arbaleast/dayu-tt-all-in-one/source/B站【大鱼DIY】3D打印机Dayu TT V1.21全套资料/通用辅助功能配件_非必须/12_Klicky调平/Klicky装配图.jpg

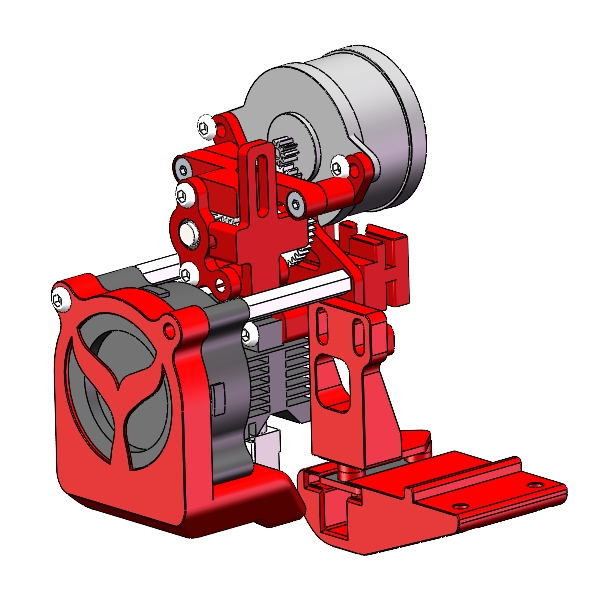
source/B站【大鱼DIY】3D打印机Dayu TT V1.21全套资料/通用辅助功能配件_非必须/12_Klicky调平/Klicky装配图.jpg
