arbaleast/dayu-tt-all-in-one/source/B站【大鱼DIY】3D打印机Dayu TT V1.21全套资料/TT310资料/TT310封箱资料/TT310封箱说明.jpg

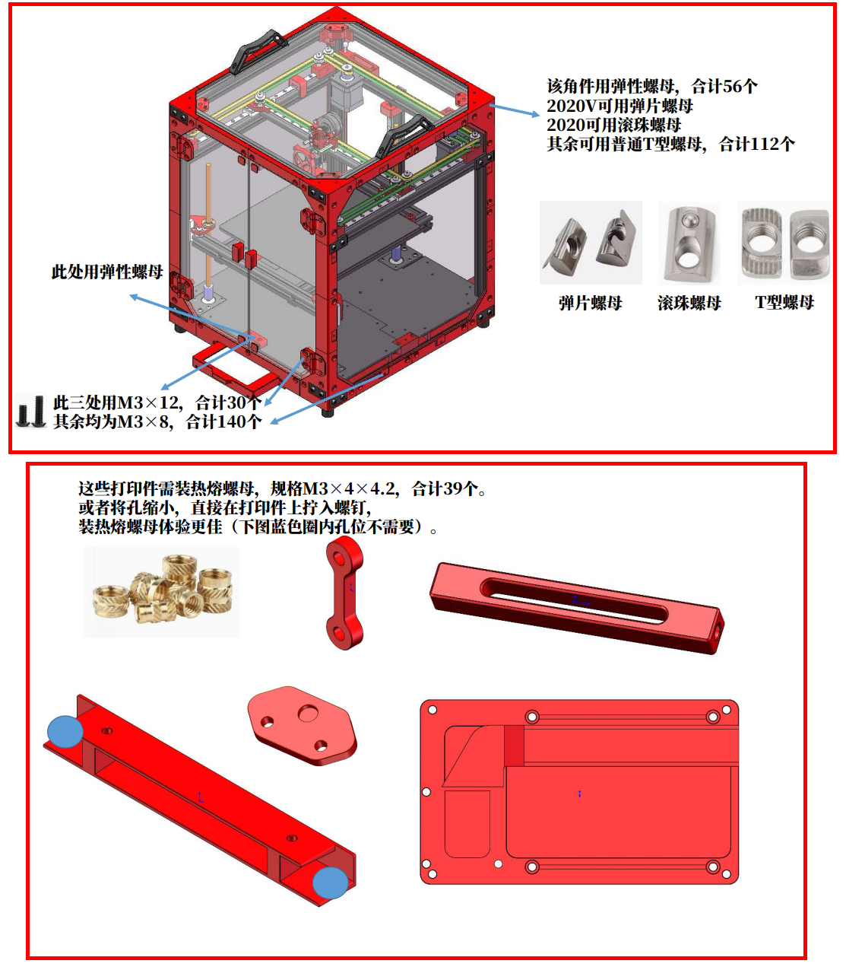
source/B站【大鱼DIY】3D打印机Dayu TT V1.21全套资料/TT310资料/TT310封箱资料/TT310封箱说明.jpg
