arbaleast/dayu-tt-all-in-one/SPEC.md

# 大鱼TT（dayu-TT）重构升级项目 — 项目总纲

> **文档版本**：v1.0
> **制定日期**：2026-04-03
> **项目路径**：/vol1/1000/projects/hardware/3d-printing/dayu-tt-all-in-one/
> **本文定位**：项目"宪法"，所有其他文档必须与本文对齐

---

## 目录结构

本项目采用知识领域分类结构：

```
docs/
├── MECHANICAL/      ← 机械工程（框架、CoreXY、封箱、硬件改进）
├── THERMAL/         ← 热管理系统（腔体温控、加热系统）
├── FIRMWARE/        ← 固件配置（Klipper、printer.cfg）
├── AI/              ← AI智能化（Input Shaper、ADXL345）
└── VALIDATION/       ← 测试验证（量化指标、验收标准）
```

### 协作文档

- [SUPERPOWERS.md](./SUPERPOWERS.md) — 项目宪章
- [AGENTS.md](./AGENTS.md) — Agent角色矩阵
- [CLAUDE.md](./CLAUDE.md) — AI协作协议

---

## 1. 项目愿景

> **一句话**：将大鱼TT打造成一台**对标 Voron 2.4 工业级标准**的大幅面ABS 3D打印机，具备高速打印能力、闭环热管理、智能故障检测的核心竞争力的个人制造设备。

---

## 2. 目标量化指标

### 2.1 量化指标总表（对标 Voron 2.4 r2）

| 指标维度 | 当前基线 | 目标值 | 验证方法 | 数据来源 |
|---|---|---|---|---|
| **打印成功率（ABS大幅面300mm+）** | <60%（估算） | >90% | 连续10次300mm ABS打印统计 | 审计报告§7.1；Voron spec§4.1 |
| **最高稳定速度（ABS）** | 约60-80mm/s（无Input Shaper） | >200mm/s | 验证件速度梯度测试（80→200mm/s） | Voron spec§4.2；审计报告§7.1 |
| **腔温稳定性** | ±10°C（被动保温） | **±3°C** | 30分钟温漂连续记录（Klipper温度曲线） | 审计报告§7.1（"腔温稳定性±10°C"）；Voron spec§3.1（Voron原生50-55°C） |
| **热床温控精度** | PID未校准 | ±1°C | Klipper PID调优后稳态波动 | Voron spec§1.4（Kp=58.437等参数） |
| **首层粘附** | 频繁翘角 | 零翘角 | 视觉检查+打印验证件 | Voron spec§3.2（PEI+ABS泥方案） |
| **层高一致性** | 未测量 | <0.05mm偏差 | 千分表测量10层样件 | Voron spec§3.3 |
| **X/Y定位精度** | 未校准 | <0.05mm | 打印精度验证件（20mm立方体）测量 | Voron spec§3.3 |
| **Z轴定位精度** | 无QGL | <0.02mm（重复性） | 千分表+重复Z轴回零测试 | Voron spec§2.2（QGL系统支撑） |
| **Input Shaper校准状态** | 未校准 | shaper_freq 30-50Hz | `calibrate_shaper.py`输出 | Voron spec§2.3；审计报告§2（ADXL345文档存在） |
| **皮带系统** | GT2 6mm（确认） | 升级9mm GT2 | 视觉确认+BOM记录 | 审计报告§6.4；Voron spec§1.2（Voron Trident标配9mm） |
| **热床功率** | 不足（推测） | 500-1000W AC+SSR | 升温曲线测试（室温→110°C<20min） | Voron spec§1.4；审计报告§5.1 |
| **加速度上限** | 未设置 | 3000mm/s²（X/Y） | Klipper `SET_KINEMATIC_ACCELERATION`验证 | Voron spec§2.1 |
| **Pressure Advance** | 未调校 | <1.0（典型0.05） | `TUNING_TOWER`测试件 | Voron spec§2.4 |
| **续驶保护** | 未配置 | idle_timeout=1800s | 模拟断料测试 | Voron spec§3.4 |

### 2.2 关键差距速记

- **🔴 热管理**：当前±10°C → 目标±3°C（差距最大）
- **🔴 固件配置**：缺少可直接使用的`printer.cfg`（审计报告§5.1 P0缺失）
- **🔴 STL文件**：各改装件STL无实际下载路径（审计报告§5.1 P0缺失）
- **🔴 接线图**：大鱼TT实际接线图/引脚定义缺失（审计报告§5.1 P0缺失）
- **🟡 皮带**：6mm → 9mm（升级路径明确）
- **🟡 框架**：铝型材规格待确认（审计报告§7.1）
- **🟡 Z轴**：无Quad Gantry Leveling系统

---

## 3. 当前主要矛盾（Top5，按优先级排序）

> 提取自：审计报告§8.2 + Voron spec§6（大鱼TT Top5关键项）

### 🔴 TOP 1：封闭腔体热管理系统缺失

**现状**：
- 仅有被动保温，腔温波动±10°C（审计报告§7.1）
- 热床功率不足（推测），升温慢、均温差
- 无主动腔温控制宏（`封闭腔体热管理规范化指南.md`为最新文档但未落地）

**影响**：
- ABS大幅面打印成功率<60%（估算）
- 层粘附不稳定，首层翘角频发

**解决路径**：P0阶段封闭方案落地 → 主动温控宏 → PID校准

---

### 🔴 TOP 2：固件基础设施缺失（P0级文档空白）

**现状**（审计报告§5.1）：
- ❌ 无可直接使用的`printer.cfg`完整配置
- ❌ 无大鱼TT实际接线图/引脚定义
- ❌ 引脚配置矛盾：`2-软件固件配置.md`（P2.2）vs `Klipper固件配置完全指南.md`（PF0）

**影响**：
- 新用户无法完成电气接线
- 固件配置无参照，Input Shaper无法启用

**解决路径**：P0阶段完成完整cfg + 接线图文档化

---

### 🔴 TOP 3：改装件STL文件无实际下载路径

**现状**（审计报告§5.1）：
- 皮带张紧器、打印头支架、Klicky探针等STL文件均为"待补充"
- 多个文档标注了STL存在但实际文件路径空白

**影响**：
- 改装无法落地
- 文档变为"空壳指导"

**解决路径**：P0阶段建立STL文件索引（自备或购买清单）

---

### 🟡 TOP 4：Input Shaper + ADXL345校准未完成

**现状**：
- `ADXL345-InputShaper实际校准执行指南.md` 文档存在但缺少树莓派接线图（3.3V警告不可见，硬件损坏风险）
- Input Shaper未运行，高速打印时共振无法抑制

**影响**：
- 加速度上限被迫降低至1000mm/s²以下
- 高速打印出现振铃（Ringing）和层移

**解决路径**：P0阶段完成ADXL345接线图 → P1阶段校准

---

### 🟡 TOP 5：CoreXY双电机同步 + 闭环改装未验证

**现状**：
- 大鱼TT使用开环步进电机（审计报告多处提及闭环改装方案）
- CoreXY架构理论上存在双电机同步问题（皮带伸长率差异）

**影响**：
- 高速打印时X/Y对角线跑偏
- 皮带6mm宽度低于Voron 2.4标准（9mm）

**解决路径**：P2阶段皮带升级9mm → 同步带张紧校准

---

## 4. 演进路线（5阶段）

### 📦 P0：稳定基线（0-2周）

> **目标**：让大鱼TT成为一台"能稳定跑ABS"的机器，消除致命障碍

**核心改进项**：

| 改什么 | 具体动作 | 参考文档 |
|---|---|---|
| **封闭腔体热管理** | 安装保温棉（10-20mm，松散填充）+ 边缘密封 + Klipper腔温宏 | `封闭腔体热管理规范化指南.md`（2026-04-03最新） |
| **热床功率升级** | 升级至500W+ AC热床+SSR控制（若当前不足） | `封箱散热BOSSAC热床改装指南.md`；Voron spec§1.4 |
| **ADXL345接线图** | 绘制树莓派SPI接线图（含3.3V警告），防止硬件损坏 | `ADXL345-InputShaper实际校准执行指南.md` |
| **STL文件清单** | 整理所有改装件STL实际获取路径（或标注购买渠道） | 审计报告§5.1 P0 |
| **完整Klipper cfg** | 以`Klipper固件配置完全指南.md`为准，建立可直接使用的printer.cfg | `Klipper固件配置完全指南.md`（审计报告标注以此为准） |
| **接线图文档化** | 绘制大鱼TT完整接线图（含引脚冲突说明） | 审计报告§5.1 P0 |

**成功标准（可量化）**：
- [ ] ABS 200mm×200mm打印连续3次零失败
- [ ] 腔温从室温升至50°C稳定后，30分钟内波动<±5°C（阶段目标）
- [ ] ADXL345接线图完成并验证（无硬件损坏）
- [ ] `printer.cfg`在Fluidd/Mainsail中加载无错误

**对应文档**：
- ✅ `docs/02-硬件改进/封闭腔体热管理规范化指南.md`（已有，需执行）
- ✅ `docs/03-AI与控制系统/ADXL345-InputShaper实际校准执行指南.md`（已有，需补充接线图）
- ✅ `docs/02-硬件改进/Klipper固件配置完全指南.md`（已有，需提取cfg）
- ❌ `docs/_NEW_接线图.md`（需新建）
- ❌ `docs/_NEW_完整printer.cfg示例.md`（需新建）
- ❌ `docs/_NEW_STL文件获取清单.md`（需新建）

---

### 📐 P1：精度提升（2-6周）

> **目标**：达到Voronn 2.4标准打印精度（<0.05mm偏差）

**核心改进项**：

| 改什么 | 具体动作 | 参考文档 |
|---|---|---|
| **Input Shaper校准** | ADXL345安装于工具头 → 运行`calibrate_shaper.py` → 得到shaper_freq_x/y | `ADXL345-InputShaper实际校准执行指南.md` |
| **Klicky探针调平** | 安装Klicky探针 → 配置探针偏移 → 运行QGL（或等效调平） | `docs/00-入门指南/4-安装指南索引.md` |
| **框架加固** | 检查铝型材角码连接 + 加装金属连接片（参考Voron方案） | `docs/plans/TT310机械薄弱点分析.md`（P0/P1 BOM） |
| **Z轴稳定性** | 若为Quad Z配置，验证皮带张紧度一致；配置QGL宏 | Voron spec§2.2 |
| **皮带张紧器** | 安装或升级皮带张紧器（GT2 6mm专用） | `docs/01-封箱方案/汪汪队射手方案.md` |

**成功标准（可量化）**：
- [ ] Input Shaper校准后，shaper_freq_x/y在30-50Hz区间
- [ ] 打印50mm立方体验证件，X/Y/Z三轴尺寸偏差<0.05mm
- [ ] 首层粘附测试10次，零翘角
- [ ] Klipper调平后Z高度重复性<0.02mm（千分表验证）

**对应文档**：
- ✅ `docs/03-AI与控制系统/ADXL345-InputShaper实际校准执行指南.md`
- ✅ `docs/00-入门指南/4-安装指南索引.md`
- ✅ `docs/plans/TT310机械薄弱点分析.md`
- ❌ `docs/_NEW_InputShaper校准执行报告.md`（校准后产出）

---

### ⚡ P2：速度突破（6-14周）

> **目标**：稳定200mm/s+ ABS打印，对标Voron 2.4高速标准

**核心改进项**：

| 改什么 | 具体动作 | 参考文档 |
|---|---|---|
| **皮带升级9mm** | GT2 6mm → 9mm（Voron Trident标配），降低皮带弹性 | 审计报告§6.4；Voron spec§1.2 |
| **CoreXY深化优化** | 验证CoreXY运动学配置；同步带张紧度匹配 | `docs/04-CoreXY深度改装/1.CoreXY运动学原理.md` |
| **加速度提升** | Input Shaper校准后，max_accel从1000→3000mm/s²（分阶段提升） | Voron spec§2.1 |
| **热端散热升级** | 4010风扇×2（热端+腔内循环），强化冷却 | `封闭腔体热管理规范化指南.md`（新增2×4010） |
| **闭环电机改装**（可选） | S42B闭环步进替换开环（X/Y双电机同步问题需验证） | `docs/01-封箱方案/42闭环电机/S42B-V2.0详细资料.md` |
| **CAN总线改装** | FLY SB2040 + CAN总线，减少USB延迟 | `docs/02-硬件改进/CAN总线改装指南.md` |

**成功标准（可量化）**：
- [ ] ABS打印速度提升至150mm/s无振铃
- [ ] 200mm/s验证件打印完成，尺寸偏差<0.1mm
- [ ] 皮带9mm安装确认，张紧度一致
- [ ] max_accel稳定在2000mm/s²（分阶段验证）

**对应文档**：
- ✅ `docs/04-CoreXY深度改装/1.CoreXY运动学原理.md`
- ✅ `docs/02-硬件改进/CoreXY改进大鱼TT实战指南.md`
- ✅ `docs/01-封箱方案/42闭环电机/S42B-V2.0详细资料.md`
- ✅ `docs/02-硬件改进/CAN总线改装指南.md`
- ❌ `docs/_NEW_速度验证报告.md`（测试后产出）

---

### 🧠 P3：智能化（14-26周）

> **目标**：AI故障检测 + 参数自优化，实现"无人值守"打印

**核心改进项**：

| 改什么 | 具体动作 | 参考文档 |
|---|---|---|
| **Obico远程监控** | 摄像头 + Obico接入 → 实时监控 + 故障推送 | `docs/02-硬件改进/AI校准进化实战指南.md`（Phase 0） |
| **AI缺陷检测** | Obico AI模式识别： spaghetti/粘附失败/堵嘴 | `docs/03-AI与控制系统/2-故障检测系统.md` |
| **参数自优化** | Phase 1-3自我进化：压力曲线自学习 | `docs/02-硬件改进/AI校准进化实战指南.md`（Phase 1-5） |
| **故障自恢复宏** | 编写Klipper宏：断料检测→暂停→通知→续打 | `docs/03-AI与控制系统/2-故障检测系统.md` |
| **Klippain一键校准** | 安装Klippain配置栈（可选） | `docs/05-固件与配置/Klippain配置栈实战.md` |

**成功标准（可量化）**：
- [ ] Obico远程监控延迟<5s（含手机推送）
- [ ] AI识别spaghetti准确率>80%（Obico统计）
- [ ] 连续72小时无人值守打印成功率>85%

**对应文档**：
- ✅ `docs/02-硬件改进/AI校准进化实战指南.md`
- ✅ `docs/03-AI与控制系统/2-故障检测系统.md`
- ✅ `docs/05-固件与配置/Klippain配置栈实战.md`
- ❌ `docs/_NEW_Obico配置步骤.md`（需新建）
- ❌ `docs/_NEW_72小时无人值守测试报告.md`（测试后产出）

---

### 🏆 P4：极致超越（26周+）

> **目标**：全面超越Voron 2.4 r2，在特定指标上领先

**核心改进项**：

| 改什么 | 具体动作 | 参考文档 |
|---|---|---|
| **高速稳定性** | 300mm/s ABS稳定打印（超越Voron 2.4典型速度） | Voron spec§4.2 |
| **腔温精准控制** | ±1°C精准腔温控制（主动加热+PID） | Voron spec§3.1 |
| **多色打印** | ERCF或AMS多色方案 | `docs/02-硬件改进/多色打印改装完全指南.md` |
| **Eddy探头** | 涡流非接触探针（精度更高，替代Klicky） | Voron spec§5.1 |
| **Trident改装** | 三电机Z轴（3点支撑，平整度更好） | `docs/02-硬件改进/三叉戟Trident改装指南.md` |
| **大幅面扩展** | 350mm+打印幅面验证 | 审计报告§7.2 |

**成功标准（可量化）**：
- [ ] 300mm/s ABS速度验证件完成
- [ ] 350mm ABS大幅面连续5次成功率>90%
- [ ] 腔温稳定性达到±1°C（超越目标±3°C）

---

## 5. 项目目录架构（重构后）

```
dayu-tt-all-in-one/
├── SPEC.md                              ← 本文档（项目宪法）
├── CHANGELOG.md                         ← 改进记录（按时间线）
├── BOM/
│   ├── 完整物料清单.csv                 ← 主采购清单（与SPEC对齐）
│   └── 采购优先级说明.md                 ← P0/P1/P2分级采购说明
├── docs/
│   ├── 00-工程基准/                     ← Voron规格/差距矩阵
│   │   ├── VORON_2.4_规格对照表.md      ← ✅ 已有（Voron spec§0）
│   │   └── 差距矩阵与量化指标.md        ← ✅ 已有（本文档§2摘要）
│   ├── 01-封箱改装/                     ← 封闭方案
│   │   ├── 装配指南.md                  ← ✅ 已有
│   │   ├── ABS打印指南.md               ← ✅ 已有
│   │   ├── 三大方案对比/                ← ✅ 官方/汪汪队/李炫键
│   │   └── 42闭环电机/                  ← ✅ S42B详细资料
│   ├── 02-框架与运动/                   ← 框架加固/CoreXY
│   │   ├── CoreXY运动学原理.md          ← ✅ 已有
│   │   ├── CoreXY改进实战指南.md        ← ✅ 已有
│   │   ├── 框架加固方案.md               ← ⬜ 需从薄弱点分析提取
│   │   └── 皮带升级指南（6mm→9mm）.md   ← ⬜ 需新建
│   ├── 03-固件配置/                     ← Klipper配置
│   │   ├── Klipper固件配置完全指南.md   ← ✅ 已有（权威参考）
│   │   ├── 完整printer.cfg示例.md        ← ⬜ P0需新建
│   │   ├── ADXL345接线图.md              ← ⬜ P0需新建（含3.3V警告）
│   │   └── 接线图完整版.md               ← ⬜ P0需新建
│   ├── 04-热管理系统/                    ← 封闭腔体+温控
│   │   ├── 封闭腔体热管理规范化指南.md   ← ✅ 2026-04-03最新
│   │   ├── 保温棉安装规范.md             ← ✅ 已有（热管理指南中）
│   │   └── 温控宏参考.md                 ← ✅ 已有（热管理指南中）
│   ├── 05-AI与智能化/                    ← Obico+自演化
│   │   ├── AI校准进化实战指南.md         ← ✅ 已有
│   │   ├── ADXL345校准完整流程.md        ← ✅ 已有（详细版）
│   │   ├── Obico配置步骤.md              ← ⬜ 需新建（P3）
│   │   └── 故障检测系统对比.md           ← ✅ 已有
│   ├── 06-测试验证/                      ← 验证件+数据记录
│   │   ├── 验证件STL清单.md               ← ⬜ 需新建
│   │   ├── 校准执行报告模板.md            ← ⬜ 需新建
│   │   └── 数据记录表/                    ← ⬜ 需新建（CSV格式）
│   └── plans/                            ← 规划/研究文档
│       ├── TT310机械薄弱点分析.md        ← ✅ 已有（工程价值高）
│       ├── 大鱼TT规格确认表.md            ← ✅ 已有
│       ├── 结构力学与热力学研究报告.md   ← ✅ 已有（学术参考）
│       ├── CoreXY深度研究报告.md          ← ✅ 已有
│       ├── 2026-03-29-ai-research-report.md ← ✅ 已有
│       └── _archive/                     ← ⚠️ 待清理（无实质内容文件删除）
├── firmware/
│   ├── printer.cfg示例/                 ← Klipper配置示例
│   │   └── full_config_printer.cfg      ← ⬜ P0需从配置指南提取
│   ├── Klippain/                        ← Klippain配置栈
│   └── 固件更新记录.md                   ← ⬜ 需新建
├── models/                              ← STL/3MF打印件
│   ├── 改装件STL清单.md                  ← ⬜ P0需新建（含获取路径）
│   └── _未验证/                          ← 适配性未验证的STL暂存
└── _archive/                            ← 已废弃/过时文档归档
    └── [旧版重复文档移至此]              ← 审计报告§3.4待清理文件
```

**图例**：
- ✅ = 已有且完整，可直接使用
- ⬜ = 项目需要但缺失，需新建
- ⚠️ = 已有但需清理或修缮

---

## 6. 当前P0紧急任务

> 基于Top5矛盾，以下3件为**立刻要做**的事（本周内）

---

### 🚨 P0-紧急任务 #1：封闭腔体热管理落地（最高优先级）

**来源**：Top1矛盾 + 审计报告§8.2 P0行动项

**执行步骤**：

1. **材料准备**：按`封闭腔体热管理规范化指南.md`采购保温棉（10-20mm）+ 密封条
2. **安装**：松散填充保温棉（不要压实），边缘加装密封条，重点密封四角
3. **风扇配置**：原有1个4010改热端散热 + **新增2×4010腔内循环风扇**（BOM标注🔴）
4. **Klipper宏**：烧入`HEATER_BED_GENERIC` + 腔温监控宏（指南中已有）
5. **PID校准**：运行`PID_CALIBRATE HEATER=heater_bed TARGET=110`
6. **验收**：腔温从室温升至50°C稳定后，30分钟记录温漂曲线，目标±5°C以内

**验证标准**：
- 热床温度110°C稳定时，腔温50°C±5°C（本周P0目标）
- 长期目标±3°C进入P1阶段验收

**参考文档**：
- `docs/02-硬件改进/封闭腔体热管理规范化指南.md`（2026-04-03，权威）
- `bom/完整物料清单.csv`（热管理新增项🔴优先级）

---

### 🚨 P0-紧急任务 #2：建立完整Klipper printer.cfg + 接线图文档

**来源**：Top2矛盾 + 审计报告§5.1（P0缺失）

**执行步骤**：

1. **统一引脚配置**：以`Klipper固件配置完全指南.md`（PF0/PF1等）为准，废弃`2-软件固件配置.md`中的P2.2引脚定义
2. **提取cfg**：从`Klipper固件配置完全指南.md`中提取完整参数段，生成`printer.cfg`示例文件
3. **统一rotation_distance**：统一使用`22.67895`（5位小数，审计报告§6.2已标注）
4. **绘制接线图**：包含以下关键内容：
   - 主控板（型号待确认）引脚定义
   - 树莓派GPIO → 主控板连接（包含ADXL345 SPI接线，3.3V警告标注）
   - 热床SSR接线
   - 热端/风扇定义
5. **文档化**：写入`docs/03-固件配置/接线图完整版.md` + `full_config_printer.cfg`

**验证标准**：
- `printer.cfg`在Fluidd中加载后无错误（`M502` + `SAVE_CONFIG`后验证）
- 所有引脚定义与实际硬件一一对应无冲突

**参考文档**：
- `docs/02-硬件改进/Klipper固件配置完全指南.md`（权威配置源）
- `docs/03-AI与控制系统/ADXL345-InputShaper实际校准执行指南.md`（ADXL345部分）

---

### 🚨 P0-紧急任务 #3：STL文件获取清单 + Klicky探针配置

**来源**：Top3 + Top4矛盾 + 审计报告§5.1

**执行步骤**：

1. **STL清单**：新建`models/改装件STL清单.md`，格式如下：

   ```markdown
   | 零件名称 | 用途 | 获取方式 | 链接/路径 | 适配型号 |
   |---------|------|---------|---------|---------|
   | Klicky探针支架 | 自动调平 | [链接] / 自行打印 | 待补充 | TT310 |
   | 皮带张紧器 | 皮带张紧 | [链接] / 汪汪队射手STL | 待补充 | 通用 |
   | 腔内循环风扇支架 | 热管理 | [链接] | 待补充 | TT310 |
   ```

2. **标注获取状态**：优先标注可通过**淘宝/AliExpress采购**的链接（已有BOM可参照）
3. **Klicky探针STL**：作为P0热管理的配套件，**立即获取**（影响调平系统落地）
4. **保存路径**：STL文件统一存入`models/`目录，文档内说明实际文件路径

**验证标准**：
- 清单中>80%的零件有明确获取路径（购买链接/打印文件路径）
- Klicky探针STL在P0阶段完成获取

**参考文档**：
- `bom/完整物料清单.csv`
- `docs/00-入门指南/4-安装指南索引.md`（Klicky安装步骤索引）

---

## 附录：审计报告关键矛盾速查

| 矛盾项 | 结论 | 执行动作 |
|---|---|---|
| 引脚配置（P2.2 vs PF0） | 以`Klipper固件配置完全指南.md`为准 | 废弃简化版中的P2.2 |
| rotation_distance（22.678 vs 22.67895） | 统一用22.67895 | cfg中统一 |
| BOM价格（官方方案¥1280 vs CSV实际） | 以CSV分项价格为准 | 更新官方方案成本估算 |
| 皮带规格（6mm确认/推测混乱） | TT235/TT310均确认6mm，改装时升级9mm | 统一标注确认信息 |
| 风扇数量（CSV vs 薄弱点分析 vs 热管理指南） | 以热管理规范化指南（2026-04-03）为准 | 更新其他文档引用 |

---

## 附录：审计报告§3待删除文件清单

> 清理完成后删除本节

| 文件 | 状态 |
|-----|---|
| `docs/02-硬件改进/切片机配置完全指南.md` | 与`05-固件与配置/切片机配置完全指南.md`重复 → **删除前者** |
| `docs/01-封箱方案/获取文件操作指南.md` | 空占位，无实质内容 → **删除** |
| `docs/02-硬件改进/摄像头加装指南.md` | 仅5行占位 → **删除** |
| `docs/02-硬件改进/罗技C270-大鱼TT摄像头完整配置.md` | 仅3行占位 → **删除** |
| `docs/02-硬件改进/皮带张紧器STL模型合集.md` | 仅2行占位 → **删除** |
| `docs/02-硬件改进/硬件改进资料汇总.md` | 仅2行占位 → **删除** |
| `docs/05-固件与配置/Klipper深度优化指南.md` | 仅3行占位 → **删除** |
| `docs/plans/_archive/`下4个文件 | 无实质内容 → **确认后删除** |

---

*本文档为大鱼TT项目总纲，如与子文档冲突，以本文档为准。*
*下次审查日期：P0阶段完成后（约2周后）*
