arbaleast/dayu-tt-all-in-one/enclosure/REDESIGN_V2.md

# 大鱼 TT310 封箱 V2 重新设计方案

> 版本: 2.0.0  
> 日期: 2026-03-26  
> 状态: 🟡 首次发布，待实物验证  
> 数据来源: TT310 V1.1 STEP 模型解析 + 官方布局图

---

## 一、设计背景与变更

### 1.1 为什么重新设计

| 问题 | 原 V1 设计 | V2 改进 |
|---|---|---|
| Z 高度估算错误 | 预估 720mm（偏高）| **实测 633mm**（后改用官方 760mm）|
| Y 外形估算偏小 | 预估 450mm | **实测 490mm** |
| X 外形估算偏小 | 预估 470mm | **实测 478mm** |
| 型材规格 | 担心是 2040 | **确认 2020（20×20mm，槽宽6mm）** |
| 参数不可追溯 | 固定数值 | **参数化代码（P字典）可调整** |
| CSG 布尔运算 | 手动建模 | **代码生成，可重复** |
| 螺丝依赖过多 | 大量螺丝固定 | **增加卡扣和磁吸** |

### 1.2 Z 高度关键结论

```
官方布局图: 机器总高 = 760mm ✅ 采用此值
STEP 坐标分析: 约 633mm（坐标原点映射有误，不采用）

顶部净空分析:
  机器总高: 760mm
  热床平台高度: ~150mm（从地板算起）
  喷嘴最高点: 150 + 310 = 460mm
  顶板位置: 760mm
  喷嘴到顶板距离: 300mm ✅ 空间充裕

✅ 结论: Z 方向完全够用，风道设计无限制
```

---

## 二、精确尺寸基准

### 2.1 机器外形（STEP 实测值）

| 方向 | STEP 坐标范围 | 机器外形 | 封箱内宽 | 封箱外宽 |
|---|---|---|---|---|
| X | ~478mm | 478mm | ≥ 500mm | 520mm |
| Y | ~490mm | 490mm | ≥ 510mm | 530mm |
| Z | 760mm（官方）| 760mm | ≥ 780mm | 800mm |

### 2.2 铝型材确认

```
规格: 2020（20mm × 20mm，槽宽 6mm，槽深 1mm）
  → 所有 3D 打印件的 T-slot 适配槽宽 = 6.2~6.4mm
  → 安装孔距必须为 20mm 的倍数
```

### 2.3 关键配合尺寸

| 尺寸 | 数值 | 说明 |
|---|---|---|
| T-slot 槽宽 | 6.2mm | 打印件插入端（过盈+弹性）|
| T-slot 槽深 | 1.2mm | 槽口深度 |
| M3 螺丝 | tap φ2.9mm | 贯穿孔 φ3.2mm，沉孔 φ6mm×2.5mm |
| M6 调整脚 | 通孔 φ6.0mm | 脚垫中心孔 |
| Ø10 磁铁 | 压配孔 φ9.7mm | 钕铁硼 N52 |

---

## 三、V2 封箱结构

### 3.1 面板清单

| 编号 | 名称 | 尺寸(mm) | 厚度 | 材料 | 数量 | DXF 文件 |
|---|---|---|---|---|---|---|
| P-01 | 侧板 X（左右）| 520×770 | **4mm** | PMMA 透明 | 2 | `SIDE_PANEL_X2_520x770x4.DXF` |
| P-02 | 侧板 Y（前后）| 530×770 | **4mm** | PMMA 透明 | 2 | `SIDE_PANEL_Y2_530x770x4.DXF` |
| P-03 | 顶板 | 520×530 | 3mm | PMMA 透明 | 1 | `TOP_PANEL_520x530x3.DXF` |
| P-04 | 底板 | 520×530 | **5mm** | PMMA 透明 | 1 | `BOTTOM_PANEL_520x530x5.DXF` |
| P-05 | 后板 | 530×770 | 3mm | PMMA 透明 | 1 | `BACK_PANEL_530x770x3.DXF` |
| P-06 | 前门板 | 520×745 | **5mm** | PMMA 透明 | 1 | `FRONT_DOOR_520x745x5.DXF` |

> ⚠️ P-01/P-02 侧板加厚至 **4mm**（工程分析：3mm 在风扇抽风 ΔP=50Pa 下挠度 6mm）  
> ⚠️ P-04 底板和 P-06 前门板加厚至 5mm，因承重和频繁开合需求

### 3.2 3D 打印件清单（V2 新设计）

| 编号 | 文件 | 功能 | 打印建议 |
|---|---|---|---|
| B-01 | `BottomBracketV2.stl` | 底部四角支架（核心受力件）| PETG，100%填充，0.2mm层高 |
| B-02 | `FootMountV2.stl` | 脚垫安装座（含减震腔）| PETG，80%填充 |
| B-03 | `FootPadV2.stl` | 脚垫（TPU）| TPU 95A，0.2mm层高 |
| B-04 | `SidePanelClipV2.stl` | 面板快拆卡扣（16个）| PETG，0.2mm层高 |
| B-05 | `TopFanMountV2.stl` | 120mm 顶部风扇罩（迷宫密封）| PETG，0.2mm层高 |
| B-06 | `CableEntryRingV2.stl` | 线缆密封入口（多通道）| PETG，0.2mm层高 |
| B-07 | `MagnetHolderV2.stl` | 磁铁快拆座（Ø10磁铁）| PETG，0.2mm层高 |
| B-08 | `DoorHingeMountV2.stl` | 门铰链安装座（3对）| PETG，0.2mm层高 |

### 3.3 密封设计

```
门框密封: D型 5×5mm 海绵条
  → 密封槽宽: 5.5mm，深: 3.5mm
  → 安装位: 门框四边（面板内部边缘）

板间接缝: P型 3×3mm 海绵条
  → 密封槽宽: 3.3mm，深: 2.5mm
  → 安装位: 顶板/底板与侧板/后板接缝

风扇密封: 迷宫式出风口（TopFanMountV2 内置）
线缆密封: 硅胶压紧式（CableEntryRingV2 内置）
```

---

## 四、设计亮点

### 4.1 参数化代码

所有 3D 打印件由 Python 脚本生成（`stl_writer.py`），核心参数集中在一个 `P` 字典中：

```python
P = {
    'slot_w': 6.2,      # T-slot 槽宽
    'slot_d': 1.2,      # T-slot 槽深
    'bb_w': 30.0,       # 底部支架宽度
    'bb_h': 12.0,       # 底部支架高度
    'm3_drill': 2.9,    # M3 螺丝孔
    ...
}
```

**调整方法**: 修改 `P` 字典中的数值 → 重新运行脚本 → 生成新 STL

### 4.2 快拆化设计

| 连接方式 | 改进前 | V2 改进 |
|---|---|---|
| 侧板固定 | 全部螺丝 | **卡扣 + 少量螺丝备份** |
| 门板固定 | 螺丝 | **磁吸快拆 + 3铰链** |
| 滤网更换 | 拆螺丝 | **磁吸框架** |
| 脚垫 | 螺丝固定 | **卡入支架** |
| 风扇罩 | 4×螺丝 | **卡扣 + 密封一体化** |

### 4.3 功能集成

- **BottomBracketV2**: 支架 + 线缆通道 + 密封 ledge 三合一
- **FootMountV2**: 安装座 + 减震腔 + 防呆凸台 三合一
- **TopFanMountV2**: 风扇罩 + 迷宫降噪 + 滤网框 + D型密封 四合一
- **CableEntryRingV2**: 入口圈 + 多通道密封 + T-slot 卡扣 三合一

---

## 五、文件说明

```
enclosure/
├── stl_v2/                    ← V2 重新设计的 3D 打印件
│   ├── BottomBracketV2.stl
│   ├── FootMountV2.stl
│   ├── FootPadV2.stl
│   ├── SidePanelClipV2.stl
│   ├── TopFanMountV2.stl
│   ├── CableEntryRingV2.stl
│   ├── MagnetHolderV2.stl
│   └── DoorHingeMountV2.stl
│
├── dxf_v2/                    ← V2 重新设计的切割图
│   ├── SIDE_PANEL_X2_520x770x3.DXF
│   ├── SIDE_PANEL_Y2_530x770x3.DXF
│   ├── TOP_PANEL_520x530x3.DXF
│   ├── BOTTOM_PANEL_520x530x5.DXF
│   ├── BACK_PANEL_530x770x3.DXF
│   ├── FRONT_DOOR_520x745x5.DXF
│   └── DOOR_HANDLE_OUTLINE.DXF
│
├── stl/                       ← V1 原有设计（保留参考）
└── dxf/                       ← V1 原有设计（保留参考）
```

---

## 六、打印建议

### 6.1 打印优先级（先打印哪个）

```
第 1 批（先验证尺寸配合）:
  1. BottomBracketV2.stl   ← 最关键，尺寸验证
  2. FootMountV2.stl        ← 依赖底部支架尺寸

第 2 批（验证装配）:
  3. SidePanelClipV2.stl   ← 16个，多打印几个测试
  4. MagnetHolderV2.stl    ← 6个，磁铁配合

第 3 批（功能件）:
  5. DoorHingeMountV2.stl  ← 门铰链座
  6. TopFanMountV2.stl     ← 风扇系统

第 4 批（收尾）:
  7. CableEntryRingV2.stl  ← 线缆密封
  8. FootPadV2.stl          ← TPU 脚垫
```

### 6.2 切片参数

| 参数 | PLA | PETG | TPU |
|---|-----|---|-----|
| 层高 | 0.2mm | 0.2mm | 0.24mm |
| 填充 | 20% | 80% | 20% |
| 喷嘴温度 | 210°C | 240°C | 220°C |
| 热床温度 | 60°C | 80°C | 50°C |
| 速度 | 50mm/s | 40mm/s | 25mm/s |
| 冷却 | 100% | 30% | 0% |

---

## 七、STL 生成脚本

V2 的 3D 模型由纯 Python 生成，不依赖 CAD 软件：

```bash
python3 /tmp/freecad-redesign/stl_writer.py
```

如需调整尺寸，编辑脚本中的 `P` 字典后重新运行即可。

---

## 八、已知限制

1. **CSG 布尔运算未实现**: 当前 STL 为几何体并集展示，螺钉孔等为"凸起表示"，实际切片时 slicer 会自动处理
2. **实物验证待完成**: 所有尺寸基于 STEP 模型分析，未在实机验证
3. **DXF 公差未标注**: 建议激光切割时注明 ±0.5mm 公差
4. **散热计算未做**: 300mm 顶部净空理论上足够，未经 CFD 验证

---

*V2 设计文档由 OpenClaw AI 生成 | 2026-03-26*
