arbaleast/dayu-tt-all-in-one/docs/MECHANICAL/05_参考资料.md

# 大鱼TT 参考资料

## GitHub 资源

### 官方/社区项目

| 项目名称 | 链接 | 说明 |
|---|---|---|
| bigfish-tt-extentions | https://github.com/rushairer/bigfish-tt-extentions | 大鱼TT扩展项目，含配置和宏 |
| Klicky Probe | https://github.com/jlas1/Klicky-Probe | Klicky探针官方仓库 |
| Klipper | https://github.com/Klipper3d/klipper | Klipper固件官方 |
| KIAUH | https://github.com/dw-0/kiauh | Klipper安装助手 |

### 前端界面

| 项目 | 链接 | 说明 |
|---|---|---|
| Fluidd | https://github.com/fluidd-core/fluidd | 轻量级Klipper界面 |
| Mainsail | https://github.com/mainsail-crew/mainsail | 功能丰富Klipper界面 |
| Moonraker | https://github.com/Arksine/moonraker | Klipper API服务 |

---

## 视频教程 (Bilibili)

| 标题 | UP主 | 链接 | 内容 |
|---|---|---|---|
| 大鱼TT改装系列 | 待补充 | - | 待补充 |
| Klipper安装教程 | 待补充 | - | 待补充 |
| Klicky探针制作 | 待补充 | - | 待补充 |

> 💡 **提示**: 在B站搜索 "大鱼TT" "Klipper" "Klicky" 可找到更多教程

---

## 在线文档

### Klipper 文档
- **官方文档**: https://www.klipper3d.org/
- **配置参考**: https://www.klipper3d.org/Config_Reference.html
- **命令参考**: https://www.klipper3d.org/G-Codes.html

### 社区文档
- **Klicky配置指南**: https://github.com/jlas1/Klicky-Probe/blob/main/Printers/Voron/v1.8v2.4/README.md
- **输入整形教程**: https://www.klipper3d.org/Resonance_Compensation.html

---

## 硬件购买链接

### 淘宝/天猫

| 配件类型 | 搜索关键词 | 参考店铺 |
|---|---|---|
| 主板 | BIGTREETECH Octopus | BTT官方店 |
| 挤出机 | Trianglelab 泰坦挤出机 | 三角实验室 |
| 热端 | E3D V6 喷头 | 三角实验室 |
| 风扇 | 黑爵散热风扇 | 3D打印配件店 |
| 电源 | 明纬 LRS-350-24 | 明纬官方店 |

### 1688 (批发)

| 配件 | 搜索关键词 |
|---|---|
| 步进电机 | 42步进电机 1.8度 |
| 同步带 | GT2同步带 6mm |
| 轴承 | 线性轴承 LM8UU |
| 螺丝 | 3D打印机螺丝套装 |

---

## 模型下载

### Thingiverse
- 搜索: "BigFish TT" "大鱼TT"
- 风道、支架、外壳等配件

### Printables
- https://www.printables.com/
- 搜索: "CoreXY" "Klicky" "Voron"

### 国内平台
- **嘉立创3D**: https://3d.jlcpcb.com/
- **米思米**: 工程零件

---

## 社区交流

### 论坛/群组

| 平台 | 名称 | 加入方式 |
|---|---|---|
| QQ群 | 大鱼TT交流群 | 待补充群号 |
| 微信群 | 3D打印交流群 | 待补充 |
| Discord | Klipper社区 | https://discord.gg/klipper |
| Reddit | r/klippers | https://reddit.com/r/klippers |

---

## 校准工具

### 在线工具

| 工具 | 网址 | 用途 |
|---|---|---|
| Pressure Advance | Klipper内置 | 压力提前校准 |
| Ellis' Tuning Guide | https://ellis3dp.com/ | 综合调优指南 |
| Retraction Tower | Thingiverse | 回抽距离测试 |

### 测试模型

| 模型 | 用途 | 下载 |
|---|---|---|
| XYZ校准立方体 | 尺寸精度 | Thingiverse |
| 温度塔 | 最佳打印温度 | Thingiverse |
| 回抽测试 | 回抽距离优化 | Thingiverse |
| 悬垂测试 | 冷却效果 | Thingiverse |
| 桥接测试 | 桥接能力 | Thingiverse |

---

## 常见问题 FAQ

### Q: 大鱼TT原厂固件是什么?
**A:** 原厂通常是Marlin固件，建议升级到Klipper获得更好性能。

### Q: Klipper必须要树莓派吗?
**A:** 不是，任何能运行Linux的设备都可以，包括旧笔记本、香橙派、甚至安卓手机。

### Q: Klicky探针比BL Touch好吗?
**A:** 各有优劣。Klicky成本低、可拆卸、精度高；BL Touch更方便、一体化。Klicky需要DIY，BL Touch即插即用。

### Q: 升级24V电源后12V风扇怎么办?
**A:** 可以: 1) 购买24V风扇替换；2) 使用降压模块将24V降到12V；3) 使用原12V电源单独给风扇供电。

### Q: 泰坦挤出机适合什么材料?
**A:** 泰坦适合PLA、PETG、ABS等常规材料。打印TPU等柔性材料时可能需要调整张力。

---

## 版本历史

| 日期 | 版本 | 更新内容 |
|---|---|---|
| 2026-03-21 | v1.0 | 初始版本，整理基础资料 |

---

## 贡献

欢迎补充更多资源！可以通过以下方式贡献:
1. 提供更多教程链接
2. 补充购买链接和价格
3. 分享改装经验
4. 修正错误信息

---

*最后更新: 2026-03-21*
