arbaleast/dayu-tt-all-in-one/docs/MECHANICAL/06_README.md

# 🐟 大鱼TT 3D打印机改进方案

本文件夹收集整理了大鱼TT 3D打印机的各种软硬件改进方案，帮助你提升打印机的性能和体验。

---

## 📁 文档结构

### 00-入门指南 / Getting Started
| 文件 | 内容 |
|---|---|
| **README.md** | 本文件，项目总览 |
| **大鱼TT从零DIY完全指南.md** | 完整装机教程 |
| **1-硬件升级方案.md** | 挤出机、调平系统、主板、热床、冷却、框架等 |
| **2-软件固件配置.md** | Klipper固件配置、Klicky探针、切片软件参数 |
| **3-配件清单与预算.md** | 配件列表、参考价格、采购渠道 |
| **4-安装指南索引.md** | 各改装项目的安装步骤和常见问题 |
| **5-参考资料.md** | GitHub链接、视频教程、社区资源 |

### 01-封箱方案 / Enclosure
| 文件 | 内容 |
|---|---|
| **官方方案.md** | 大鱼DIY官方封箱视频+资料 |
| **开源文件资源.md** | 社区开源封箱文件汇总 |
| **完整物料清单.csv** | BOM表格（可直接下载） |
| **方案对比可视化.md** | 各方案优缺点对比 |
| **皮带张紧器设计.md** | 皮带张紧STL模型 |
| **42闭环电机/** | 42闭环步进电机改装实战 |

### 02-硬件改进 / Hardware Upgrades
| 文件 | 内容 |
|---|---|
| **硬件改进资料汇总.md** | 所有改装方案索引 + 搜索来源 |
| **腔体温控与封箱散热指南.md** | 🆕 2026最新：封箱数据+温控+Nevermore |
| **OrcaSlicer高级功能指南.md** | 🆕 OrcaSlicer v2.3.1 AI检测+Obico |
| **Cartographer3D传感器改装指南.md** | 🆕 探针+隔振二合一 |
| **故障排查与维护手册.md** | 🆕 日常维护+常见问题+拖链痛点 |
| **CAN总线改装指南.md** | FLY SB2040 CAN总线改装 |
| **Klipper固件配置完全指南.md** | Klipper配置详解 |
| **封箱散热BOSSAC热床改装指南.md** | BOSSAC热床改装 |
| **多色打印改装完全指南.md** | AMS多色改装方案 |
| **罗技C270-大鱼TT摄像头完整配置.md** | 远程监控配置 |
| **摄像头加装指南.md** | 摄像头安装教程 |
| **42闭环电机改装实战采购指南.md** | 42闭环电机BOM |

### ⬆️ 封箱 FreeCAD 设计项目
> 位置：`enclosure/`（与 `docs/` 同级）
> ⚠️ 310mm 尺寸**未经官方验证**，先设计后验证
> 🔄 antfarm workflow 驱动中（底部支架 US-003 进行中）

| 文件 | 内容 |
|---|---|
| **enclosure/README.md** | 封箱设计项目总览 |
| **enclosure/plan.md** | 设计计划+尺寸规格 |
| **enclosure/dimensions.md** | 310mm 框架尺寸数据 |
| **enclosure/docs/bottom-bracket-design.md** | US-003 底部支架设计规格 |
| **enclosure/freecad/Assembly.FCStd** | FreeCAD 主装配 |

---

## 🚀 快速开始

### 🆕 正在开发：大鱼TT 310 封箱 FreeCAD 设计
> **位置**：[enclosure/README.md](../enclosure/README.md)（项目根目录）
> **状态**：⚠️ 310mm 尺寸**未经官方验证**，先设计后实物测试
> **进度**：antfarm workflow 驱动，底部支架设计（US-003）进行中
>
> 包含：510×490×760mm 外形设计、FreeCAD 参数化模型、激光切割图纸

---

### 推荐改装顺序

#### 第一阶段：低成本高收益 (预算 ¥300-500)
1. **[Klicky探针](./1-硬件升级方案.md#二自动调平系统)** - 自动调平，告别手动调床
2. **[Klipper固件](./2-软件固件配置.md)** - 输入整形、网床补偿，打印质量飞跃
3. **[PEI平台](./1-硬件升级方案.md#四热床改进)** - 附着力好，取模方便
4. **[风扇风道优化](./1-硬件升级方案.md#五冷却系统)** - 改善悬垂和桥接质量

#### 第二阶段：性能提升 (预算 ¥600-1000)
1. **[挤出机升级](./1-硬件升级方案.md#一挤出机升级)** - 泰坦/拓竹挤出机，减少滑丝
2. **[主板升级](./1-硬件升级方案.md#三主板升级方案)** - 八爪鱼/GEMINI，更多功能
3. **[电源升级](./1-硬件升级方案.md#八电源升级)** - 24V系统，大功率热床

#### 第三阶段：完善优化 (预算 ¥1000-2000)
1. **[全包外壳](./1-硬件升级方案.md#六框架与结构)** - 打印ABS/ASA必备
2. **[双Z轴改造](./1-硬件升级方案.md#六框架与结构)** - 减少层纹
3. **[更多细节优化](./1-硬件升级方案.md)**

---

## 💡 重要提示

### ⚠️ 安全注意事项
- 改装前务必断电
- 12V和24V设备不能混接
- 大功率加热设备注意散热
- 定期检查接线是否松动

### 📋 改装前准备
- [ ] 拍照记录原始接线
- [ ] 备份原厂固件（如有）
- [ ] 准备必要的工具（内六角、万用表等）
- [ ] 确保有充足的时间

---

## 📊 预算参考

| 升级阶段 | 预算范围 | 主要改进 |
|---|---|---|
| 基础升级 | ¥300-500 | Klicky、Klipper、PEI |
| 中级升级 | ¥600-1000 | 挤出机、主板、电源 |
| 高级升级 | ¥1200-2000 | 外壳、双Z轴、全套 |

详细的配件清单和价格请参考 [3-配件清单与预算.md](./3-配件清单与预算.md)

---

## 🔗 常用链接

- **GitHub 扩展项目**: https://github.com/rushairer/bigfish-tt-extentions
- **Klicky 探针**: https://github.com/jlas1/Klicky-Probe
- **Klipper 固件**: https://www.klipper3d.org/
- **KIAUH 安装助手**: https://github.com/dw-0/kiauh

更多资源请参考 [5-参考资料.md](./5-参考资料.md)

---

## 🤝 贡献

欢迎补充和修正：
- 添加更多改装方案
- 更新价格信息
- 补充教程链接
- 分享使用经验

---

## 📅 更新日志

| 日期 | 更新内容 |
|---|---|
| 2026-03-25 | 新增：腔体温控指南、OrcaSlicer v2.3.1 AI检测、Cartographer 3D传感器、故障排查手册、热端对比（Revo/Dragon HF/DiamondBack）、Z轴抗锯齿、Voron现代改装路线、B站改装参考视频表、X/Twitter 2026热点（Bambu P2S/H2S/DiamondBack、封箱成功率数据、拖链痛点、门把手温湿度计一体化）、LED灯带+Klipper LED Effects、Z轴光电限位改装、思兼Klipper教程链接、拓竹速度参数移植、AI 3D建模工具对比（Meshy 97%通过率、Hyper3D Rodin Gen-2 BANG分件、ZELIA 10张图缺陷检测） |
| 2026-03-21 | 初始版本，整理基础资料 |

---

祝你改装顺利，打印愉快！🎉
