arbaleast/dayu-tt-all-in-one/docs/MECHANICAL/42_硬件改进资料汇总.md

## 九、CoreXY 深度改装（新增）

### 核心参考：CoreXY改进大鱼TT实战指南.md

基于 Voron Design 官方文档的深度改进方案，涵盖：
- 皮带系统：HTD 3M / Gates 9mm 升级 + F695 轴承惰轮
- 框架刚性：2040 X 梁替换 + 对角斜撑
- Klipper Input Shaper 全流程调校
- AWD 四驱改装（LDO CNC AWD Kit）
- 改装 BOM 清单（分 P0/P1/P2 优先级）
