arbaleast/dayu-tt-all-in-one/docs/MECHANICAL/bottom-bracket-design.md

# 大鱼TT 310 底部支架设计规格 / Bottom Bracket Design Specifications

> 文档版本: 1.0.0
> 创建日期: 2026-03-25
> 状态: 设计规格 / DESIGN SPECIFICATION
> 故事ID: US-003-01

---

## 一、概述 / Overview

本文档详细定义了大鱼TT 310全封闭机箱底部支架系统的设计规格，包括底部支架、调整脚固定座和机箱脚垫的完整参数，用于指导FreeCAD模型的创建。

本设计位于机箱底部四角，用于支撑整个机箱重量并连接可调节脚。

---

## 二、底部支架 (Bottom Bracket)

### 2.1 功能描述

底部支架安装于2020框架底部四角，负责连接侧板、底板与框架，同时作为调整脚固定座的安装基座。

### 2.2 主体几何尺寸

| 参数 | 数值 | 单位 | 说明 |
|---|---|---|---|
| **宽度 (X)** | **40** | mm | 沿框架X方向 |
| **深度 (Y)** | **30** | mm | 沿框架Y方向 |
| **高度 (Z)** | **15** | mm | 沿框架Z方向 |
| **材料** | PETG | — | 耐温好、强度高 |
| **填充率** | 40% | — | 承重需求 |
| **层高** | 0.2 | mm | 标准打印层高 |

### 2.3 底板连接凹槽 (Recess Pocket)

| 参数 | 数值 | 单位 | 说明 |
|---|---|---|---|
| **凹槽深度** | **3** | mm | 容纳底板(5mm)边缘嵌入 |
| **凹槽宽度** | **6** | mm | 与D型密封条槽配合 |
| **凹槽位置** | 顶面内侧 | — | 底板嵌入配合 |

> 凹槽设计使底板与支架顶面平齐，防止底板偏移

### 2.4 角落圆角 (Corner Fillets)

| 参数 | 数值 | 单位 | 说明 |
|---|---|---|---|
| **外角圆角半径** | **R3** | mm | 所有外凸边缘 |
| **内角圆角半径** | **R2** | mm | 所有内凹角落 |

### 2.5 M3沉头螺丝孔 (Panel Attachment)

| 参数 | 数值 | 单位 | 说明 |
|---|---|---|---|
| **螺丝规格** | M3×10 | mm | 沉头螺丝 |
| **沉孔直径** | Ø6.5 | mm | M3沉头直径 |
| **沉孔深度** | 3 | mm | M3沉头高度 |
| **螺丝孔直径** | Ø3.2 | mm | M3螺纹底孔 |
| **沉头角度** | 90° | deg | 标准沉头角 |

**孔位分布 (四角落):**

```
  Y
  ↑ 4×M3沉头孔 (Ø6.5×90°)
  │
  │  ○──────────────────○  ← 角孔，距边5mm
  │
  │       [支架主体]
  │        40×30×15
  │
  │  ○──────────────────○  ← 角孔，距边5mm
  └────────────────────────→ X
    └─5─┘           └─5─┘
```

| 孔编号 | X位置 | Y位置 | 说明 |
|---|---|---|---|
| #1 | 5mm | 5mm | 左下角 |
| #2 | 35mm | 5mm | 右下角 |
| #3 | 5mm | 25mm | 左上角 |
| #4 | 35mm | 25mm | 右上角 |

> 孔位距边缘5mm，保证足够强度

### 2.6 侧板连接耳 (Side Panel Tabs)

| 参数 | 数值 | 单位 | 说明 |
|---|---|---|---|
| 连接耳宽度 | 8 | mm | X方向两侧 |
| 连接耳厚度 | 3 | mm | Y方向突出 |
| 连接耳高度 | 与支架同高 | mm | 15mm |

---

## 三、调整脚固定座 (Adjustable Foot Mount)

### 3.1 功能描述

调整脚固定座安装于底部支架下方中央，作为M6调整脚的连接基座，实现机箱高度微调。

### 3.2 主体几何尺寸

| 参数 | 数值 | 单位 | 说明 |
|---|---|---|---|
| **外径 (OD)** | **Ø20** | mm | 主体圆柱直径 |
| **高度** | **15** | mm | 沿Z方向 |
| **中心孔径** | **Ø12** | mm | M6 through-hole |
| **材料** | PETG | — | 与底部支架相同 |
| **填充率** | 40% | — | 承重需求 |

### 3.3 M6通孔 (M6 Through-Hole)

| 参数 | 数值 | 单位 | 说明 |
|---|---|---|---|
| **孔径** | **Ø12** | mm | M6螺栓通过 |
| **孔深** | **15** | mm | 全高度通孔 |
| **螺纹规格** | M6×12 | mm | 调整脚螺栓规格 |

> Ø12mm孔径配合M6螺栓，提供足够间隙

### 3.4 法兰接触环 (Flange Contact Ring)

| 参数 | 数值 | 单位 | 说明 |
|---|---|---|---|
| **法兰外径** | **Ø26** | mm | 与脚垫接触面 |
| **法兰厚度** | **2** | mm | 接触环高度 |
| **法兰宽度** | **3** | mm | 径向宽度 |
| **与支架配合间隙** | 0.2 | mm | 装配间隙 |

### 3.5 沉头固定螺丝孔 (Countersunk Screw Holes)

| 参数 | 数值 | 单位 | 说明 |
|---|---|---|---|
| **螺丝规格** | M3×8 | mm | 沉头螺丝 |
| **沉孔直径** | Ø6.5 | mm | M3沉头直径 |
| **沉孔深度** | 3 | mm | M3沉头高度 |
| **螺丝孔直径** | Ø3.2 | mm | M3螺纹底孔 |
| **沉头角度** | 90° | deg | 标准沉头角 |

**孔位分布 (3孔均布):**

```
        俯视图 (Foot Mount)

            ○  ← M3沉头孔#2 (顶部)
            │
    ○───────┼───────○  ← M3沉头孔#1/#3 (两侧)
    │       │       │
    │    [支架凹槽] │
    │       │       │
    └───────┼───────┘
            │
            ↓
        中心孔Ø12
        (M6通过孔)
```

| 孔编号 | 角度位置 | 距中心距离 |
|---|---|---|
| #1 | 180° (下方) | 10mm |
| #2 | 0° (上方) | 10mm |
| #3 | 90° (右侧) | 10mm |

---

## 四、机箱脚垫 (Foot Pad)

### 4.1 功能描述

机箱脚垫安装于调整脚固定座下方，直接接触地面，提供减震降噪功能。

### 4.2 主体几何尺寸

| 参数 | 数值 | 单位 | 说明 |
|---|---|---|---|
| **外径** | **Ø25** | mm | 底部接触面积 |
| **高度** | **5** | mm | 减震行程 |
| **中心孔径** | **Ø12** | mm | 配合调整脚螺栓 |
| **材料** | **TPU** | — | 柔软减震 |
| **填充率** | 20% | — | TPU标准填充 |

### 4.3 几何形状

| 参数 | 数值 | 说明 |
|---|---|---|
| **主体形状** | 简单圆盘 | 底部平面 |
| **顶面形状** | 平面 | 与法兰接触 |
| **底面形状** | 平面 | 接触地面 |
| **边缘处理** | 无倒角 | 标准打印 |

### 4.4 打印要求

| 参数 | 数值 | 说明 |
|---|---|---|
| **层高** | 0.24 | mm | TPU推荐层高 |
| **打印速度** | 25mm/s | mm/s | TPU低速打印 |
| **热床温度** | 50°C | °C | TPU标准 |
| **喷嘴温度** | 220°C | °C | TPU标准 |
| **材料** | TPU 95A | — | 肖氏硬度 |

---

## 五、底板孔位规格 (Bottom Panel Hole Positions)

### 5.1 底板概述

| 参数 | 数值 | 单位 | 说明 |
|---|---|---|---|
| **底板尺寸** | 510×490 | mm | X×Y方向 |
| **底板厚度** | 5 | mm | 亚克力板 |
| **底板材料** | 透明亚克力 | — | 承重设计 |

### 5.2 调整脚安装孔 (Ø10mm × 4)

| 参数 | 数值 | 单位 | 说明 |
|---|---|---|---|
| **孔径** | **Ø10** | mm | 配合M6调整脚 |
| **孔数量** | **4** | 个 | 四角位置 |
| **沉孔直径** | Ø16 | mm | 沉孔装饰 |
| **沉孔深度** | 2 | mm | 美观装饰 |

**孔位分布:**

```
         Y (490mm)
    0────────────────────────────→ X (510mm)
    │
    │  ○(调整脚孔1)              ○(调整脚孔2)
    │   @X=50, Y=50               @X=460, Y=50
    │       [底板 510×490mm]          │
    │                                  │
    │                                  │
    │  ○(调整脚孔3)              ○(调整脚孔4)
    │   @X=50, Y=440              @X=460, Y=440
    ▼
```

| 孔编号 | X坐标 | Y坐标 | 对应支架位置 |
|---|---|---|---|
| #1 | 50mm | 50mm | 左前角 |
| #2 | 460mm | 50mm | 右前角 |
| #3 | 50mm | 440mm | 左后角 |
| #4 | 460mm | 440mm | 右后角 |

> 孔位距边缘50mm，与2020框架立柱位置配合

### 5.3 线缆穿孔 (可选)

| 参数 | 数值 | 单位 | 说明 |
|---|---|---|---|
| **孔径** | Ø30–40 | mm | 电源线、数据线 |
| **位置** | 底板后部 | — | 靠近电源出口 |
| **数量** | 1–2 | 个 | 可选 |

---

## 六、装配关联网格 (Assembly Relationship)

### 6.1 组件装配顺序

```
框架立柱 (2020 profile)
    │
    ├── [底部支架 Bottom Bracket 40×30×15]
    │       ├── 侧板连接耳 → 侧板固定夹
    │       ├── 底板凹槽 → 底板边缘嵌入
    │       └── 4×M3沉头螺丝 → 侧板/底板
    │
    ├── [调整脚固定座 Foot Mount Ø20×15]
    │       ├── 中心Ø12孔 → M6调整脚螺栓
    │       ├── 法兰环 → 机箱脚垫接触
    │       └── 3×M3沉头螺丝 → 底部支架
    │
    └── [机箱脚垫 Foot Pad Ø25×5]
            └── 中心Ø12孔 → M6调整脚通过
```

### 6.2 配合间隙规格

| 配合对 | 间隙 | 说明 |
|---|---|---|
| 底板×支架凹槽 | 0.2mm | 装配间隙 |
| 调整脚×通孔 | 0.5mm | 螺栓间隙 |
| 脚垫×法兰 | 0.1mm | 接触面间隙 |
| M3螺丝×沉孔 | 0.1mm | 沉头间隙 |

---

## 七、FreeCAD建模指南 / FreeCAD Modeling Guide

### 7.1 底部支架建模步骤

1. 创建Sketch: 40×30mm矩形，R3圆角外轮廓
2. Pad: 15mm高度
3. 创建顶面凹槽Sketch: 减材Pad 3mm深
4. 创建M3沉头孔: 4个角落，Sketch驱动的Pocket
5. 创建侧板连接耳: Sketch驱动的Pad

### 7.2 调整脚固定座建模步骤

1. 创建Sketch: Ø20mm圆，中心Ø12mm圆（减材）
2. Pad: 15mm高度
3. 创建法兰Sketch: Ø26mm圆环
4. Pad法兰: 2mm高度
5. 创建M3沉头孔: 3孔均布，Sketch驱动的Pocket

### 7.3 脚垫建模步骤

1. 创建Sketch: Ø25mm圆，中心Ø12mm圆（减材）
2. Pad: 5mm高度

---

## 八、版本历史 / Changelog

| 版本 | 日期 | 修改内容 |
|---|---|---|
| 1.0.1 | 2026-03-25 | 更正：框架型材为2020非2040（影响孔位间距设计） |
| 1.0.0 | 2026-03-25 | 初始版本，定义底部支架系统完整参数 |

---

*文档创建: US-003-01 自动生成*
*最后更新: 2026-03-25*
