arbaleast/dayu-tt-all-in-one/docs/MECHANICAL/OrcaSlicer高级功能指南.md

# OrcaSlicer 高级功能指南

> 更新时间：2026-03-25
> 适用版本：OrcaSlicer v2.3.1 及以上
> 来源：orcaslicer.com + GitHub releases

---

## 一、最新功能概览（v2.3.1）

| 功能 | 类型 | 说明 |
|---|---|---|
| AI 故障检测 | 🆕 新增 | 实时监测打印异常并暂停 |
| Obico 远程控制 | 🆕 新增 | 手机远程监控 + 控制打印机 |
| 稀疏填充旋转 | 🆕 新增 | 模板化填充增强结构强度 |
| Fuzzy Skin (2种模式) | 🆕 新增 | 外观纹理后处理 |
| 抗锯齿 | 优化 | 减少振纹 |
| 色彩控制 | 优化 | 多色打印配置简化 |

---

## 二、AI 故障检测（重要！）

### 功能说明
OrcaSlicer 内置 AI 视觉检测，可实时识别：
- 打印件脱落/翘边
- 拉丝/漏料
- 喷嘴堵塞前兆
- 打印平台失去粘附

检测到异常时自动暂停打印并报警，防止浪费一整夜的长打印。

### 开启方法

1. **安装 AI 检测插件**（需要摄像头）
   ```
   设置 → 摄像机 → 添加摄像机
   选择：OrcaSlicer AI Detection / Moonraker
   ```

2. **配置检测灵敏度**
   ```
   设置 → 打印设置 → 高级 → AI Failure Detection
   - 检测灵敏度：中（默认）/ 高 / 低
   - 响应动作：暂停+报警 / 仅报警 / 关闭
   ```

3. **测试检测功能**
   ```
   打印设置 → 测试AI检测 → 模拟异常
   ```

### 摄像头推荐
- **罗技 C270**（大鱼TT改装首选，便宜够用）
- 分辨率：720p 足够，1080p 更佳
- 安装位置：正对打印平台，角度 45-60°

---

## 三、Obico 远程监控

### 功能说明
Obico（原 The Spaghetti Detective）是开源的远程监控平台，集成到 OrcaSlicer 中。

### 支持功能
- 🌐 远程查看打印进度（手机/电脑）
- 📱 推送打印异常通知
- 🔄 远程暂停/恢复/取消打印
- 📊 打印时间统计
- 🤖 AI 检测（可选，需订阅或自建服务器）

### 配置步骤

1. **注册 Obico 账号**（免费额度够用）
   - 官网：obico.io
   - 支持自建服务器（开源）

2. **在 OrcaSlicer 中配置**
   ```
   设置 → 摄像机 → 添加摄像机
   类型：Obico
   输入服务器地址和认证码
   ```

3. **使用 Twisted-Flake 插件**（替代 Moonraker）
   ```
   # Klipper 的 moonraker.conf 添加：
   [octoprint_compat]  # 或参考 Obico 官方配置
   ```

### 替代方案：OctoPrint + Telegram
不想用 Obico 的话，可以用传统方案：
- OctoPrint（树莓派运行）
- 配合 Telegram Bot 推送通知

---

## 四、稀疏填充旋转（Infill Rotation）

### 功能说明
v2.3.1 引入模板化稀疏填充旋转，每层按固定角度差旋转，提升层间结构均匀性，减少"棋盘格"弱点。

### 使用方法
```
打印设置 → 填充 → 填充图案
选择：Grid / Gyroid / Lightning（推荐Lightning）
填充旋转：✓ 启用
```

### 推荐配置
| 材料 | 填充率 | 旋转角度步进 | 说明 |
|---|---|---|---|
| PLA | 15-20% | 默认 | 够用 |
| PETG | 15-20% | 默认 | 减少收缩 |
| ABS | 20-30% | +15° 步进 | 强度更重要 |

---

## 五、Fuzzy Skin 新模式

v2.3.1 新增两种 Fuzzy Skin 模式，用于外观纹理：

### 模式对比
| 模式 | 说明 | 适用场景 |
|---|---|---|
| Fuzzy Skin (extrusion) | 沿轮廓线轻微抖动 | 表面去层纹 |
| Fuzzy Skin (perimeter) | 仅外壳模糊 | 隐藏接缝 |

### 设置方法
```
打印设置 → 高级 → Fuzzy Skin
- Fuzzy Skin Thickness：0.2-0.4mm（越大越模糊）
- Fuzzy Skin Point Distance：0.4-0.8mm
```

### 注意事项
- 打印时间增加 5-10%
- 不适合小尺寸精密件
- 建议先用 0.2mm 厚度测试

---

## 六、OrcaSlicer vs Bambu Studio 对比

| 特性 | OrcaSlicer | Bambu Studio |
|---|---|---|
| AI 检测 | ✅ 内置 | ✅ 内置 |
| 多色管理 | ✅ 优秀 | ✅ 优秀 |
| 自定义程度 | ✅ 高 | ❌ 低 |
| 生态系统 | 独立 | 绑定 Bambu 机器 |
| Klipper 兼容性 | ✅ 完美 | ⚠️ 需适配 |

> **推荐**：非 Bambu 机器（尤其是大鱼TT）用 OrcaSlicer，自定义空间大，Klipper 集成好。

---

## 七、Klipper + OrcaSlicer 最佳配置

### 切片机设置（OrcaSlicer）
```yaml
# 通用配置
层高：0.2mm（默认）/ 0.12mm（精细）
线宽：0.4mm（喷嘴直径）
填充：Lightning 15% + 旋转
外壳：4层 速度：60mm/s（外轮廓）

# Klipper 输入整形
[input_shaper]
# 建议用 OrcaSlicer 的测试功能自动校准
shaper_type: ei
shaper_freq_x: 40
shaper_freq_y: 40
```

### 推荐插件
- **Moonraker**（Klipper API）— OrcaSlicer 直接控制 Klipper
- **Crowsnest**（摄像头）— 简化摄像头配置
- **Obico**（可选）— AI 检测

---

## 八、更新日志

| 版本 | 日期 | 主要更新 |
|---|---|---|
| v2.3.1 | 2026-02 | 稀疏填充旋转、Fuzzy Skin 2种、AI检测强化 |
| v2.2.0 | 2025-10 | 抗锯齿优化、色彩管理改进 |
| v2.1.0 | 2025-06 | Lightning 填充、Gyroid 改进 |
| v2.0.0 | 2025-01 | 完全重构，多色管理重写 |

---

## 九、下载链接

- **官网**：https://www.orcaslicer.com/
- **GitHub Releases**：https://github.com/OrcaSlicer/OrcaSlicer/releases
- **Obico AI 检测**：https://www.obico.io/
- **中文社区**：B站搜索 OrcaSlicer 教程

---

## 十、OrcaSlicer AI vs Bambu Lab P2S AI（X/Twitter 2026讨论）

### ZELIA — 仅需10张图的AI缺陷检测训练
- **来源：** Zetamotion，2026年AI质检助手
- **核心优势**：只需10张缺陷图片，即可训练出可用的检测模型
- **原理**：生成合成缺陷数据集（含mask）→ 人工验证 → 训练
- **参考价值**：大鱼TT + OrcaSlicer 可借鉴此思路，用少量真实缺陷样本训练检测模型

> 来源：X/Twitter 社区，Bambu Lab P2S 发布讨论（2026年3月）

| 功能 | OrcaSlicer + Obico | Bambu Lab P2S（闭源） |
|---|---|---|
| AI 故障检测 | ✅（自建或Obico云） | ✅ 内置 |
| 远程查看 | ✅（Obico / OctoPrint） | ✅ 1080p 内置 |
| 多色管理 | ✅ 优秀 | ✅ AMS 多色 |
| 封闭系统 | ❌ 需第三方 | ✅ 一体化 |
| 自定义程度 | ✅ 高（开源） | ❌ 低 |
| 摄像头要求 | 罗技 C270（自备） | 内置 1080p |

### 关键结论

**Bambu Lab P2S AI 监控系统强在哪？**
- 1080p 内置摄像头，厂商调优，开箱即用
- 自适应气流配合 AI 检测，腔温/风速联动

**OrcaSlicer + 大鱼TT 的优势？**
- 完全开源，可深度定制
- Klipper 直接控制，无厂商绑定
- 罗技 C270 + Obico 方案成本低（~¥100）
- 长期可维护性更强

> **推荐路线**：大鱼TT 用 OrcaSlicer + 罗技 C270 + Obico，性价比和可玩性都更好。
