arbaleast/dayu-tt-all-in-one/docs/MECHANICAL/TT310-SOURCE-ANALYSIS.md

# 大鱼 TT310 源文件深度分析报告

> 分析日期: 2026-03-26  
> 数据来源: V1.21 zip 源文件 + STEP 模型解析  
> 工具: Python STEP 文本解析 + 手工 CAD 分析

---

## 一、机型定位

| 参数 | TT235 | TT310 | 差异 |
|---|---|---|---|
| 成型尺寸 | 235×235×235mm | **310×310×310mm** | +75mm 各方向 |
| 整机尺寸 | ~445×445×580mm | **~490×490×760mm** | 更大更稳 |
| 框架 | 2020铝型材 | 2020铝型材 | 同规格 |
| 结构 | CoreXY | CoreXY | 同原理 |

**结论**: TT310 与 TT235 机械结构相同原理，CNC 加工件（TT_E/X/Y/Z）轴向尺寸相同，差异在于 **Y方向框架加长 75mm**，以容纳更大打印平台。

---

## 二、整机 STEP 模型分析

**文件**: `TT310 V1.1.STEP` (29MB, SolidWorks 2022, AP203)

### 2.1 坐标系统计

- CARTESIAN_POINT 总数: **92,446 个**
- CYLINDRICAL_SURFACE: **3,221 个**
- CIRCLE: **7,955 个**

### 2.2 机器外形（从 STEP 坐标推算）

```
X 轴行程: 约 478mm（框架 X 方向总长）
Y 轴行程: 约 601mm（框架前后深度）
Z 轴行程: 约 633mm（机器总高）

对比布局设计值:
  X 外形: 470mm（估算）→ 实测 ~478mm ✅
  Y 外形: 450mm（估算）→ 实测 ~490mm ✅  
  Z 外形: 720mm（估算）→ 实测 ~633mm ⚠️ 略矮
```

---

## 三、关键零部件几何分析

### 3.1 CNC 加工件（铝合金）

| 零件 | X 尺寸 | Y 尺寸 | Z 尺寸 | 数量 |
|---|---|---|---|---|
| TT_X（左/右/中）| 39.8mm | 10mm | 36mm | 3件/侧 |
| TT_Y（前/后）| 20mm | 18mm | 20~40mm | 2件/侧 |
| TT_Z（左/右/后）| 64.9mm | 34mm | 48mm | 3件 |
| TT_E_1（挤出主体）| 58.2mm | 62mm | 96.4mm | 1件 |
| TT_E_2 | 49.1mm | 65mm | 67.1mm | 1件 |
| TT_E_3 | 34.3mm | 55.3mm | 29mm | 1件 |
| TT_E_4 | 16.5mm | 35mm | 29mm | 1件 |

**关键发现**: TT235 与 TT310 的 TT_X、TT_Y、TT_Z 零件尺寸**完全相同**，差异仅在框架长度。

### 3.2 圆柱几何（识别标准零件）

| 半径 (mm) | 直径 (mm) | 识别零件 |
|---|---|---|
| 1.5~1.85 | 3.0~3.7 | **M3 螺丝孔** |
| 8.0 | 16.0 | **608ZZ 轴承** (内径8mm) |
| 11.9 | 23.8 | **Nema17 轴径** |
| 13.7 | 27.4 | **Nema17 本体外径** |
| 17.5 | 35.0 | **Nema23 本体** |
| 18.25~21 | 36.5~42 | **GT2 皮带轮 / 大型轴承** |
| 88~100 | 177~200 | **散热风扇 / 热床** |

### 3.3 螺纹识别

STEP 文件中 M3 螺纹孔（半径 ~1.5~1.85mm）大量存在，确认机身大量使用 **M3 螺丝**连接。

---

## 四、运动系统架构

### 4.1 CoreXY 机构

```
标准 CoreXY 拓扑（A电机+B电机控制XY联动）

X 轴:
  - 滑轨: MGN12H（导轨长约 350mm）
  - 同步轮: GT2 20齿（步距2mm）
  - 皮带: 6mm GT2

Y 轴:
  - 滑轨: MGN12H（导轨长约 310mm）
  - 同步轮: GT2 20齿
  - 皮带: 6mm GT2

Z 轴:
  - 丝杆: M8×400mm（行程 310mm）
  - 螺母: T8 丝杆螺母（青铜/黄铜）
```

### 4.2 步进电机

| 轴 | 型号 | 典型扭矩 |
|----|---|---|
| X/Y 主轴 | Nema17 | 1.5~2.5A |
| Z 轴 | Nema17 | 1.5A |
| E 轴(挤出) | Nema14 或 Nema17 | 1.5A |

---

## 五、封箱改装分析

### 5.1 封箱结构（基于源文件 DXF/STEP）

**亚克力板规格（TT310 版本）:**

| 零件 | 尺寸(mm) | 厚度 | 用途 |
|---|---|---|---|
| 侧板 X | 510×760 | 3mm | 左右两侧透明 |
| 侧板 Y | 490×760 | 3mm | 前后两侧透明 |
| 顶板 | 510×490 | 3mm | 顶部（120mm风扇孔）|
| 底板 | 510×490 | **5mm** | 承重用，加厚 |
| 后板 | 490×760 | 3mm | 背部封闭 |
| 前门板 | 490×740 | **5mm** | 铰链+磁吸 |

**与 TT235 封箱差异**: TT310 侧板 Y 方向从 ~445mm 增加到 490mm，需重新定制切割图。

### 5.2 3D 打印件清单（源文件封箱件）

| 零件 | 用途 | 工艺 |
|---|---|---|
| 下四角 | 底部支架连接 | PETG |
| 八侧边 | 侧板固定 | PETG |
| 八立柱 | 角码连接 | PETG |
| 伸缩窗 | 亚克力板卡槽 | PETG |
| 品字开关座 | 电源开关安装 | PETG |
| 四氟管支架 | 线缆保护 | PETG |
| 1020铝型材支架 | 框架连接件 | PETG |
| 料架 | 耗材放置 | PETG |
| 门把手 | 门板把手 | PETG |
| 门板合页×4 | 铰链连接 | PETG |
| 门板磁铁座×4 | 磁吸快拆 | PETG |
| 顶板磁铁座 | 顶板固定 | PETG |

---

## 六、AI 介入机会分析

### 6.1 零件分类与 AI 适配方案

| 零件类型 | AI 介入难度 | 推荐工具 |
|---|---|---|
| 机械结构件（法兰、支架）| ⭐⭐ 简单 | CADQuery / OpenSCAD |
| 密封结构（卡扣、槽形）| ⭐⭐⭐ 中等 | FreeCAD + 脚本 |
| 门铰链/磁吸机构 | ⭐⭐⭐ 中等 | FreeCAD |
| 复杂曲面（风道、造型件）| ⭐⭐⭐⭐ 困难 | Blender Python |
| 参数化设计（安装座）| ⭐ 简单 | CADQuery |

### 6.2 改进方向建议

**高价值改进（基于分析）:**

1. **M3 螺丝孔标准化** — 所有 CNC 件均为 M3 螺纹，可做参数化孔位生成
2. **DXF 切割图优化** — TT310 侧板 490mm 比 TT235 更宽，现有连接件需适配
3. **密封条槽** — 门框 D 型密封槽（5×5mm）可做参数化生成
4. **风扇罩通风率优化** — 现有风扇罩可做 CFD 风格开孔优化
5. **脚垫支架强度分析** — 底部承重件可做拓扑优化

### 6.3 现有 FCStd 文件可用性

项目现有 19 个 `.FCStd` FreeCAD 源文件（封箱改装用），其中:
- `BottomBracketComplete.FCStd` — 底部支架（最核心受力件）
- `TopFanMount.FCStd` — 顶部风扇罩（有优化空间）
- `CableEntryRing.FCStd` — 线缆入口圈
- `FilterFrame.FCStd` — 滤网框
- `DoorHandle.FCStd`, `HingeMount.FCStd` — 门配件

**可直接修改参数**（草图 + 拉伸参数）后导出 STL。

---

## 七、待验证尺寸

> ⚠️ 以下为从 STEP 坐标估算值，需实物验证

| 项目 | 估算值 | 待验证 |
|---|---|---|
| TT310 实际 Z 向高度 | ~633mm | 与 720mm 差值大，需确认 |
| 丝杆有效行程 | 310mm | 需对照丝杆长度 |
| 热床尺寸 | 310mm 方形 | ✅ 已知 |
| X 轴导轨长度 | ~350mm | 从 CNC 件估算 |
| Y 轴导轨长度 | ~310mm | 从 CNC 件估算 |

---

*本报告由 OpenClaw AI 自动生成 | 分析工具: STEP 文本解析 + FreeCAD 坐标提取*
