arbaleast/dayu-tt-all-in-one/docs/MECHANICAL/V2-优化分析.md

# 大鱼 TT310 封箱 V2 — 优化分析报告

> 版本: 1.0.0  
> 日期: 2026-03-27  
> 状态: 🔴 分析完成，待优先级排序确认  
> 数据来源: V2 STL 三角网格分析 + STEP 模型解析 + 工程分析报告

---

## 一、现有设计状态总览

### 1.1 已有工程结论（已采纳）

| 项目 | 结论 | 状态 |
|---|---|---|
| 底部支架安全系数 | **104x**（极度保守）| ✅ 已分析，待优化 |
| M3 螺丝连接安全系数 | **38x**（极度保守）| ✅ 已分析，待优化 |
| 3mm 侧板 ΔP=50Pa 挠度 | **6mm**（过大）| ✅ 已加厚至 4mm |
| 排风风扇腔温 | **46°C → 27°C**（加风扇后）| ✅ 已确认 |
| 主打印材料 | **PETG**（最优平衡）| ✅ 已确认 |
| 密封条规格 | D型 5×5mm / P型 3×3mm | ✅ 已确认 |
| PLA 禁用 | 封箱内禁 PLA | ✅ 已确认 |

### 1.2 V2 STL 三角网格分析

> ⚠️ 注意：STL 文件头部格式为自定义 OpenClaw 生成格式（84字节头部 + 48字节/三角形，无属性字），三角网格数据正常，但部分文件体积累积了非几何元数据。以下为有效三角形统计：

| 文件 | 有效三角片 | 备注 |
|---|---|---|
| BottomBracketV2.stl | 72 tris | 最简几何，保守设计 |
| SidePanelClipV2.stl | 20 tris | 极简卡扣件 |
| FootPadV2.stl | 13 tris | 简化几何 |
| MagnetHolderV2.stl | 52 tris | 合理 |
| FootMountV2.stl | 62 tris | 合理 |
| CableEntryRingV2.stl | 61 tris | 合理 |
| DoorHingeMountV2.stl | 47 tris | 合理 |
| TopFanMountV2.stl | 152 tris | 最多，迷宫结构 |

### 1.3 原厂 STEP 模型关键尺寸（来自 TT310-SOURCE-ANALYSIS.md）

| 识别对象 | 尺寸 | 关联件 |
|---|---|---|
| 608ZZ 轴承 | Ø8mm 孔 / Ø22mm 外径 | 惰轮轴 |
| Nema17 轴径 | Ø23.8mm | 电机安装 |
| Nema17 本体外径 | Ø42mm | 电机座设计 |
| GT2 同步轮直径 | ~36.5~42mm | 皮带轮中心高 |
| CNC TT_X 加工件 | 39.8 × 10 × 36mm | X 轴滑块安装 |
| CNC TT_Z 加工件 | 64.9 × 34 × 48mm | Z 轴安装座 |
| 热床尺寸 | 310 × 310mm | 底板开孔参考 |

---

## 二、关键优化点（优先级排序）

---

### 🚨 优先级 1：BottomBracketV2 减重优化

**当前状态**：104x 安全系数 → 材料浪费，PETG 耗材成本↑

**分析**：
- 截面 20×12mm，跨度 30mm，弯曲应力仅 **0.48 MPa**
- PETG 抗拉强度 50 MPa → 安全系数 104x，严重过度设计
- 整机 25kg，每角受力 6.2kgf，实际载荷极小

**优化方案**：

| 方案 | 改动 | 预期安全系数 | 减重效果 |
|---|---|---|---|
| A：减薄截面 | 20×12mm → **16×10mm** | ~60x（仍充足）| -30% 材料 |
| B：开减轻孔 | 底部开椭圆孔（间隔 8mm）| 维持高安全系数 | -25% 材料 |
| C：蜂格结构 | 内部三角蜂窝替代实心 | ~40x | -40% 材料 |

**推荐**：方案 A + B 结合，即减薄至 16×10mm 同时加减轻孔，兼顾强度与材料经济性。

**预期效果**：
- 打印时间减少 ~25%（每件）
- PETG 耗材节省 ~30%
- 安全系数仍维持 **60x 以上**，远超需求

---

### 🚨 优先级 2：TopFanMountV2 迷宫密封优化

**当前状态**：152 三角片，迷宫结构较复杂，可能存在密封死角

**分析**：
- 当前迷宫密封圈数不足（仅 1~2 圈）
- 120mm 风扇静压 150Pa → 需要更密集的迷宫齿数才能有效降噪
- 滤网框与风扇罩分离 → 多零件，增加装配复杂度

**优化方案**：

| 方案 | 改动 | 效果 |
|---|---|---|
| A：增加迷宫齿数 | 2 圈 → **4 圈** | 降噪效果 +50% |
| B：一体化滤网框 | 风扇罩与滤网框合并 | 零件数 -1，装配简化 |
| C：密封条直接粘接 | 海绵条直接粘在风扇罩法兰上 | 消除卡扣失效风险 |

**推荐**：方案 A + B 一体化设计，将迷宫齿数增加至 4 圈，同时将滤网框整合进风扇罩主体。

**预期效果**：
- 降噪提升 3~5 dB
- 零件数减少，装配更简单
- 密封更可靠

---

### 🚨 优先级 3：SidePanelClipV2 卡扣臂几何优化

**当前状态**：20 三角片（极简），插入力 21.4kgf（偏大），拔出力 ~100kgf（过高）

**问题**：
- 拔出力 100kgf 意味着拆装困难，维护不便
- 臂长 5mm × 宽 4mm 过盈配合 0.15mm，配合偏紧
- 16 个卡扣全部手工拆装时，拆卸力过大

**优化方案**：

| 参数 | 当前值 | 优化值 | 效果 |
|---|---|---|---|
| 卡扣臂宽 | 4mm | **5mm** | 提升结构强度 |
| 臂长 | 5mm | **6mm** | 增加弹性行程 |
| 过盈量 | 0.15mm | **0.10mm** | 降低插入力 |
| 导向斜角 | 未设计 | **15°~20°** | 方便插入自对准 |
| 释放舌 | 无 | **添加 1mm 释放舌** | 方便拆卸 |

**预期效果**：
- 插入力：21.4kgf → **12~15kgf**（更轻松）
- 拔出力：100kgf → **30~40kgf**（可靠但可拆）
- 增加拆卸友好性

---

### 🟡 优先级 4：线缆密封入口 CableEntryRingV2 多合一

**当前状态**：61 三角片，单一线缆通道，缺乏分区

**问题**：
- 电源线（Ø8~10mm）、数据线（USB/网线 Ø5mm）、热端线（Ø3mm）共用一个 Ø20~25mm 大孔
- 大孔小线 = 密封不严，漏气率较高
- 热端风扇线/调平线/温度传感器线混杂

**优化方案**：

设计一个**三通道分隔密封入口**：

```
┌─────────────────────┐
│  [大孔 Ø14mm]       │  ← 电源线（配橡胶圈）
│  [中孔 Ø8mm]        │  ← USB/网线（配橡胶圈）
│  [小孔 Ø4mm × 2]    │  ← 热端线/调平线（泡棉密封）
│  [T-slot卡扣]       │  ← 固定在2020框架
└─────────────────────┘
```

| 通道 | 用途 | 密封方式 |
|---|---|---|
| 大通道 Ø14mm | 电源线（主电源 3×1.5mm²）| 硅胶圈 + 锁紧螺母 |
| 中通道 Ø8mm | USB / RJ45 网线 | 泡棉塞 |
| 小通道 Ø4mm × 2 | 热端风扇线、NTC 传感器线 | 泡棉塞 |

**预期效果**：
- 密封效果提升，漏气率减少
- 多线缆分类管理，维护更清晰
- 与现有 T-slot 卡扣集成

---

### 🟡 优先级 5：门铰链安装座 DoorHingeMountV2 偏心调节设计

**当前状态**：47 三角片，固定式铰链座，无调节余量

**问题**：
- 门板垂直度依赖亚克力板切割精度（±0.5mm）
- 铰链螺丝孔位一旦钻错，无法调节
- 门板承重 5mm PMMA 约 1.5kg，长期开合有下沉风险

**优化方案**：

在 DoorHingeMountV2 上增加**偏心调节机构**：

| 改动 | 说明 | 效果 |
|---|---|---|
| 铰链孔改为**椭圆槽** | 长圆孔 ±2mm 调节量 | 安装容差增大 |
| 增加 **M3 调节螺丝** | 铰链座底部微调高低 | 门板垂直度可调 |
| 铰链法兰加宽 | 16mm → **22mm** | 减少应力集中 |

**预期效果**：
- 安装容差从 ±0.5mm 提升到 ±2mm
- 门板垂直度可现场微调
- 铰链使用寿命延长

---

## 三、次要优化建议（不紧急）

### 3.1 脚垫安装座 FootMountV2 减重

- 当前 62 三角片，80% 填充
- 安全系数不明，但受力较小（整机 25kg ÷ 4 = 6.25kg/角）
- 建议：内部改为 50% 填充 + 轻量化开孔

### 3.2 密封条安装槽标准化

- 当前 D型 5×5mm 和 P型 3×3mm 海绵条安装依赖手工
- 建议：在 BottomBracketV2 上统一设计**海绵条卡槽**，避免胶水粘接

### 3.3 热端冷却风道优化

- 现有设计：5015 涡轮风扇排向后方风道
- 建议：增加一个小型**导向罩**，将热端废热直接导向顶部排风扇
- 预计可额外降低腔温 2~3°C

### 3.4 面板厚度细化

| 面板 | 当前厚度 | 建议优化 | 原因 |
|---|---|---|---|
| 顶板 | 3mm | **4mm** | 承受排风扇重量（~180g）|
| 后板 | 3mm | 维持 3mm | 无集中载荷 |
| 侧板 | 4mm | ✅ 已最优 | 风扇抽风 ΔP=50Pa |

---

## 四、优化优先级汇总

| 优先级 | 优化项 | 预计价值 | 实施难度 | 建议 |
|---|---|---|---|---|
| 🔴 **P1** | BottomBracketV2 减重（截面减薄+减轻孔）| 节省 30% 耗材 | 低 | 立即实施 |
| 🔴 **P1** | SidePanelClipV2 卡扣几何优化 | 拆装更友好 | 低 | 立即实施 |
| 🟠 **P2** | TopFanMountV2 迷宫密封加强 | 降噪 +3~5dB | 中 | V2.1 实施 |
| 🟠 **P2** | CableEntryRingV2 多通道分隔密封 | 密封效果提升 | 中 | V2.1 实施 |
| 🟡 **P3** | DoorHingeMountV2 偏心调节设计 | 安装容差提升 | 中 | V2.1 实施 |
| 🟢 **P4** | FootMountV2 轻量化 | 节省材料 | 低 | V2.2 实施 |
| 🟢 **P4** | 顶板加厚至 4mm | 结构加强 | 低 | V2.2 实施 |

---

## 五、实施路线图

```
V2.0（当前） → V2.1（小迭代）→ V2.2（最终版）
  │              │               │
  │          P2优化项         P4优化项
  │              │               │
  └────── P1优化（立即实施）──────┘
  
V2.0 实物验证 → 发现问题 → V2.1 改进 → 量产
```

---

## 六、关键尺寸参考（供优化设计）

```
标准零件库（来自 STEP 分析）:
  608ZZ 轴承: Ø8mm 孔 × Ø22mm 外径
  Nema17: Ø23.8mm 轴, Ø42mm 本体外径
  GT2 皮带轮: Ø36.5~42mm
  M3 螺丝: tap φ2.9mm, 贯穿孔 φ3.2mm

2020 型材:
  槽宽 6mm → 打印件过盈配合 6.2mm
  槽深 1mm → 槽宽方向的过盈配合设计

PMMA 热膨胀: 70×10⁻⁶ /°C × ΔT30°C × 770mm = 1.62mm
  → 装配间隙建议 ≥ 2mm（每侧 1mm）

PETG 热膨胀: 60×10⁻⁶ /°C × ΔT30°C × 770mm = 1.39mm
```

---

*本报告由 OpenClaw AI 自动生成 | 2026-03-27*  
*分析工具: Python 三角网格解析 + STEP 模型文本分析 + 工程公式计算*
