arbaleast/dayu-tt-all-in-one/docs/MECHANICAL/V2-结构热力分析报告.md

# 大鱼TT 310 封箱 V2 — 结构与热力工程分析报告

> 版本: 1.0.0  
> 日期: 2026-03-26  
> 状态: ✅ 分析完成  
> 分析工具: Python 工程计算（脚本：`scripts/redesign_v2/analysis_v2.py`）

---

## 一、结构力学分析

### 1.1 底部支架（BottomBracketV2）

| 参数 | 数值 | 备注 |
|---|---|---|
| 整机质量 | 25 kg | 估算值 |
| 总重量 | 245.2 N | |
| 每支架受力 | 61.3 N (6.2 kg) | |
| 受力模型 | 均布载荷简支梁，跨度 30mm | |
| 截面尺寸 | 20×12 mm | |
| 弯曲应力 | **0.48 MPa** | |
| PETG 抗拉强度 | 50 MPa | |
| **安全系数** | **104x** | ✅ 远超需求 |

**结论：底部支架强度极高，104倍安全系数，可进一步减重优化。**

---

### 1.2 亚克力面板变形

| 工况 | 3mm 侧板 | 5mm 门板 |
|---|---|---|
| 仅自重挠度 | 0.004 mm ✅ | 0.002 mm ✅ |
| 风扇抽风 ΔP=50Pa | **5.96 mm ⚠️** | 1.29 mm ✅ |
| 10kg手指按压（集中）| 1169 mm → 弹性恢复 | — |

**关键结论：**
- 封闭腔内压力均匀分布，**自重挠度可忽略**
- 风扇抽风造成 50Pa 压差时，3mm 侧板会产生 ~6mm 凹陷
- **建议：侧板加厚至 4mm**，或增加内部角码支撑数量
- 门板 5mm 足够 ✅

---

### 1.3 M3 螺丝连接

| 参数 | 数值 |
|---|---|
| M3 SS304 极限拉力 | 2352 N ≈ 240 kgf |
| 4颗螺丝总拉力 | 9410 N ≈ 960 kgf |
| 整机重量 | 245 N ≈ 25 kg |
| **安全系数** | **38x** ✅ |

---

### 1.4 面板卡扣插入力

| 参数 | 数值 |
|---|---|
| 卡扣臂 | PETG，宽 4mm × 臂长 5mm |
| 过盈配合 | 0.1 mm |
| 插入力 | **21.4 kgf** |
| 拔出力 | ~100 kgf |
| **结论** | ✅ 手工可拆装，卡扣可靠 |

---

### 1.5 材料力学对比与推荐

| 材料 | E (MPa) | σt (MPa) | 最高温度 | 推荐场景 |
|---|---|---|---|---|
| **PETG** | 2100 | 50 | 70°C | ✅ **首选**，强度+韧性+耐温平衡 |
| ASA | 2100 | 45 | 85°C | 户外/UV/热稳定需求 |
| ABS | 1900 | 35 | 95°C | 需 acetone 抛光处理 |
| **PLA** | 3500 | 50 | 55°C | ⚠️ **封箱内禁用**，超过软化点 |
| TPU95A | 20 | 30 | 80°C | ✅ 脚垫/密封圈首选 |

**综合推荐：**
- 主打印件：**PETG**（耐温 70°C，综合最优）
- 脚垫 + 密封圈：**TPU95A**
- 户外/长期暴晒：**ASA**

---

## 二、热力学与热管理分析

### 2.1 发热源清单

| 热源 | 总功率 (W) | 进入腔体 (W) | 备注 |
|---|---|---|---|
| 热床 (310×310mm) | 300 | 270 | 主要热源 |
| 热端 (Hotend) | 60 | 50 | 200-260°C 喷嘴 |
| X/Y 步进电机 ×2 | 10 | 8 | Nema17 |
| Z 步进电机 | 8 | 6 | 移动时消耗 |
| 主板 + 驱动 (Klipper) | 15 | 12 | KL768 + TMC2209 |
| 开关电源损耗 | 10 | 5 | 约 5-10% |
| **合计** | **403 W** | **~351 W** | |

**机箱参数：**
- 内尺寸：500 × 510 × 780 mm
- 容积：**198.9 L**
- 总换热面积：**2.086 m²**

---

### 2.2 散热方案对比

| 散热方式 | 腔温 | 结论 |
|---|---|---|
| 自然对流（无风扇）| **~46°C** | ⚠️ PLA 软化风险，PETG 可用 |
| 强制风冷（120mm 排风扇）| **~27°C** | ✅ 所有材料均适合！ |

> 🔥 **强制风冷是必须的！** 无风扇腔温接近 PLA 软化点，加风扇后降至 27°C。

---

### 2.3 120mm 排风扇参数

| 参数 | 数值 | 备注 |
|---|---|---|
| 典型风量 | **288 m³/h** ≈ 24 次/分钟换气 | Noctua NF-A12x25 级 |
| 静压 | 150 Pa | 足以克服风道阻力 |
| 腔温降幅 | ~19°C（46°C → 27°C）| |
| 排风理论温升 | 3.7°C | |

---

### 2.4 热端（喷头）散热

| 参数 | 数值 |
|---|---|
| 热端散热需求 | ~50 W |
| 喷嘴温度 | 220°C |
| 腔温（有风扇）| ~27°C |
| 热阻预算 | R_th < 4°C/W |
| **推荐配置** | **5015 涡轮风扇**，排向后方风道 |
| Klipper 控制策略 | 打印时全速，待机时 50% 转速 |

---

### 2.5 热床升温时间

| 目标温度 | 热床功率 | 预计时间 |
|---|---|---|
| → 60°C (ABS 打印) | 300 W | **约 30~50 分钟** |

> 注：实际时间取决于机器框架热容和密封状态

---

### 2.6 热膨胀预算（ΔT = 30°C 时）

| 材料 | 770mm 板热膨胀量 |
|---|---|
| PMMA（亚克力）| **1.62 mm** |
| PETG（3D 打印）| **1.39 mm** |
| Al6063（铝合金框架）| **0.53 mm** |
| 设计公差 | ±0.5 mm ✅ |

> ⚠️ PMMA 和 PETG 膨胀量接近铝合金框架的 2-3 倍
> 装配时需保留足够间隙，避免热胀时压迫变形

---

## 三、设计决策汇总

### 3.1 采纳的设计决策

| 决策项 | 原方案 | V2 结论 | 采纳 |
|---|---|---|---|
| 侧板厚度 | 3mm | ⚠️ 建议 4mm 或加支撑 | 🟡 待确认 |
| 门板厚度 | 3mm | ✅ 5mm 够用 | ✅ |
| 排风扇 | 120mm | ✅ 120mm 单风扇足够 | ✅ |
| 主打印材料 | 未定 | **PETG** | ✅ |
| PLA 使用 | — | ⚠️ **封箱内禁用** | ✅ |
| 自然对流 | — | ⚠️ **不足以散热** | ✅ 强制风冷 |

### 3.2 待确认事项

| 项目 | 优先级 | 备注 |
|---|---|---|
| 侧板厚度是否加到 4mm | 高 | 影响 DXF 切割图 |
| 具体风扇型号 | 中 | Noctua NF-A12x25 或等效 |
| Klipper 风扇控制脚本 | 中 | 参考 `klipper-fan-config.md` |

---

## 四、分析脚本

```bash
# 重新运行分析
python3 /vol1/1000/projects/3d-printing/dayu-tt-all-in-one/scripts/redesign_v2/analysis_v2.py
```

---

*由 OpenClaw AI 生成 | 2026-03-26*
