arbaleast/dayu-tt-all-in-one/docs/MECHANICAL/腔体温控与封箱散热指南.md

# 腔体温控与封箱散热指南

> 更新时间：2026-03-25（X补充）
> 适用：大鱼TT全封闭机箱打印ABS/ASA
> 来源：Voron Community Best Practices + X/Twitter 2026最新讨论

---

## 一、为什么腔室温控很重要？

ABS/ASA 等材料需要高温腔室（50-60°C）才能：
- 减少翘曲和开裂
- 提高层间粘合强度
- 保证尺寸精度

腔室温度过高（>60°C）会软化打印机上的 3D 打印件（用于固定支架、线缆夹等），造成结构失效。

---

## 二、腔室理想温度区间

| 用途 | 推荐温度 | 说明 |
|---|---|---|
| ABS 打印 | 50-60°C | 最佳区间 |
| ASA 打印 | 55-65°C | 略高但别超65°C |
| PLA | 常温即可 | 无需封闭 |
| 安全上限 | **60°C** | 超过会软化打印件 |

---

## 三、排气扇自动控制（推荐）

### 原理
腔温超过 35°C 时自动开启排气扇，低于阈值时降低转速，保持热平衡。

### Klipper 配置示例

```ini
# 腔室温度传感器（建议安装在热端上方10cm处）
[thermistor]
name: chamber_temp
temperature1: B3950
pin: PG5  # 根据实际接线调整

[sensor_reader chamber]
sensor: thermistor chamber_temp
min_temp: 0
max_temp: 120

# 排气扇控制
[fan]
name: exhaust_fan
pin: PA2  # 根据实际接线调整
kick_start_time: 0.5
off_below: 0.10

# 腔温联动
[delayed_gcode chamber_exhaust]
initial_duration: 0
gcode:
  {% if printer.sensor_reader.chamber.temperature > 35 %}
    SET_FAN_SPEED FAN=exhaust_fan SPEED=1.0
  {% else %}
    SET_FAN_SPEED FAN=exhaust_fan SPEED=0.3
  {% endif %}
```

### 阈值参考
- **35°C 以下**：低速运转（10-30%），保持空气流通
- **35°C 以上**：全速排气
- **50°C 以上**：报警提示（可设置）

---

## 四、Nevermore 活性炭滤芯系统

Nevermore 是 Voron 社区开源的腔室空气过滤方案，适合封闭打印ABS时去除 VOC。

### 优点
- 无耗材（活性炭可重复使用）
- 过滤效率高
- 与腔温控制兼容

### 组件清单
| 组件 | 数量 | 备注 |
|---|---|---|
| 4010 风扇 | 2-4个 | 强力吹风 |
| 活性炭 | 100-200g | 散装即可 |
| 3D打印框架 | 1套 | Voron开源文件 |

### Klipper 控制
```ini
# Nevermore 风扇
[fan]
name: nevermore_fan
pin: PA3
kick_start_time: 0.5

# 与主排气扇联动或独立控制
```

---

## 五、大鱼TT封箱散热改装要点

### 热床热量利用
封箱后，热床（通常200W）工作时会将腔室加热到 40-50°C，在多数地区无需额外加热。寒冷环境（室温<15°C）可能需要：
- 增加保温层（PEI板贴在箱壁上）
- 外置加热器（如陶瓷加热灯）

### 散热通道设计
- **顶部排气孔**：建议开 2-4 个 50mm 直径孔
- **前进后出**：形成空气对流
- **可调节开度**：用 3D 打印盖板控制通风量

### 滤芯位置建议
- 置于箱体后部角落
- 避免正对热端，影响热端散热
- 进风口朝下，出风口朝上（热气上升）

---

## 六、实测数据参考

> 来源：Voron 2.4 社区报告（与大鱼TT结构类似）

| 环境温度 | 热床温度 | 腔室温度（封闭） | 备注 |
|---|---|---|---|
| 20°C | 100°C | 45-50°C | 正常 |
| 15°C | 100°C | 38-42°C | 需保温 |
| 25°C | 110°C | 55-60°C | 略高，注意排气 |
| 10°C | 110°C | 35-40°C | 需辅助加热 |

---

## 七、排气扇选型建议

| 型号 | 规格 | 适合场景 |
|---|---|---|
| Noctua NF-A4x20 | 5V 40x40x20mm | 低噪音备用 |
| 5015 鼓风机 | 24V 50x50x15mm | 平衡风量/噪音 |
| 4020 暴力扇 | 24V 40x40x20mm | 高风量快速散热 |

> 推荐：5015 鼓风机，配合 35°C 阈值控制，噪音和效果平衡最好。

---

## 八、故障排查

| 症状 | 可能原因 | 解决方法 |
|---|---|---|
| 腔温超过60°C | 排气不足/环境太热 | 增加排气孔，开盖降温 |
| 打印件底部翘曲 | 腔温太低/气流不稳定 | 提高热床温度，检查密封 |
| 有异味残留 | 通风不良/活性炭饱和 | 检查Nevermore，暴晒复用 |
| 层间粘合差 | 腔温波动大 | 减少开门次数，稳定控温 |

---

## 九、X/Twitter 2026 最新经验（🆕）

**来源：** X/Twitter 3D打印社区讨论（2026年3月）

### Bambu Lab P2S 的启示
Bambu Lab P2S（2026年发布）主打功能与封箱设计高度相关：
- **关舱打印不怕热积压**：封闭环境反而是优势，腔温稳定
- **Adaptive Airflow**：任意耗材自动匹配腔温，风扇转速动态调节
- **AI Monitoring**：实时检测打印异常，防止整夜报废
- 对大鱼TT的参考：**封箱不是缺点，封闭+智能散热才是优势**

### Voron 社区封箱经验
- **热床功率利用**：200W 热床封闭后可持续维持腔温 45-55°C（室温 20°C）
- **密封优先于排气**：先确保四面密封，再设计排气；密封不好排气只是白加热
- **开门打印 vs 关门打印**：ABS/ASA 必须关门打印，PLA 可以开门

### CNC Kitchen（Stefan）的忠告
> "封箱打印时，第一层打印完成后立即关门，中途不要开门，否则温差骤变会导致翘边。"

### 封箱散热黄金原则
1. **先密封后排气** — 密封做不好，排气全浪费
2. **热空气必须能出去** — 35°C 自动触发排气扇全速
3. **冷空气必须能进来** — 底部留进风口，形成对流
4. **Nevermore 过滤VOC** — ABS 打印必备，保护健康

---

## 十、封箱成功率数据（2026实测）

**来源：** Dreaming3D 2026年封箱完整指南

| 条件 | 成功率 | 说明 |
|---|---|---|
| 开舱打印（无封箱） | **<5%** | 热应力导致严重翘边/分层 |
| 有封箱（自然散热） | **60-70%** | 腔温 35-45°C |
| 有封箱 + 主动温控 | **90-95%** | 腔温 50-60°C |
| 有封箱 + 智能排气 | **95%+** | 温度稳定，开门后快速恢复 |

> 大鱼TT封箱目标：**95%+**，通过热床加热 + 35°C 排气阈值 + 密封条实现。

### 噪音控制参考

| 改装方案 | 降噪效果 |
|---|---|
| 无封箱 | 基准 ~50dB |
| 亚克力封箱（3mm） | -5~10dB |
| 加声学棉（25mm） | **-10~30dB** |
| 专业隔音封箱 | -25~35dB |

---

## 十一、门把手+温湿度计一体化（🆕）

**来源：** Printables [Enclosure Soft Close Magnetic Door Handle with Mijia Thermometer](https://www.printables.com/model/220449)

### 设计亮点
- 铰链+磁吸把手一体化，嵌入温湿度计
- 开关仓门时自动显示腔温
- 可自定义显示打印机名称
- 磁吸强度适中，开门手感好

### 大鱼TT封箱参考

| 设计要素 | 建议 |
|---|---|
| 磁铁规格 | Ø10×3mm N52 × 4-6个 |
| 磁铁间距 | 100-150mm 均匀分布 |
| 嵌入深度 | 1-2mm（3D打印件预留槽） |
| 温湿度计 | 米家温湿度计（价格低，数据准） |

---

## 十二、2026年热端新技术参考

**来源：** X/Twitter Bambu Lab 2026年发布

### Bambu Lab H2S（重大发布）
- **体积**：X1C 的 **220%**（超大幅面）
- **速度**：比 X1C 快 **30%**

### Bambu DiamondBack Hotend（Bambu × E3D 合作）
- **耐磨**：可打印金属耗材（不锈钢、铜等）
- **耐陶瓷填充**：硬度更高，寿命更长

### 大鱼TT热端改装建议
| 改装方案 | 适合人群 | 成本 |
|---|---|---|
| Revo（免工具换喷嘴） | 追求便利 | 中 |
| Dragon HF（高流量） | 高速打印党 | 中 |
| DiamondBack（耐磨） | 想打金属/陶瓷填充 | 高 |
