arbaleast/dayu-tt-all-in-one/docs/MECHANICAL/12_官方封箱方案.md

# 大鱼TT 官方封箱方案

## 方案概述

设计者：大鱼DIY（官方）  
视频发布时间：2024-01-19  
播放量：7.3万+  
成本：约¥1600+

## 方案特点

- **官方开源** - 设计文件完整公开
- **性能稳定** - 经过充分测试
- **社区支持** - 有大量用户案例
- **高速打印** - 优化了高速打印性能

## 视频教程

| 视频标题 | 发布时间 | 播放量 | 主要内容 |
|---|---|---|---|
| 【开源】1600+做一台带封箱的高速3D打印机之大鱼TT封箱了！ | 2024-01-19 | 7.3万 | 核心教程 |
| 【开源】2025年，大鱼TT还值得一玩吗？ | 2024-12-13 | 47.2万 | 综合评测 |
| 搭载Klipper固件的高速3D打印机DIY之大鱼TT | 2023-09-06 | 16.2万 | 基础装机 |

## 官方资源

### B站主页
- 大鱼DIY官方账号
- 视频评论区通常有文件链接

### 开源平台
- GitHub: 搜索 "Dayu TT" 或 "大鱼TT"
- MakerWorld: 搜索 "Dayu TT"
- Printables: 搜索 "Dayu TT Enclosure"

## 材料清单

### 基础框架

| 材料 | 规格 | 数量 | 参考价格 |
|-----|---|---|---|
| 2040铝型材 | 按尺寸 | 若干 | ¥150-200 |
| 2020铝型材 | 按尺寸 | 若干 | ¥50-80 |
| 角码 | 标准件 | 20-30个 | ¥20-30 |
| T型螺母+螺丝 | M5 | 100套 | ¥20-30 |

### 封箱板材

| 材料 | 规格 | 数量 | 参考价格 |
|-----|---|---|---|
| 亚克力板 | 5mm透明 | 4-5张 | ¥150-200 |
| 亚克力板 | 3mm黑色 | 2-3张 | ¥80-100 |
| 保温棉 | 10mm | 适量 | ¥30-50 |

### 电气系统

| 材料 | 规格 | 数量 | 参考价格 |
|-----|---|---|---|
| LED灯条 | 12V/24V | 1-2条 | ¥20-40 |
| 风扇 | 4010/4020 | 2-3个 | ¥30-60 |
| 温控器 | 数显 | 1个 | ¥40-60 |
| 加热器 | PTC 100W | 1个 | ¥60-100 |
| 开关电源 | 12V 5A | 1个 | ¥40-60 |

### 门和密封

| 材料 | 规格 | 数量 | 参考价格 |
|-----|---|---|---|
| 磁吸条 | 10×3mm | 3米 | ¥15-25 |
| 合页 | 小型 | 2-4个 | ¥10-20 |
| 密封条 | 海绵 | 3米 | ¥10-15 |
| 门把手 | 小型 | 1-2个 | ¥10-15 |

## 总成本估算

| 项目 | 价格范围 |
|-----|---|
| 铝型材框架 | ¥250-350 |
| 板材 | ¥250-350 |
| 电气系统 | ¥200-350 |
| 门和密封 | ¥50-80 |
| 其他配件 | ¥100-150 |
| **总计** | **¥850-1280** |

*注：以上为封箱部分成本，不含打印机本体*

## 尺寸规格

### 235版本
- 外尺寸：约 450×450×500mm
- 内尺寸：约 400×400×450mm
- 打印空间：235×235×250mm

### 310版本
- 外尺寸：约 550×550×600mm
- 内尺寸：约 500×500×550mm
- 打印空间：310×310×310mm

## 装配要点

### 框架搭建
1. 先组装底部方形框架
2. 安装4根立柱
3. 安装顶部框架
4. 用角尺检查垂直度
5. 紧固所有螺丝

### 板材安装
1. 先安装背板和侧板
2. 安装顶板（可做成可开启）
3. 安装门板（带磁吸）
4. 内侧贴保温棉

### 电气安装
1. LED灯条安装在顶部
2. 风扇安装在背板或侧板
3. 温控器固定在方便操作的位置
4. 加热器安装在底部（不直接接触打印机）

## 温控设置

### ABS打印推荐参数
- 仓温：45-50°C
- 喷头：240-250°C
- 热床：100-110°C

### 温控器设置
- 目标温度：45°C
- 回差：2-3°C
- 报警温度：60°C

## 开源文件清单

```
dayu-tt-all-in-one/
├── stl/
│   ├── 框架连接件/
│   ├── 风扇罩/
│   ├── 线槽/
│   ├── 灯条支架/
│   └── 门配件/
├── dxf/
│   ├── 亚克力切割图/
│   └── 保温棉切割图/
├── bom/
│   └── 物料清单.xlsx
└── doc/
    └── 装配说明.pdf
```

## 获取方式

1. **B站视频评论区** - 置顶评论通常有网盘链接
2. **GitHub** - 搜索 "dayu-tt" 或 "大鱼TT"
3. **QQ群** - 视频简介或评论区有群号
4. **MakerWorld** - 官方可能上传了模型

## 社区资源

### 推荐UP主
- 大鱼DIY（官方）
- 汪汪队射手（魔改版）
- 李炫键（降噪版）
- 小宇的魔术师（310版本）

### 常见问题

**Q: 235和310版本怎么选？**
A: 空间允许建议310，打印空间更大；空间有限选235。

**Q: 封箱后温度控制不好？**
A: 检查保温棉是否完整，风扇是否常开，温控器参数设置。

**Q: 打印ABS还是翘边？**
A: 提高仓温到50°C，检查热床温度，使用 brim。

---
*官方方案持续更新中，请关注大鱼DIY最新视频*
