arbaleast/dayu-tt-all-in-one/docs/MECHANICAL/13_开源文件资源.md

# 开源文件资源汇总

## 如何获取开源文件

### 方法一：B站视频评论区

#### 汪汪队射手
1. 打开B站视频《大鱼TT魔改+封箱》
2. 查看置顶评论
3. 通常包含：
   - 百度网盘链接
   - 阿里云盘链接
   - GitHub仓库链接
   - QQ群号

#### 大鱼DIY官方
1. 官方视频评论区
2. 大鱼DIY主页简介
3. 官方QQ群/微信群

### 方法二：直接联系UP主

#### B站私信
- 汪汪队射手
- 大鱼DIY
- 李炫键

#### 常见回复时间
- 工作日：1-3天
- 周末：可能更快

### 方法三：社区资源

#### QQ群
搜索关键词：
- 大鱼TT
- Dayu TT
- 3D打印封箱

#### 微信群
- 通常通过QQ群过渡
- 或B站视频简介

#### Discord/Telegram
- 国际社区可能有相关频道

### 方法四：开源平台搜索

#### GitHub
搜索关键词：
```
dayu tt enclosure
dayu-tt-all-in-one
大鱼TT 封箱
big fish tt
```

#### MakerWorld
- https://makerworld.com
- 搜索 "Dayu TT" 或 "大鱼TT"

#### Printables
- https://printables.com
- 搜索 "Dayu TT Enclosure"

#### Thingiverse
- https://thingiverse.com
- 搜索 "Dayu TT"

## 预期文件清单

### 汪汪队射手方案

```
stls/汪汪队射手/
├── 皮带张紧器/
│   ├── 固定座_X轴.stl
│   ├── 固定座_Y轴.stl
│   ├── 活动块.stl
│   ├── 张紧轮.stl
│   └── 轴销.stl
├── 风扇罩/
│   ├── 进风风扇罩.stl
│   └── 排风风扇罩.stl
├── 线槽/
│   ├── 线槽主体.stl
│   └── 线槽盖.stl
└── 其他配件/
    ├── 灯条支架.stl
    ├── 门把手.stl
    └── 温控器支架.stl
```

### 官方方案

```
stls/官方/
├── 框架连接件/
│   ├── 角码加强件.stl
│   └── 型材端盖.stl
├── 风扇罩/
│   ├── 风扇罩_4010.stl
│   └── 风扇罩_4020.stl
├── 过滤系统/
│   ├── 过滤盒主体.stl
│   ├── 过滤盒盖.stl
│   └── 活性炭支架.stl
└── 门配件/
    ├── 磁吸支架.stl
    ├── 合页.stl
    └── 门把手.stl
```

## 文件格式说明

### STL文件
- 3D打印标准格式
- 可直接导入切片软件
- 需要支撑的文件会注明

### 3MF文件
- 较新的3D打印格式
- 包含更多打印参数
- PrusaSlicer原生支持

### STEP/IGES文件
- CAD源文件格式
- 可编辑修改
- 适合自定义设计

### DXF文件
- 2D切割图
- 用于亚克力/板材切割
- 可导入激光切割机

## 推荐软件

### 查看STL
- **Windows**: 3D Builder, Fusion 360
- **Mac**: Preview, Fusion 360
- **Linux**: MeshLab, FreeCAD
- **在线**: https://www.viewstl.com

### 编辑修改
- **Fusion 360** (免费个人版)
- **FreeCAD** (开源免费)
- **Blender** (开源免费)
- **Tinkercad** (在线免费)

### 切片打印
- **PrusaSlicer** (推荐)
- **Cura**
- **Bambu Studio**
- **OrcaSlicer**

## 打印建议

### 材料选择
| 零件类型 | 推荐材料 | 原因 |
|---|---|---|
| 结构件 | PETG | 强度高，耐温好 |
| 外观件 | PLA | 易打印，表面光滑 |
| 高温件 | ABS/ASA | 耐温高 |
| 功能件 | PETG/ABS | 综合性能好 |

### 打印参数
- 填充：30-50%
- 壁厚：3-4层
- 顶层/底层：4-5层
- 支撑：根据需要

## 获取记录

| 日期 | 来源 | 文件 | 备注 |
|-----|---|---|---|
| 待补充 | | | |

## 待获取清单

- [ ] 汪汪队射手皮带张紧器STL
- [ ] 官方封箱框架连接件
- [ ] 风扇罩模型
- [ ] 线槽模型
- [ ] 门配件模型
- [ ] 亚克力切割DXF
- [ ] 装配说明书PDF

---
*请自行联系UP主获取开源文件，本清单仅供参考*
