arbaleast/dayu-tt-all-in-one/docs/MECHANICAL/07_大鱼TT从零DIY完全指南.md

# 大鱼TT 从零 DIY 完全指南

> 更新时间：2026-03-24
> 适合：动手能力强的爱好者 / 想深度了解 3D 打印机结构的人
> DIY 预算：¥1700-2500（根据配置）
> DIY 耗时：2-3 周（业余时间）

---

## 一、大鱼TT 是什么？

**大鱼 TT** 是 B站 UP主 **大鱼DIY**（3546563115626409）在 2023 年开源的 CoreXY 结构 3D 打印机方案。

**核心特点：**
| 特点 | 参数 |
|---|---|
| 结构 | CoreXY（高速结构）|
| 打印尺寸 | 235×235mm 或 310×310mm |
| 层高 | 0.05-0.3mm |
| 打印速度 | 最高 150mm/s（Klipper 加持）|
| 固件 | Klipper |
| 开源许可 | 禁止商用 |

**开源地址：**
- MakerWorld：大鱼DIY 全套打印件
- GitHub：DayuDIY/Xuanwu（玄武 — 大鱼最新设计）
- B站：大鱼DIY（3546563115626409）

---

## 二、尺寸选择

| 版本 | 打印面积 | 热床 | 适合人群 |
|---|---|---|---|
| **235mm** | 235×235×250mm | M6 螺丝孔 | 入门 / 小型作品 |
| **310mm** | 310×310×310mm | M8 螺丝孔 | 追求大尺寸 |

> 建议：**新手从 235mm 开始**，配件更便宜、调试更简单。

---

## 三、开源项目版本

| 项目 | 设计者 | 特点 | 下载 |
|---|---|---|---|
| **大鱼 TT** | 大鱼DIY | 经典版本，资料最多 | MakerWorld |
| **大鱼 玄武（Xuanwu）** | 大鱼DIY | 最新设计，结构优化 | GitHub |
| **大鱼 朱雀** | 大鱼DIY | 新版 3D 打印件 | MakerWorld |
| **大鱼 云雀** | 大鱼DIY | 另一变种 | MakerWorld |
| **重制版 XY 结构件** | 社区 | 双边固定+F695轴承 | MakerWorld |

---

## 四、DIY 采购清单（BOM）

### 4.1 标准版采购清单（235mm）

> 参考价格，实际以购买时为准。总预算约 ¥1700-2000

#### 框架与结构件

| 配件 | 规格 | 数量 | 参考价 | 备注 |
|---|---|---|---|---|
| 2020 铝型材 | 400mm 长 | 4根 | ¥30 | X轴两根 |
| 2020 铝型材 | 500mm 长 | 4根 | ¥40 | Y轴两根 |
| 2020 铝型材 | 650mm 长 | 2根 | ¥30 | Z轴两根 |
| 2020 角码 | 内角 | 12个 | ¥10 | 框架连接 |
| M5 螺丝套装 | T 螺母 + 螺丝 | 1套 | ¥15 | |
| GT2 同步带 | 6mm 宽 | 2m | ¥10 | XY轴传动 |
| GT2 同步轮 | 20齿 内径5mm | 4个 | ¥15 | |
| M8 丝杆 | 400mm 长 | 1根 | ¥20 | Z轴 |
| M8 铜螺母 | | 1个 | ¥5 | Z轴 |

#### 运动系统

| 配件 | 规格 | 数量 | 参考价 | 备注 |
|---|---|---|---|---|
| 42 步进电机 | NEMA17 | 5个 | ¥75 | X/Y/Z + 挤出机 |
| 电机座 | 铝合金 | 4个 | ¥20 | |
| 直线导轨 | MGN12H 400mm | 2根 | ¥40 | Y轴 |
| 直线导轨 | MGN12H 350mm | 2根 | ¥35 | X轴 |
| MGN12 滑块 | | 4个 | ¥10 | |

#### 挤出系统

| 配件 | 规格 | 数量 | 参考价 | 备注 |
|---|---|---|---|---|
| 泰坦挤出机套装 | 3:1 减速 | 1套 | ¥70 | 或自选 |
| E3D V6 喷头 | 1.75mm/0.4mm | 1个 | ¥50 | |
| PTFE 管 | 4×2mm | 0.5m | ¥5 | |
| 气动接头 | PC4-M6 | 2个 | ¥5 | |

#### 热床系统

| 配件 | 规格 | 数量 | 参考价 | 备注 |
|---|---|---|---|---|
| 热床 | 235×235mm 24V | 1个 | ¥60 | 220W |
| PEI 弹簧钢板 | 235×235mm | 1个 | ¥50 | 打印面 |
| 热床调平弹簧 | 8×20mm | 4个 | ¥5 | |
| 热电偶 | 100K 3950 | 1个 | ¥5 | |

#### 散热系统

| 配件 | 规格 | 数量 | 参考价 | 备注 |
|---|---|---|---|---|
| 散热风扇 | 4010 24V | 2个 | ¥20 | 热端散热 |
| 涡轮风扇 | 5015 24V | 1个 | ¥18 | 部件冷却 |
| 铜质散热片 | E3D 规格 | 1个 | ¥12 | |

#### 电子系统

| 配件 | 规格 | 数量 | 参考价 | 备注 |
|---|---|---|---|---|
| **主板** | 小乖K6 / 八爪鱼 | 1块 | ¥180 | 含TMC2209 |
| 24V 电源 | 350W | 1个 | ¥100 | |
| 树莓派 4B | 2GB | 1个 | ¥250 | Klipper 上位机 |
| USB 线 | A to Micro | 1根 | ¥10 | |
| 限位开关 | 3线 光耦 | 3个 | ¥12 | X/Y/Z 归零 |

#### 线材与配件

| 配件 | 规格 | 数量 | 参考价 | 备注 |
|---|---|---|---|---|
| 电源线 | 2×1.5mm² | 2m | ¥10 | |
| 扎带 | 3×100mm | 1包 | ¥5 | |
| 3M 胶带 | | 1卷 | ¥5 | |
| 热缩管 | 套装 | 1套 | ¥10 | |

#### 3D 打印件（自行打印）

| 打印件 | 材料 | 说明 |
|---|---|---|
| 框架连接件 | ABS 或 PETG | MakerWorld 下载 |
| X/Y 轴滑块 | ABS 或 PETG | MakerWorld 下载 |
| 挤出机支架 | ABS 或 PETG | MakerWorld 下载 |
| 热床支架 | ABS 或 PETG | MakerWorld 下载 |
| 风扇罩 | ABS 或 PETG | MakerWorld 下载 |

---

### 4.2 预算汇总

| 配置 | 总价 | 说明 |
|---|---|---|
| **基础版** | ¥1700 | 标准配件，无改装 |
| **进阶版** | ¥2200 | + 闭环电机 + 好风扇 |
| **满配版** | ¥3000+ | + 封箱 + CAN 总线 |

---

## 五、DIY 步骤总览

```
阶段一：准备（1-3天）
├── 下载所有 STL 文件
├── 采购零件
└── 打印框架连接件

阶段二：组装框架（3-5天）
├── X 轴组件
├── Y 轴组件
├── Z 轴组件
└── 框架搭建

阶段三：安装运动系统（2-3天）
├── 安装导轨
├── 安装电机
├── 安装同步带
└── 张紧调节

阶段四：安装挤出系统（1-2天）
├── 安装热端
├── 安装挤出机
├── 安装热床
└── 安装散热风扇

阶段五：接线（1-2天）
├── 主板接线
├── 限位开关接线
├── 热床接线
└── 风扇接线

阶段六：Klipper 固件（1-2天）
├── 安装树莓派系统
├── 配置 Klipper
├── 调试参数
└── 首次打印测试
```

---

## 六、核心视频教程

| 标题 | BV号 | 内容 |
|---|---|---|
| **搭载Klipper固件的高速3D打印机DIY之大鱼TT** | BV1ak4y1A78e | **完整装机视频（P1-P4）** |
| 大鱼TT装机经验分享 | - | 走线教程（P3）|
| 大鱼TT调试说明及首层测试 | - | 调试教程（P4）|
| Klipper固件配置教程 | - | 固件视频 |
| 【开源】1600+大鱼TT封箱 | BV1pe41117h2 | 封箱方案 |
| 大鱼TT结构件升级改造 | BV1Lz421C7Q4 | 改装升级 |

---

## 七、3D 打印件获取

### 7.1 MakerWorld 下载

| 模型 | 链接 | 版本 |
|---|---|---|
| 大鱼 TT 全套打印件 | MakerWorld | V1.x |
| 大鱼 TT 重制版 XY 结构件 | MakerWorld | 双边固定版 |
| 大鱼 朱雀全套打印件 | MakerWorld | V1.04 |
| 大鱼 云雀 V1.06 | MakerWorld | 最新版 |

### 7.2 GitHub 资源

- **Xuanwu（玄武）** GitHub：https://github.com/DayuDIY/Xuanwu
  - 包含采购清单 Excel（`*采购清单*.xlsx`）
  - 3D 模型文件（STEP 格式）

### 7.3 打印参数建议

```
材料: ABS（推荐）或 PETG
层高: 0.2mm
填充: 40-60%
壁厚: 3-4 层
打印速度: 50mm/s
热床温度: 100°C（ABS）
热端温度: 230°C（ABS）
```

> ⚠️ 打印件是整个 DIY 的第一步，必须先打印完成才能继续组装！

---

## 八、工具准备

| 工具 | 用途 | 必要程度 |
|---|---|---|
| 内六角扳手套装 | 螺丝拆卸 | ⭐⭐⭐⭐⭐ 必备 |
| 十字螺丝刀 | 接线端子 | ⭐⭐⭐⭐⭐ 必备 |
| 尖嘴钳 | 拉 T 螺母 | ⭐⭐⭐⭐ 必备 |
| 万用表 | 电路检测 | ⭐⭐⭐⭐ 推荐 |
| 热熔枪 | 整理线材 | ⭐⭐⭐ 可选 |
| 电烙铁 | 接线焊接 | ⭐⭐⭐ 推荐 |
| 锉刀 | 打磨打印件毛刺 | ⭐⭐⭐ 推荐 |
| M5 螺丝刀 | 型材紧固 | ⭐⭐⭐⭐ 必备 |
| 水平仪 | 调平框架 | ⭐⭐⭐⭐ 推荐 |

---

## 九、Klipper 安装指南

### 9.1 推荐系统

| 系统 | 说明 | 推荐度 |
|---|---|---|
| **Mainsail OS** | 最好用的 Klipper 镜像 | ⭐⭐⭐⭐⭐ |
| **FluiddPi** | 另一个优秀镜像 | ⭐⭐⭐⭐ |
| **树莓派原版 + KIAUH** | 手动安装 | ⭐⭐⭐⭐ |

### 9.2 KIAUH 安装

```bash
# SSH 到树莓派后执行
git clone https://github.com/dw-0/kiauh.git
./kiauh/kiauh.sh
```

按提示安装 Klipper + Moonraker + Fluidd。

### 9.3 配置文件

参考项目内文档：`docs/02-硬件改进/Klipper固件配置完全指南.md`

---

## 十、常见问题

### Q1: 打印件怎么打印？
**答：** 用现有打印机打印，或者找淘宝/闲鱼代打，或者购买套件时让商家帮你打印。

### Q2: 买零件要多少钱？
**答：** 基础版约 ¥1700，不含打印件。如果连打印机都没有，需要先借/租/买一台打印完零件后再组装。

### Q3: 需要多久完成？
**答：** 业余时间 2-3 周，每天 2-3 小时。

### Q4: 不会编程能 DIY 吗？
**答：** 能！Klipper 配置有固定模板，按照视频教程一步步来即可。

### Q5: 235mm 还是 310mm？
**答：** 建议 235mm，配件更便宜、空间要求更小、调试更简单。

---

## 十一、升级路线图

```
入门（¥1700）
  ↓
加 Klicky 探针（¥50）
  ↓
加 PEI 平台（¥50）
  ↓
装 Klipper + 摄像头（¥200）
  ↓
加闭环电机（¥200）
  ↓
加封箱散热（¥360）
  ↓
改 CAN 总线（¥150）
  ↓
多色打印（¥500+）
```

---

## 十二、资源链接

| 类型 | 链接 |
|---|---|
| 大鱼DIY B站主页 | https://space.bilibili.com/3546563115626409 |
| 大鱼 TT 全套打印件 | MakerWorld（搜索"大鱼DIY"）|
| Xuanwu GitHub（含 BOM）| https://github.com/DayuDIY/Xuanwu |
| Klipper 官方文档 | https://www.klipper3d.com/ |
| KIAUH 安装助手 | https://github.com/dw-0/kiauh |
| 大鱼 TT 重制版 XY 结构 | MakerWorld |

---

## 十三、项目内相关文档

| 文档 | 内容 |
|---|---|
| `docs/00-入门指南/` | 新手指南、配件预算 |
| `docs/01-封箱方案/` | 封箱、42闭环改装 |
| `docs/02-硬件改进/` | CAN总线、摄像头、Klipper配置、多色打印 |
