arbaleast/dayu-tt-all-in-one/docs/MECHANICAL/38_多色打印改装完全指南.md

# 大鱼TT 多色打印完全指南

> 更新时间：2026-03-24
> 适用：大鱼TT / 大鱼CC / Voron CoreXY 结构
> 改装难度：⭐⭐⭐⭐（较复杂）

---

## 一、多色打印实现方式

| 方案 | 原理 | 色数 | 浪费 | 复杂度 | 推荐度 |
|---|---|---|---|---|---|
| **手动换料** | 打印暂停，手动换料 | 无限 | 多 | ⭐ 简单 | ⭐⭐⭐ |
| **单喷嘴换料器（ERCF）** | 耗材切换器，多色走同一喷嘴 | 2-16色 | 少 | ⭐⭐⭐⭐ | ⭐⭐⭐⭐ |
| **多喷嘴切换（ToolChanger）** | 每个颜色独立喷嘴 | 4-8色 | 无 | ⭐⭐⭐⭐⭐ | ⭐⭐⭐⭐⭐ |
| **AMS/外挂料盘** | Bambu式自动供料 | 2-16色 | 中 | ⭐⭐⭐ | ⭐⭐⭐⭐ |

---

## 二、方案对比详解

### 2.1 手动换料（最简单）

**原理：** 打印到某一层时暂停，手动把耗材换成新颜色，继续打印。

**优点：** 无硬件改装，零成本
**缺点：** 需要人在场，换料时容易堵头，效果一般

**操作步骤：**
1. OrcaSlicer/PrusaSlicer 切片时设置换色层
2. 打印到该层时自动暂停
3. 手动拉出旧料，换上新料
4. 挤出少许新料，确认颜色正确
5. 点击继续打印

---

### 2.2 ERCF 单喷嘴换料器（推荐 ⭐⭐⭐⭐）

**ERCF** = Enraged Rabbit Carrot Feeder

**原理：** 多个料盘安装在主动力齿轮上，打印中切换不同颜色耗材，全部共用一个热端。

**开源项目：**
- GitHub: https://github.com/EtteGit/EnragedRabbitProject
- B站视频：搜 "ERCF 多色打印"

**特点：**
- 支持 2-16 色
- 耗材浪费少（约 30-50cm/次换色）
- 可适配 Voron / 大鱼 TT 框架

**ERCF for 大鱼TT：**
- 可安装在 Voron Trident 或三叉戟改装的大鱼 TT 上
- 需要 3D 打印支架

---

### 2.3 ToolChanger 多喷嘴切换（最完美 ⭐⭐⭐⭐⭐）

**原理：** 每个颜色有独立的热端和挤出机，打印头可自动切换不同工具头。

**代表项目：**
- **Voron ToolChanger** — Voron 官方多色方案
- **Prusa XL Multi Material** — 商业方案代表

**优点：**
- 换色无耗材浪费
- 速度快（不用拉料换色）
- 可同时装载 4-8 个颜色

**缺点：**
- 结构复杂，改装成本高（¥2000+）
- 调试周期长

---

### 2.4 AMS 风格外挂料盘（DIY 低成本）

**代表项目：**
- **MOZHU-AMS**（翔林魔主）- Gitee 开源
  - https://gitee.com/XLmozhu/mozhu-ams
  - 适配拓竹 P1 系列，X1 系列也可用
- **50元 DIY AMS** — B站 ¥50 手工打造

**DIY AMS 参考：**
- B站搜 "50块钱手搓拓竹 AMS"
- 使用舵机 + 耗材支架制作

---

## 三、大鱼TT 多色打印改装方案

### 方案一：三叉戟 + ERCF（推荐）

**来源：** B站 `大鱼TT 三叉戟` 改装案例

**改装清单：**
| 配件 | 数量 | 说明 |
|---|---|---|
| 三叉戟 Z 轴套件 | 1 | 3 根丝杆 + 3 电机 |
| SB 挤出头 | 1 | 近程挤出 |
| ERCF 换料器 | 1 | 2-4 色 |
| CAN 总线 SB2040 | 1 | 工具板 |
| 耗材支架 | 4 | 4 色料盘 |

**改装后效果：** 最多支持 4 色自动换料

---

### 方案二：Voron Afterburner + MMU（通用）

**适用：** 已改装 Voron 风格工具头的大鱼 TT

| 配件 | 说明 |
|---|---|
| Afterburner 工具头 | 单喷嘴多色工具头 |
| MMU 2S | Prusa 多材料单元 |
| 改法：安装 Afterburner + MMU 适配器 |

---

### 方案三：大鱼 CC 多色案例参考

**来源：** B站 `大鱼CC 四叉戟`（BV1x44y1T7Bq）

大鱼 CC 改装三叉戟后，可扩展多色：

```
改装配置：
- 小政K6 主板
- FLY MiniPad 上位机
- FLY SB2040 CAN板
- SB 头近程挤出
- CAN 总线布线
- 后续加多色切换器
```

---

## 四、Klipper 多色配置

### 4.1 ERCF 配置示例

```ini
[extruder]
step_pin: SB2040:EXT_STEP
dir_pin: !SB2040:EXT_DIR
rotation_distance: 22.67895
gear_ratio: 50:10
microsteps: 16

[filament_switch_sensor color_1]
filament_switch_pin: ^PG6
pause_on_runout: True
runout_gcode: M600

[respond]
```

### 4.2 多色切片设置（OrcaSlicer）

1. 导入多色模型
2. 在切片软件中**分配颜色**（不同部分→不同颜色）
3. 设置**换色时清洗**距离（通常 20-30mm）
4. 切片后生成多色 Gcode

---

## 五、多色打印耗材浪费优化

### 5.1 换色废料来源

每次换色时，需要把旧颜色从喉管中挤出，产生"清洗块"（Wipe Tower / Purge Block）。

**Bambu 的"清除粪便"：**
> 每次颜色交换都会产生一小块塑料，这就是 Bambu AMS 著名的"清洗块"问题。

### 5.2 减少废料的技巧

1. **使用小清洗块** — OrcaSlicer 支持"自适应清洗块"
2. **调整清洗距离** — 清洗距离越短，废料越少
3. **选择相近颜色连续打印** — 减少颜料混合
4. **Wipe into Model** — 清洗料挤到模型内部（高级功能）

---

## 六、多色打印注意事项

### ⚠️ 耗材管理

| 问题 | 解决方案 |
|---|---|
| 耗材吸湿 | 用真空密封袋 + 干燥剂 |
| 颜色不够用 | 多买同色备用 |
| TPU 多色 | TPU 不建议多色（换色难）|

### ⚠️ 打印时间

- 多色打印时间增加约 10-30%（换色+清洗）
- 长时间打印建议开启**耗材烘干**（防潮）

---

## 七、DIY AMS 低成本方案

> 来源：B站 "50块钱手搓拓竹 AMS"

**材料清单（约 ¥50）：**
| 材料 | 价格 |
|---|---|
| MG90s 舵机 × 2 | ¥20 |
| 3D 打印支架 | 自打印 |
| 杜邦线 | ¥5 |
| 螺丝/螺母 | ¥5 |
| 12V 电源（或用主板供电）| 已有机型 |
| **合计** | **约 ¥30-50** |

**原理：**
- 舵机驱动推料机构
- Klipper 宏控制换料时序
- 和 ERCF 原理类似，但更简单

---

## 八、多色打印 BOM 预算

| 方案 | 预算 | 色数 | 备注 |
|---|---|---|---|
| 手动换料 | ¥0 | 无限 | 人在场 |
| DIY AMS（舵机版）| ¥50 | 2-4色 | 低成本 |
| ERCF | ¥300-500 | 2-8色 | 需3D打印 |
| ToolChanger | ¥2000+ | 4-8色 | 最完美 |

---

## 九、相关视频教程

| 标题 | 平台 | 内容 |
|---|---|---|
| 【教程】如何打造一台多色3D打印机 | B站 | 多色方案全讲解 |
| Voron2.4 从零开始组装还可多色打印 | B站 | 改装实录 |
| ERCF 多色打印 | B站 | ERCF 改装 |
| 50块钱手搓拓竹 AMS | B站 | DIY AMS |
| 多色打印对比 X1 vs XL | B站 | AMS vs Toolchanger |
| 大鱼TT 三叉戟改装 | B站 | 三叉戟+多色 |

---

## 十、推荐路线图

**入门（¥0）：**
手动换料 → 先体验多色效果

**进阶（¥50-500）：**
DIY AMS 或 ERCF → 自动换料，支持 2-8 色

**终极（¥2000+）：**
ToolChanger → 全自动多喷嘴，无废料

---

## 十一、相关资源链接

| 资源 | 链接 |
|---|---|
| ERCF 开源项目 | https://github.com/EtteGit/EnragedRabbitProject |
| MOZHU-AMS | https://gitee.com/XLmozhu/mozhu-ams |
| Voron ToolChanger | Voron 官方 GitHub |
| OrcaSlicer 多色教程 | B站/抖音 OrcaSlicer 专区 |
| Bambu Lab Wiki 多色 | wiki.bambulab.com |
