arbaleast/dayu-tt-all-in-one/docs/MECHANICAL/31_42闭环电机改装实战采购指南.md

# 大鱼TT 42闭环电机改装 — 实战采购与安装指南

> 更新时间：2026-03-24
> 配套文档：`docs/01-封箱方案/42闭环电机/`（详细原理与配置）
> 来源：大鱼TT改装实战 + 项目内已有资料

---

## 一、采购清单

### 1.1 电机选型对比

| 型号 | 相数 | 步距角 | 扭矩 | 电流 | 价格 | 推荐度 |
|---|---|---|---|---|---|---|
| **S42B V2.0** | 2 | 1.8° | ≥0.45N·m | 1.2A | ¥80-120 | ⭐⭐⭐⭐⭐ |
| **SERVO42C** | 2 | 1.8° | ≥0.45N·m | 1.8A | ¥70-100 | ⭐⭐⭐⭐ |

> 建议购买渠道：淘宝认证店 / 闲鱼（有实测反馈）

### 1.2 完整采购清单（XY 轴改装）

| 配件 | 数量 | 参考价 | 说明 |
|---|---|---|---|
| 42闭环电机（S42B V2.0） | 2 | ¥160-240 | X/Y 轴各一 |
| 电机座 | 2 | ¥20-30 | 铝合金或 3D 打印 |
| 联轴器（5mm×8mm）| 2 | ¥10 | 连接电机轴和皮带轮 |
| GT2 同步轮（16-20齿）| 2 | ¥15 | 6mm 宽度 |
| GT2 皮带 | 1 | ¥10 | 根据框架尺寸裁剪 |
| 螺丝套装（M3/M4）| 1 | ¥15 | 包含螺丝+螺母+垫片 |

### 1.3 改装 BOM 总计

```
闭环改装（XY轴）预算：¥215-315

配件：
- 42闭环电机 × 2 ............. ¥160-240
- 电机座 × 2 ................ ¥20-30
- 联轴器 × 2 ................. ¥10
- GT2 同步轮 × 2 .............. ¥15
- GT2 皮带 × 1 ................ ¥10
- 螺丝套装 × 1 ............... ¥15
─────────────────────────────
合计：¥210-315
```

---

## 二、安装步骤

### 2.1 准备工具

| 工具 | 用途 |
|---|---|
| 内六角扳手套装 | 螺丝拆卸 |
| 尖嘴钳 | 拉扣螺母 |
| 螺丝刀 | 接线端子 |
| 万用表 | 检测电机接线 |
| 焊接工具（可选）| 接线 |

### 2.2 拆卸原步进电机

1. **断电** — 关闭打印机电源
2. **记录接线** — 拍照记录原电机线序（A+/A-/B+/B-）
3. **拆卸固定螺丝** — 通常 4 颗 M3 螺丝
4. **移除电机** — 小心皮带不要崩飞

### 2.3 安装闭环电机

**步骤：**
1. 安装电机座到原位置
2. 固定闭环电机（注意方向，轴朝向皮带轮）
3. 安装同步轮到电机轴（使用联轴器过渡）
4. 挂上 GT2 皮带，调整张紧
5. 接线（参照原线序）

### 2.4 接线方式

**两相四线电机接线：**
```
电机线圈 A 相：红线 + 白线
电机线圈 B 相：绿线 + 黑线

接驱动板：
  A+ → 红线
  A- → 白线
  B+ → 绿线
  B- → 黑线
```

> ⚠️ 如果方向相反，交换 A+ 和 A-（或 B+ 和 B-）

---

## 三、Klipper 配置

> 详细配置参考：`docs/01-封箱方案/42闭环电机/42闭环步进电机改装指南.md`

### 3.1 基本配置

```ini
[stepper_x]
step_pin: PF0
dir_pin: PF1
enable_pin: !PD0
microsteps: 16
rotation_distance: 40
full_steps_per_rotation: 200
# 42闭环无需改变 full_steps_per_rotation
```

### 3.2 驱动电流调整

闭环电机电流通常 1.2A，修改 `printer.cfg`：

```ini
[stepper_x]
driver_TMC2209: ...
run_current: 1.0  # 根据电机规格调整，S42B V2.0 建议 1.0A
hold_current: 0.5
```

---

## 四、改装效果对比

| 项目 | 原步进电机 | 42闭环电机 |
|---|---|---|
| 噪音 | 明显 | 明显降低（静音）|
| 精度 | 一般 | 高（闭环控制，不丢步）|
| 发热 | 中等 | 略高（但可接受）|
| 成本 | 低 | +¥200 |

> 来源：实际用户反馈，大鱼 TT 更换雷赛闭环后，声音明显减小（视频为原声）

---

## 五、改装注意事项

### ⚠️ 重点提醒

1. **先测试再安装** — 单独测试电机转一圈，确认方向和电流
2. **注意轴径匹配** — 电机轴 5mm，同步轮内径要匹配 5mm
3. **皮带张紧适度** — 太紧增加电机负担，太松会跳齿
4. **散热注意** — 闭环电机发热略大，确保通风
5. **Z 轴一般不需要改** — Z 轴负载小，原步进够用

### ❌ 常见错误

- 接线顺序错误导致电机抖动 → 交换 A/B 相
- 皮带张紧不够 → 打印出现缺线
- 电流设置过大 → 电机发热严重

---

## 六、改装案例参考

| 案例 | 来源 | 内容 |
|---|---|---|
| 大鱼TT改装实战 | 项目内 docs | 详细改装步骤 |
| 雷赛闭环替换 | B站视频 | 更换后对比（视频原声）|
| S42B V2.0 详细资料 | 项目内 docs | 产品规格书 |

---

## 七、相关视频

| 标题 | BV号 | 内容 |
|---|---|---|
| 大鱼TT改装实战 | 项目已有 | 详细改装步骤 |
| 大鱼TT更换雷赛电机 | - | 静音效果对比 |
| 42闭环改装指南 | - | 接线与配置 |
