arbaleast/dayu-tt-all-in-one/docs/MECHANICAL/37_切片机配置完全指南.md

# 大鱼TT 切片机配置完全指南（PrusaSlicer / OrcaSlicer）

> 更新时间：2026-03-24
> 适用：大鱼TT / CoreXY 结构打印机
> 推荐切片软件：OrcaSlicer（免费、功能强）或 PrusaSlicer

---

## 一、切片软件选型

| 软件 | 费用 | 特点 | 推荐度 |
|---|---|---|---|
| **OrcaSlicer** | 免费开源 | 社区活跃，功能全面，支持 Bambu 格式 | ⭐⭐⭐⭐⭐ |
| **PrusaSlicer** | 免费开源 | 经典稳定，算法成熟 | ⭐⭐⭐⭐ |
| **SuperSlicer** | 免费开源 | PrusaSlicer 分支，参数更细 | ⭐⭐⭐⭐ |
| **Bambu Studio** | 免费 | 界面好，但对非 Bambu 机器优化一般 | ⭐⭐⭐ |

> 💡 **推荐 OrcaSlicer**，社区针对大鱼TT 有专门的配置帖子

---

## 二、大鱼TT 基础打印机参数

### 2.1 机器参数

| 参数 | 值 |
|---|-----|
| 结构 | CoreXY |
| 打印尺寸 | 235×235mm / 310×310mm |
| 热床尺寸 | 235×235mm（M6螺丝）/ 310×310mm（M8螺丝）|
| Z 轴 | 单轴 或 三轴（改装后）|
| 喷嘴直径 | 0.4mm（默认）|
| 最大加热温度 | 热端 300°C / 热床 120°C |

### 2.2 关键切片设置

```
打印机 → 机器设置：
- 床尺寸 X: 235 / Y: 235
- 打印高度: 250 / 310
- 起点 X: 0 / Y: 0
- 起点 Z: 0
- 喷嘴直径: 0.4
- 挤出头数: 1（单头）/ 2-4（多色改装后）
```

---

## 三、OrcaSlicer 打印机配置步骤

### 3.1 新建打印机

1. 打开 OrcaSlicer → 打印机 → 添加打印机
2. 选择 **Custom printer**（自定义打印机）
3. 命名：`大鱼TT-235` 或 `大鱼TT-310`

### 3.2 机器设置参数

**运动设置：**
```ini
- 旅行速度: 150 mm/s
- 打印速度参考值: 60 mm/s
```

**归位顺序：**
```ini
- X/Y归位: 左后角（min_x, min_y）
- Z归位: 顶部（max_z）
```

**搭梯：**
```ini
- 启用: 是
- 宽度: 3 mm
- 高度: 1 mm
```

---

## 四、耗材切片参数

### 4.1 PLA

| 设置 | 推荐值 |
|---|---|
| 喷嘴温度 | 200-215°C |
| 热床温度 | 50-60°C |
| 打印速度 | 50-80 mm/s |
| 冷却风扇 | 100%（第二层起）|
| 收缩补偿 | ~0.4%（XY）/ ~0.2%（Z）|
| 回抽 | 0.8-1.2mm（Bowden）/ 0.4-0.8mm（近程）|

### 4.2 PETG

| 设置 | 推荐值 |
|---|---|
| 喷嘴温度 | 240-260°C |
| 热床温度 | 70-80°C |
| 打印速度 | 40-60 mm/s |
| 冷却风扇 | 30-50%（多层后逐步增加）|
| 回抽 | 3-5mm（Bowden）|
| 收缩补偿 | ~0.3%（XY）/ ~0.1%（Z）|

### 4.3 ABS

| 设置 | 推荐值 |
|---|---|
| 喷嘴温度 | 250-270°C |
| 热床温度 | 100-110°C |
| 打印速度 | 50-80 mm/s |
| 腔体温度 | 45-60°C（封箱后）|
| 冷却风扇 | 0%（前几层）→ 20%（后期）|
| 回抽 | 2-4mm |
| 收缩补偿 | ~0.5%（XY）/ ~0.4%（Z）|

### 4.4 TPU（柔性耗材）

| 设置 | 推荐值 |
|---|---|
| 喷嘴温度 | 220-250°C |
| 热床温度 | 50-60°C |
| 打印速度 | 15-30 mm/s（慢速）|
| 冷却风扇 | 50-100% |
| 回抽 | 0.2-0.5mm（关闭回抽更好）|
| 层高 | 0.16-0.24mm |

---

## 五、速度与加速度参数（Klipper 优化）

### 5.1 OrcaSlicer 内核速度设置

```ini
[速度]
默认打印速度: 60 mm/s
默认移动速度: 150 mm/s
默认归位速度: 20 mm/s
Z抬升速度: 12 mm/s

[加速度]
默认打印加速度: 1500 mm/s²
默认旅行加速度: 3000 mm/s²
默认归位加速度: 1000 mm/s²

# 大鱼TT 建议加速度（带 Klipper）：
- 打印: 1500-2500 mm/s²
- 空程: 3000-4000 mm/s²
- 归位: 1000 mm/s²
```

### 5.2 针对高速打印的 OrcaSlicer 技巧

> 来源：B站 `OrcaSlicer 十大问题 偏好设置`

1. **"按层高度重新分段"** 不要随意勾选，会影响打印质量
2. **间隙填充** 启用，减少缩水痕
3. **压力平滑** 启用，Klipper 机器推荐

---

## 六、支撑与悬空结构

### 6.1 支撑设置

```ini
支撑类型:
- 自动: Tree（树形支撑），对复杂模型更好
- 手动: 画笔工具精确定位

支撑密度: 10-15%
支撑界面密度: 20-30%
支撑与模型间距: 0.2mm
```

### 6.2 悬空角度

```ini
- 悬空角度阈值: 50-55°（大于此角度自动加支撑）
- 顶层悬空: 使用更多底部层
```

---

## 七、网床补偿与首层

### 7.1 首层设置

```ini
首层:
- 打印速度: 50% 正常速度
- 首层高度: 0.2mm（或者层高的 200%）
- 首层收缩补偿: 是

热床粘附:
- 类型:  Brim（边缘）
- Brim 宽度: 5-8mm（ABS建议8mm）
- Raft: 仅大面积/ABS/ASA 使用
```

### 7.2 Klipper 网床补偿集成

在 OrcaSlicer 中：
- 切片时选择 **"使用网床补偿"**
- OrcaSlicer 会读取 `printer.cfg` 中的 `[bed_mesh]` 配置
- 确保 Klipper 已运行 `BED_MESH_CALIBRATE`

---

## 八、常用宏命令（Klipper 配合）

```ini
# OrcaSlicer / PrusaSlicer 切片时可选的 Klipper 宏：

[respond]
```

在 OrcaSlicer 的 **输出选项** 中可添加：

```gcode
# 打印开始
M104 S{first_layer_temperature[0]}
M140 S{first_layer_bed_temperature[0]}
M109 S{first_layer_temperature[0]}
M190 S{first_layer_bed_temperature[0]}
G28 ; 归位
```

---

## 九、OrcaSlicer 十大技巧

> 来源：B站 `3D打印从菜鸟到专家 OrcaSlicer十大问题`

1. **"按层高度重新分段"** 不要勾选，会影响精度
2. **"间隙填充"** 建议开启，减少缩水痕
3. **压力平滑** 对 Klipper 机器很有用
4. **多色打印** OrcaSlicer 支持 Bambu AMS 格式
5. **有机支撑** 树形支撑比柱形更好用
6. **减少过挤** PLA 建议 -1% to -2%
7. **回抽优化** 近程挤出建议关闭或极小值
8. **封口层** 底部封口层数影响底板强度
9. **网床导入** OrcaSlicer 支持 Klipper 网床数据
10. **自定义 Gcode** 善用切片后处理脚本

---

## 十、大鱼DIY 官方 OrcaSlicer 配置

GitHub: https://github.com/DayuDIY/Xuanwu

大鱼DIY 官方维护的 Xuanwu（大鱼）项目包含 OrcaSlicer 配置：

- 官方推荐的打印机参数
- 针对不同耗材的预设
- 大鱼 TT 打印校准文件

---

## 十一、相关视频教程

| 标题 | 平台 | 内容 |
|---|---|---|
| 大鱼TT OrcaSlicer 多色设置 | B站/抖音 | 多色打印配置 |
| OrcaSlicer 速度优化 | 抖音 | 速度与加速度设置 |
| 3D打印从菜鸟到专家 OrcaSlicer十大问题 | 抖音 | 常见问题与技巧 |
| OrcaSlicer 配置教程 | B站 | 大鱼TT适用配置 |
