arbaleast/dayu-tt-all-in-one/docs/MECHANICAL/41_皮带张紧器STL模型合集.md

# 大鱼TT 皮带张紧器 & 实用 STL 模型合集

> 更新时间：2026-03-24
> 适用：大鱼TT / CoreXY 结构 3D 打印机

---

## 一、皮带张紧器的重要性

皮带张紧不够会导致：
- **跳齿**：打印出现缺线、层纹
- **丢步**：打印尺寸偏小
- **噪音**：皮带抖动产生异响

皮带张紧合适的标准：
> "皮带只需要在打印的时候不发生跳动即为合格"

---

## 二、皮带张紧器方案

### 方案一：大鱼TT CNC 张紧器（推荐）

**来源：** B站 `大鱼TT张紧器CNC 开源`（文章）

**下载地址：** https://www.123pan.com/s/aXdcVv-Uhy9A.html

**特点：**
- CNC 加工，精度高
- 铝合金材质，耐用
- 适配大鱼 TT 原版框架

### 方案二：Voron 风格皮带张紧器（通用）

大鱼 TT 可以直接用 Voron 0 / Trident 的张紧器设计。

**STL 下载：**
| 来源 | 链接 |
|---|---|
| MakerWorld | 搜索 "Voron belt tensioner" |
| Printables | https://www.printables.com/model/ |
| Thingiverse | https://www.thingiverse.com/（搜索 Voron belt tensioner）|

**设计参考：** Voron 官方 GitHub
- https://github.com/VoronDesign/Voron-0
- https://github.com/VoronDesign/Voron-Trident

### 方案三：3D 打印版张紧器

适合不想 CNC 加工的玩家，直接打印安装。

**打印参数：**
```ini
材料: PETG 或 ABS（推荐 ABS，更耐磨）
填充: 50-80%
层高: 0.2mm
壁厚: 3-4层
```

---

## 三、皮带张紧调节技巧

### 3.1 判断张紧程度

**方法一：** 用手指按压皮带中间
- 正常：下沉 1-2mm
- 太松：下沉 > 3mm，容易跳齿
- 太紧：几乎不下沉，加速轴承磨损

**方法二：** 听声音
- 张紧合适：打印时机箱安静
- 太松：打印时有"嗒嗒"声
- 太紧：有机率崩齿

### 3.2 调节步骤

1. 先松开张紧轮固定螺丝
2. 调整张紧螺丝（或弹簧）
3. 边调边按压测试，找到最佳点
4. 锁紧固定螺丝
5. 打印测试件验证

---

## 四、大鱼TT 相关 STL 模型资源

### 4.1 MakerWorld 大鱼TT 专区

| 模型 | 链接 | 说明 |
|---|---|---|
| 大鱼TT 重制版XY结构件 | makerworld.com.cn/zh/models/1586964 | 双边固定+F695轴承 |
| 大鱼TT 双传感器切刀 | makerworld.com.cn/zh/models/712626 | 双切刀方案 |
| 大鱼TT Klicky CNC 支架 | makerworld（搜索） | Klicky 探针支架 |

### 4.2 打印派

| 模型 | 链接 |
|---|---|
| 皮带张紧器 | dayinpai.com（搜索"大鱼TT 张紧器"）|

### 4.3 大鱼TT 改装参考

**来源：** B站 `大鱼TT结构件升级改造`（BV1Lz421C7Q4）
> 升级改造文件下载: https://pan.baidu.com/s/1XFtLjszJ_UFtajT_S0P6eA 提取码: d3ej

---

## 五、其他实用 STL 模型推荐

### 5.1 Klicky 相关

| 模型 | 来源 | 说明 |
|---|---|---|
| Klicky 探针 + 停靠坞 | GitHub tanaes/whopping_Voron_mods | PCB Klicky 方案 |
| Klicky CNC 支架 | MakerWorld | 大鱼TT 专用 |

### 5.2 工具类

| 模型 | 用途 |
|---|---|
| Filament 切刀 | 线材裁剪 |
| 线材支架 | 放线轴 |
| 工具盒 | 放小零件 |
| 手机/平板支架 | 监控打印机 |

### 5.3 线盘悬挂支架

> 来源：B站 大鱼TT 装机分享

---

## 六、皮带选购指南

| 参数 | 大鱼TT 规格 |
|---|---|
| 型号 | 2GT（2mm 齿距）|
| 宽度 | 6mm（XY 轴）|
| 长度 | 根据框架尺寸计算 |

**计算公式：**
```
皮带长度 ≈ 2 × (框架宽度 + 框架高度) + 10mm（余量）
```

**购买建议：**
- 选 **进口品牌**（ Gates 、Megadyne ）更耐用
- 国产性价比高（ process 、 CHC ）

---

## 七、大鱼TT 张紧器改装案例

### 7.1 Voron 皮带张紧器移植

来源：B站 `大鱼TT 改装` 系列

**步骤：**
1. 打印 Voron 0 张紧器支架
2. 购买 GT2 6mm 皮带轮（16-20齿）
3. 替换原版惰轮
4. 调节张紧螺丝

### 7.2 CNC 铝合金张紧器

**优点：**
- 更精确的张紧调节
- 免工具调节设计
- 颜值更高

**获取方式：**
- 购买淘宝 CNC 加工
- 群友共享加工件

---

## 八、相关视频教程

| 标题 | BV号 | 内容 |
|---|---|---|
| 大鱼TT张紧器CNC开源 | - | CNC加工版张紧器 |
| 大鱼TT结构件升级改造 | BV1Lz421C7Q4 | 结构件升级+张紧 |
| 大鱼TT装机经验及皮带张紧器设计分享 | - | 实战经验 |
