arbaleast/dayu-tt-all-in-one/docs/MECHANICAL/36_三叉戟Trident改装指南.md

# 大鱼TT → Voron Trident 改装指南

> 更新时间：2026-03-24
> 改装难度：⭐⭐⭐⭐（较复杂）
> 改装收益：支持多色打印、结构更稳固

---

## 一、什么是三叉戟（Trident）？

**Voron Trident** 是 Voron 0 的放大版，特点：
- **3Z 轴**（三根丝杆同步），打印更稳定
- 比 Voron 2.4 更容易组装
- 稳定性好、可靠性高
- 支持多色打印（升级到 4 色）

> 大鱼 TT 改装三叉戟 = 把原本的单 Z 轴改成三 Z 轴 + 换工具头

---

## 二、改三叉戟的好处

| 优点 | 说明 |
|---|---|
| 🔧 更稳定 | 三根丝杆同步，Z 轴抖动更小 |
| 🎨 多色打印 | 升级到 2-4 色 AMS/eratank 方案 |
| ⚡ 更快 | 三轴同步升降，减少等待时间 |
| 🔇 更静音 | 丝杆润滑后比原版更顺滑 |

---

## 三、改装方案对比

### 3.1 方案一：完整三叉戟套件

直接买 Voron Trident 套件移植到大鱼 TT 框架上。

| 配件 | 说明 |
|---|---|
| Trident Z 轴套件 | 3 根丝杆 + 3 个电机 + 连接件 |
| Voron 工具头 | 三叉戟专用工具头 |
| 同步带轮 | 3GT 规格 |

### 3.2 方案二：SB 头 + 三轴连接（推荐）

在原有大鱼 TT 基础上，改装关键部分：

| 配件 | 说明 |
|---|---|
| SB 挤出头 | 近程挤出，减少堵料 |
| 三轴连接件 | 3D 打印或 CNC 加工 |
| 皮带张紧器 | 参考 Voron 设计 |

> 来源：B站 `大鱼tt？三叉戟？算了，终于动起来了`（BV1tt421G7Fy）
> 案例：310mm 行程，打印高度 260mm，打印面积反而更大

---

## 四、大鱼CC 改装参考

**来源：** B站 `大鱼CC 四叉戟`（BV1x44y1T7Bq）

大鱼 CC 是大鱼 TT 的改装版本，核心改动：

```
改装清单：
- 310mm 行程（加大）
- 小政K6 主板
- FLY MiniPad 上位机
- FLY SB2040 CAN 板
- 雷赛电机（静音）
- 三叉戟布局（三轴连接 + SB 头）
- 碳纤维 X 轴
```

**改装费用参考：** ¥1700 左右，耗时 2-3 周

---

## 五、大鱼TT 改装步骤（简化版）

### 第一步：改 X 轴

1. 换碳纤维 X 轴（更轻、更稳）
2. 安装 SB 挤出头
3. 布线走 CAN 总线

### 第二步：改 Z 轴

1. 安装三轴连接件（原 TT 框架需扩孔）
2. 安装 3 根 8mm 丝杆
3. 同步带轮连接

### 第三步：固件配置

更新 printer.cfg：

```ini
# 三 Z 轴配置
[stepper_z]
step_pin: PC6
dir_pin: PA14
enable_pin: !PA15
rotation_distance: 8

[stepper_z1]
step_pin: ...  # 第二Z轴
...

[stepper_z2]
step_pin: ...  # 第三Z轴
...
```

### 第四步：Klipper 调平

```bash
# 三轴独立调平
Z_ENDSTOP_CALIBRATE

# 网床校准
BED_MESH_CALIBRATE

# 共振测试
RESONANCES AXIS=Y
```

---

## 六、多色打印方案

### 6.1 EruaTanK / AMIS 方案

适合 Voron Trident，可装 2-4 色耗材。

| 方案 | 色数 | 复杂度 |
|---|---|---|
| EruaTanK | 2 色 | ⭐⭐ |
| AMIS | 4 色 | ⭐⭐⭐ |
| Voron Afterburner + MMU | 5 色 | ⭐⭐⭐⭐ |

### 6.2 大鱼TT 三叉戟 多色案例

**BV1tt421G7Fy 案例：**
- 三叉戟布局
- SB 头近程挤出
- CAN 总线 SB2040
- 可加装多色切换器

---

## 七、改装 BOM 参考

| 配件 | 数量 | 单价 | 说明 |
|---|---|---|---|
| 8mm 丝杆 | 3 | ¥15-25 | T8 丝杆 |
| 8mm 铜螺母 | 3 | ¥5-8 | T8 铜螺母 |
| 同步带轮 3GT | 3 | ¥20-30 | 16齿或20齿 |
| 3GT 同步带 | 1 | ¥30-50 | 长度根据框架 |
| 雷赛闭环电机 | 3 | ¥80-120 | 可选闭环 |
| SB 挤出头 | 1 | ¥60-100 | 近程挤出 |
| 三轴连接件 | 3D打印 | - | 参考 MakerWorld |
| CAN 总线 SB2040 | 1 | ¥100-150 | 工具板 |

---

## 八、关键视频教程

| 标题 | BV号 |
|---|---|
| 大鱼tt？三叉戟？终于动起来了 | BV1tt421G7Fy |
| 大鱼TT改voron三叉戟 | BV18B421r7f3 |
| 大鱼CC四叉戟调试完毕 | BV1x44y1T7Bq |
| 大鱼CC 3D打印机改装CAN板碳纤维X轴 | - |

---

## 九、注意事项

⚠️ **框架尺寸改动注意**
- 改了铝型材尺寸会影响打印面积和高度
- 案例：310行程方案打印高度只剩260mm
- 建议先不改框架，只改 Z 轴传动

⚠️ **CAN 总线优先**
- 改装后设备多，CAN 总线能大幅简化接线
- 强烈建议同时升级 SB2040 CAN 板

⚠️ **固件调试复杂**
- 三轴同步需要单独调参
- 建议有 Klipper 经验后再尝试
