arbaleast/dayu-tt-all-in-one/docs/MECHANICAL/01_硬件升级方案.md

# 大鱼TT 硬件升级方案

## 一、挤出机升级

### 1.1 泰坦挤出机 (Titan Extruder)
- **减速比**: 3:1
- **优点**: 提升送料精度，减少滑丝
- **适用**: 远程送料系统
- **价格参考**: ¥50-100

### 1.2 拓竹挤出机 2.0
- **特点**: 高性能，支持高速打印
- **兼容性**: 需要配合特定热端使用
- **价格参考**: ¥80-120

### 1.3 近程改远程方案
- **配置**: 配合 E3D V6 远程喷头
- **优势**: 减少喷头重量，提升打印速度
- **注意**: 需要重新校准回抽参数

---

## 二、Voron 打印头改装方案

Voron 社区有很多优秀的打印头设计，可以大幅改善大鱼TT的散热性能、外观和功能性。

### 2.1 Stealthburner 隐形推进器

**简介**: Voron 2.4 的默认打印头，集成度高，外观科技感强。

**主要特点**:
- **挤出机**: 内置 Clockwork 2 (CW2) 或 LGX Lite 挤出机
- **热端支持**: E3D V6、Dragon、Rapido、Revo 等多种热端
- **冷却**: 双 4010 风扇 (热端散热 + 模型冷却)
- **LED 集成**: 支持 Neopixel RGB LED
- **Klicky/TAP 兼容**: 内置探针安装位

**适配要点**:
- 需要重新设计或寻找适配大鱼 TT X 轴滑车的安装支架
- 注意总重量增加可能影响加速度设置
- 建议配合 24V 系统使用

**配件清单**:
| 配件 | 规格 | 参考价格 |
|---|---|---|
| Stealthburner 主体 | 3D 打印件 | - |
| Clockwork 2 套件 | 齿轮+轴承+轴 | ¥30-50 |
| 4010 风扇 x2 | 24V | ¥20-40 |
| 热端 | E3D V6/Dragon | ¥50-150 |
| Neopixel LED (可选) | 5V WS2812B | ¥10-20 |

**推荐程度**: ⭐⭐⭐⭐⭐ (性能与颜值兼顾)

### 2.2 Mini Afterburner 迷你后燃器

**简介**: Voron Trident 和 0.2 使用的轻量化打印头，结构紧凑。

**主要特点**:
- **体积小巧**: 比 Stealthburner 更轻
- **挤出机**: LGX Lite 或 齿轮挤出机
- **适合**: 对重量敏感的高速打印
- **维护方便**: 模块化设计

**适配要点**:
- 需要确认 X 轴滑车安装孔位
- 可能需要调整 Y 轴限位位置
- 更适合近程挤出系统

**配件清单**:
| 配件 | 规格 | 参考价格 |
|---|---|---|
| Mini AB 主体 | 3D 打印件 | - |
| LGX Lite 挤出机 | 轻量版 | ¥80-150 |
| 3010 风扇 | 24V | ¥15-25 |
| 热端 | V6/Dragon | ¥50-150 |

**推荐程度**: ⭐⭐⭐⭐ (轻量化首选)

### 2.3 打印头适配注意事项

**结构适配**:
- **X 轴滑车**: 需要打印或购买 Voron 打印头适配支架
- **皮带固定**: 可能需要调整同步带走向
- **线材管理**: 建议使用拖链或线材固定器

**电气适配**:
- **风扇电压**: Voron 通常使用 24V，确保主板支持或添加降压模块
- **LED 灯带**: 如需 RGB 灯效，需要主板支持 5V 输出
- **热端**: 确认加热棒电压 (24V 更常见)

**固件配置**:
```ini
# Klipper 挤出机配置示例
[extruder]
step_pin: P2.3
dir_pin: P2.0
enable_pin: !P0.21
microsteps: 16
rotation_distance: 22.678  # CW2 需调整为约 47.7
gear_ratio: 50:10           # CW2 齿轮比 5:1
nozzle_diameter: 0.400
filament_diameter: 1.750
heater_pin: P2.7
sensor_type: Generic 3950
sensor_pin: P0.24
control: pid
pid_Kp: 22.2
pid_Ki: 1.08
pid_Kd: 114
min_temp: 0
max_temp: 300
max_extrude_only_distance: 100.0
max_extrude_cross_section: 5
pressure_advance: 0.04
pressure_advance_smooth_time: 0.040
```

**下载资源**:
- Stealthburner GitHub: https://github.com/VoronDesign/Voron-Stealthburner
- Voron 官方: https://vorondesign.com/
- 打印文件: Thingiverse/Printables 搜索 "Stealthburner"

---

## 三、自动调平系统

### 2.1 Klicky Probe 磁性探针
**硬件组成：**
- 微动开关 (欧姆龙或国产替代品)
- 钕铁硼磁铁 (6x3mm)
- 3D打印探针座
- 杜邦线材

**安装要点：**
- 探针需要可拆卸设计
- 磁铁极性要统一
- 开关触发高度需精确校准

**价格参考**: ¥15-30

### 2.2 TAP 喷嘴探针
- **原理**: 使用喷嘴本身作为探针
- **优势**: 无探针偏移，永远精确
- **要求**: 需要特定主板支持

### 2.3 接近开关
- **规格**: 24V NPN 常闭型
- **感应距离**: 4-8mm
- **注意**: 确保主板支持24V输入或使用电平转换

---

## 三、主板升级方案

### 3.1 GEMINI / JOKER 主板
- **说明**: 大鱼官方主板，原名GEMINI后改名为JOKER
- **特点**: 专为CoreXY优化
- **驱动**: 支持TMC2209等静音驱动

### 3.2 BIGTREETECH Octopus 八爪鱼
- **驱动口**: 8路步进电机驱动
- **优势**: 
  - 支持多Z轴调平
  - 支持多挤出机
  - 丰富的扩展接口
- **价格**: ¥200-300

### 3.3 MKS 系列主板
- **选择**: Robin Nano、Monster8等
- **优势**: 性价比高，社区支持好

---

## 四、热床改进

### 4.1 PEI 平台升级
- **类型**: 弹簧钢板 + PEI涂层
- **优势**: 
  - 附着力好
  - 冷却后模型自动脱落
  - 耐磨损
- **价格**: ¥50-100

### 4.2 热床加固
- **偏心螺母升级**: 换成铜质或不锈钢偏心螺母
- **优势**: 减少热床晃动，提升首层质量

### 4.3 大功率热床 (24V)
- **注意**: 原装电源可能无法支持
- **建议**: 如需升级热床，先升级电源至24V

---

## 五、冷却系统

### 5.1 风扇升级
- **品牌推荐**: 黑爵 (Black Jack)、台达
- **规格**: 4010/4020 12V/24V
- **注意**: 注意电压匹配主板

### 5.2 风道优化
- **下载**: 可在Thingiverse或Printables搜索 "BigFish TT"
- **材料**: 建议使用PETG或ABS打印
- **类型**: 
  - 环形风道 (360°冷却)
  - 单向风道 (针对特定模型)

### 5.3 喷头散热
- **加热棒**: 40W/24V
- **散热片**: 铜质散热片优于铝质
- **导热硅脂**: 定期更换

---

## 六、框架与结构改进

### 6.1 全包亚克力外壳
- **功能**: 
  - 保温 (打印ABS/ASA必需)
  - 防尘
  - 降噪
- **材料**: 3-5mm亚克力板
- **价格**: ¥100-200

### 6.2 Z轴加固
- **方案**: 加装Z轴支撑杆或改成双Z
- **效果**: 减少层纹，提升Z轴精度

### 6.3 限位开关升级
- **推荐**: 金属弹跳开关替换塑料开关
- **优势**: 寿命更长，触发更稳定

---

## 七、舵机应用

### 7.1 Klicky探针用舵机
- **推荐型号**: MG90s、SG90
- **电压**: 5V (注意主板5V输出能力)
- **扭矩**: 1.5-2.5kg/cm 足够

### 7.2 注意事项
- ❌ **避免使用 MG996**: 电流过大，可能导致主板重启
- ✅ **检查主板5V输出**: 确保能支持舵机工作电流

---

## 八、电源升级

### 8.1 24V电源升级
- **适用场景**: 
  - 更换大功率热床
  - 升级大功率挤出机
- **推荐功率**: 350W-500W
- **品牌**: 明纬、黑金刚

### 8.2 电源接线
- **注意**: 12V和24V设备不能混接
- **建议**: 升级电源时同步升级加热棒、风扇等12V设备

---

*最后更新: 2026-03-21*
