arbaleast/dayu-tt-all-in-one/docs/MECHANICAL/02_软件固件配置.md

# 大鱼TT 软件与固件配置

## 一、固件选择

### 1.1 Klipper (强烈推荐)

**为什么选择Klipper：**
- 输入整形 (Input Shaping) - 消除共振，提升速度
- 网床补偿 (Bed Mesh) - 完美首层
- 压力提前 (Pressure Advance) - 消除边角 blob
- 远程控制 - 通过网页界面操作
- 配置简单 - 修改配置只需重启，无需重新刷固件

**硬件要求：**
- 上位机: 树莓派/香橙派/旧笔记本等
- 下位机: 原装主板即可

### 1.2 Marlin
- 原厂固件，稳定
- 无需上位机
- 配置修改需要重新编译刷写

---

## 二、Klipper 配置要点

### 2.1 基础配置 (printer.cfg)

```ini
[mcu]
serial: /dev/serial/by-id/usb-Klipper_lpc1768_...  # 根据实际修改

[printer]
kinematics: corexy
max_velocity: 300
max_accel: 3000
max_z_velocity: 25
max_z_accel: 100

[stepper_x]
step_pin: P2.2
dir_pin: P2.6
enable_pin: !P2.1
microsteps: 16
rotation_distance: 40
endstop_pin: ^P1.29
position_endstop: 0
position_max: 250
homing_speed: 50

[stepper_y]
... # 类似X轴配置

[stepper_z]
... # Z轴配置

[extruder]
step_pin: P2.3
dir_pin: P2.0
enable_pin: !P0.21
microsteps: 16
rotation_distance: 22.678  # 根据挤出机齿轮比调整
nozzle_diameter: 0.400
filament_diameter: 1.750
heater_pin: P2.7
sensor_type: EPCOS 100K B57560G104F
sensor_pin: P0.24
control: pid
pid_Kp: 22.2
pid_Ki: 1.08
pid_Kd: 114
min_temp: 0
max_temp: 250

[heater_bed]
heater_pin: P2.5
sensor_type: ATC Semitec 104GT-2
sensor_pin: P0.23
control: watermark
min_temp: 0
max_temp: 110
```

### 2.2 Klicky 探针配置

```ini
# Klicky Probe 配置示例
[probe]
pin: ^P1.27  # 根据实际接线修改
x_offset: 0
y_offset: 25.0
z_offset: 6.5  # 需校准
speed: 5.0
samples: 2
sample_retract_dist: 2.0
```

### 2.3 网床补偿配置

```ini
[bed_mesh]
speed: 120
horizontal_move_z: 5
mesh_min: 10,10
mesh_max: 240,240
probe_count: 5,5
algorithm: bicubic
fade_start: 1
fade_end: 10
fade_target: 0
```

### 2.4 输入整形 (Input Shaper)

```ini
[input_shaper]
shaper_freq_x: 60.4  # 需通过测试确定
shaper_freq_y: 45.2
shaper_type: ei
```

**测试命令：**
```
SHAPER_CALIBRATE
```

### 2.5 压力提前 (Pressure Advance)

```ini
[extruder]
# ... 其他配置 ...
pressure_advance: 0.04  # 需校准
pressure_advance_smooth_time: 0.040
```

**校准方法：**
1. 打印压力提前测试模型
2. 观察转角，找到最佳值
3. 或使用命令: `TUNING_TOWER COMMAND=SET_PRESSURE_ADVANCE PARAMETER=ADVANCE START=0 FACTOR=.005`

---

## 三、高级功能配置

### 3.1 自适应网床 (Adaptive Bed Mesh)

```ini
[bed_mesh]
# ... 基础配置 ...
mesh_pps: 2,2
```

### 3.2 智能热床温度

```ini
[heater_bed]
# ... 基础配置 ...
check_gain_time: 120
```

### 3.3 断料检测

```ini
[filament_switch_sensor 断料检测]
pause_on_runout: True
switch_pin: P1.26  # 根据实际接线修改
runout_gcode:
    PAUSE
    M104 S0
    M140 S0
```

---

## 四、Moonraker 配置 (Klipper API)

```ini
[server]
host: 0.0.0.0
port: 7125
enable_debug_logging: False
config_path: ~/printer_data/config
database_path: ~/printer_data/database

[file_manager]
enable_object_processing: True

[machine]
sudo_password: your_password  # 如需关机功能

[authorization]
trusted_clients:
    192.168.1.0/24
cors_domains:
    http://app.fluidd.xyz
    http://my.mainsail.xyz
```

---

## 五、前端界面选择

### 5.1 Fluidd
- 轻量级，响应快
- 界面简洁
- 安装:
```bash
cd ~/printer_data/config
wget -q -O moonraker.conf https://raw.githubusercontent.com/fluidd-core/fluidd/master/moonraker.conf
cd ..
git clone https://github.com/fluidd-core/fluidd.git
```

### 5.2 Mainsail
- 功能丰富
- 主题支持
- 安装:
```bash
cd ~/printer_data/config
wget -q -O moonraker.conf https://raw.githubusercontent.com/mainsail-crew/mainsail/master/moonraker.conf
cd ..
git clone https://github.com/mainsail-crew/mainsail.git
```

---

## 六、切片软件配置

### 6.1 PrusaSlicer / SuperSlicer 推荐设置

**打印机设置:**
- 床尺寸: 250x250x250 (根据实际)
- G-code 风格: Klipper
- 回抽长度: 2-3mm (近程) / 4-6mm (远程)
- 回抽速度: 30-40mm/s

**速度设置:**
- 外围: 60-80mm/s
- 填充: 100-150mm/s
- 空驶: 150-200mm/s

**Klipper 特定起始G-code:**
```gcode
START_PRINT EXTRUDER_TEMP=[first_layer_temperature] BED_TEMP=[first_layer_bed_temperature]
```

**结束G-code:**
```gcode
END_PRINT
```

### 6.2 Cura 配置
- 机器类型: 自定义 FFF
- G-code 风格: Marlin (Cura不原生支持Klipper)
- 在G-code中添加Klipper特定命令

---

## 七、常用Klipper命令

```bash
# 重启Klipper
RESTART

# 固件重启
FIRMWARE_RESTART

# 归位
G28

# 网床补偿
BED_MESH_CALIBRATE
BED_MESH_PROFILE SAVE=default

# 输入整形测试
SHAPER_CALIBRATE

# PID自整定
PID_CALIBRATE HEATER=extruder TARGET=200
PID_CALIBRATE HEATER=heater_bed TARGET=60

# 保存配置
SAVE_CONFIG
```

---

## 八、故障排除

### 8.1 常见问题

| 问题 | 可能原因 | 解决方案 |
|---|---|---|
| 启动报错 "mcu" | 串口配置错误 | 检查 `ls /dev/serial/by-id/` |
| 打印共振 | 输入整形未启用 | 启用并校准 input_shaper |
| 首层不粘 | 网床未校准 | 运行 BED_MESH_CALIBRATE |
| 边角 blob | 压力提前未设置 | 校准 pressure_advance |
| 挤出不足 | 温度过低或回抽过长 | 检查温度和回抽设置 |

---

*最后更新: 2026-03-21*
