arbaleast/dayu-tt-all-in-one/docs/MECHANICAL/16_汪汪队射手方案.md

# 汪汪队射手 - 大鱼TT魔改封箱方案

## 方案概述

UP主：汪汪队射手  
视频发布时间：2023-09-14  
播放量：1.6万+

## 方案特点

### 核心改进

1. **皮带张紧系统** ⭐
   - 外置张紧器设计
   - 无需拆机即可调节
   - 保持皮带张力稳定
   - 提升打印精度

2. **封箱结构优化**
   - 改进的框架设计
   - 更好的保温性能
   - 方便维护的开合结构

3. **ABS打印优化**
   - 封箱后仓温可达40-50°C
   - 有效解决ABS翘边
   - 适合打印工程材料

## 视频教程

| 视频标题 | 发布时间 | 主要内容 |
|---|---|---|
| 大鱼TT魔改+封箱 | 2023-09-14 | 核心教程，整体方案 |
| 大鱼TT皮带张紧器使用教程 | 2025-09-07 | 张紧器详细说明 |
| 大鱼TT日常打印abs视频 | 2025-10-07 | ABS打印效果展示 |

## 材料清单

### 铝型材框架

| 型号 | 规格 | 数量 | 用途 | 参考价格 |
|-----|---|---|---|---|
| 2020铝型材 | 按尺寸切割 | 若干 | 框架主体 | ¥80-120 |
| 2020角码 | 标准件 | 16-20个 | 连接固定 | ¥15-25 |
| M5 T型螺母 | 标准件 | 50-80个 | 配件固定 | ¥10-15 |
| M5×8螺丝 | 标准件 | 50-80个 | 紧固 | ¥5-10 |

### 皮带张紧器零件 ⭐

| 零件 | 规格 | 数量 | 说明 |
|-----|---|---|---|
| 张紧器主体 | 3D打印件 | 2个 | X/Y轴各1 |
| 轴承 | 625ZZ | 4个 | 张紧轮 |
| M3螺丝 | 多种长度 | 若干 | 固定 |
| 弹簧 | 小型 | 2个 | 自动张紧 |
| 调节螺丝 | M3或M4 | 2个 | 手动调节 |

### 板材材料

| 材料 | 规格 | 数量 | 用途 | 参考价格 |
|-----|---|---|---|---|
| 亚克力板透明 | 3-5mm厚 | 3-4张 | 观察窗、门 | ¥80-150 |
| 亚克力板黑色 | 3-5mm厚 | 2-3张 | 侧板、顶板 | ¥60-100 |
| 保温棉 | 10-20mm厚 | 适量 | 保温层 | ¥20-40 |

### 门和开合结构

| 零件 | 规格 | 数量 | 参考价格 |
|-----|---|---|---|
| 磁吸条 | 10×3mm | 2米 | 门密封 |
| 合页/铰链 | 小型 | 2-4个 | 门连接 |
| 门把手 | 小型 | 1-2个 | ¥5-10 |
| 密封条 | 海绵或橡胶 | 2-3米 | 密封保温 |

### 通风过滤系统（可选）

| 零件 | 规格 | 数量 | 参考价格 |
|-----|---|---|---|
| 4010/4020风扇 | 12V/24V | 1-2个 | ¥15-30 |
| 活性炭过滤棉 | 专用 | 适量 | ¥20-30 |
| 风扇罩 | 3D打印 | 1-2个 | - |
| 风道管 | 50-60mm | 1-2米 | ¥10-20 |

### 其他配件

| 零件 | 用途 | 参考价格 |
|-----|---|---|
| LED灯条 | 照明 | ¥15-30 |
| 线槽/理线器 | 走线整理 | ¥10-20 |
| 脚垫/减震垫 | 减震降噪 | ¥10-15 |

## 成本估算

| 配置等级 | 成本范围 | 包含内容 |
|---|---|---|
| 基础版 | ¥800-1200 | 框架+板材+基础封箱 |
| 标准版 | ¥1200-1600 | +皮带张紧器+通风 |
| 完整版 | ¥1600-2000 | +温控+LED+完整过滤 |

## 皮带张紧器设计详解

### 问题背景

大鱼TT原机皮带张紧调节困难，需要拆机才能调节，且难以保持最佳张力。

### 解决方案

```
外置张紧器设计：
┌─────────────────┐
│   铝型材框架     │
│  ┌───────────┐  │
│  │  固定座    │  │ ← 安装在型材上
│  │   ┌───┐   │  │
│  │   │轴承│   │  │ ← 张紧轮
│  │   └───┘   │  │
│  │    弹簧    │  │ ← 自动补偿
│  │  调节螺丝   │  │ ← 手动微调
│  └───────────┘  │
└─────────────────┘
```

### 调节方式

- **粗调**：松开固定螺丝，移动张紧器位置
- **细调**：旋转调节螺丝，弹簧自动补偿张力变化

## 装配步骤

### 第一步：框架搭建
1. 切割铝型材到指定长度
2. 用角码组装底部框架
3. 安装立柱和顶部框架
4. 检查对角线，确保方正

### 第二步：安装皮带张紧器
1. 打印张紧器零件（2套，X/Y各1）
2. 安装轴承到张紧轮
3. 将张紧器固定在铝型材上
4. 安装皮带并调整张力

### 第三步：板材安装
1. 切割亚克力板到尺寸
2. 安装侧板、背板、顶板
3. 安装门板（带磁吸/合页）
4. 内侧贴保温棉

### 第四步：电气安装（可选）
1. 安装LED灯条
2. 安装通风风扇
3. 整理走线

### 第五步：调试测试
1. 检查所有螺丝紧固
2. 测试皮带张力
3. 测试ABS打印效果
4. 调整仓温到40-50°C

## 开源文件获取

### B站获取
- 视频：《大鱼TT魔改+封箱》评论区
- UP主主页：汪汪队射手

### 可能包含的文件
```
stls/
├── 皮带张紧器/
│   ├── 固定座.stl
│   ├── 活动块.stl
│   └── 张紧轮.stl
├── 风扇罩/
│   └── 风扇罩.stl
└── 配件/
    ├── 线槽.stl
    └── 其他.stl
```

## ABS打印参数建议

| 参数 | 推荐值 |
|-----|---|
| 喷头温度 | 240-260°C |
| 热床温度 | 100-110°C |
| 仓温 | 40-50°C |
| 风扇速度 | 0-30% |
| 打印速度 | 30-50mm/s |

## 注意事项

1. **皮带张紧器**是此方案的核心，建议优先打印安装
2. **铝型材切割**要精确，误差控制在1mm以内
3. **亚克力板**建议本地购买，快递易损坏
4. **ABS打印**时仓温控制在40-50°C，过高会损坏打印机部件
5. **通风系统**建议安装，减少打印异味

## 参考链接

- [B站视频-大鱼TT魔改+封箱](https://www.bilibili.com)
- [B站视频-皮带张紧器使用教程](https://www.bilibili.com)
- [汪汪队射手主页](https://space.bilibili.com)

---
*资料整理中，具体STL文件请从UP主处获取*
