arbaleast/dayu-tt-all-in-one/docs/MECHANICAL/20_42闭环步进电机改装指南.md

# 42闭环步进电机改装指南

## 什么是闭环步进电机？

### 开环 vs 闭环

| 特性 | 开环步进电机 | 闭环步进电机 |
|-----|---|---|
| **反馈** | 无位置反馈 | 有编码器反馈 |
| **丢步** | 可能丢步 | 不会丢步，自动补偿 |
| **噪音** | 较大 | 较小 |
| **发热** | 较高 | 较低 |
| **价格** | 便宜 | 较贵 |
| **精度** | 一般 | 更高 |

### 工作原理

```
开环: 控制器 → 驱动器 → 电机 → ? (不知道实际位置)
闭环: 控制器 → 驱动器 → 电机 → 编码器 → 反馈 → 控制器 (知道实际位置)
```

## 为什么大鱼TT需要闭环电机？

### 大鱼TT原机问题
1. **CoreXY结构** - 需要精确同步两个电机
2. **高速打印** - 高速时容易丢步
3. **大质量打印头** - 惯性大，加减速时易失步
4. **长距离传动** - 皮带长，弹性变形影响精度

### 闭环电机优势
- ✅ **永不丢步** - 自动检测并补偿
- ✅ **更高速度** - 可以安全地提高打印速度
- ✅ **更低噪音** - 运行更安静
- ✅ **更低发热** - 电流自动调节
- ✅ **更高精度** - 定位更准确

## 42闭环步进电机选型

### 主流品牌

#### 1. **BIGTREETECH S42B V2.0** ⭐ 推荐
- **价格**: ¥80-120/个
- **特点**:
  - 集成驱动器和编码器
  - 即插即用
  - 支持Klipper/Marlin
  - OLED显示屏
  - 无需更换电机，只需更换驱动板
- **适用**: 改装现有42电机
- **购买**: 淘宝/官方店

#### 2. **Makerbase MKS SERVO42C**
- **价格**: ¥70-100/个
- **特点**:
  - 国产方案
  - 性价比高
  - 支持UART配置
- **适用**: 预算有限的用户

#### 3. ** integrated闭环电机** (一体式)
- **价格**: ¥150-250/个
- **特点**:
  - 电机+编码器+驱动一体
  - 安装简单
  - 性能稳定
- **品牌**: 雷赛、研控、信浓
- **适用**: 追求稳定性的用户

### 技术参数对比

| 参数 | S42B V2.0 | SERVO42C | 一体式 |
|-----|---|---|---|
| 编码器分辨率 | 1000PPR | 1000PPR | 1000-4000PPR |
| 最大电流 | 1.5A | 1.5A | 2A |
| 细分 | 1-256 | 1-256 | 1-256 |
| 通讯接口 | UART/脉冲 | UART/脉冲 | 脉冲 |
| 配置方式 | OLED/串口 | 串口 | 拨码开关 |
| 安装难度 | 简单 | 简单 | 中等 |

## 大鱼TT改装方案

### 方案A: S42B V2.0 改装 (推荐)

#### 所需材料
| 物品 | 数量 | 价格 | 备注 |
|-----|---|---|---|
| S42B V2.0 闭环驱动板 | 4个 | ¥320-480 | X/Y/Z/E轴 |
| 42步进电机 (原机保留) | 4个 | - | 或更换更高扭矩电机 |
| 散热片 (可选) | 4个 | ¥20-40 | 高负载时推荐 |
| 连接线 | 若干 | ¥10-20 | 根据布线需求 |

**总成本**: ¥350-540

#### 安装步骤

1. **拆卸原驱动板**
   ```
   1. 断电
   2. 拆下原A4988/TMC2209驱动板
   3. 记录原电机线序
   ```

2. **安装S42B驱动板**
   ```
   1. 将S42B插入电机驱动插槽
   2. 连接电机线 (注意线序)
   3. 连接编码器线
   4. 固定散热片 (可选)
   ```

3. **编码器安装**
   ```
   1. 将磁环安装在电机轴上
   2. 确保磁环与编码器间隙1-3mm
   3. 固定编码器板
   ```

4. **配置固件**
   ```
   Klipper配置:
   [stepper_x]
   step_pin: X_STEP
   dir_pin: X_DIR
   enable_pin: !X_ENABLE
   rotation_distance: 40
   microsteps: 16
   full_steps_per_rotation: 200
   
   # S42B不需要特殊配置，当作普通驱动使用
   ```

5. **校准电机**
   ```
   1. 进入S42B菜单 (长按按钮)
   2. 选择 "Cal" (校准)
   3. 电机将自动正反转一圈
   4. 确认无抖动、无异响
   ```

### 方案B: 一体式闭环电机更换

#### 所需材料
| 物品 | 数量 | 价格 | 备注 |
|-----|---|---|---|
| 42闭环步进电机 | 4个 | ¥600-1000 | 高扭矩版本 |
| 电机支架 (可能需要) | 4个 | ¥40-80 | 检查安装孔位 |
| 延长线 | 若干 | ¥20-30 | 编码器线 |

**总成本**: ¥660-1110

#### 安装步骤

1. **拆除原电机**
   - 记录原电机安装尺寸
   - 拆除电机支架

2. **安装新电机**
   - 检查轴径和长度
   - 安装电机支架
   - 固定电机

3. **接线**
   - 连接驱动信号线
   - 连接编码器线
   - 注意线序和屏蔽

4. **配置驱动器**
   - 设置电流 (通常1.2-1.5A)
   - 设置细分 (建议16或32)
   - 设置闭环参数

## 固件配置

### Klipper配置

```ini
# 普通配置，S42B兼容标准步进驱动
[stepper_x]
step_pin: PB13
dir_pin: PB12
enable_pin: !PB14
rotation_distance: 40
microsteps: 16
full_steps_per_rotation: 200
endstop_pin: ^PC0
position_endstop: 0
position_max: 235
homing_speed: 50

[stepper_y]
step_pin: PB10
dir_pin: PB2
enable_pin: !PB11
rotation_distance: 40
microsteps: 16
full_steps_per_rotation: 200
endstop_pin: ^PC1
position_endstop: 0
position_max: 235
homing_speed: 50

[tmc2209 stepper_x]  # 如果S42B支持UART模式
uart_pin: PC10
run_current: 1.0
stealthchop_threshold: 999999
```

### Marlin配置

```cpp
// Configuration.h
#define X_DRIVER_TYPE  TMC2209  // 或 A4988，取决于S42B模式
#define Y_DRIVER_TYPE  TMC2209
#define Z_DRIVER_TYPE  TMC2209
#define E0_DRIVER_TYPE TMC2209

// 电流设置
#define X_CURRENT       1000  // mA
#define Y_CURRENT       1000
#define Z_CURRENT       1000
#define E0_CURRENT      1000

// 细分设置
#define MICROSTEP_MODES {16, 16, 16, 16, 16, 16}
```

## 调试与优化

### 常见问题

#### 1. 电机抖动
**原因**:
- 编码器磁环安装不正
- 磁环与编码器间隙不合适
- 电机线序错误

**解决**:
```
1. 重新安装磁环，确保同心
2. 调整间隙至1-3mm
3. 检查并更正线序
4. 重新校准
```

#### 2. 校准失败
**原因**:
- 磁环松动
- 编码器损坏
- 电机阻力过大

**解决**:
```
1. 紧固磁环
2. 检查编码器连接线
3. 确保电机空载
4. 更换编码器
```

#### 3. 噪音仍然大
**原因**:
- 电流设置过高
- 细分设置不合适
- 机械共振

**解决**:
```
1. 降低电流至合适值
2. 尝试32细分或64细分
3. 检查皮带张力
4. 添加减震垫
```

### 性能优化

#### 提高打印速度
```
原速度: 60mm/s
改装后: 100-150mm/s (建议逐步测试)

优化步骤:
1. 逐步提高速度
2. 观察打印质量
3. 调整加速度
4. 找到最佳平衡点
```

#### 降低噪音
```
1. 使用32细分或更高
2. 优化电流设置
3. 添加电机减震垫
4. 检查机械部件
```

## 成本效益分析

### 改装成本
- **S42B方案**: ¥350-540 (4轴)
- **一体式方案**: ¥660-1110 (4轴)

### 收益
- ✅ 打印速度提升 50-100%
- ✅ 打印质量提升 (减少层纹、错层)
- ✅ 减少打印失败率
- ✅ 延长电机寿命
- ✅ 降低维护成本

### 投资回报
- 对于经常打印的用户：3-6个月回本
- 对于商业用户：立即提升产能

## 购买建议

### 新手推荐
- **S42B V2.0** x 2 (仅X/Y轴)
- 成本: ¥160-240
- 先改装XY轴，体验效果

### 进阶推荐
- **S42B V2.0** x 4 (全部轴)
- 成本: ¥320-480
- 全面提升性能

### 发烧友推荐
- **一体式闭环电机** x 4
- 成本: ¥660-1110
- 最佳性能和稳定性

## 参考资料

### 官方文档
- [BIGTREETECH S42B Wiki](https://bigtreetech.github.io/docs/)
- [Makerbase SERVO42C文档](https://github.com/makerbase-mks)

### 视频教程
- B站搜索: "S42B闭环电机安装"
- B站搜索: "3D打印机闭环电机改装"

### 社区讨论
- 知乎: 闭环步进电机话题
- V2EX: 3D打印板块
- 5iMX: 3D打印论坛

---

*改装有风险，操作需谨慎。建议先备份原配置，逐步改装测试。*
