arbaleast/dayu-tt-all-in-one/docs/MECHANICAL/22_42闭环电机产品对比.md

# 42闭环步进电机产品对比

## 主流产品对比表

| 产品 | 品牌 | 价格 | 编码器 | 最大电流 | 特点 | 推荐指数 |
|-----|---|---|---|---|---|---|
| **S42B V2.0** | BIGTREETECH | ¥80-120 | 1000PPR | 1.5A | 即插即用，OLED屏 | ⭐⭐⭐⭐⭐ |
| **SERVO42C** | Makerbase | ¥70-100 | 1000PPR | 1.5A | 性价比高，UART配置 | ⭐⭐⭐⭐ |
| **ODrive** | ODrive Robotics | $100-150 | 2400PPR | 5A | 高性能，FOC控制 | ⭐⭐⭐⭐ |
| **iSV2-T42** | 雷赛 | ¥200-300 | 4000PPR | 2A | 工业级，高精度 | ⭐⭐⭐⭐ |
| **CL42T** | 研控 | ¥180-250 | 4000PPR | 2A | 稳定可靠 | ⭐⭐⭐⭐ |
| **一体式闭环电机** | 信浓 | ¥150-250 | 1000PPR | 1.5A | 集成度高 | ⭐⭐⭐ |

## 详细对比

### 1. BIGTREETECH S42B V2.0 ⭐ 推荐

**优点:**
- ✅ 安装最简单，即插即用
- ✅ 有OLED显示屏，直观操作
- ✅ 支持原有42电机，成本低
- ✅ 社区支持好，文档丰富
- ✅ 价格适中

**缺点:**
- ❌ 电流较小 (1.5A)
- ❌ 不适合超大扭矩需求

**适用场景:**
- 3D打印机改装
- 小型CNC
- 激光雕刻机
- 写字机

**购买建议:**
- 新手首选
- 性价比最优
- 改装首选

---

### 2. Makerbase SERVO42C

**优点:**
- ✅ 价格便宜
- ✅ 国产方案，售后方便
- ✅ 支持UART配置
- ✅ 体积小巧

**缺点:**
- ❌ 无显示屏
- ❌ 社区相对较小

**适用场景:**
- 预算有限
- 批量改装
- 嵌入式应用

**购买建议:**
- 预算紧张选这个
- 需要UART功能选这个

---

### 3. ODrive

**优点:**
- ✅ 性能最强
- ✅ FOC矢量控制
- ✅ 支持大电流 (5A)
- ✅ 开源固件
- ✅ 支持多种编码器

**缺点:**
- ❌ 价格贵
- ❌ 配置复杂
- ❌ 体积大

**适用场景:**
- 高性能机器人
- 机械臂
- AGV小车
- 专业设备

**购买建议:**
- 追求极致性能
- 有开发能力
- 预算充足

---

### 4. 雷赛 iSV2-T42

**优点:**
- ✅ 工业级品质
- ✅ 高精度 (4000PPR)
- ✅ 稳定性好
- ✅ 品牌可靠

**缺点:**
- ❌ 价格较高
- ❌ 配置相对复杂

**适用场景:**
- 工业设备
- 高精度应用
- 长期稳定运行

**购买建议:**
- 工业应用首选
- 追求稳定性

---

### 5. 研控 CL42T

**优点:**
- ✅ 国产工业品牌
- ✅ 性能稳定
- ✅ 技术支持好

**缺点:**
- ❌ 价格较高
- ❌ 主要面向工业

**适用场景:**
- 工业自动化
- 专业设备

---

### 6. 一体式闭环电机

**品牌**: 信浓、东方、雷赛等

**优点:**
- ✅ 集成度最高
- ✅ 安装简单
- ✅ 性能稳定

**缺点:**
- ❌ 需要更换整个电机
- ❌ 成本高
- ❌ 灵活性差

**适用场景:**
- 新设备设计
- 追求简洁
- 不想折腾

---

## 选购指南

### 按预算选择

#### 预算 < ¥300 (2轴)
- **推荐**: SERVO42C
- **配置**: 2个SERVO42C
- **适用**: X/Y轴改装

#### 预算 ¥300-500 (4轴)
- **推荐**: S42B V2.0
- **配置**: 4个S42B
- **适用**: 全轴改装

#### 预算 ¥500-1000
- **推荐**: S42B V2.0 + 散热升级
- **或**: 雷赛iSV2-T42 (2轴)
- **适用**: 高性能需求

#### 预算 > ¥1000
- **推荐**: ODrive 或 雷赛全套
- **适用**: 专业应用

### 按应用选择

#### 3D打印机 (大鱼TT)
- **首选**: S42B V2.0
- **原因**: 安装简单，社区支持好
- **配置**: 4个，X/Y/Z/E轴

#### CNC雕刻机
- **首选**: S42B V2.0 或 雷赛iSV2
- **原因**: 需要较大扭矩
- **配置**: 根据轴数

#### 激光雕刻机
- **首选**: SERVO42C 或 S42B
- **原因**: 精度要求高，速度要求低
- **配置**: 2-3个

#### 机械臂/机器人
- **首选**: ODrive
- **原因**: 高性能，FOC控制
- **配置**: 根据自由度

### 按经验选择

#### 新手
- **推荐**: S42B V2.0
- **原因**: 有显示屏，操作直观，文档丰富

#### 进阶用户
- **推荐**: SERVO42C 或 S42B + UART
- **原因**: 可以深度配置

#### 专业用户
- **推荐**: ODrive 或 雷赛
- **原因**: 性能强，可定制

## 配件推荐

### 必须配件
| 配件 | 价格 | 说明 |
|-----|---|---|
| 散热片 | ¥5-10/个 | 高负载必备 |
| 减震垫 | ¥2-5/个 | 降低噪音 |
| 延长线 | ¥10-20 | 方便布线 |

### 推荐配件
| 配件 | 价格 | 说明 |
|-----|---|---|
| 4010风扇 | ¥5-10/个 | 主动散热 |
| 电机支架 | ¥10-20/个 | 安装更方便 |
| 线槽 | ¥10-20 | 整理线缆 |

## 购买渠道

### 国内购买
- **淘宝**: 价格透明，选择多
- **京东**: 物流快，正品保障
- **立创商城**: 工程师首选
- **阿里1688**: 批量采购

### 海外购买
- **AliExpress**: 速卖通，全球配送
- **Amazon**: 亚马逊，物流快
- **官方直销**: ODrive等

### 二手市场
- **闲鱼**: 可能有低价
- **电子市场**: 深圳华强北等

## 价格参考 (2026年)

| 产品 | 零售价 | 批发价(10+) | 历史低价 |
|-----|---|---|---|
| S42B V2.0 | ¥80-120 | ¥70-90 | ¥65 |
| SERVO42C | ¥70-100 | ¥60-80 | ¥55 |
| ODrive | $100-150 | $90-130 | $80 |
| 雷赛iSV2 | ¥200-300 | ¥180-250 | ¥160 |

---

*价格仅供参考，实际价格以购买时为准*
