arbaleast/dayu-tt-all-in-one/enclosure/dimensions.md

# 大鱼TT 310 尺寸数据 / TT310 Dimensions

> 文档版本: 1.0.0  
> 创建日期: 2026-03-24  
> 数据来源: 社区资料 + 任务估算 + 参考开源项目  
> ⚠️ 注: 310mm版本封箱为首次设计验证，部分尺寸基于235版本等比例推算

---

## 一、打印机本体关键尺寸 / Machine Critical Dimensions

### 1.1 打印规格 / Print Specifications

| 参数 | 数值 | 说明 |
|---|---|---|
| 成型尺寸 (X×Y×Z) | **310×310×310mm** | 厂家标称最大打印体积 |
| 层高范围 | 0.05–0.30mm | 推荐0.12–0.20mm |
| 喷嘴直径 | 0.4mm (标准) | 可选0.2/0.6/0.8mm |
| 耗材直径 | 1.75mm | PLA/ABS/PETG/ASA等 |
| 最大打印速度 | ~150mm/s | Klipper输入整形加持 |

### 1.2 机体外形尺寸 / Machine Outer Dimensions

> ⚠️ 以下为估算值，基于235版本等比例推算 + 2040型材框架结构  
> 实测数据待后续更新

| 尺寸方向 | 估算值 | 说明 |
|---|---|---|
| **X方向 (左右/幅宽)** | ~470mm | 沿型材框架横向，235版本~450mm |
| **Y方向 (前后/进深)** | ~450mm | 沿型材框架纵向，235版本~445mm |
| **Z方向 (高度)** | ~720mm | 底座~150mm + 打印区~310mm + 顶框架~260mm |

**X方向推算逻辑:**
- 235版本X方向型材长度 ≈ 390mm → 外形~450mm
- 打印幅面从235增至310，增加75mm
- X方向型材长度 = 390 + 75 = 465mm → 外形~470mm

**Y方向推算逻辑:**
- 235版本Y方向型材长度 ≈ 390mm → 外形~445mm  
- Y方向承载打印平台，型材略短
- Y方向型材长度 ≈ 380mm → 外形~450mm

**Z方向推算逻辑 (分三层):**

| Z轴层级 | 高度 | 说明 |
|---|---|---|
| 底部框架 + 电子件 + 热床 | ~150mm | 包含脚垫、主板区域 |
| 打印有效区域 | 310mm | Z轴丝杆行程 |
| 顶部框架 + 龙门架 + 电机 + 同步轮 | ~260mm | CoreXY顶部结构 |
| **合计** | **~720mm** | 完整机身高度 |

### 1.3 铝型材框架 / Aluminum Profile Frame

> ⚠️ **重要纠正**: 大鱼TT使用的是 **2020 型材 (20mm×20mm)**，不是 2040！

| 参数 | 数值 |
|---|---|
| 型材规格 | **2020 (20mm×20mm, 槽宽6mm)** |
| X轴型材数量 | 2根 (前后框架横梁) |
| Y轴型材数量 | 2根 (左右框架横梁) |
| Z轴立柱数量 | 4根 (四角立柱) |
| 角码连接件 | 12–16个 (框架节点) |

> 注: 2020 型材截面是 20mm×20mm，框架安装孔间距以 20mm 为模数。  
> ⚠️ 这影响了侧板固定夹和密封条槽的设计——安装孔距必须是 20mm 的倍数。

### 1.4 热床与平台 / Heat Bed & Platform

| 参数 | 数值 |
|---|---|
| 热床尺寸 | 310×310mm (M8螺丝孔版本) |
| 玻璃/PEI板尺寸 | 310×310mm |
| 热床固定孔距 | M8螺纹孔 |
| 调平弹簧高度 | 8×20mm (标准) |

### 1.5 核心运动结构 / Core Motion Structure

| 组件 | 位置 | 尺寸相关 |
|---|---|---|
| X轴滑块 | 喷头安装在X轴导轨上 | MGN12H, 约350mm长 |
| Y轴滑块 | 热床平台底部 | MGN12H, 约310mm长 |
| X轴同步轮/电机 | 框架左侧 | GT2 20齿 |
| Y轴同步轮/电机 | 框架后侧 | GT2 20齿 |
| Z轴丝杆 | 机器后部中央 | M8×400mm |

---

## 二、封箱设计尺寸 / Enclosure Design Dimensions

> 以"包住整机+10mm余量"为原则

### 2.1 内部有效空间要求 / Internal Clearance Requirements

| 方向 | 最小内部空间 | 说明 |
|---|---|---|
| X (宽) | ≥ 490mm | 机身470mm + 左右各≥10mm |
| Y (深) | ≥ 470mm | 机身450mm + 前后各≥10mm |
| Z (高) | ≥ 740mm | 机身720mm + 上下各≥10mm |

### 2.2 封箱外形尺寸 / Enclosure Outer Dimensions

| 尺寸 | 数值 | 说明 |
|---|---|---|
| 外宽 (X) | **510mm** | 侧板宽: 510mm |
| 外深 (Y) | **490mm** | 前后板深: 490mm |
| 外高 (Z) | **760mm** | 顶板高: 760mm |
| 内宽 | 506mm | 板厚20mm时 |
| 内深 | 486mm | 板厚20mm时 |
| 内高 | 756mm | 板厚20mm时 |

### 2.3 门洞尺寸 / Door Opening Dimensions

| 参数 | 数值 | 说明 |
|---|---|
| 门洞宽度 | 490mm | 正面全宽开门 |
| 门洞高度 | 740mm | 从底部到顶部 |
| 门板厚度 | 3–5mm | 亚克力板 |
| 铰链规格 | 30–40mm 小型铰链 | 2–3个/门 |
| 磁吸距离 | 3–5mm | 钕铁硼磁铁 |

---

## 三、散热与通风 / Cooling & Ventilation

### 3.1 散热需求分析 / Thermal Requirements

> 封箱后仓温可达40–50°C，适合ABS/ASA打印

| 发热源 | 功率 | 散热方式 |
|---|---|---|
| 热床 (Heat Bed) | 220–400W | 自然散热 + 底部通风 |
| 加热棒 (Hotend) | 40–60W | 涡轮风扇5015排出 |
| 主板 (Board) | 5–15W | 被动散热 + 风扇 |
| 步进电机 (Steppers) | 10–20W | 被动散热 |

### 3.2 风扇安装位 / Fan Mount Positions

| 位置 | 规格 | 数量 | 用途 |
|---|---|---|---|
| 顶部 | 120×120×25mm (12V/24V) | 1–2个 | 热空气排出 |
| 侧板 (左/右) | 80×80×25mm | 0–2个 | 辅助散热进风 |
| 背部 | 80×80×25mm | 0–1个 | 辅助排风 |
| 主板区域 | 40×40×10mm | 1个 | 主板散热 |

### 3.3 风道设计 / Airflow Design

```
        ┌─────────────────────────┐
        │  [顶部风扇×1-2 排出热风] │  ← Z=760mm
        │                         │
  ┌─────┤                         ├─────┐
  │ 侧板│    [打印机主体 X×Y×Z]   │侧板 │
  │     │     310×310×310mm       │     │  ← Y=490mm (前后)
  └─────┤                         ├─────┘
        │  [热床 310×310mm]       │
        │  [底部进风 通风孔]       │  ← Z=0mm
        └─────────────────────────┘
```

---

## 四、线缆与接口 / Cables & Interfaces

### 4.1 进出线开孔 / Cable Routing Holes

| 位置 | 数量 | 直径 | 用途 |
|---|---|---|---|
| 底板 | 1–2个 | Ø30–40mm | 电源线、USB、网线 |
| 侧板 | 1–2个 | Ø20–30mm | 热端风扇线、传感器线 |
| 顶板 | 0–1个 | Ø20–30mm | 摄像头线、LED灯线 |

### 4.2 门板走线 / Door Cable Routing

| 走线位置 | 说明 |
|---|---|
| 铰链侧 (左侧) | 使用线缆拖链/波纹管 |
| 线缆活动长度 | ≥ 300mm (保证开门角度≥90°) |

---

## 五、密封设计 / Sealing Design

### 5.1 密封条安装槽 / Sealant Groove

| 位置 | 槽宽 | 槽深 | 密封条规格 |
|---|---|---|---|
| 门框四边 | 5mm | 3mm | 5×5mm D型海绵密封条 |
| 板间接缝 | 3mm | 2mm | 3×3mm P型海绵密封条 |
| 风机周边 | 3mm | 2mm | 3×3mm 海绵密封条 |

### 5.2 门板磁吸 / Door Magnetic Latch

| 参数 | 规格 |
|---|---|
| 磁铁规格 | Ø10×3mm 钕铁硼 N52 × 4–6个 |
| 磁铁间距 | 100–150mm 均匀分布 |
| 磁铁嵌入深度 | 1–2mm (3D打印件预留槽) |
| 铁板规格 | 50×10×1mm × 4–6个 (粘贴式) |

---

## 六、参考数据来源 / References

| 来源 | 说明 | 验证状态 |
|---|---|---|
| 大鱼DIY B站视频 | 235版本封箱参考 | ✅ 已验证 |
| Gitee TT310zenggaofengxiang | 310增高封箱参考，增高90mm | ⚠️ 未实测 |
| MakerWorld 大鱼TT打印件 | 官方3D模型 | 待对照 |
| GitHub Xuanwu BOM | 采购清单Excel | 待下载 |
| 本项目 docs/ | 历史文档资料 | 参考 |

---

## 七、待确认尺寸 / Pending Measurements

| 序号 | 待确认项目 | 优先级 | 备注 |
|---|---|---|---|
| 1 | TT310 实际X方向外形 | 高 | 235版本450mm，310版本待实测 |
| 2 | TT310 实际Y方向外形 | 高 | 235版本445mm，310版本待实测 |
| 3 | TT310 实际Z方向高度 | 高 | 235版本~580mm，310版本待实测 |
| 4 | 2040 vs 2020 型材确认 | 中 | 影响密封条槽位设计 |
| 5 | 热床功率确认 | 中 | 影响散热设计 |
| 6 | 主板型号与散热需求 | 低 | 升级时参考 |
| 7 | **确认2020型材实际尺寸** | 高 | 影响固定夹孔距设计（必须是20mm倍数） |

---

*文档更新: 2026-03-25（更正型材规格：2020非2040）*  
*负责人: US-001 自动生成*
