arbaleast/dayu-tt-all-in-one/enclosure/plan.md

# 大鱼TT 310 全封闭机箱 - 设计与生产计划
# TT310 Full Enclosure - Design & Production Plan

> 文档版本: 1.1.0  
> 创建日期: 2026-03-24  
> 更新日期: 2026-03-25  
> 状态: 规划阶段 / PLANNING

---

## ⚠️ 310mm 尺寸验证状态

> **已知问题：大鱼TT 310mm 尺寸封箱未经过官方实机验证**
>
> - **官方验证**：仅 235mm 尺寸封箱有实物（UP主大鱼DIY，BV1pe41117h2）
> - **310mm**：官方明确说明"并没有实机验证过，如有问题反馈给我"
> - **本项目目标**：310mm 尺寸设计 → **属于先行开发，待实物验证**
> - **风险**：310 机型框架尺寸可能与 235 有差异，实际装配可能需要调整
> - **建议**：235 用户可参考官方封箱视频；310 用户需关注本项目的实测反馈

### 235 vs 310 关键差异

| 参数 | 235尺寸 | 310尺寸 | 差异影响 |
|---|---|---|---|
| 框架宽度 | ~395mm | ~470mm | 机箱 X 方向 +75mm |
| 框架深度 | ~400mm | ~450mm | 机箱 Y 方向 +50mm |
| 框架高度 | ~680mm | ~720mm | 机箱 Z 方向 +40mm |
| 热床尺寸 | 235×235mm | 310×310mm | 热量输出更大 |
| Z轴行程 | 235mm | 310mm | 顶部空间更紧张 |

> **结论**：235 的封箱设计**不能直接套用**到 310，需重新核算各向尺寸。

---

## 一、项目概述 / Project Overview

**目标:** 为大鱼TT 310 (打印尺寸310×310×310mm) 设计并制作全封闭机箱

**设计原则:**
1. 尺寸兼容: 无需修改机身结构，直接包裹整机
2. 散热合理: 风道设计满足发热元件散热需求
3. 密封良好: 门板磁吸+密封条，确保保温效果
4. 维护便捷: 前门快拆设计，方便日常操作
5. 成本可控: 优先使用易获取材料

**设计软件:** FreeCAD (优先) 或 Onshape

---

## 二、整体尺寸汇总 / Overall Dimensions Summary

### 2.1 机箱外型尺寸 / Enclosure Outer Dimensions

| 参数 | 数值 | 单位 | 说明 |
|---|---|---|---|
| 宽度 (X) | **510** | mm | 整机宽470mm + 左右各20mm余量 |
| 深度 (Y) | **490** | mm | 整机深450mm + 前后各20mm余量 |
| 高度 (Z) | **760** | mm | 整机高720mm + 上下各20mm余量 |
| 内部有效空间 | 506×486×756 | mm | 板厚2mm时的内部尺寸 |

### 2.2 门洞尺寸 / Door Opening

| 参数 | 数值 | 单位 |
|---|---|---|
| 门洞宽度 | 490 | mm |
| 门洞高度 | 740 | mm |
| 门板厚度 | 3–5 | mm (亚克力) |

---

## 三、面板尺寸明细 / Panel Dimensions Detail

### 3.1 侧板 (Side Panels) — 共2块

| 参数 | 左侧板 | 右侧板 | 说明 |
|---|---|---|---|
| **宽度** | 510mm | 510mm | X方向 |
| **高度** | 760mm | 760mm | Z方向 |
| **厚度** | 3mm | 3mm | 亚克力板 |
| **材料** | 透明亚克力 | 透明亚克力 | 可选黑色亚克力 |
| **特殊加工** | 铰链安装孔×3 | 可选风扇孔×1 (Ø80mm) | 右侧风扇位 |
| **密封槽** | D型密封条槽 | D型密封条槽 | 门框三边 |

> 侧板设计为独立板，不与框架整合，便于亚克力采购

### 3.2 后背板 (Rear Panel) — 共1块

| 参数 | 数值 | 说明 |
|---|---|---|
| **宽度** | 490mm | Y方向 |
| **高度** | 760mm | Z方向 |
| **厚度** | 3mm | 亚克力板 |
| **材料** | 黑色亚克力 或 PETG板 | 遮光/保温 |
| **特殊加工** | 底部线缆孔 Ø30–40mm ×2 | 电源/数据线 |
| **特殊加工** | 中部辅助孔 Ø20–30mm ×2 | 备用/传感器线 |
| **密封槽** | D型密封条槽 | 门框三边 |

### 3.3 顶板 (Top Panel) — 共1块

| 参数 | 数值 | 说明 |
|---|---|---|
| **宽度** | 510mm | X方向 |
| **深度** | 490mm | Y方向 |
| **厚度** | 3mm | 亚克力板 |
| **材料** | 透明亚克力 | 便于观察内部 |
| **特殊加工** | 风扇安装孔 120×120mm ×1–2 | 散热排风 |
| **特殊加工** | 风扇穿线孔 Ø10mm ×1 | 风扇电源线 |
| **密封槽** | P型密封条槽 | 与侧板/后板接缝 |

> 风扇建议安装: Noctua NF-A12×1 或 类似120mm风扇 ×2

### 3.4 前门板 (Front Door Panel) — 共1块

| 参数 | 数值 | 说明 |
|---|---|---|
| **宽度** | 490mm | Y方向(门洞宽) |
| **高度** | 740mm | Z方向(门洞高) |
| **厚度** | 5mm | 透明亚克力(加厚) |
| **材料** | 透明亚克力5mm | 方便观察打印过程 |
| **铰链安装** | 30–40mm小型铰链 ×3 | 左侧固定 |
| **磁吸安装** | Ø10×3mm磁铁孔 ×4–6 | 右侧快拆 |
| **把手** | 内嵌把手或外粘把手 | 方便开合 |
| **可选加工** | 透明观察窗 | 不影响整体观察 |

### 3.5 底板 (Bottom Panel) — 共1块

| 参数 | 数值 | 说明 |
|---|---|---|
| **宽度** | 510mm | X方向 |
| **深度** | 490mm | Y方向 |
| **厚度** | 5mm | 亚克力板(承重) |
| **材料** | 透明亚克力 或 黑色亚克力 | 承重设计 |
| **特殊加工** | 调整脚安装孔 Ø10mm ×4 | M6调整脚 |
| **特殊加工** | 主板区域通风孔 | 可选 |
| **密封槽** | P型密封条槽 | 与四周边框接缝 |

### 3.6 密封条 (Sealant Strips)

| 参数 | 规格 | 数量/长度 | 安装位置 |
|---|---|---|---|
| D型密封条 | 5×5mm | 约2500mm | 门框四周(侧板/后板门洞边) |
| P型密封条 | 3×3mm | 约3000mm | 顶板/底板与侧板/后板接缝 |

---

## 四、3D打印件清单 / 3D Printed Parts

### 4.1 框架连接件 (Frame Connectors)

| 零件名称 | 数量 | 材料 | 尺寸 (W×H×D) | 说明 |
|---|---|---|---|---|
| 角码连接器 | 12个 | PETG | 20×20×10mm | 2020框架节点 |
| 侧板固定夹 | 16个 | PETG | 30×15×10mm | 侧板与框架固定 |
| 顶板固定件 | 8个 | PETG | 25×20×8mm | 顶板边缘固定 |
| 底板支架 | 4个 | PETG | 40×30×15mm | 底板四角承重 |
| 门框加强条 | 4个 | PETG | 490/760×15×5mm | 门框边缘加强 |

### 4.2 门板配件 (Door Hardware)

| 零件名称 | 数量 | 材料 | 尺寸 (W×H×D) | 说明 |
|---|---|---|---|---|
| 铰链安装座 | 3对 | PETG | 30×20×8mm | 门板与侧板连接 |
| 磁铁固定座 | 6个 | PETG | Ø12×3mm圆形槽 | Ø10×3mm磁铁嵌入 |
| 铁片粘接座 | 6个 | PETG | 50×10×2mm | 磁铁对面铁片安装 |
| 门把手 | 1个 | PETG | 60×20×15mm | 内嵌式把手 |
| 门挡块 | 2个 | PETG | 15×10×5mm | 限制门开角度数 |

### 4.3 散热通风件 (Cooling & Ventilation)

| 零件名称 | 数量 | 材料 | 尺寸 (W×H×D) | 说明 |
|---|---|---|---|---|
| 顶部风扇罩 | 1–2个 | PETG | 125×125×20mm | 120mm风扇装饰罩 |
| 风扇滤网框 | 1–2个 | PETG | 120×120×5mm | 风扇过滤棉安装 |
| 侧板通风盖 | 1个 | PETG | 85×85×3mm | 可开合通风盖 |
| 风道导向片 | 2–4个 | PETG | 50×30×2mm | 优化风道 |

### 4.4 线缆管理件 (Cable Management)

| 零件名称 | 数量 | 材料 | 尺寸 (W×H×D) | 说明 |
|---|---|---|---|---|
| 线缆入口圈 | 2个 | PETG | Ø35×10mm | 线缆孔密封圈 |
| 线缆出口圈 | 2个 | PETG | Ø25×10mm | 辅助线缆出口 |
| 线缆固定夹 | 4个 | PETG | 20×10×8mm | 内部走线固定 |
| 铰链线缆保护 | 2个 | TPU | 100×15×3mm | 门板线缆保护 |

### 4.5 底部支架件 (Bottom Frame Brackets)

| 零件名称 | 数量 | 材料 | 尺寸 (W×H×D) | 说明 |
|---|---|---|---|---|
| 调整脚固定座 | 4个 | PETG | Ø20×15mm | M6调整脚连接 |
| 机箱脚垫 | 4个 | TPU | Ø25×5mm | 减震降噪 |

---

## 五、生产工艺要求 / Manufacturing Requirements

### 5.1 亚克力板切割

| 面板 | 外形尺寸 | 切割公差 | 备注 |
|---|---|---|---|
| 左侧板 | 510×760mm | ±0.5mm | 激光切割 |
| 右侧板 | 510×760mm | ±0.5mm | 激光切割，含Ø80孔 |
| 后背板 | 490×760mm | ±0.5mm | 激光切割，含Ø30/Ø20孔 |
| 顶板 | 510×490mm | ±0.5mm | 激光切割，含120×120孔 |
| 前门板 | 490×740mm | ±0.5mm | 激光切割 |
| 底板 | 510×490mm | ±0.5mm | 激光切割，含Ø10×4孔 |

### 5.2 3D打印参数

| 材料 | 层高 | 填充 | 壁厚 | 打印速度 | 热床温度 | 喷嘴温度 |
|---|---|---|---|---|---|---|
| **PETG** | 0.2mm | 40% | 3层 | 50mm/s | 80°C | 240°C |
| **PLA** | 0.2mm | 30% | 3层 | 60mm/s | 60°C | 210°C |
| **TPU** | 0.24mm | 20% | 3层 | 25mm/s | 50°C | 220°C |
| **ABS** | 0.2mm | 40% | 3层 | 50mm/s | 100°C | 250°C |

> 推荐: PETG (耐温好、强度高、易打印)，密封条用TPU

---

## 六、装配顺序 / Assembly Sequence

### 第一阶段: 框架准备
1. 切割/购买2020型材 (如需额外框架)
2. 打印框架连接件 (角码连接器)
3. 组装底部框架支撑

### 第二阶段: 3D打印件
4. 打印所有PETG零件 (批量打印)
5. 打印TPU零件 (脚垫、线缆保护)
6. 后处理: 去毛刺、打磨

### 第三阶段: 亚克力板准备
7. 激光切割所有亚克力板
8. 开孔、倒角
9. 贴密封条 (P型密封条)

### 第四阶段: 固定框架安装
10. 安装侧板固定夹 (16个) 到框架
11. 安装门框加强条
12. 安装底部支架件

### 第五阶段: 板安装
13. 安装后背板 (螺丝固定到侧板固定夹)
14. 安装底板 (螺丝固定)
15. 安装左右侧板 (螺丝固定)
16. 安装顶板 (螺丝固定，可拆卸)

### 第六阶段: 门板安装
17. 安装铰链到左侧板
18. 安装磁铁座到门板 (6个)
19. 安装铁片座到门框对应位置 (6个)
20. 安装门把手
21. 合上门板，调整铰链

### 第七阶段: 散热系统
22. 安装顶部排风风扇 (1–2个)
23. 安装风扇滤网
24. 可选: 安装侧板通风系统

### 第八阶段: 线缆与电气
25. 安装线缆入口/出口密封圈
26. 整理内部线缆
27. 连接风扇电源到Klipper控制板

### 第九阶段: 调试
28. 测试门板开合是否顺畅
29. 测试磁吸闭合是否牢固
30. 测试密封效果 (可用烟雾测试)
31. 温控调试 (参考Klipper配置)

---

## 七、关键设计决策 / Key Design Decisions

| 决策项 | 选项A | 选项B | 推荐 | 理由 |
|---|---|---|---|---|
| 面板材料 | 亚克力 | PETG板 | 亚克力 | 透明度好、成本低 |
| 3D打印材料 | PETG | ABS | PETG | 易打印、环保 |
| 门板固定 | 磁吸+铰链 | 纯磁吸 | 铰链+磁吸 | 更稳固安全 |
| 散热方式 | 顶部排风 | 侧板排风 | 顶部排风 | 热空气上浮原理 |
| 密封条材质 | 海绵 | 硅胶 | 海绵 | 成本低、效果好 |
| 底板承重 | 亚克力5mm | 铝板3mm | 亚克力5mm | 成本低、够用 |

---

## 八、预计成本 / Estimated Cost

### 材料成本

| 类别 | 项目 | 单价 | 数量 | 小计 |
|---|---|---|---|---|
| 亚克力板 | 侧板 510×760×3mm | ¥30 | 2 | ¥60 |
| 亚克力板 | 顶板 510×490×3mm | ¥20 | 1 | ¥20 |
| 亚克力板 | 底板 510×490×5mm | ¥25 | 1 | ¥25 |
| 亚克力板 | 后背板 490×760×3mm | ¥25 | 1 | ¥25 |
| 亚克力板 | 前门板 490×740×5mm | ¥30 | 1 | ¥30 |
| 密封条 | D型 5×5mm (2.5m) | ¥5 | 1 | ¥5 |
| 密封条 | P型 3×3mm (3m) | ¥3 | 1 | ¥3 |
| 风扇 | 120×120×25mm 24V | ¥20 | 1–2 | ¥20–40 |
| 铰链 | 30mm小型 ×3 | ¥3 | 1套 | ¥3 |
| 磁铁 | Ø10×3mm N52 | ¥2 | 6 | ¥12 |
| 铁片 | 50×10×1mm | ¥1 | 6 | ¥6 |
| 调整脚 | M6×20mm | ¥2 | 4 | ¥8 |
| 螺丝 | M3×10 + M4×10 | ¥5 | 1套 | ¥5 |
| **合计** | | | | **¥222–242** |

### 3D打印材料

| 材料 | 用量估算 | 成本 |
|---|---|---|
| PETG 1.75mm | 200–300g | ¥10–15 |
| TPU 1.75mm | 30–50g | ¥5–8 |
| **合计** | | **¥15–23** |

### 总成本估算

| 项目 | 金额 |
|---|---|
| 材料成本 | ¥222–242 |
| 3D打印材料 | ¥15–23 |
| 加工费 (激光切割) | ¥50–100 (可选) |
| **总计** | **¥237–365** |

---

## 九、交付物清单 / Deliverables

| 序号 | 文件名称 | 格式 | 说明 |
|---|---|---|---|
| 1 | dimensions.md | Markdown | TT310尺寸数据文档 |
| 2 | layout.txt | Text/Markdown | ASCII布局图 |
| 3 | plan.md | Markdown | 本文件，设计与生产计划 |
| 4 | enclosure-FRONTDOOR.step | STEP | 前门板3D模型 |
| 5 | enclosure-LEFT-PANEL.step | STEP | 左侧板3D模型 |
| 6 | enclosure-RIGHT-PANEL.step | STEP | 右侧板3D模型 |
| 7 | enclosure-BACK-PANEL.step | STEP | 后背板3D模型 |
| 8 | enclosure-TOP-PANEL.step | STEP | 顶板3D模型 |
| 9 | enclosure-BOTTOM-PANEL.step | STEP | 底板3D模型 |
| 10 | bracket-hinge-x3.step | STEP | 铰链安装座 |
| 11 | bracket-magnet-x6.step | STEP | 磁铁固定座 |
| 12 | bracket-bottom-x4.step | STEP | 底部支架 |
| 13 | fan-mount-120.step | STEP | 顶部风扇罩 |
| 14 | assembly-guide.md | Markdown | 装配说明书 |
| 15 | bom.md | Markdown | 完整物料清单 (BOM) |
| 16 | klicky-fan-control.cfg | Klipper | 温控风扇配置片段 |
| 17 | *.stl | STL | 所有3D打印件 |

---

## 十、后续故事计划 / Future Stories

| 故事ID | 标题 | 优先级 |
|---|---|---|
| US-002 | 设计前门板3D模型 (铰链+磁吸+把手) | 高 |
| US-003 | 设计侧板固定夹和角码连接件 | 高 |
| US-004 | 设计顶部风扇安装罩 | 中 |
| US-005 | 设计密封条安装槽与门框加强件 | 中 |
| US-006 | 输出所有面板DXF切割图 | 中 |
| US-007 | 创建完整BOM物料清单 | 高 |
| US-008 | 编写装配说明书 | 高 |
| US-009 | 编写Klipper温控风扇配置 | 中 |
| US-010 | 切片验证所有STL可打印性 | 高 |

---

*文档更新: 2026-03-25（更正型材：2020非2040）*  
*负责人: Antfarm Workflow Agent (US-001)*
