arbaleast/dayu-tt-all-in-one/docs/03-功能扩展/皮带张紧机构设计.md

# 大鱼TT310 皮带张紧机构 V2 设计文档

> 更新日期：2026-03-27
> 适用机型：大鱼TT310 (TT235亦可参考)
> 设计者：OpenClaw AI Assistant
> 输出格式：STL + 本文档

---

## 一、设计背景与目标

### 1.1 问题分析

大鱼TT310 原机皮带调节存在以下痛点：
- 皮带张紧需拆机调节，操作繁琐
- 电机支架与同步带调节器之间缺乏集成
- 长期使用后皮带松弛难以快速恢复
- 调节精度差，易出现过紧或过松

### 1.2 设计目标

设计一款**集成式张紧电机座 V2**，实现：
- 免拆机调节皮带张力
- 兼容原机 Nema17 电机支架（4×M3，31mm间距）
- 支持 PETG 3D 打印，4mm 壁厚
- 提供两种方案供用户选择

---

## 二、设计方案

本设计提供**两套互斥方案**，用户可根据实际需求二选一：

| 对比项 | 方案A：弹簧臂式 | 方案B：滑轨调节式 |
|---|---|---|
| 调节方式 | 偏心轮 + 弹簧自动补偿 | 滑轨 + 螺丝精确调节 |
| 结构复杂度 | 中等 | 较简单 |
| 张紧力稳定性 | ★★★★★（弹簧自动补偿） | ★★★★（手动调节） |
| 调节精度 | ★★★（偏心轮粗调） | ★★★★★（螺丝精调） |
| 适合场景 | 频繁调节、长时间使用 | 一次性精确调节 |
| 零件数量 | 6个STL | 4个STL |
| 打印难度 | 较高（弹簧臂薄壁） | 较低（滑块结构） |

---

## 三、方案A详解：弹簧臂式（偏心轮张紧）

### 3.1 核心原理

```
        调节螺丝 (M4)
            ↓
      ┌─────────────────┐
      │    张紧螺丝     │
      └────────┬────────┘
               │
    弹簧 ─────►│◄──── 臂
               │ (枢轴旋转)
         偏心轮压向皮带
              ╱╲
         ═════╱  ╲═════  ← 皮带
              ╲  ╱
               ╲╱
```

- **偏心轮**：安装在 624ZZ 轴承上，偏心距 2mm
- **弹簧**：提供恒定张紧力，自动补偿皮带伸长
- **调节螺丝**：推动臂改变初始张紧位置

### 3.2 生成文件清单（STL）

| 文件名 | 说明 | 数量 |
|---|---|---|
| `TensionerA_Idler.stl` | 偏心轮（带GT2皮带槽） | 1 |
| `TensionerA_Arm.stl` | 弹簧臂（枢轴轴承座 + 弹簧挂柱） | 1 |
| `TensionerA_Base.stl` | 底座（电机安装座 + 调节螺丝孔） | 1 |
| `TensionerA_EccentricSleeve.stl` | 偏心套筒（连接 idler 与臂） | 1 |
| `TensionerA_Spring.stl` | 压缩弹簧（ helical，3D打印用） | 1 |
| `TensionerA_Stop.stl` | 限位块（限制调节螺丝最大行程） | 1 |

### 3.3 关键尺寸参数

```
轴承：624ZZ（内径4mm，外径16mm，高5mm）
偏心距：2mm（通过偏心套筒实现）
臂长：40mm
臂宽：12mm
臂厚：8mm
GT2 皮带轮节圆直径：36.5mm（20齿）
调节螺丝：M4×20
弹簧中径：8mm，线径1.5mm，6圈
```

### 3.4 材料与打印参数

```ini
材料: PETG（推荐）或 ABS
层高: 0.2mm
填充: 50-60%（臂部60%，底座50%）
壁厚: 4mm（4层@1mm）
支撑: 需要（底座、臂部需摆放在最优方向）
打印方向: 底座建议平放，臂建议侧放
喷嘴温度: PETG 235-250°C
热床温度: PETG 80-90°C
```

### 3.5 装配步骤

#### 第一步：打印与清理
```bash
# 使用 PrusaSlicer/Cura 切片
# 建议使用 0.2mm 层高，50%填充
# 打印后清理支撑，特别是枢轴轴承座区域
```

#### 第二步：组装偏心轮（TensionerA_Idler）
1. 将 624ZZ 轴承压入 idler 轮毂孔中
2. 将偏心套筒（EccentricSleeve）套入 idler 轴
3. 检查 idler 转动是否顺畅

#### 第三步：组装弹簧臂（TensionerA_Arm）
1. 在臂的枢轴端安装另一个 624ZZ 轴承
2. 将压缩弹簧挂入臂的弹簧挂柱
3. 安装限位块（TensionerA_Stop）

#### 第四步：安装到底座（TensionerA_Base）
1. 将弹簧臂枢轴轴承座插入底座轴承孔
2. 将偏心轮总成安装到臂的张紧端
3. 安装 M4 调节螺丝，预紧弹簧

#### 第五步：安装到电机支架
1. 使用 4× M3×8 螺丝将底座固定到原电机支架
2. 螺丝扭矩：0.5-0.8 N·m（避免过紧）

#### 第六步：调节皮带张力
1. 松开调节螺丝
2. 将皮带绕过 idler 轮
3. 旋转 M4 调节螺丝，观察皮带张力
4. 皮带张力合适标准：**手指按压下沉 1-2mm**
5. 拧紧锁紧螺母

---

## 四、方案B详解：滑轨调节式

### 4.1 核心原理

```
    电机支架 (铝合金)
    ┌─────────────────────────┐
    │    滑轨底座（TensionerB_Base）   │
    │  ════════════════════════│
    │  [滑块]──► [调节螺丝M4]        │
    │   ↑                        │
    │  惰轮（压向皮带）              │
    │  ════════════════════════ 皮带 │
    └─────────────────────────┘
```

- **滑块**：在底座导轨槽内线性滑动
- **惰轮**：624ZZ 轴承支撑，光轮（无偏心）
- **调节螺丝**：M4 螺丝精确推动滑块
- **波纹预压环**：弹簧替代品，简化装配

### 4.2 生成文件清单（STL）

| 文件名 | 说明 | 数量 |
|---|---|---|
| `TensionerB_Base.stl` | 滑轨底座（电机安装板 + 导轨槽） | 1 |
| `TensionerB_Slider.stl` | 滑块（轴承安装位 + 弹簧挂柱） | 1 |
| `TensionerB_Idler.stl` | 滑轨惰轮（光轮，安装624ZZ） | 1 |
| `TensionerB_SpringRing.stl` | 波纹预压环（替代金属弹簧） | 1 |

### 4.3 关键尺寸参数

```
滑槽宽度：16mm
滑块尺寸：20×16×12mm
轴承：624ZZ（内径4mm，外径16mm，高5mm）
情轮外径：26mm
滑块行程：±8mm
调节螺丝：M4×20
安装孔：4×M3，31mm间距（兼容Nema17）
```

### 4.4 材料与打印参数

```ini
材料: PETG（推荐）或 ABS
层高: 0.2mm
填充: 50%
壁厚: 4mm
支撑: 需要（滑轨底座需支撑）
打印方向: 底座平放，滑块平放
滑块配合间隙: 建议 slicer 中将滑块缩小 0.1-0.2mm 确保滑动
```

### 4.5 装配步骤

#### 第一步：打印与后处理
1. 切片时滑块建议 **XY 尺寸缩小 0.15mm**，确保配合间隙
2. 打印后用细砂纸（400目）轻轻打磨滑块侧面
3. 测试滑块在滑槽中的滑动顺畅度

#### 第二步：安装惰轮
1. 将 624ZZ 轴承压入惰轮（TensionerB_Idler）
2. 检查轴承转动是否顺畅无卡阻

#### 第三步：组装滑块
1. 将惰轮总成安装到滑块轴承座
2. 将波纹预压环安装到弹簧挂柱

#### 第四步：安装到电机支架
1. 使用 4× M3×8 螺丝将底座固定到原电机支架
2. 将滑块总成插入滑槽

#### 第五步：粗调皮带张力
1. 松开 M4 调节螺丝
2. 将皮带绕过惰轮
3. 手动推动滑块初步定位

#### 第六步：精调
1. 逐步旋入 M4 调节螺丝
2. 用手指按压皮带检测张力（1-2mm 下沉为佳）
3. 打印测试件验证

---

## 五、BOM（材料清单）

### 5.1 通用材料（两种方案均需购买）

| 物料 | 规格 | 数量 | 备注 |
|---|---|---|---|
| 624ZZ 轴承 | 内径4mm，外径16mm，高5mm | 方案A: 2个 / 方案B: 1个 | 务必选用轴承钢 |
| M3 螺丝 | M3×8 或 M3×10 | 4个 | 电机支架固定 |
| M4 调节螺丝 | M4×20 全螺纹 | 1个 | 张力调节 |
| M4 螺母 | 标准六角螺母 | 1个 | 锁紧调节螺丝 |
| M3 螺母 | 标准六角螺母 | 4个 | 电机支架固定（如果用螺纹孔） |

### 5.2 方案A额外材料

| 物料 | 规格 | 数量 | 备注 |
|---|---|---|---|
| 压缩弹簧 | 中径8mm，线径1.5mm，自由高16mm | 1个 | 可用 3D 打印弹簧替代 |
| M4 锁紧螺母 | 六角尼龙锁紧螺母 | 1个 | 防止调节后松动 |

### 5.3 购买渠道建议

- **轴承**：淘宝搜索 "624ZZ 轴承"，认准 C0/C3 精度，约 2-5 元/个
- **螺丝**：淘宝 "M3 M4 紧固件套装"，大量多种规格可选
- **弹簧**：淘宝 "压缩弹簧 定制"，提供参数即可订做

---

## 六、安装位置与皮带路径

### 6.1 TT310 CoreXY 皮带路径分析

```
            Y轴电机（背部）
               ╱╲
              ╱  ╲
      ══════╱════╲══════  ← 上层皮带
           ╲    ╱
            ╲  ╱
    X轴电机  ╲╱  X轴电机
    (左侧)    ↑    (右侧)
              │
         皮带张紧器
         (安装位置)
```

**安装位置建议**：
- **方案A（弹簧臂式）**：安装在 X 轴电机对侧（通常是右侧电机位置）
- **方案B（滑轨式）**：安装在皮带松弛侧或两电机中间位置

### 6.2 皮带张力判断标准

> **"皮带只需要在打印的时候不发生跳动即为合格"**

| 状态 | 手指按压下沉量 | 表现 | 处理 |
|---|---|---|---|
| 过松 | > 3mm | 打印跳齿、层纹 | 增加张力 |
| 合适 | 1-2mm | 无异响、打印正常 | 保持 |
| 过紧 | < 1mm | 轴承噪音、阻力大 | 减小张力 |

---

## 七、注意事项与维护

### 7.1 安装注意事项

1. **安装方向**：确保偏心轮/惰轮与皮带的接触面正确
2. **轴承方向**：有防尘盖的一面朝外（朝向皮带）
3. **螺丝扭矩**：M3 螺丝扭矩不超过 0.8 N·m，避免塑料崩牙
4. **PETG 特性**：打印后 24 小时内避免承重，让材料充分结晶

### 7.2 日常维护

- **每月检查**：检查皮带张力，必要时微调
- **每半年**：清理轴承，检查是否有异响
- **每年**：检查轴承转动是否顺畅，必要时更换

### 7.3 常见问题排查

| 问题 | 可能原因 | 解决方案 |
|---|---|---|
| idler/惰轮转动不顺畅 | 轴承安装歪斜或异物 | 重新压装轴承，清理异物 |
| 调节螺丝旋不动 | 螺纹磨损或塑料变形 | 攻丝或更换零件 |
| 皮带跳齿 | 张力不足 | 顺时针旋转调节螺丝增加张力 |
| 打印尺寸偏小 | 皮带过松或过紧 | 校准皮带张力后重新切片 |

---

## 八、STL 文件位置

```
enclosure/stl_v2/
├── TensionerA_Idler.stl         # 方案A - 偏心轮
├── TensionerA_Arm.stl           # 方案A - 弹簧臂
├── TensionerA_Base.stl          # 方案A - 底座
├── TensionerA_EccentricSleeve.stl # 方案A - 偏心套筒
├── TensionerA_Spring.stl        # 方案A - 压缩弹簧
├── TensionerA_Stop.stl          # 方案A - 限位块
├── TensionerB_Base.stl          # 方案B - 滑轨底座
├── TensionerB_Slider.stl        # 方案B - 滑块
├── TensionerB_Idler.stl         # 方案B - 滑轨惰轮
└── TensionerB_SpringRing.stl    # 方案B - 波纹预压环
```

---

## 九、生成脚本

STL 文件由以下 Python 脚本自动生成：

```bash
python3 scripts/redesign_v2/belt_tensioner_stl.py
```

如需调整尺寸参数，请编辑脚本顶部的 `PARAMETERS` 常量区域。

---

## 十、致谢

- 设计参考：大鱼TT原厂资料、B站 @大鱼DIY 视频系列
- Voron 皮带张紧器设计（GitHub: VoronDesign/Voron-0）
- 项目维护：汪汪队射手方案

---

*本文档由 OpenClaw AI Assistant 自动生成（2026-03-27）*
*STL 模型仅供个人学习研究使用*
