arbaleast/dayu-tt-all-in-one/docs/99-项目维护/GITHUB_COMPLETE.md

# GitHub 配置完成总结

## ✅ 已完成配置

### 1. 仓库基本信息
- **仓库地址**: https://github.com/arbaleast/dayu-tt-enclosure
- **仓库类型**: Public
- **主要分支**: master
- **提交次数**: 10+

### 2. 项目文档 (13个)
- ✅ README.md - 项目主文档
- ✅ CHANGELOG.md - 更新记录
- ✅ GITHUB_SYNC.md - GitHub同步说明
- ✅ SSH_SETUP.md - SSH配置详细指南
- ✅ SSH_QUICK_START.md - SSH快速入门
- ✅ 官方方案.md
- ✅ 汪汪队射手方案.md
- ✅ 李炫键降噪方案.md
- ✅ 皮带张紧器设计.md
- ✅ 装配指南.md
- ✅ ABS打印指南.md
- ✅ 开源文件资源.md
- ✅ 方案对比可视化.md

### 3. GitHub功能

#### Issue模板 (4个)
- 🐛 Bug 报告
- ✨ 功能建议
- 🖼️ 分享你的作品
- 📦 资源分享

#### 自动化
- 🏷️ 自动标签（配置完成，需手动启用）
- 🔄 自动同步（配置完成，需手动启用）

### 4. 工具脚本
- ✅ `sync.sh` - 自动同步脚本
- ✅ `setup-ssh.sh` - SSH配置脚本

### 5. 项目结构
```
dayu-tt-enclosure/
├── README.md
├── CHANGELOG.md
├── GITHUB_SYNC.md
├── SSH_SETUP.md
├── SSH_QUICK_START.md
├── sync.sh
├── setup-ssh.sh
├── bom/
│   └── 完整物料清单.csv
├── docs/ (11个文档)
├── images/ (5个子目录)
├── stls/ (空，待补充)
├── models/ (空，待补充)
└── .github/
    ├── GITHUB_ACTIONS.md
    ├── WORKFLOWS_SETUP.md
    └── ISSUE_TEMPLATE/ (4个模板)
```

## 📋 待完成事项

### 高优先级
- [ ] 添加SSH公钥到GitHub
  - 访问: https://github.com/settings/keys
  - 或运行: `./setup-ssh.sh`

- [ ] 获取开源文件
  - 联系汪汪队射手
  - 下载STL文件
  - 放入 `stls/` 目录

### 中优先级
- [ ] 收集参考图片
  - B站视频截图
  - 放入 `images/` 目录

- [ ] 启用GitHub Actions工作流
  - 手动创建 `.github/workflows/auto-sync.yml`
  - 参考 `.github/WORKFLOWS_SETUP.md`

### 低优先级
- [ ] 完善文档
  - 添加更多UP主方案
  - 补充打印参数

- [ ] 社区建设
  - 邀请其他人贡献
  - 收集用户反馈

## 🚀 快速开始

### 1. 配置SSH访问（推荐）
```bash
./setup-ssh.sh
```

### 2. 同步到GitHub
```bash
./sync.sh "更新说明"
```

### 3. 获取STL文件后
```bash
# 放入 stls/ 目录
./sync.sh "添加汪汪队射手STL文件"
```

## 📊 项目统计

| 类别 | 数量 |
|-----|---|
| Markdown文档 | 13个 |
| Issue模板 | 4个 |
| 脚本文件 | 2个 |
| 目录 | 7个 |
| Git提交 | 10+次 |

## 🔗 重要链接

- **GitHub仓库**: https://github.com/arbaleast/dayu-tt-enclosure
- **SSH设置**: https://github.com/settings/keys
- **Actions页面**: https://github.com/arbaleast/dayu-tt-enclosure/actions
- **Issues页面**: https://github.com/arbaleast/dayu-tt-enclosure/issues

## 💡 使用建议

1. **定期同步** - 每次修改后运行 `./sync.sh`
2. **获取文件** - 优先联系UP主获取STL
3. **分享成果** - 完成后在Issues分享作品
4. **持续改进** - 根据使用经验更新文档

## 📞 获取帮助

- 查看文档: `docs/` 目录
- SSH配置: `SSH_QUICK_START.md`
- GitHub功能: `.github/GITHUB_ACTIONS.md`
- 同步问题: `GITHUB_SYNC.md`

---

**配置完成时间**: 2026-03-22 14:45  
**GitHub仓库**: https://github.com/arbaleast/dayu-tt-enclosure  
**状态**: ✅ 基础配置完成，待补充资源
