arbaleast/dayu-tt-all-in-one/docs/99-项目维护/GITHUB_SYNC.md

# GitHub 同步完成！

## ✅ 已完成操作

### 1. 创建GitHub仓库
- **仓库地址**: https://github.com/arbaleast/dayu-tt-enclosure
- **仓库类型**: Public（公开）
- **描述**: 大鱼TT 3D打印机封箱方案收集整理

### 2. 推送项目文件
已推送的文件：
- ✅ README.md（含GitHub徽章和链接）
- ✅ 所有文档（11个Markdown文件）
- ✅ 物料清单（CSV文件）
- ✅ 目录结构（stls/, models/, images/）
- ✅ 同步脚本（sync.sh）
- ✅ Git配置（.gitignore）

### 3. 创建自动同步脚本
- **文件**: `sync.sh`
- **用法**: `./sync.sh "提交信息"`
- **功能**: 自动添加、提交、推送

## 📊 仓库状态

```
提交历史:
b8e3fd4 Update README with GitHub info
├── df2dc28 Add sync script
├── 7feee6e Add GitHub Actions workflow
└── 721b918 Initial commit

文件统计:
- Markdown文档: 11个
- CSV文件: 1个
- 脚本: 1个
- 目录: 7个
```

## 🚀 如何使用

### 快速同步（推荐）
```bash
cd /home/arbaleast/.openclaw/workspace/projects/dayu-tt-enclosure
./sync.sh "你的更新说明"
```

### 手动同步
```bash
git add -A
git commit -m "更新说明"
git push origin master
```

## 📝 后续操作

### 获取STL文件后
1. 将文件放入 `stls/汪汪队射手/`
2. 运行 `./sync.sh "添加汪汪队射手STL文件"`
3. 文件自动同步到GitHub

### 添加图片后
1. 将图片放入 `images/对应目录/`
2. 运行 `./sync.sh "添加参考图片"`
3. 图片自动同步到GitHub

### 更新文档
1. 编辑对应的 `.md` 文件
2. 运行 `./sync.sh "更新文档内容"`
3. 变更自动同步到GitHub

## 🔗 相关链接

- **GitHub仓库**: https://github.com/arbaleast/dayu-tt-enclosure
- **项目文档**: 见仓库README.md
- **同步脚本**: `./sync.sh`

## 💡 提示

- 每次修改后运行 `./sync.sh` 即可自动同步
- 提交信息要清晰，方便追溯历史
- 大文件（STL）建议使用Git LFS（可选）

---
*同步完成时间: 2026-03-22 14:33*
