arbaleast/dayu-tt-all-in-one/docs/FIRMWARE/FIRMWARE.md

# FIRMWARE — 固件配置

## 索引

| 序号 | 文档 | 说明 |
|---|---|---|
| 01 | Klipper固件配置完全指南 | 完整配置参考 |
| 02 | printer.cfg模板 | 实际配置模板 |

## 领域负责人
固件专家
