arbaleast/dayu-tt-all-in-one/source/B站【大鱼DIY】3D打印机Dayu TT V1.21全套资料/顶部增高架/顶部增高架.md

# 顶部增高架.jpg 图像描述

**原始文件:** /vol1/1000/projects/3d-printing/dayu-tt-all-in-one/source/B站【大鱼DIY】3D打印机Dayu TT V1.21全套资料/TT235资料/TT235封箱资料/顶部增高架/顶部增高架.jpg

## 内容说明

TT235/TT310 顶部 Z 轴增高架设计图。

主要内容：
- 增高架 3D 模型渲染图
- 铝型材连接方式
- 打印件安装位置
- 适用机型：TT235、TT310

相关文档：docs/01-封箱方案/TT310封箱资料/
