arbaleast/dayu-tt-all-in-one/source/B站【大鱼DIY】3D打印机Dayu TT V1.21全套资料/TT235资料/TT235封箱资料/TT235封箱说明.md

# TT235封箱说明.jpg 图像描述

**原始文件:** /vol1/1000/projects/3d-printing/dayu-tt-all-in-one/source/B站【大鱼DIY】3D打印机Dayu TT V1.21全套资料/TT235资料/TT235封箱资料/TT235封箱说明.jpg

## 内容说明

TT235 机型封箱方案说明图。

主要内容：
- TT235 封箱结构展示
- 铝型材框架尺寸标注
- 板材切割尺寸示意图
- 散热风扇安装位置
- 门板铰链安装位置
- 封箱完成效果图

适用机型：TT235（235×235×235mm）

相关文档：docs/01-封箱方案/汪汪队射手方案.md
