arbaleast/dayu-tt-all-in-one/source/B站【大鱼DIY】3D打印机Dayu TT V1.21全套资料/TT310资料/TT310封箱资料/TT310封箱说明.md

# TT310封箱说明.jpg 图像描述

**原始文件:** /vol1/1000/projects/3d-printing/dayu-tt-all-in-one/source/B站【大鱼DIY】3D打印机Dayu TT V1.21全套资料/TT310资料/TT310封箱资料/TT310封箱说明.jpg

## 内容说明

TT310 机型封箱方案说明图。

主要内容：
- TT310 封箱结构展示（310×310×310mm）
- 2020/2040 铝型材框架
- 板材切割尺寸标注
- BOSSAC 热床安装位置
- 散热系统布局
- 风道设计
- 顶部增高架方案
- 门板密封方案

适用机型：TT310

相关文档：docs/01-封箱方案/官方方案.md、docs/02-硬件改进/封箱散热BOSSAC热床改装指南.md
