arbaleast/dayu-tt-all-in-one/source/B站【大鱼DIY】3D打印机Dayu TT V1.21全套资料/通用辅助功能配件_非必须/01_PEI板定位块/PEI板定位块配件及安装说明.md

# PEI板定位块配件及安装说明.jpg 图像描述

**原始文件:** /vol1/1000/projects/3d-printing/dayu-tt-all-in-one/source/B站【大鱼DIY】3D打印机Dayu TT V1.21全套资料/通用辅助功能配件_非必须/01_PEI板定位块/PEI板定位块配件及安装说明.jpg

## 内容说明

PEI 板定位块配件安装说明图。

主要内容：
- PEI 板定位块 3D 打印件展示
- 安装位置示意图
- 热床定位效果
- 配件清单（数量、规格）
- 安装工具需求
- 适用场景：提升首层附着力和热床找平精度

相关文档：docs/02-硬件改进/硬件改进资料汇总.md
