arbaleast/dayu-tt-all-in-one/source/B站【大鱼DIY】3D打印机Dayu TT V1.21全套资料/通用辅助功能配件_非必须/03_同步带辅助调节器/同步带辅助调节器配件及安装说明.md

# 同步带辅助调节器配件及安装说明.jpg 图像描述

**原始文件:** /vol1/1000/projects/3d-printing/dayu-tt-all-in-one/source/B站【大鱼DIY】3D打印机Dayu TT V1.21全套资料/通用辅助功能配件_非必须/03_同步带辅助调节器/同步带辅助调节器配件及安装说明.jpg

## 内容说明

同步带张力调节辅助工具安装说明。

主要内容：
- 辅助调节器 3D 打印件展示
- 安装位置（在惰轮或电机处）
- GT2 同步带穿入方式
- 张力调节效果
- 适用场景：CoreXY 结构皮带的张紧调节

相关文档：docs/01-封箱方案/皮带张紧器设计.md
