arbaleast/dayu-tt-all-in-one/source/B站【大鱼DIY】3D打印机Dayu TT V1.21全套资料/通用辅助功能配件_非必须/07_品字开关安装座/品字开关安装说明.md

# 品字开关安装说明.png 图像描述

**原始文件:** /vol1/1000/projects/3d-printing/dayu-tt-all-in-one/source/B站【大鱼DIY】3D打印机Dayu TT V1.21全套资料/通用辅助功能配件_非必须/07_品字开关安装座/品字开关安装说明.png

## 内容说明

品字开关安装座 3D 打印件说明图。

主要内容：
- 品字开关（电源输入插座）安装座设计
- 打印件外观展示
- 安装位置示意
- 适配 86 型底盒
- 适用场景：封箱后的电源开关布置
