arbaleast/dayu-tt-all-in-one/source/B站【大鱼DIY】3D打印机Dayu TT V1.21全套资料/通用辅助功能配件_非必须/08_过线套/过线套.md

# 过线套.png 图像描述

**原始文件:** /vol1/1000/projects/3d-printing/dayu-tt-all-in-one/source/B站【大鱼DIY】3D打印机Dayu TT V1.21全套资料/通用辅助功能配件_非必须/08_过线套/过线套.png

## 内容说明

过线套 3D 打印件说明图。

主要内容：
- 过线套外观展示
- 尺寸规格
- 适用场景：打印线缆穿过封箱板材时的保护和密封
