arbaleast/dayu-tt-all-in-one/source/B站【大鱼DIY】3D打印机Dayu TT V1.21全套资料/通用辅助功能配件_非必须/09_护线套/护线套.md

# 护线套.png 图像描述

**原始文件:** /vol1/1000/projects/3d-printing/dayu-tt-all-in-one/source/B站【大鱼DIY】3D打印机Dayu TT V1.21全套资料/通用辅助功能配件_非必须/09_护线套/护线套.png

## 内容说明

护线套 3D 打印件说明图。

主要内容：
- 护线套外观展示
- 尺寸规格
- 适用场景：线缆进出口保护，防止线缆被板材边缘割伤
