arbaleast/dayu-tt-all-in-one/source/B站【大鱼DIY】3D打印机Dayu TT V1.21全套资料/通用辅助功能配件_非必须/10_气动接头安装扣/气动接头安装扣.md

# 气动接头安装扣.png 图像描述

**原始文件:** /vol1/1000/projects/3d-printing/dayu-tt-all-in-one/source/B站【大鱼DIY】3D打印机Dayu TT V1.21全套资料/通用辅助功能配件_非必须/10_气动接头安装扣/气动接头安装扣.png

## 内容说明

气动接头安装扣 3D 打印件说明图。

主要内容：
- 安装扣外观展示
- 适用气动接头规格
- 安装位置示意
- 适用场景：气动接头（如气阀、气弹簧）的固定
