arbaleast/dayu-tt-all-in-one/source/B站【大鱼DIY】3D打印机Dayu TT V1.21全套资料/通用辅助功能配件_非必须/11_5015风道_带支架/5015风道.md

# 5015风道.png 图像描述

**原始文件:** /vol1/1000/projects/3d-printing/dayu-tt-all-in-one/source/B站【大鱼DIY】3D打印机Dayu TT V1.21全套资料/通用辅助功能配件_非必须/11_5015风道_带支架/5015风道.png

## 内容说明

5015 风扇风道 3D 打印件说明图。

主要内容：
- 5015 风扇风道外壳设计展示
- 配套支架设计
- 安装位置示意
- 适用场景：热端散热或模型冷却风道设计

相关文档：docs/02-硬件改进/封箱散热BOSSAC热床改装指南.md
