arbaleast/dayu-tt-all-in-one/source/B站【大鱼DIY】3D打印机Dayu TT V1.21全套资料/通用辅助功能配件_非必须/13_辅助散热风扇/辅助散热风扇.md

# 辅助散热风扇.jpg 图像描述

**原始文件:** /vol1/1000/projects/3d-printing/dayu-tt-all-in-one/source/B站【大鱼DIY】3D打印机Dayu TT V1.21全套资料/通用辅助功能配件_非必须/13_辅助散热风扇/辅助散热风扇.jpg

## 内容说明

辅助散热风扇 3D 打印安装支架说明图。

主要内容：
- 5015/4010 等规格风扇安装支架设计
- 安装位置示意
- 风道连接方式
- 适用场景：提升热端散热效果，特别是高速打印 PETG/ABS 时

相关文档：docs/02-硬件改进/封箱散热BOSSAC热床改装指南.md
