arbaleast/dayu-tt-all-in-one/source/B站【大鱼DIY】3D打印机Dayu TT V1.21全套资料/通用辅助功能配件_非必须/02_上位机_红米2A安装盒/抽屉版/红米2A安装说明.md

# 红米2A安装说明.png 图像描述

**原始文件:** /vol1/1000/projects/3d-printing/dayu-tt-all-in-one/source/B站【大鱼DIY】3D打印机Dayu TT V1.21全套资料/通用辅助功能配件_非必须/02_上位机_红米2A安装盒/抽屉版/红米2A安装说明.png

## 内容说明

红米 2A 手机作为 Klipper 上位机的安装说明图。

主要内容：
- 红米 2A 手机外观
- 抽屉版安装盒设计
- 内部固定结构
- 散热考虑
- USB 连接方式
- 屏幕朝向（通常斜放便于监控）

适用场景：将废旧手机改为打印机监控上位机，节省树莓派成本
