arbaleast/dayu-tt-all-in-one/images/README.md

# 图片资源

本目录用于存放项目中引用的图片资源。

> ⚠️ 当前为空，图片需从 B站视频/MakerWorld 补充。
