arbaleast/dayu-tt-all-in-one/source/TT150/README.md

# 待补充
B站视频资料待从 B站/MakerWorld 补充 STEP/SolidWorks 文件
