arbaleast/dayu-tt-all-in-one/docs/MECHANICAL/MECHANICAL.md

# MECHANICAL — 机械工程

## 索引

| 序号 | 文档 | 说明 |
|---|---|---|
| 01 | 大鱼TT规格确认表 | 工程基准数据 |
| 02 | Voron 2.4 规格对照表 | 对标规格 |
| 03 | TT310 薄弱点分析 | 机械弱点识别 |
| 04 | CoreXY 深度研究报告 | 改装方案 |
| 05 | 封箱方案对比 | 封闭方案选型 |
| 06 | 大鱼TT从零DIY完全指南 | 入门教程 |

## 领域负责人
机械专家
