arbaleast/dayu-tt-all-in-one/docs/MECHANICAL/14_方案对比可视化.md

# 方案对比可视化

## 方案总览

```
┌─────────────────────────────────────────────────────────────┐
│                    大鱼TT 封箱方案对比                        │
├──────────────┬──────────────┬──────────────┬──────────────┤
│   官方方案    │ 汪汪队射手   │  李炫键      │   简装版     │
│   ¥1600+     │   ¥1200+    │   ¥1500+    │   ¥1000+    │
├──────────────┼──────────────┼──────────────┼──────────────┤
│ ⭐⭐⭐⭐⭐    │ ⭐⭐⭐⭐⭐    │ ⭐⭐⭐⭐      │ ⭐⭐⭐        │
│  性能稳定     │  维护性好    │  降噪优秀    │  成本低      │
├──────────────┼──────────────┼──────────────┼──────────────┤
│              │              │              │              │
│  [图片占位]   │  [图片占位]   │  [图片占位]   │  [图片占位]   │
│  官方渲染图   │  魔改实物图   │  降噪版外观   │  简装示意图   │
│              │              │              │              │
└──────────────┴──────────────┴──────────────┴──────────────┘
```

## 详细对比

### 成本构成

```
成本对比（元）
│
│ 官方方案    ████████████████████████████████████████ 1600
│ 汪汪队射手  ████████████████████████████████████     1400
│ 李炫键      ██████████████████████████████████████   1500
│ 简装版      ████████████████████████████             1000
│
└────────────────────────────────────────────────────────────
              0    500   1000   1500   2000
```

### 功能对比

| 功能 | 官方方案 | 汪汪队射手 | 李炫键 | 简装版 |
|-----|---|---|---|---|
| 基础封箱 | ✅ | ✅ | ✅ | ✅ |
| 皮带张紧优化 | ❌ | ✅ | ❌ | ❌ |
| 降噪设计 | ⚠️ | ⚠️ | ✅ | ❌ |
| 温控系统 | ✅ | ✅ | ✅ | ⚠️ |
| 通风过滤 | ✅ | ✅ | ✅ | ❌ |
| LED照明 | ✅ | ✅ | ✅ | ❌ |
| 维护便利性 | ⚠️ | ✅ | ⚠️ | ⚠️ |

图例：
- ✅ 完整支持
- ⚠️ 基础支持
- ❌ 不支持

### 难度对比

```
装配难度
│
│ 简装版      ██░░░░░░░░ 简单
│ 官方方案    ██████░░░░ 中等
│ 汪汪队射手  ███████░░░ 中等偏难
│ 李炫键      ████████░░ 较难
│
└────────────────────────────
```

## 推荐选择

### 按需求推荐

#### 🏆 综合最佳：汪汪队射手方案
- 适合：有一定动手能力，追求维护便利性
- 亮点：皮带张紧器设计
- 成本：¥1200-1600

#### 🔇 静音优先：李炫键方案
- 适合：对噪音敏感，打印机在卧室/书房
- 亮点：专业降噪设计
- 成本：¥1500+

#### ⚡ 性能优先：官方方案
- 适合：追求稳定性能，不想折腾
- 亮点：官方支持，社区资源多
- 成本：¥1600+

#### 💰 预算优先：简装版
- 适合：预算有限，基础需求
- 亮点：成本低，易上手
- 成本：¥1000+

### 按场景推荐

| 使用场景 | 推荐方案 | 原因 |
|---|---|---|
| 卧室/书房 | 李炫键 | 降噪最重要 |
| 客厅 | 汪汪队射手 | 维护方便 |
| 工作室 | 官方方案 | 性能稳定 |
| 学生/预算有限 | 简装版 | 成本控制 |
| 频繁维护 | 汪汪队射手 | 张紧器设计 |
| 打印ABS为主 | 任意+温控 | 保温是关键 |

## 决策流程图

```
开始
 │
 ├─ 预算 < ¥1000? ──→ 简装版
 │
 ├─ 对噪音敏感? ────→ 李炫键方案
 │
 ├─ 追求维护便利? ──→ 汪汪队射手
 │
 └─ 追求稳定性能? ──→ 官方方案
```

## 图片引用示例

在文档中引用图片：

```markdown
### 汪汪队射手皮带张紧器
![皮带张紧器](../images/汪汪队射手方案/皮带张紧器特写_01.jpg)
*皮带张紧器安装位置*

### 官方封箱效果图
![官方方案](../images/官方方案/整体效果图_01.jpg)
*官方封箱渲染图*

### 装配过程
![框架组装](../images/装配过程/框架组装_01.jpg)
*第一步：组装铝型材框架*
```

## 待补充图片清单

### 高优先级
- [ ] 各方案整体效果图
- [ ] 皮带张紧器细节图
- [ ] 装配关键步骤图
- [ ] 成品展示图

### 中优先级
- [ ] 材料实物图
- [ ] 工具展示图
- [ ] 对比测试图

### 低优先级
- [ ] 维护过程图
- [ ] 故障示例图
- [ ] 改进方案图

---
*图片收集后，更新此文档添加实际图片引用*
