arbaleast/dayu-tt-all-in-one/docs/MECHANICAL/15_李炫键降噪方案.md

# 李炫键 - 大鱼TT封箱降噪方案

## 方案概述

UP主：李炫键  
核心特点：**专注降噪优化**

## 视频教程

| 视频标题 | 发布时间 | 播放量 | 主要内容 |
|---|---|---|---|
| 大鱼TT封箱2.0（降噪版） | 2023-12-20 | 2.7万 | 降噪优化方案 |
| 大鱼TT封箱分享及维护 | 2023-12-08 | 2万+ | 使用维护经验 |
| 大鱼TT使用分享 | 2023-11-24 | 2.5万 | 综合使用体验 |
| 大鱼TT组装分享 | 2023-11-27 | 1.2万 | 组装过程 |

## 方案特点

### 降噪设计

1. **隔音材料**
   - 使用吸音棉
   - 双层板材设计
   - 密封条优化

2. **减震设计**
   - 减震脚垫
   - 框架减震连接
   - 风扇减震安装

3. **风扇降噪**
   - 低噪音风扇选型
   - 风扇转速控制
   - 风道优化

## 降噪效果

根据视频反馈，封箱后噪音降低约 **10-15dB**

| 状态 | 噪音水平 | 主观感受 |
|-----|---|---|
| 未封箱 | 55-60dB | 明显噪音，影响交谈 |
| 封箱后 | 40-45dB | 轻微噪音，可接受 |

## 材料清单（降噪专用）

### 隔音材料

| 材料 | 规格 | 数量 | 参考价格 |
|-----|---|---|---|
| 吸音棉 | 20-30mm | 适量 | ¥50-80 |
| 隔音毡 | 2-3mm | 适量 | ¥40-60 |
| 密封条 | 高密度 | 5米 | ¥20-30 |

### 减震材料

| 材料 | 规格 | 数量 | 参考价格 |
|-----|---|---|---|
| 减震脚垫 | 橡胶 | 4-8个 | ¥20-40 |
| 减震垫片 | 硅胶 | 若干 | ¥10-20 |

### 低噪音风扇

| 型号 | 规格 | 数量 | 参考价格 |
|-----|---|---|---|
| 静音风扇 | 4010/4020 | 2-3个 | ¥40-80 |
| 风扇减震垫 | 配套 | 若干 | ¥10-15 |

## 降噪技巧

### 1. 框架减震
- 铝型材连接处加减震垫片
- 底部安装橡胶减震脚垫
- 避免金属直接接触

### 2. 板材隔音
- 双层板材设计（外层亚克力+内层吸音棉）
- 板材边缘密封处理
- 减少共振空腔

### 3. 风扇降噪
- 选择低转速、大风量风扇
- 风扇安装加减震垫
- 优化风道，减少湍流

### 4. 门密封
- 使用高密度磁吸条
- 门缝贴密封条
- 减少缝隙漏音

## 装配建议

### 步骤1：框架减震
1. 底部安装橡胶减震脚垫
2. 型材连接处加硅胶垫片
3. 检查所有连接点

### 步骤2：隔音层安装
1. 内侧贴吸音棉
2. 关键位置加隔音毡
3. 注意留出散热空间

### 步骤3：风扇安装
1. 选择静音风扇
2. 安装减震垫
3. 测试风扇噪音

### 步骤4：门密封
1. 安装磁吸条
2. 门缝贴密封条
3. 检查密封效果

## 维护建议

1. **定期检查** - 检查密封条是否老化
2. **清洁保养** - 定期清洁吸音棉表面灰尘
3. **风扇维护** - 定期清理风扇灰尘，保持低噪音

## 适用人群

✅ **推荐**：
- 对噪音敏感的用户
- 打印机放在卧室/书房
- 需要长时间打印

❌ **不推荐**：
- 预算非常有限（降噪材料增加成本）
- 打印空间极度紧张（隔音层占用空间）

## 参考链接

- [B站主页-李炫键](https://space.bilibili.com)
- [视频-大鱼TT封箱2.0降噪版](https://www.bilibili.com)

---
*降噪方案需要权衡成本和效果，建议根据实际需求选择*
