arbaleast/dayu-tt-all-in-one/docs/AI/AI.md

# AI — AI 智能化

## 索引

| 序号 | 文档 | 说明 |
|---|---|---|
| 01 | ADXL345-InputShaper实际校准执行指南 | 校准指南 |
| 02 | 大鱼TT当前调平方案与API | 调平调研 |

## 领域负责人
AI专家
