arbaleast/dayu-tt-all-in-one/docs/THERMAL/THERMAL.md

# THERMAL — 热管理系统

## 索引

| 序号 | 文档 | 说明 |
|---|---|---|
| 01 | 封闭腔体热管理规范化指南 | 温控规范 |
| 02 | 加热系统选型报告 | 加热功率计算 |

## 领域负责人
热管理专家
