arbaleast/dayu-tt-all-in-one/source/B站【大鱼DIY】3D打印机Dayu TT V1.21全套资料/TT235资料/TT235封箱资料/顶部增高架/顶部增高架.jpg

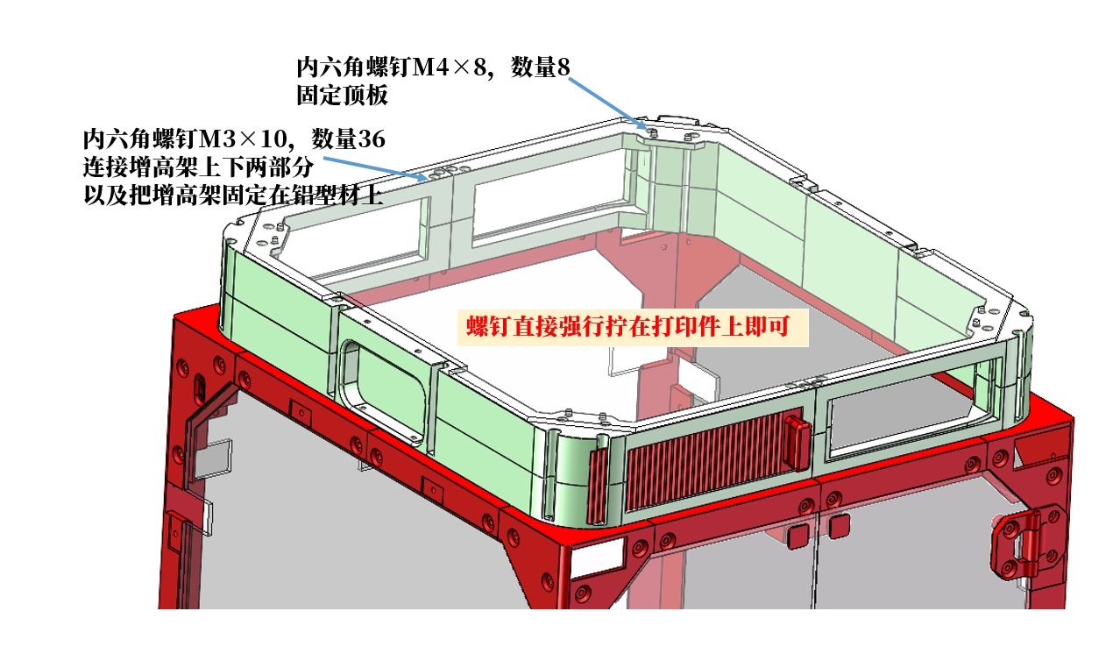
source/B站【大鱼DIY】3D打印机Dayu TT V1.21全套资料/TT235资料/TT235封箱资料/顶部增高架/顶部增高架.jpg
