arbaleast/dayu-tt-all-in-one/source/B站【大鱼DIY】3D打印机Dayu TT V1.21全套资料/通用辅助功能配件_非必须/01_PEI板定位块/PEI板定位块配件及安装说明.jpg

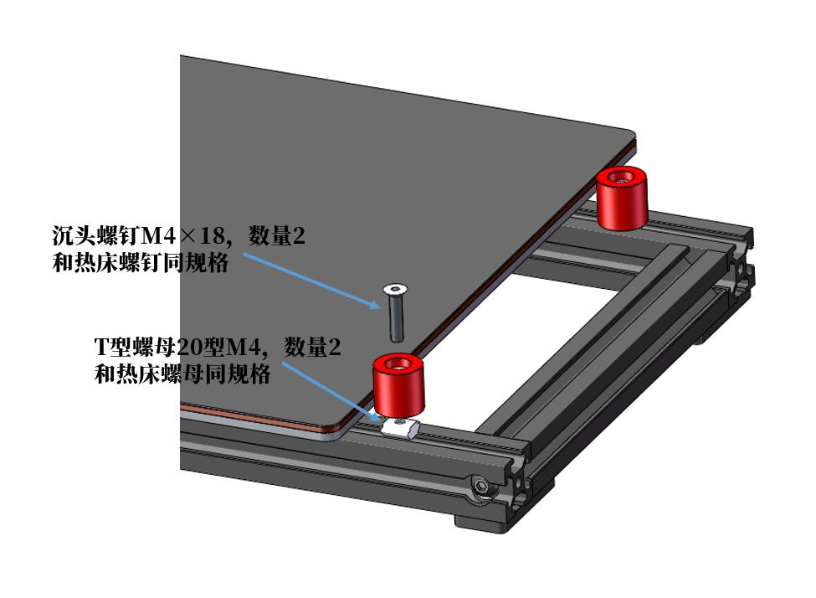
source/B站【大鱼DIY】3D打印机Dayu TT V1.21全套资料/通用辅助功能配件_非必须/01_PEI板定位块/PEI板定位块配件及安装说明.jpg
