arbaleast/dayu-tt-all-in-one/enclosure/BOM.md

# 大鱼TT 310 封箱 V2 BOM 物料清单 / Bill of Materials

> 版本: 2.0.0（V2 重新设计）  
> 日期: 2026-03-26  
> 状态: 草稿 / DRAFT  
> 依据: 工程分析结论（侧板加厚至 4mm）

---

## 一、亚克力板 / Acrylic Panels

| 编号 | 名称 | 尺寸 (mm) | 数量 | 厚度 | 材料 | 单价估算 | 小计 | DXF 文件 |
|---|---|---|---|---|---|---|---|---|
| P-01 | 侧板 X（左右）| 520×770 | 2 | **4mm** | 透明亚克力 | ¥25 | ¥50 | `SIDE_PANEL_X2_520x770x4.DXF` |
| P-02 | 侧板 Y（前后）| 530×770 | 2 | **4mm** | 透明亚克力 | ¥28 | ¥56 | `SIDE_PANEL_Y2_530x770x4.DXF` |
| P-03 | 顶板 | 520×530 | 1 | 3mm | 透明亚克力 | ¥12 | ¥12 | `TOP_PANEL_520x530x3.DXF` |
| P-04 | 底板 | 520×530 | 1 | 5mm | 透明亚克力 | ¥18 | ¥18 | `BOTTOM_PANEL_520x530x5.DXF` |
| P-05 | 后板 | 530×770 | 1 | 3mm | 透明亚克力 | ¥15 | ¥15 | `BACK_PANEL_530x770x3.DXF` |
| P-06 | 前门板 | 520×745 | 1 | 5mm | 透明亚克力 | ¥18 | ¥18 | `FRONT_DOOR_520x745x5.DXF` |

**切割公差**: ±0.5mm  
**亚克力板合计估算**: ¥169（激光切割另加 ¥50~100 开料费）

> ⚠️ 侧板 4mm 加厚：工程分析结论——3mm 在风扇抽风 ΔP=50Pa 下挠度 6mm

---

## 二、3D 打印件 / 3D Printed Parts

### V2 重新设计件（`stl_v2/`）

| 编号 | 零件名称 | 数量 | 材料 | 打印层高 | 填充 | STL 文件 |
|---|---|---|---|---|---|---|
| B-01 | 底部支架 | 4 | **PETG** | 0.2mm | 100% | `BottomBracketV2.stl` |
| B-02 | 脚垫安装座 | 4 | **PETG** | 0.2mm | 80% | `FootMountV2.stl` |
| B-03 | 脚垫 | 4 | **TPU95A** | 0.24mm | 20% | `FootPadV2.stl` |
| B-04 | 面板快拆卡扣 | 16 | **PETG** | 0.2mm | 60% | `SidePanelClipV2.stl` |
| B-05 | 120mm 顶部风扇罩 | 1 | **PETG** | 0.2mm | 60% | `TopFanMountV2.stl` |
| B-06 | 线缆密封入口 | 2 | **PETG** | 0.2mm | 60% | `CableEntryRingV2.stl` |
| B-07 | 磁铁快拆座 | 6 | **PETG** | 0.2mm | 60% | `MagnetHolderV2.stl` |
| B-08 | 门铰链安装座 | 3对 | **PETG** | 0.2mm | 60% | `DoorHingeMountV2.stl` |

### 打印说明
- **PETG**: 喷嘴 240°C / 热床 80°C / 速度 40mm/s / 冷却 30%
- **TPU**: 喷嘴 220°C / 热床 50°C / 速度 25mm/s / 冷却 0%
- 底部支架 B-01 **必须 100% 填充**（受力件）
- ⚠️ **PLA 禁止使用**（封箱内腔温可达 46°C，PLA 55°C 软化）

---

## 三、五金件 / Hardware

| 编号 | 名称 | 规格 | 数量 | 单价 | 小计 | 备注 |
|---|---|---|---|---|---|---|
| H-01 | 内六角螺丝 | M3×10 沉头 | 30 | ¥0.3 | ¥9 | 面板固定 |
| H-02 | 内六角螺丝 | M3×8 沉头 | 20 | ¥0.3 | ¥6 | 风扇/铰链 |
| H-03 | 内六角螺丝 | M6×20 | 4 | ¥0.8 | ¥3 | 调整脚 |
| H-04 | T型螺母 | M3 | 40 | ¥0.2 | ¥8 | 2020框架 |
| H-05 | T型螺母 | M6 | 4 | ¥0.3 | ¥1 | 调整脚 |
| H-06 | 小型铰链 | 30-40mm | 3对 | ¥5 | ¥15 | 前门板 |
| H-07 | 钕磁铁 | Ø10×3mm N52 | 6 | ¥2 | ¥12 | 门板快拆 |
| H-08 | 铁片 | Ø12×0.5mm | 6 | ¥0.5 | ¥3 | 磁铁对面 |
| H-09 | 可调脚 | M6×40 | 4 | ¥3 | ¥12 | 机箱高度 |
| H-10 | D型密封条 | 5×5mm | 2.5m | ¥3/m | ¥8 | 门框四周 |
| H-11 | P型密封条 | 3×3mm | 3m | ¥2/m | ¥6 | 板间接缝 |

**五金合计估算**: ¥83

---

## 四、散热与电气 / Cooling

| 编号 | 名称 | 规格 | 数量 | 单价 | 小计 | 备注 |
|---|---|---|---|---|---|---|
| C-01 | 散热风扇 | Noctua NF-A12x25 或等效 120mm | 1-2 | ¥80 | ¥80 | 排风 |
| C-02 | 过滤棉 | 120×120×3mm | 2 | ¥5 | ¥10 | 耗材 |

**散热合计估算**: ¥90

---

## 五、总成本估算

| 类别 | 金额 |
|---|---|
| 亚克力板 + 切割费 | ¥219 |
| 3D 打印件（PETG + TPU）| ¥50 |
| 五金件 | ¥83 |
| 散热风扇 | ¥90 |
| 密封条 | ¥14 |
| **合计** | **¥456** |

> 注：未含运费和各地价格差异，仅参考

---

## 六、采购建议

1. **亚克力板**：淘宝搜"激光切割亚克力板"，发 DXF 文件给商家报价
   - ⚠️ 侧板必须 **4mm 厚度**，注明透明
2. **PETG/TPU 耗材**：建议储备 500g 以上
3. **密封条**：淘宝搜"D型密封条 5mm 海绵" + "P型密封条 3mm 海绵"
4. **风扇**：Noctua NF-A12x25 静音首选，也可选等价 120mm 风扇

---

## 七、V2 变更记录

| 日期 | 变更 |
|---|---|
| 2026-03-26 | 侧板从 3mm 加厚至 **4mm**（工程分析结论）|
| 2026-03-26 | 尺寸从 510×760 改为 **520×770**（基于 STEP 实测 478mm 机身）|
| 2026-03-26 | 整体重新设计，参数化代码生成 |

---

*由 OpenClaw AI 生成 | V2 BOM | 2026-03-26*
