arbaleast/dayu-tt-all-in-one/docs/VALIDATION/04_TT310采购清单.md

# TT310 采购清单（基于机械薄弱点分析）

> 生成时间：2026-03-29  
> 基础：TT310机械薄弱点分析 + 大鱼TT规格确认表  
> 目标：P0紧急改进 + P1重要改进

---

## P0 阶段（必须立即执行）

### P0-1：底部框架 2020→2040 升级

| 配件 | 规格 | 数量 | 参考价 | 渠道 |
|---|---|---|---|---|
| 2040 铝型材 | 330mm（2根）| 2根 | ¥30-40/根 | 淘宝/本地 |
| 2040 角码连接件 | M5 螺纹 | 4个 | ¥5-8/个 | 淘宝 |
| M5 T型螺母 | 2020规格 | 20个 | ¥10 | 淘宝 |

**预估总价：** ¥95-125

**说明：** 仅更换底部两根承重梁，保持其他框架不变。2040比2020弯曲刚度高约2倍，大幅降低热床运动时的框架振动。

---

### P0-2：对角斜撑（防菱形变形）

| 配件 | 规格 | 数量 | 参考价 | 渠道 |
|---|---|---|---|---|
| 2020 铝型材 | 400mm（对角长度）| 2根 | ¥15-20/根 | 淘宝 |
| 对角角码 | 2020 45度连接 | 4个 | ¥5-8/个 | 淘宝 |
| M5 T型螺母 | 预装型 | 16个 | ¥5 | 淘宝 |

**预估总价：** ¥50

**说明：** 安装在框架底部对角位置，将矩形框架变为稳定三角结构，消除搬运和高速打印时的菱形变形。

---

### P0-3：保温棉 + 边缘密封

| 配件 | 规格 | 数量 | 参考价 | 渠道 |
|---|---|---|---|---|
| 石棉保温棉 | 10mm厚 | 1卷 | ¥15-20 | 五金店 |
| 黑色泡沫密封条 | 10×3mm | 3米 | ¥5 | 淘宝 |
| 门框密封条 | 海绵橡胶 | 2米 | ¥5 | 淘宝 |

**预估总价：** ¥25-35

**说明：** ABS打印必须，封闭腔体保温减少热量流失30-50%，降低翘曲风险。

---

## P1 阶段（建议同步采购）

### P1-1：PLA滑架 → CNC/FR4 升级

| 配件 | 规格 | 数量 | 参考价 | 渠道 |
|---|---|---|---|---|
| FR4 环氧板 | 5mm厚 切割 | 1块 | ¥20-30 | 淘宝/本地 |
| M3 黄铜螺母 | 嵌入FR4 | 20个 | ¥5 | 淘宝 |
| **或** CNC铝合金滑架 | 6061-T6 | 1套 | ¥100-150 | 闲鱼/定制 |

**预估总价：** ¥30-150

**说明：** FR4成本低但刚性提升有限，CNC铝合金效果最好但贵。

---

### P1-2：光轴 → MGN12H 线性导轨

| 配件 | 规格 | 数量 | 参考价 | 渠道 |
|---|---|---|---|---|
| MGN12H 直线导轨 | 350mm | 2根 | ¥40-50/根 | 淘宝 |
| MGN12H 滑块 | HGH类型 | 2个 | ¥15-20/个 | 淘宝 |
| 安装螺丝 | M3×16 沉头 | 12个 | ¥5 | 淘宝 |

**预估总价：** ¥80-120

**说明：** MGN12H精度是光轴的10倍以上，消除高速打印时的抖动。

---

### P1-4：腔体循环风扇

| 配件 | 规格 | 数量 | 参考价 | 渠道 |
|---|---|---|---|---|
| 4010 风扇 | 24V 滚珠轴承 | 2只 | ¥15-20/只 | 淘宝 |
| 风扇支架 | 3D打印 STL | 2个 | 自打 | — |
| 减振垫圈 | 硅胶 | 8个 | ¥5 | 淘宝 |

**预估总价：** ¥50-65

**说明：** 封闭腔体必须主动循环，否则温差±10°C导致翘曲。现有1只进风+1只排风，需要再加2只内部循环。

---

## P2 阶段（可选）

| 配件 | 规格 | 数量 | 参考价 | 说明 |
|---|---|---|---|---|
| 双Z轴套件 | 5mm丝杠+双电机 | 1套 | ¥180-250 | 彻底解决层纹 |
| GT2 9mm皮带 | 310mm+余量 | 2根 | ¥60 | 升级皮带刚性 |
| 热床升级 | BOSSAC 310mm | 1个 | ¥280-350 | 温度更均匀 |

---

## 汇总

| 阶段 | 预估总价 | 核心效果 |
|---|---|---|
| **P0** | **¥170-210** | 框架刚性提升60-80% |
| **P1** | **¥160-335** | 精度+散热全面改善 |
| **P2** | **¥240-660** | 极致性能升级 |

**P0+P1 合计：¥330-545**

---

## 采购优先级决策树

```
现有打印机打印质量可以接受吗？
├─ 可以接受 → 先做 P0（¥170-210）
│           → 然后根据预算选 P1 项
└─ 无法接受 → P0+P1 全做（¥330-545）
            → 有层纹问题？→ 加 P2 双Z轴（+¥180-250）
```

---

## 采购注意事项

1. **铝合金型材切割**：淘宝有按切割长度卖的，选"来图定制"更方便
2. **MGN12H 导轨**：注意HGH（侧装）和HGH-CA（标准）区别
3. **风扇电压**：确认是12V还是24V系统，别买错
4. **密封条**：先量好门框尺寸再买，避免浪费
