arbaleast/dayu-tt-all-in-one/docs/MECHANICAL/03_配件清单与预算.md

# 大鱼TT 配件清单与预算参考

## 说明
- 价格为参考价，实际价格可能因渠道和时间波动
- 建议优先选择淘宝/京东，售后有保障
- 1688适合批量采购，但需起批量

---

## 一、挤出机升级

| 配件名称 | 规格 | 参考价格 | 推荐店铺/品牌 |
|---|---|---|---|
| 泰坦挤出机套装 | 3:1减速 | ¥60-90 | Trianglelab、BIGTREETECH |
| 拓竹挤出机 2.0 | 含齿轮 | ¥80-120 | 拓竹官方/代理商 |
| E3D V6 喷头 | 1.75mm/0.4mm | ¥50-100 | Trianglelab、官方 |
| 远程送料管 | PTFE 4x2mm | ¥5-10/米 | 泛用 |
| 气动接头 | PC4-M6/PC4-M10 | ¥1-2/个 | 泛用 |

**小计**: ¥100-250

---

## 二、自动调平系统

### 2.1 Klicky Probe 套装

| 配件 | 数量 | 单价 | 小计 |
|---|---|---|---|
| 欧姆龙微动开关 D2FC-F-7N | 2 | ¥3 | ¥6 |
| 钕铁硼磁铁 6x3mm | 4 | ¥0.5 | ¥2 |
| 杜邦线 20cm | 1包 | ¥3 | ¥3 |
| 3D打印件 (自行打印) | - | - | - |

**小计**: ¥10-15

### 2.2 接近开关方案

| 配件 | 规格 | 价格 |
|---|---|---|
| LJ12A3-4-Z/BX | NPN常开 | ¥8-12 |
| LJ12A3-4-Z/BY | PNP常开 | ¥8-12 |
| 安装支架 | 3D打印 | - |

**小计**: ¥10-15

---

## 三、主板升级

| 主板型号 | 驱动 | 参考价格 | 备注 |
|---|---|---|---|
| GEMINI/JOKER | TMC2209 | ¥150-200 | 大鱼官方 |
| BTT Octopus v1.1 | 无驱动 | ¥180-250 | 8轴扩展 |
| BTT SKR 2 | 无驱动 | ¥120-180 | 性价比高 |
| MKS Monster8 | 无驱动 | ¥150-200 | 大流量设计 |
| TMC2209 驱动 | x4 | ¥15-20/个 | 静音驱动 |
| TMC5160 驱动 | x4 | ¥30-40/个 | 高性能 |

**小计**: ¥150-400 (取决于主板和驱动选择)

---

## 四、热床相关

| 配件 | 规格 | 参考价格 |
|---|---|---|
| PEI弹簧钢板 | 250x250mm | ¥50-80 |
| 热床加热板 | 24V 220W | ¥40-60 |
| 热床调平弹簧 | 8x20mm x4 | ¥5-10 |
| 不锈钢偏心螺母 | M3 x4 | ¥2-3 |
| 热电偶 | 100K 3950 | ¥3-5 |

**小计**: ¥100-160

---

## 五、冷却系统

| 配件 | 规格 | 参考价格 |
|---|---|---|
| 散热风扇 4010 | 12V/24V | ¥8-15 |
| 散热风扇 4020 | 12V/24V | ¥12-20 |
| 涡轮风扇 5015 | 12V/24V | ¥15-25 |
| 黑爵风扇套装 | 4010x2+5015 | ¥40-60 |
| 铜质散热片 | E3D规格 | ¥10-15 |
| 导热硅脂 | 1g | ¥5-10 |

**小计**: ¥50-120

---

## 六、框架与结构

| 配件 | 规格 | 参考价格 |
|---|---|---|
| 亚克力板套装 | 3mm 全包 | ¥80-150 |
| Z轴支撑杆 | T8丝杆配套 | ¥20-40 |
| 金属限位开关 | 3线 | ¥3-5/个 |
| 减震脚垫 | 橡胶 4个 | ¥10-15 |
| 同步带 | GT2 6mm 2m | ¥5-10 |
| 同步轮 | 20齿 内孔5mm | ¥3-5/个 |

**小计**: ¥120-220

---

## 七、舵机

| 型号 | 扭矩 | 电压 | 价格 |
|---|---|---|---|
| SG90 | 1.5kg/cm | 4.8-6V | ¥8-12 |
| MG90s | 2.5kg/cm | 4.8-6V | ¥12-18 |
| ❌ MG996R | 10kg/cm | 4.8-7.2V | ¥15-25 |

> ⚠️ **注意**: MG996 电流需求大，可能导致主板重启，不推荐

**小计**: ¥10-20

---

## 八、电源

| 规格 | 功率 | 参考价格 |
|---|---|---|
| 明纬 LRS-350-24 | 350W 24V | ¥80-120 |
| 黑金刚 S-400-24 | 400W 24V | ¥60-100 |
| 明纬 LRS-450-24 | 450W 24V | ¥100-150 |

**小计**: ¥60-150

---

## 九、上位机 (Klipper)

| 设备 | 配置 | 参考价格 |
|---|---|---|
| 树莓派 Zero 2 W | 512MB | ¥150-200 |
| 树莓派 4B 2G | 2GB RAM | ¥250-300 |
| 香橙派 Zero 3 | 1-4GB | ¥80-150 |
| 旧安卓手机 | 需刷Linux | ¥0-100 |
| SD卡 32GB | Class 10 | ¥20-30 |
| USB-A转MicroUSB线 | 供电+数据 | ¥5-10 |

**小计**: ¥100-350

---

## 十、工具与耗材

| 工具 | 用途 | 价格 |
|---|---|---|
| 扭矩螺丝刀 | 精确拧紧 | ¥30-50 |
| 2.5mm内六角扳手 | 框架调节 | ¥5-10 |
| 热缩管套装 | 接线绝缘 | ¥10-15 |
| 万用表 | 电路检测 | ¥20-50 |
| 水平仪 | 调平辅助 | ¥10-20 |

**小计**: ¥75-145

---

## 预算汇总

### 基础升级 (约 ¥300-500)
- Klicky探针
- PEI平台
- 风扇升级
- Klipper上位机

### 中级升级 (约 ¥600-1000)
- 基础升级全部
- 挤出机升级
- 主板升级 (GEMINI/JOKER)
- 电源升级 (如需24V)

### 高级升级 (约 ¥1200-2000)
- 中级升级全部
- 八爪鱼主板
- 全包外壳
- 双Z轴改造

---

## 建议采购顺序

1. **第一阶段** (低成本高收益)
   - Klicky探针 + Klipper
   - PEI平台
   - 风扇风道

2. **第二阶段** (性能提升)
   - 挤出机升级
   - 主板升级

3. **第三阶段** (完善)
   - 外壳
   - 双Z轴
   - 其他细节优化

---

*最后更新: 2026-03-21*
*价格仅供参考，请以实际购买为准*
