arbaleast/dayu-tt-all-in-one/source/B站【大鱼DIY】3D打印机Dayu TT V1.21全套资料/TT310资料/B站【大鱼DIY】3D打印机 Dayu TT310 V1.21清单.xlsx

Sheet: 配件清单
【B站UP主：大鱼DIY】3D打印机Dayu TT310 V1.21采购清单 以下所有链接本人未获取任何好处，若商家修改链接内容本人不承担任何后果，所有东西均可在淘宝找同规格产品，自己选择。
郑重声明 |  |  | 个别奸商篡改清单内容发到其他渠道，高价出售零部件的行为当真缺德，一经发现必定曝光！
视频教程 |  |  | https://www.bilibili.com/video/BV1ak4y1A78e/
行程范围：310mm×310mm×300mm
序号 |  | 名称 | 规格 | 数量 | 单价 | 运费 | 总价 | 链接 | 备注
 | Klipper 系统一 | 上位机 | 红米1+8 | 1 | 89 | 8 | 97 | https://item.taobao.com/item.htm?id=735557611708&ns=1&abbucket=0 (https://item.taobao.com/item.htm?spm=a21n57.1.0.0.ee03523cyqONRE&id=735557611708&ns=1&abbucket=0)
 |  | 下位机 找卖家要配置文件 | K6主板 自带静音驱动 | 1 | 138 |  | 138
 |  | 热端转接板 非必要，方便接线 | K6专用集线板+配线 | 1 | 12 |  | 12
 |  |  |  |  |  | 小计 | 247
1 | 铝型材 | 欧标1020黑色 铝型材 总共1根 | 参照图纸加工 图纸发送给卖家即可 | 1 | 189 | 10 | 199 | https://item.taobao.com/item.htm?spm=a1z09.2.0.0.249c2e8d3msCGJ&id=557404697381&_u=j208d75pet4363
2 |  | 欧标2020黑色 铝型材 总共20根 |  | 1 | 0 | 0 | 0
3 |  | 1720角码 | 卖家赠送 | 4 | 0 | 0 | 0
4 |  | 橡胶脚垫 M6螺丝固定，高度20mm左右 |  | 4 | 0 | 0
5 |  | 欧标1020黑色 铝型材430mm长 总共2根，无需加工 | 用于安装电源 可不要 封箱需要一根 | 2 | 5 | 0 | 10
 |  |  |  |  |  | 小计 | 209
6 | 线轨 | 线轨 报我名字打9折 | 355mm长轨道+ MGN9H滑块 | 6 | 40 | 0 | 240 | https://item.taobao.com/item.htm?id=538777574566&spm=2015.23436601.0.0&qq-pf-to=pcqq.c2c
 |  |  |  |  |  | 小计 | 240
7 | 【同拓展志】打印机配件包 |  | 详见第二页 | 1 | 498 | 0 | 498 | https://item.taobao.com/item.htm?spm=a213gs.success.0.0.58694831lI6E8I&id=730617286439
 |  |  |  |  |  | 小计 | 498
8 | 螺钉 螺母 | 单头铜柱 | M3×30+6 | 2 | 0.6 | 0 | 1.2 | https://detail.tmall.com/item.htm?id=541776094503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
9 |  | 沉头螺钉 | M3×6 | 2 | 0.1 | 0 | 0.2 | https://detail.tmall.com/item.htm?id=636530462013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
10 |  |  | M3×10 | 10 | 0.1 | 0 | 1
11 |  |  | M4×18（热床用） | 4 | 0.13 | 0 | 0.52
12 |  |  | M5×12 | 2 | 0.2 | 0 | 0.4 |  | X轴固定1020铝型材
13 |  | 台阶螺钉 | 直径5×M4×10 | 4 | 1.4 | 0 | 5.6 | https://detail.tmall.com/item.htm?_u=j208d75pet5344&id=651089596067&spm=a1z09.2.0.0.132f2e8dCkhzWo
14 |  |  | 直径5×M4×20 | 6 | 1.5 | 0 | 9
15 |  | 十字螺钉（限位开关用） | M2×10 | 4 | 0.15 | 0 | 0.6 | https://detail.tmall.com/item.htm?id=637524754721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
16 |  | 内六角平圆头螺钉 | M3×6 | 32 | 0.04 | 0 | 1.28 | https://detail.tmall.com/item.htm?id=637014599330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
17 |  |  | M3×8 如需封箱再加150个 | 60 | 0.05 | 0 | 3
18 |  |  | M3×12 如需封箱再加30个 | 2 | 0.06 | 0 | 0.12
 |  |  | M3×16 仅安装接近开关用 | 2 | 0.06 | 0 | 0.12
19 |  |  | M3×25 | 2 | 0.06 | 0 | 0.12
 |  |  | M4×8（电源用） | 4 | 0.07 | 0 | 0.28
20 |  |  | M5×8 | 76 | 0.07 | 0 | 5.32
21 |  |  | M5×10 | 4 | 0.07 | 0 | 0.28
22 |  |  | M5×16 | 8 | 0.08 | 0 | 0.64 |  | 脚垫用
23 |  | 内六角螺钉 | M6×20 | 24 | 0.09 | 0 | 2.16 | https://detail.tmall.com/item.htm?id=534600992151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
24 |  | 垫片 | M5×15×1 | 7 | 0.12 | 0 | 0.84 | https://detail.tmall.com/item.htm?_u=j208d75pet22fc&id=615573502372&spm=a1z09.2.0.0.132f2e8dCkhzWo
25 |  |  | M5×8×0.5 | 33 | 0.05 | 0 | 1.65 | https://detail.tmall.com/item.htm?id=553763737097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
26 |  | 方形螺母（固定鱼眼轴承） | M3 | 6 | 0.1 | 0 | 0.6 | https://detail.tmall.com/item.htm?id=542282923317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
27 |  | T型螺母 1套100个，需要60个 如需封箱共需172个 | 20型材M3 固定线轨 | 60 | 0.14 | 2 | 10.4 | https://item.taobao.com/item.htm?spm=a1z09.2.0.0.5d5a2e8d3HUceQ&id=15146235453&_u=c208d75pet9bd3
28 |  | T型螺母 | 20型材M4 固定热床 | 4 | 0.14 | 0 | 0.56
29 |  | T型螺母 1套100个，需要85个 | 20型材M5 固定电机和一字板 | 85 | 0.14 | 0 | 11.9
 | 封箱所需配件 不封箱不需要 | 热熔螺母 封箱需要39个，不封箱不需要 | M3×4×4.2（50个） | 1 | 5.4 |  |  | https://detail.tmall.com/item.htm?id=673367228604&spm=a1z09.2.0.0.514d2e8dazWyN1&_u=j208d75pet1bbc
 |  | 磁铁 封箱需要16个，不封箱不需要 | 直径6mm厚度3mm | 16 | 0.35 |  |  | https://detail.tmall.com/item.htm?id=619016855032&spm=a1z09.2.0.0.514d2e8dazWyN1&_u=j208d75pet1f02
 |  | 滚珠螺母 封箱才需要，不封箱不需要 2020V铝型材请选弹片螺母 | 欧标弹性螺母20型M3 | 56 | 0.17 |  |  | https://item.taobao.com/item.htm?_u=j208d75petb76d&id=616044834645&skuId=5186585065633
 |  |  |  |  |  | 小计 | 57.79
30 | 供电系统 | 开关电源 | 24V20A | 1 | 58 | 0 | 58 | https://item.taobao.com/item.htm?spm=a1z09.2.0.0.6ffa2e8dR5PuxG&id=595783963500&_u=s208d75pet6ef6
31 |  | 电源插座 | 带线，自己会做也可以不要线 | 1 | 6 | 0 | 6 | https://item.taobao.com/item.htm?spm=a21dvs.23580594.0.0.1d293d0dlsDx6G&ft=t&id=552747462884
32 |  | 电源线 |  | 1 | 4.5 | 0 | 4.5 | https://item.taobao.com/item.htm?spm=a1z10.5-c-s.w4002-22254585059.16.16b33708kxrQvS&id=546606733627
 |  |  |  |  |  | 小计 | 68.5
33 | 其他配件 | TT的XYZ非标CNC结构件 不含挤出机 送限位支架、线轨辅助安装工具 |  | 1 | 159 | 10 | 169 | https://item.taobao.com/item.htm?spm=a21dvs.23580594.0.0.3c3a3d0d1rMpXG&ft=t&id=730358534951
34 |  | TT挤出机CNC零件 送配套螺丝及4020风道 |  | 1 | 79 | 0 | 79
 |  | TT挤出机齿轮包 无需磨轴 用于替换配件包内的齿轮 | 2根3mm的轴是多余的 | 1 | 19 | 5 | 24 | https://item.taobao.com/item.htm?id=953848794195
35 |  | 向心轴承 内径5mm，外径14mm 外圈高度4mm，内圈高6mm | GE5C 嘉立创的，靠谱一点 可到淘宝找同规格 | 3 | 4.5 | 5.65 | 19.15 | https://www.jlcfa.com/brand/C/C16/GE5C
 |  | 4020鼓风风扇 给模型散热用 同拓展志包里的给主板散热用 | 滚珠轴承24V 10000转 标配XH2.54插头 | 1 | 11 | 0 | 11 | https://item.taobao.com/item.htm?_u=j208d75pet81e4&id=642668676933&spm=a1z09.2.0.0.514d2e8dazWyN1
36 |  | 一字连接板 | 2020型2孔 | 24 | 1.3 | 8 | 39.2 | https://item.taobao.com/item.htm?id=533716881777&ns=1&abbucket=7 (https://item.taobao.com/item.htm?spm=a230r.1.14.27.38df2fabuv1uuH&id=533716881777&ns=1&abbucket=7)
 |  |  |  |  |  | 小计 | 341.35
 |  | 其他材料 | ①从电源到主板需要一根红黑的多股软线，建议买2平方以上的，楼下五金店买就行； ②加热棒、热敏电阻、风扇、挤出机的步进电机的线一般会不够长，需要自己加长； ③热床到主板需要一根红黑的多股软线，建议买1.5平方以上的，最好直接买带线的热床。
 |  |  |  |  |  | 合计: | 1661.64 | 如有遗漏或错误，麻烦您联系我更正，谢谢（不提供技术支持）！ QQ：88910246

Sheet: 【同拓展志】打印机配件包
9 | 打印机配件 过些天同拓展志会出零件包，价格也会稍微优惠 | 加长步进电机 XY轴用 | 48高，XH2.54配线 | 2 | 23.5 | 0 | 47 | https://item.taobao.com/item.htm?spm=a21dvs.23580594.0.0.1d293d0dSrcL9j&ft=t&id=649664531631 | B02255
 |  | 42步进电机 Z轴用 | 34高，XH2.54配线 | 3 | 19 | 0 | 57 |  | B0878
10 |  | 36圆饼步进电机 挤出机用 | XH2.54配线 | 1 | 42 | 0 | 42 | https://item.taobao.com/item.htm?spm=a21dvs.23580594.0.0.1d293d0dSrcL9j&ft=t&id=679739168466 | B01936
11 |  | 同步轮 | 20齿内孔5带宽6 | 2 | 1.11 | 0 | 2.22 | https://item.taobao.com/item.htm?spm=a21dvs.23580594.0.0.1d293d0dSrcL9j&ft=t&id=559194333476 | B0683
 |  | 惰轮 | 20齿内孔5 带宽6带齿 | 2 | 1.78 | 0 | 3.56 | https://item.taobao.com/item.htm?spm=a21dvs.23580594.0.0.1d293d0dSrcL9j&ft=t&id=559682437946 | B0405
12 |  |  | 20齿内孔5 带宽6不带齿 | 10 | 2.32 | 0 | 23.2 |  | B0403
13 |  | 同步带 剪成2条 | GT2-6mm 5米/条 | 1 | 4.12 | 0 | 4.12 | https://item.taobao.com/item.htm?spm=a21dvs.23580594.0.0.1d293d0dSrcL9j&ft=t&id=558903222636 | B0746
14 |  | PEI平台 | 310*310双面喷涂款 | 1 | 90 | 0 | 90 | https://item.taobao.com/item.htm?spm=a21dvs.23580594.0.0.1d293d0dSrcL9j&ft=t&id=623211529831 | B01718
15 |  | 热床 | 24V310*310带线 孔距240，M4沉孔 建议加一个MOS模块 | 1 | 58 | 0 | 58 | https://item.taobao.com/item.htm?spm=a213gs.success.0.0.58694831lI6E8I&id=730617286439
17 |  | 热敏电阻 | 带XH2.54 24号线 1M | 1 | 1.55 | 0 | 1.55 | https://item.taobao.com/item.htm?spm=a21dvs.23580594.0.0.1d293d0dPgRrtF&ft=t&id=559717769495 | B0853
18 |  | 拓竹热端套件 包含热敏、加热片、固定夹、硅胶套 |  | 1 | 77 | 0 | 77 | https://item.taobao.com/item.htm?spm=a21dvs.23580594.0.0.1d293d0dSrcL9j&ft=t&id=714344983371 | B02304
23 |  | 限位开关 只接两根线 |  | 2 | 0.24 | 0 | 0.48 | https://item.taobao.com/item.htm?spm=a21dvs.23580594.0.0.1d293d0dPgRrtF&ft=t&id=560056223373 | B0470
 |  | 接近开关 | M8*50 | 1 | 18 | 0 | 18 | https://item.taobao.com/item.htm?spm=a21dvs.23580594.0.0.1d293d0doZMbnz&ft=t&id=560790107467 | KP3SPROV2-DZ01-0053
 |  | 气动接头 挤出机用 | PC4_M6直通式 | 2 | 1.2 | 0 | 2.4 | https://item.taobao.com/item.htm?spm=a21dvs.23580594.0.0.1d293d0dPgRrtF&ft=t&id=560029711616 | B0419
 |  | 铁氟龙管 引导耗材用，非必要 | 乳白色2*4，1.75耗材 | 1 | 1.71 | 0 | 1.71 | https://item.taobao.com/item.htm?spm=a21dvs.23580594.0.0.1d293d0dPgRrtF&ft=t&id=659862681620 | B0030
24 |  | 2510风扇 | 24V | 1 | 3 | 0 | 3 | https://item.taobao.com/item.htm?spm=a21dvs.23580594.0.0.1d293d0doZMbnz&ft=t&id=560285123186 | 暂定
26 |  | 4020鼓风风扇 也可用5015 | 24V两线 XH2.54 | 1 | 4.1 | 0 | 4.1 | https://item.taobao.com/item.htm?spm=a21dvs.23580594.0.0.1d293d0dPgRrtF&ft=t&id=560037644826 | B1045
 |  | 隔离柱 | 5*8*9 内5外8高9 | 8 | 0.2 | 0 | 1.6 | https://item.taobao.com/item.htm?spm=a21dvs.23580594.0.0.1d293d0dPgRrtF&ft=t&id=620496119636 | B01340
 |  |  | 5*9*5 内5外9高5 | 3 | 0.28 | 0 | 0.84 |  | CJ019
28 |  | T8丝杆 | 330mm长 导程8 | 3 | 7.5 | 0 | 22.5 | https://item.taobao.com/item.htm?spm=a1z10.3-c-s.w4002-17331600343.16.48b83e69PyVts7&id=559693268692
30 |  | 电机安装支架 | 黑色 | 5 | 3.47 | 0 | 17.35 | https://item.taobao.com/item.htm?spm=a21dvs.23580594.0.0.1d293d0dPgRrtF&ft=t&id=595525201976 | B1169
31 |  | 联轴器 | 5*8 | 3 | 1.9 | 0 | 5.7 | https://item.taobao.com/item.htm?spm=a1z10.5-c-s.w4002-22254585059.11.e3515da5zLeSmw&id=527784148916 | A0017

Sheet: CNC零件清单
\
