arbaleast/dayu-tt-all-in-one/enclosure/freecad/BottomBracketAssembly.FCStd

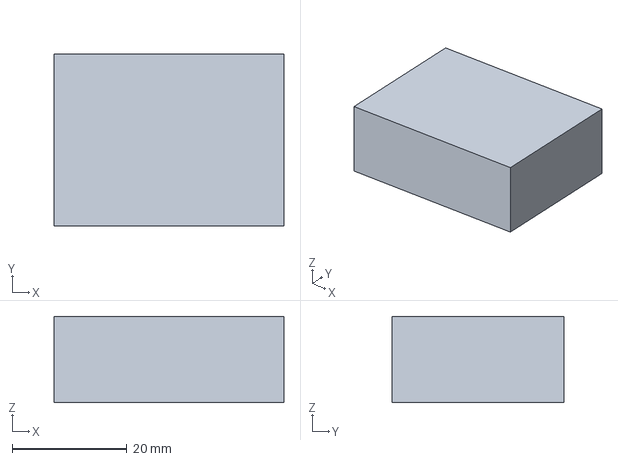
[picture p13: CAD file, 2026-04-05]
enclosure/freecad/BottomBracketAssembly.FCStd
40.0 x 30.0 x 15.0 mm
