arbaleast/dayu-tt-all-in-one/enclosure/freecad/BottomBracketComplete.FCStd

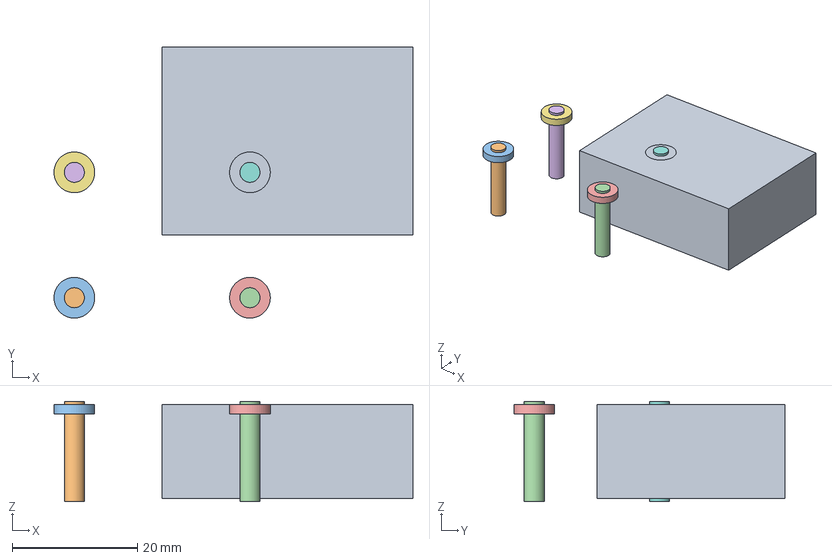
[picture p14: CAD file, 2026-04-05]
enclosure/freecad/BottomBracketComplete.FCStd
57.2 x 43.2 x 16.0 mm
Shaft_0
Head_0
Shaft_1
Head_1
Shaft_2
Head_2
Shaft_3
Head_3
