arbaleast/dayu-tt-all-in-one/enclosure/freecad/FootMountComplete.FCStd

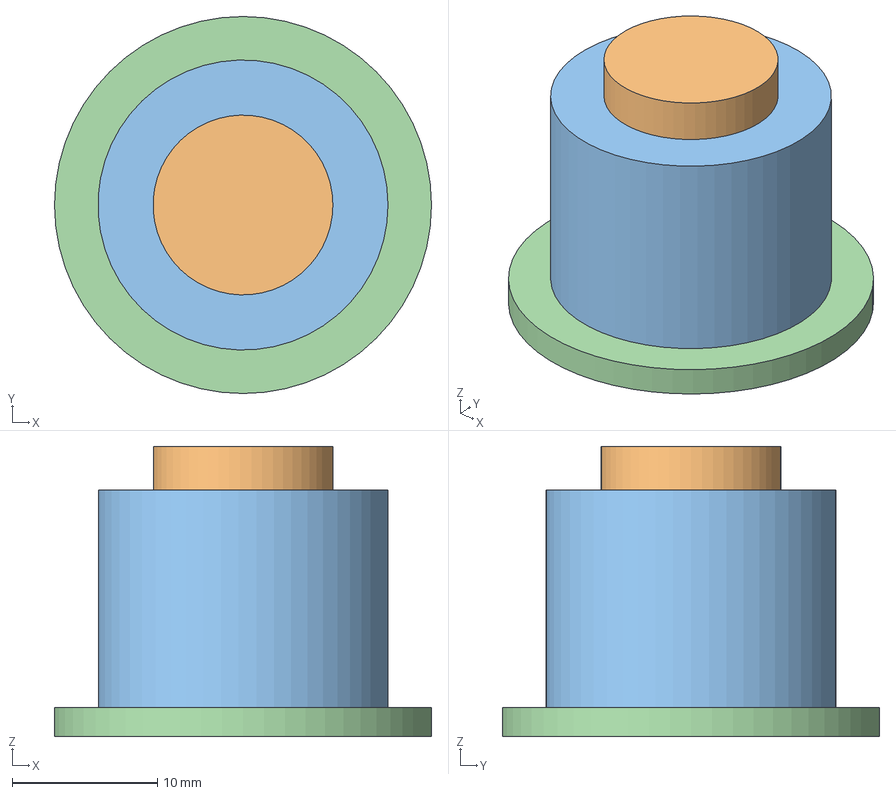
[picture p15: CAD file, 2026-04-05]
enclosure/freecad/FootMountComplete.FCStd
26.0 x 26.0 x 20.0 mm
M6Hole
FootMountWithHole
Flange
