arbaleast/dayu-tt-all-in-one/docs/03-功能扩展/ThermalControllerMountV1.stl

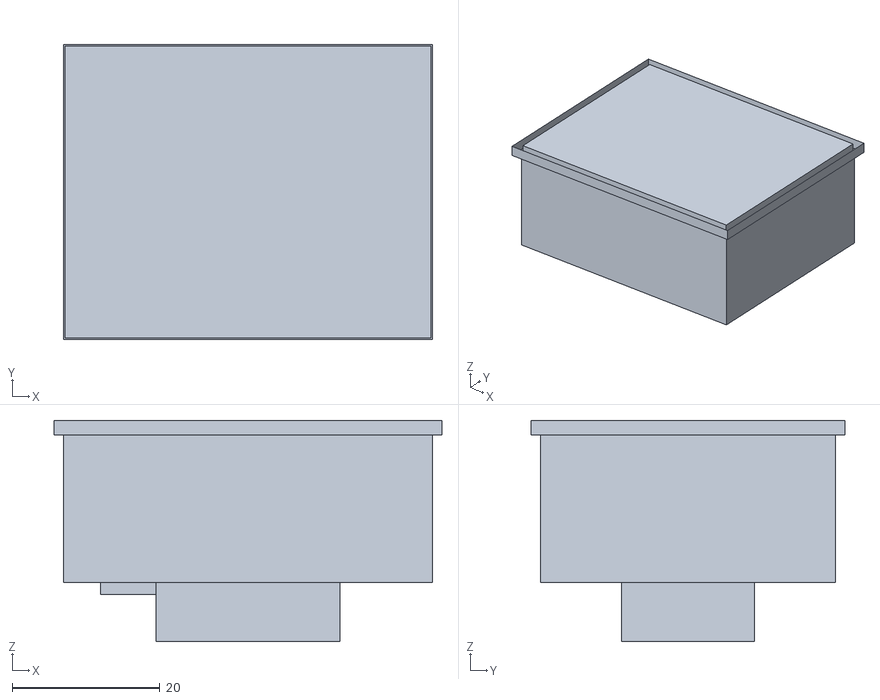
[picture p16: CAD file, 2026-04-05]
docs/03-功能扩展/ThermalControllerMountV1.stl
52.6 x 42.6 x 30.0
