arbaleast/dayu-tt-all-in-one/enclosure/dxf_v2/FRONT_DOOR_520x745x5.DXF

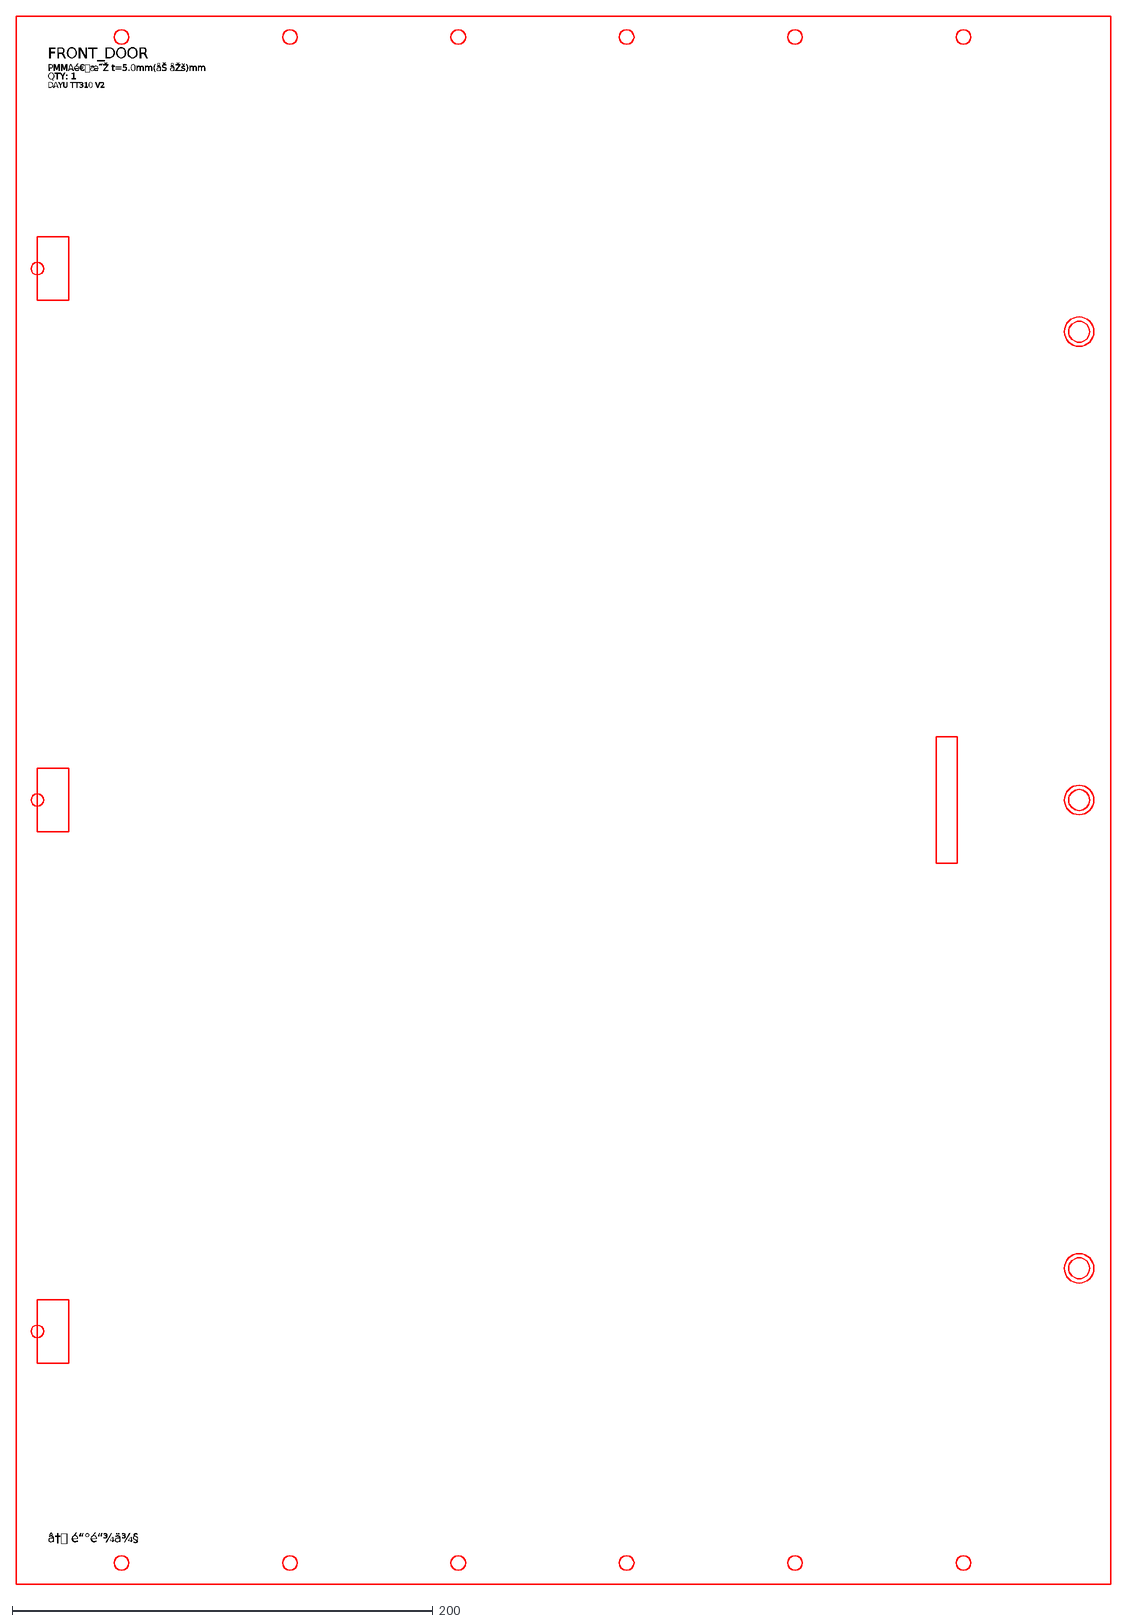
[picture p17: CAD file, 2026-04-05]
enclosure/dxf_v2/FRONT_DOOR_520x745x5.DXF
FRONT_DOOR
QTY: 1
DAYU TT310 V2
