arbaleast/dayu-tt-all-in-one/enclosure/freecad/FootMount.FCStd

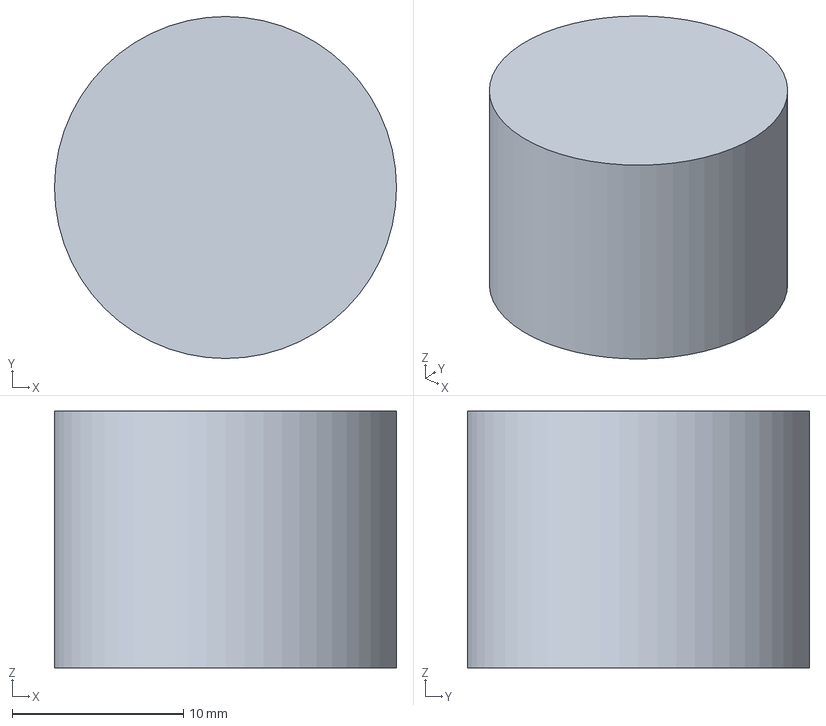
[picture p18: CAD file, 2026-04-05]
enclosure/freecad/FootMount.FCStd
20.0 x 20.0 x 15.0 mm
