arbaleast/dayu-tt-all-in-one/enclosure/steps/封箱_下四角新增福马轮TT310.stp

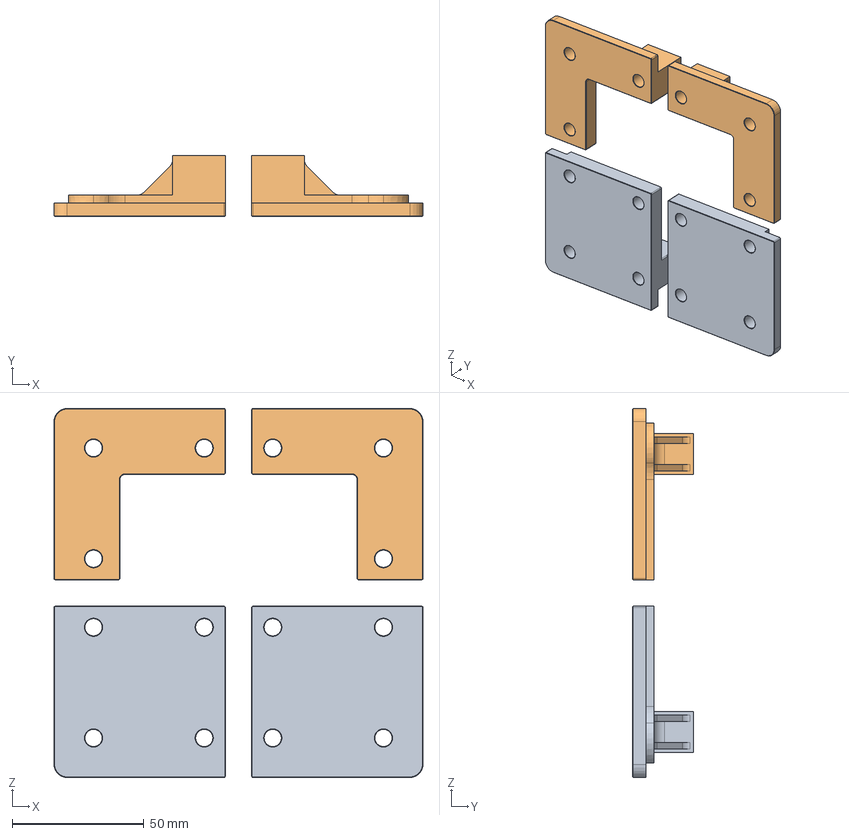
[picture p19: CAD file, 2026-04-05]
enclosure/steps/封箱_下四角新增福马轮TT310.stp
140.0 x 23.0 x 140.0 mm
Product 1.1
Product 1.2
Product 1.3
Product 1.4
