arbaleast/dayu-tt-all-in-one/source/B站【大鱼DIY】3D打印机Dayu TT V1.21全套资料/TT235资料/TT235_CNC零件图纸/TT_E/TT_E_4.STEP

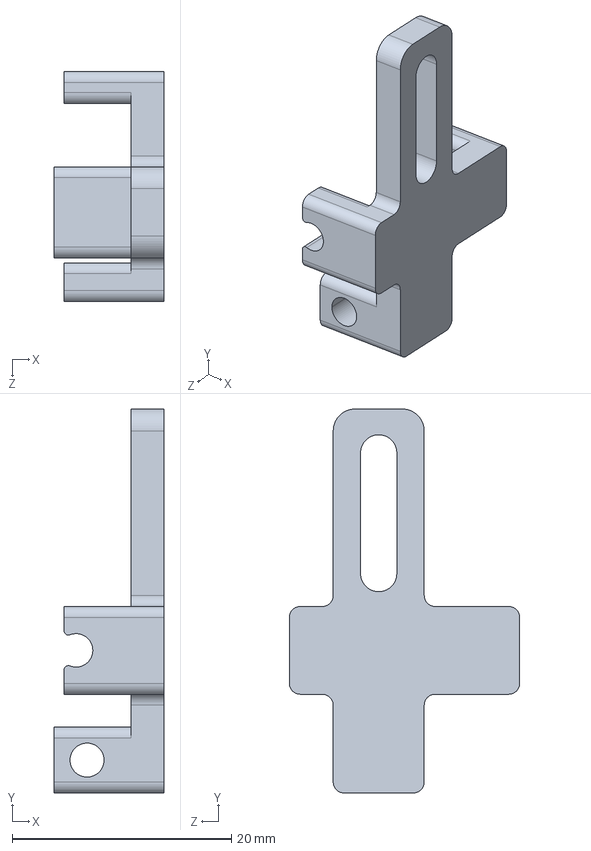
[picture p20: CAD file, 2026-04-05]
source/B站【大鱼DIY】3D打印机Dayu TT V1.21全套资料/TT235资料/TT235_CNC零件图纸/TT_E/TT_E_4.STEP
10.00 x 35.0 x 21.0 mm
