arbaleast/dayu-tt-all-in-one/source/B站【大鱼DIY】3D打印机Dayu TT V1.21全套资料/TT235资料/TT235_CNC零件图纸/TT_X/TT_X_左.STEP

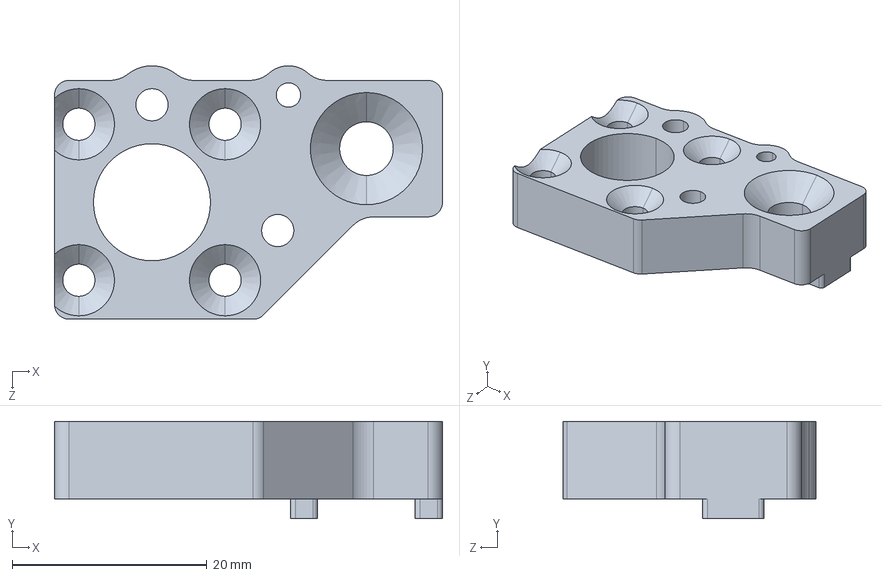
[picture p21: CAD file, 2026-04-05]
source/B站【大鱼DIY】3D打印机Dayu TT V1.21全套资料/TT235资料/TT235_CNC零件图纸/TT_X/TT_X_左.STEP
39.8 x 10.0 x 26.0 mm
