arbaleast/dayu-tt-all-in-one/source/B站【大鱼DIY】3D打印机Dayu TT V1.21全套资料/TT235资料/TT235_CNC零件图纸/TT_Z/TT_Z_左.STEP

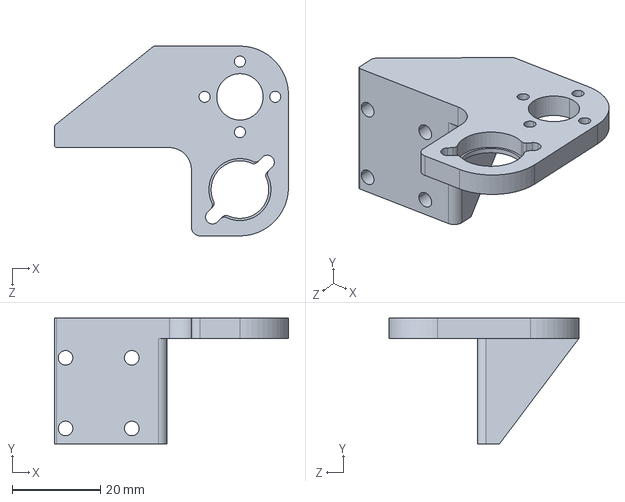
[picture p23: CAD file, 2026-04-05]
source/B站【大鱼DIY】3D打印机Dayu TT V1.21全套资料/TT235资料/TT235_CNC零件图纸/TT_Z/TT_Z_左.STEP
53.0 x 28.5 x 43.0 mm
