arbaleast/dayu-tt-all-in-one/source/B站【大鱼DIY】3D打印机Dayu TT V1.21全套资料/TT235资料/TT235封箱资料/封箱打印件图纸/STP格式/四氟管支架.STEP

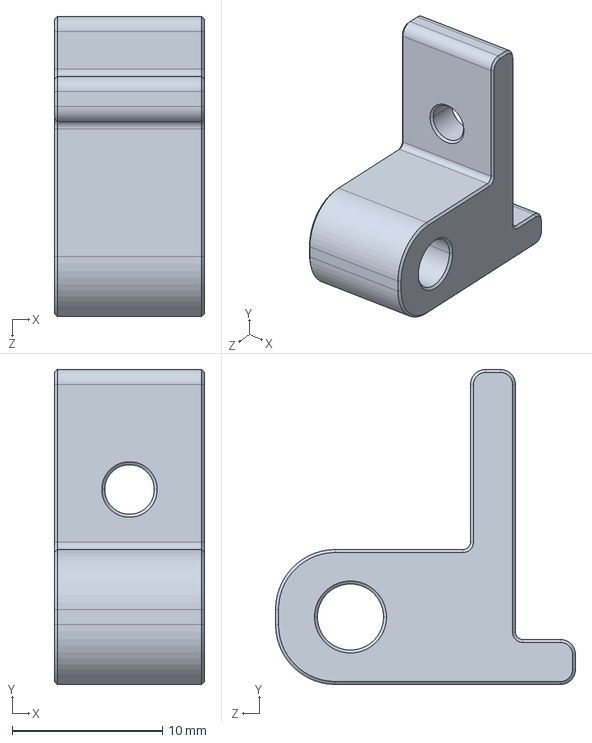
[picture p27: CAD file, 2026-04-05]
source/B站【大鱼DIY】3D打印机Dayu TT V1.21全套资料/TT235资料/TT235封箱资料/封箱打印件图纸/STP格式/四氟管支架.STEP
10.0 x 21.0 x 20.0 mm
