arbaleast/dayu-tt-all-in-one/source/B站【大鱼DIY】3D打印机Dayu TT V1.21全套资料/TT235资料/TT235封箱资料/封箱打印件图纸/红米手机外壳图纸/STP格式/红米2A外壳.STEP

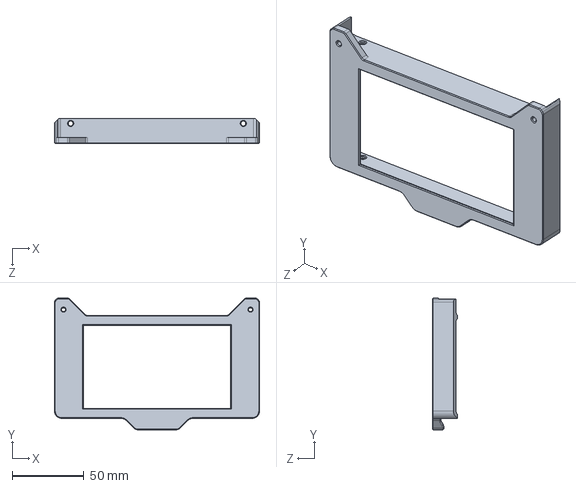
[picture p28: CAD file, 2026-04-05]
source/B站【大鱼DIY】3D打印机Dayu TT V1.21全套资料/TT235资料/TT235封箱资料/封箱打印件图纸/红米手机外壳图纸/STP格式/红米2A外壳.STEP
142.5 x 91.6 x 17.5 mm
