arbaleast/dayu-tt-all-in-one/source/B站【大鱼DIY】3D打印机Dayu TT V1.21全套资料/TT235资料/TT235封箱资料/顶部增高架/伸缩窗.SLDPRT

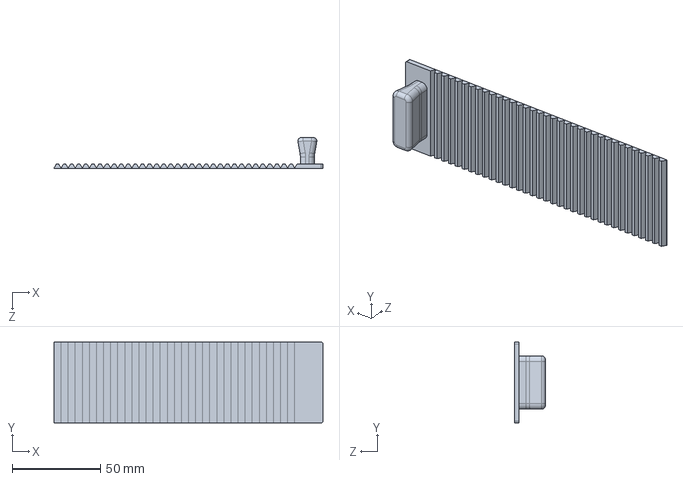
[picture p29: CAD file, 2026-04-05]
source/B站【大鱼DIY】3D打印机Dayu TT V1.21全套资料/TT235资料/TT235封箱资料/顶部增高架/伸缩窗.SLDPRT
152.0 x 45.6 x 17.5 mm
