arbaleast/dayu-tt-all-in-one/source/B站【大鱼DIY】3D打印机Dayu TT V1.21全套资料/TT235资料/TT235打印件图纸/STP格式/Y轴限位支架.STEP

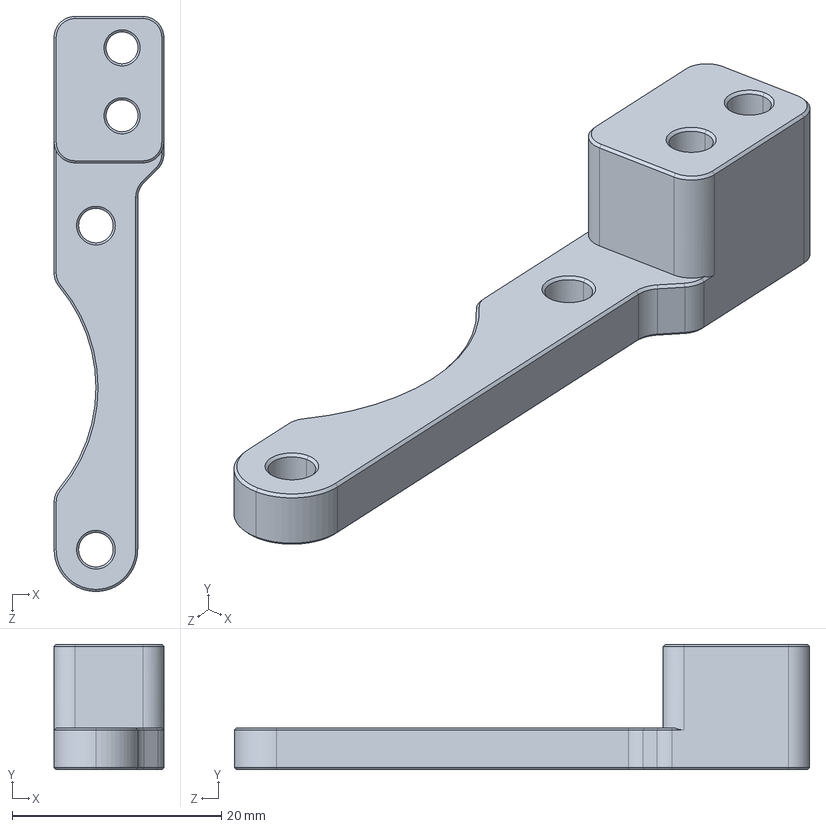
[picture p30: CAD file, 2026-04-05]
source/B站【大鱼DIY】3D打印机Dayu TT V1.21全套资料/TT235资料/TT235打印件图纸/STP格式/Y轴限位支架.STEP
10.5 x 12.0 x 55.0 mm
