arbaleast/dayu-tt-all-in-one/source/B站【大鱼DIY】3D打印机Dayu TT V1.21全套资料/TT310资料/TT310封箱资料/封箱打印件图纸/STL格式/底部装饰板.stl

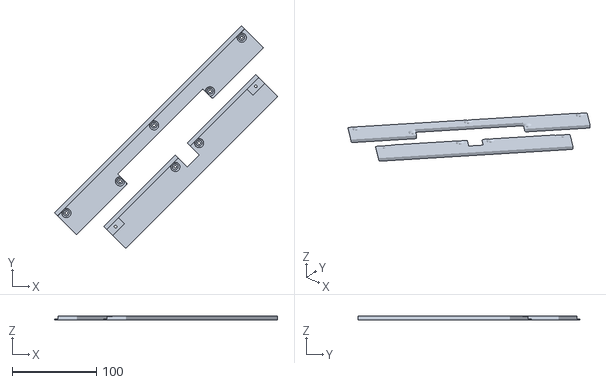
[picture p33: CAD file, 2026-04-05]
source/B站【大鱼DIY】3D打印机Dayu TT V1.21全套资料/TT310资料/TT310封箱资料/封箱打印件图纸/STL格式/底部装饰板.stl
265.3 x 264.7 x 5.00
