arbaleast/dayu-tt-all-in-one/source/B站【大鱼DIY】3D打印机Dayu TT V1.21全套资料/TT310资料/TT310封箱资料/封箱打印件图纸/STP格式/门板合页_4件.STEP

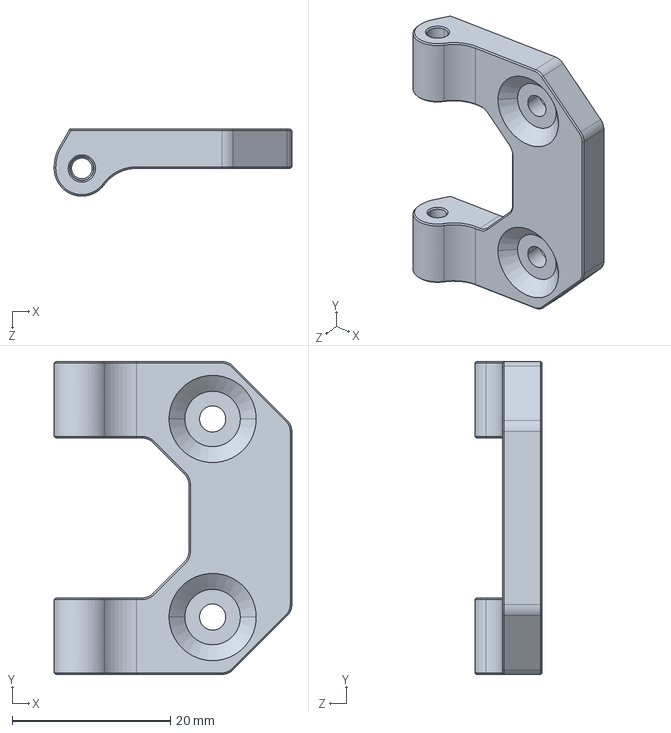
[picture p34: CAD file, 2026-04-05]
source/B站【大鱼DIY】3D打印机Dayu TT V1.21全套资料/TT310资料/TT310封箱资料/封箱打印件图纸/STP格式/门板合页_4件.STEP
30.0 x 39.5 x 8.50 mm
