arbaleast/dayu-tt-all-in-one/source/B站【大鱼DIY】3D打印机Dayu TT V1.21全套资料/TT310资料/TT310打印件图纸/STP格式/X限位触发器.STEP

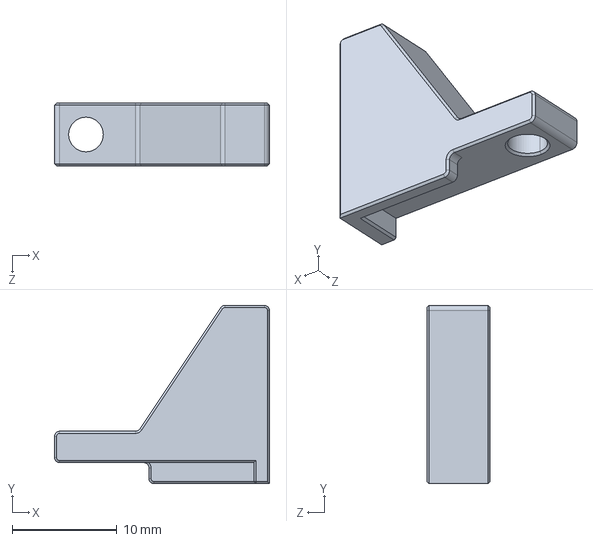
[picture p35: CAD file, 2026-04-05]
source/B站【大鱼DIY】3D打印机Dayu TT V1.21全套资料/TT310资料/TT310打印件图纸/STP格式/X限位触发器.STEP
20.5 x 17.0 x 6.00 mm
