arbaleast/dayu-tt-all-in-one/source/B站【大鱼DIY】3D打印机Dayu TT V1.21全套资料/通用辅助功能配件_非必须/02_上位机_红米2A安装盒/抽屉版/红米2A夹子_右.STEP

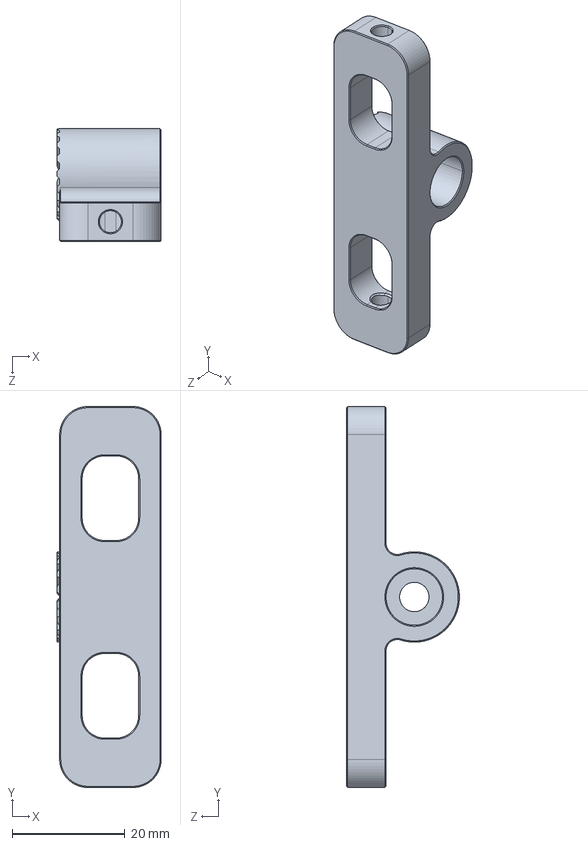
[picture p37: CAD file, 2026-04-05]
source/B站【大鱼DIY】3D打印机Dayu TT V1.21全套资料/通用辅助功能配件_非必须/02_上位机_红米2A安装盒/抽屉版/红米2A夹子_右.STEP
18.5 x 67.5 x 20.0 mm
