arbaleast/dayu-tt-all-in-one/source/B站【大鱼DIY】3D打印机Dayu TT V1.21全套资料/通用辅助功能配件_非必须/02_上位机_红米2A安装盒/直装版_建议用这个/红米外壳.STEP

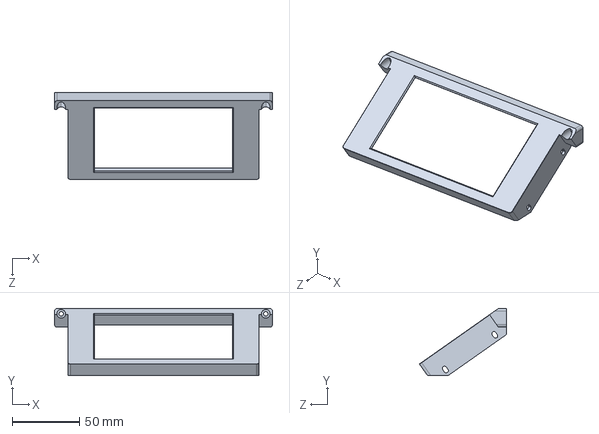
[picture p38: CAD file, 2026-04-05]
source/B站【大鱼DIY】3D打印机Dayu TT V1.21全套资料/通用辅助功能配件_非必须/02_上位机_红米2A安装盒/直装版_建议用这个/红米外壳.STEP
162.5 x 50.0 x 64.8 mm
