arbaleast/dayu-tt-all-in-one/source/B站【大鱼DIY】3D打印机Dayu TT V1.21全套资料/通用辅助功能配件_非必须/03_同步带辅助调节器/同步带调节器装配图.STEP

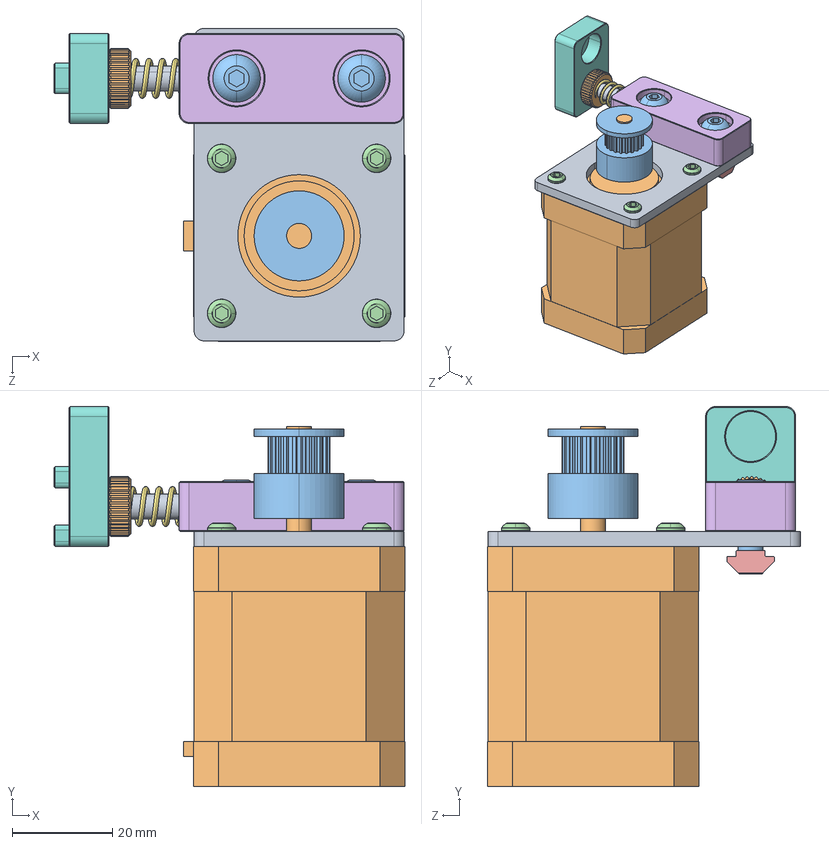
[picture p39: CAD file, 2026-04-05]
source/B站【大鱼DIY】3D打印机Dayu TT V1.21全套资料/通用辅助功能配件_非必须/03_同步带辅助调节器/同步带调节器装配图.STEP
70.2 x 76.0 x 62.6 mm
42步进电机支架_铝合金
42步进电机_高48mm
5MM同步轮
内六角平圆头螺钉M3×6 x 4
滑块螺母_欧标20型M5 x 2
同步带调节器
弹簧1×8×20
同步带调节器_底座
外六角螺栓M5×20
滚花螺母M5×12×4.5
内六角平圆头螺钉M5×16 x 2
