arbaleast/dayu-tt-all-in-one/source/B站【大鱼DIY】3D打印机Dayu TT V1.21全套资料/通用辅助功能配件_非必须/03_同步带辅助调节器/同步带辅助调节器打印件/同步带调节器.STEP

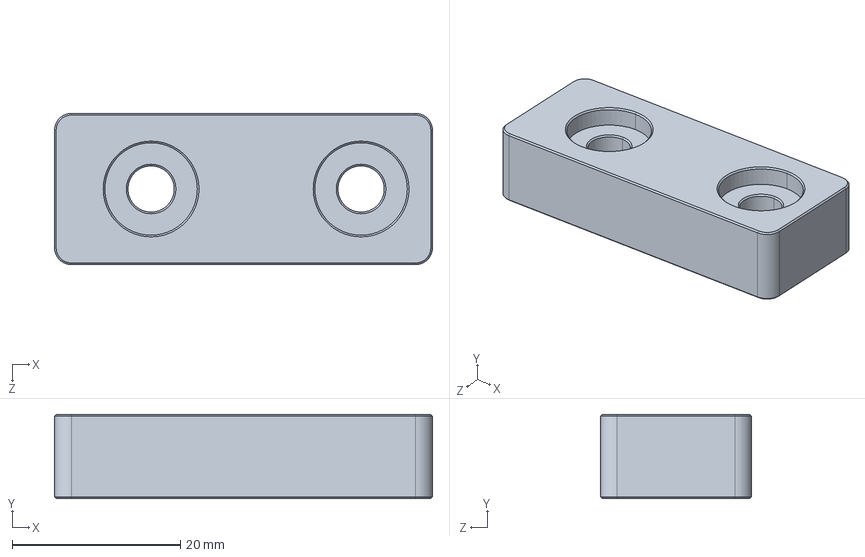
[picture p40: CAD file, 2026-04-05]
source/B站【大鱼DIY】3D打印机Dayu TT V1.21全套资料/通用辅助功能配件_非必须/03_同步带辅助调节器/同步带辅助调节器打印件/同步带调节器.STEP
45.0 x 10.0 x 18.0 mm
