arbaleast/dayu-tt-all-in-one/source/B站【大鱼DIY】3D打印机Dayu TT V1.21全套资料/通用辅助功能配件_非必须/04_下位机_小政K6安装盒/STP格式/1020铝型材支架.STEP

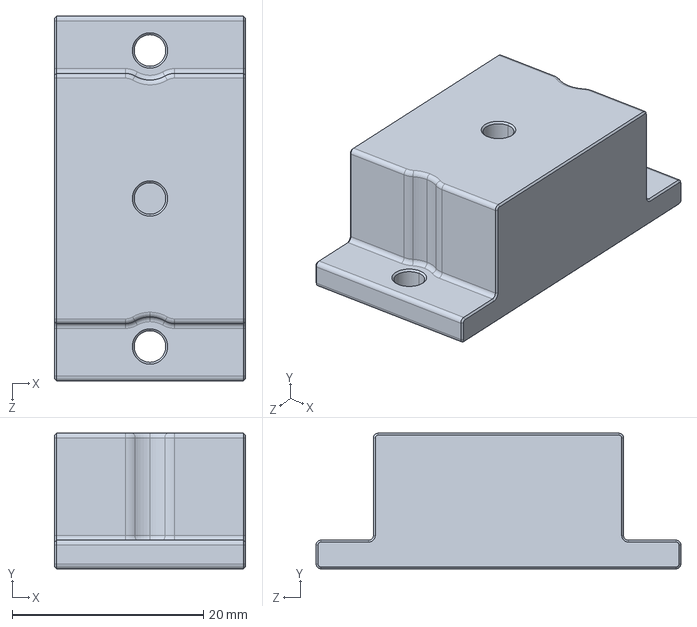
[picture p41: CAD file, 2026-04-05]
source/B站【大鱼DIY】3D打印机Dayu TT V1.21全套资料/通用辅助功能配件_非必须/04_下位机_小政K6安装盒/STP格式/1020铝型材支架.STEP
20.0 x 14.2 x 38.2 mm
