arbaleast/dayu-tt-all-in-one/source/B站【大鱼DIY】3D打印机Dayu TT V1.21全套资料/通用辅助功能配件_非必须/04_下位机_小政K6安装盒/小政K6_电控组件.STEP

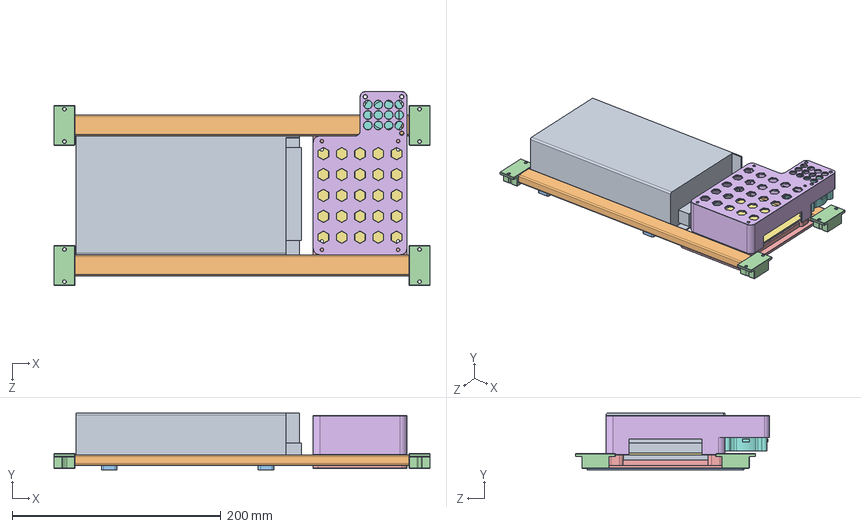
[picture p42: CAD file, 2026-04-05]
source/B站【大鱼DIY】3D打印机Dayu TT V1.21全套资料/通用辅助功能配件_非必须/04_下位机_小政K6安装盒/小政K6_电控组件.STEP
360.0 x 54.5 x 185.7 mm
开关电源S-360-24V
ﾂﾁﾐﾍｲﾄ1020_ｵ釀ｴﾖｧｼﾜ x 2
电源固定支架_小政K6 x 2
1020ﾂﾁﾐﾍｲﾄﾖｧｼﾜ x 4
下位机安装支架_小政K6
下位机保护壳_小政K6
小政K6主板
4020鼓风风扇
