arbaleast/dayu-tt-all-in-one/source/B站【大鱼DIY】3D打印机Dayu TT V1.21全套资料/通用辅助功能配件_非必须/05_MGN9辅助定位块/装配辅助定位块.STEP

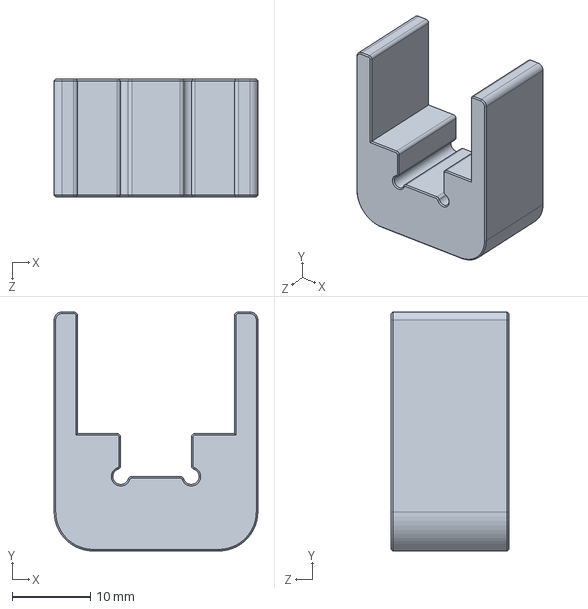
[picture p43: CAD file, 2026-04-05]
source/B站【大鱼DIY】3D打印机Dayu TT V1.21全套资料/通用辅助功能配件_非必须/05_MGN9辅助定位块/装配辅助定位块.STEP
26.0 x 30.5 x 15.0 mm
