arbaleast/dayu-tt-all-in-one/source/B站【大鱼DIY】3D打印机Dayu TT V1.21全套资料/通用辅助功能配件_非必须/07_品字开关安装座/品字开关安装座.STEP

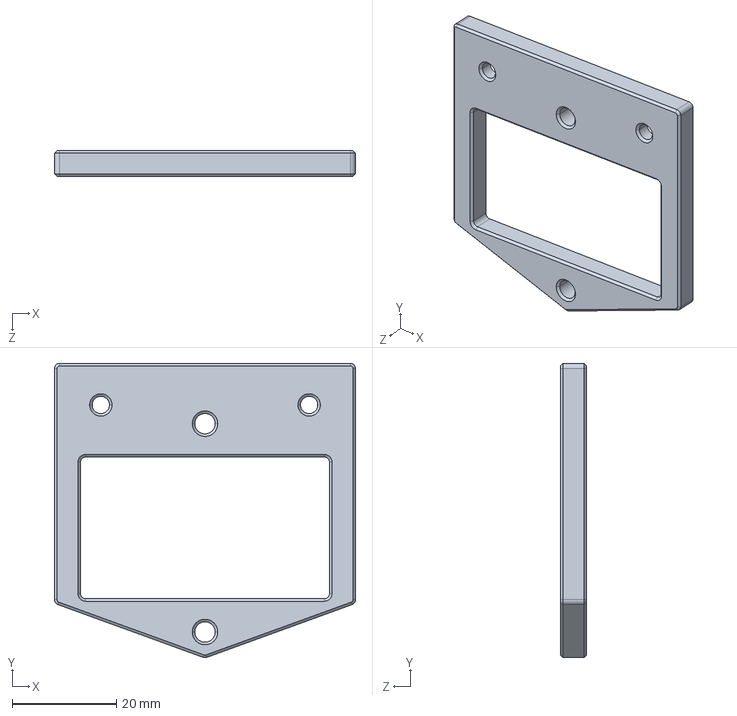
[picture p45: CAD file, 2026-04-05]
source/B站【大鱼DIY】3D打印机Dayu TT V1.21全套资料/通用辅助功能配件_非必须/07_品字开关安装座/品字开关安装座.STEP
57.8 x 56.5 x 5.00 mm
