arbaleast/dayu-tt-all-in-one/source/B站【大鱼DIY】3D打印机Dayu TT V1.21全套资料/通用辅助功能配件_非必须/10_气动接头安装扣/气动接头安装扣.STEP

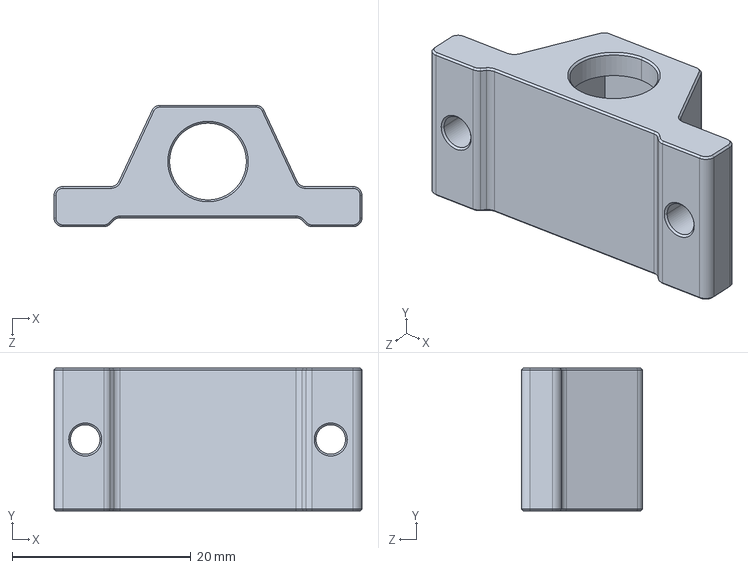
[picture p48: CAD file, 2026-04-05]
source/B站【大鱼DIY】3D打印机Dayu TT V1.21全套资料/通用辅助功能配件_非必须/10_气动接头安装扣/气动接头安装扣.STEP
34.5 x 16.0 x 13.6 mm
