arbaleast/dayu-tt-all-in-one/source/B站【大鱼DIY】3D打印机Dayu TT V1.21全套资料/通用辅助功能配件_非必须/11_5015风道_带支架/5015支架.STEP

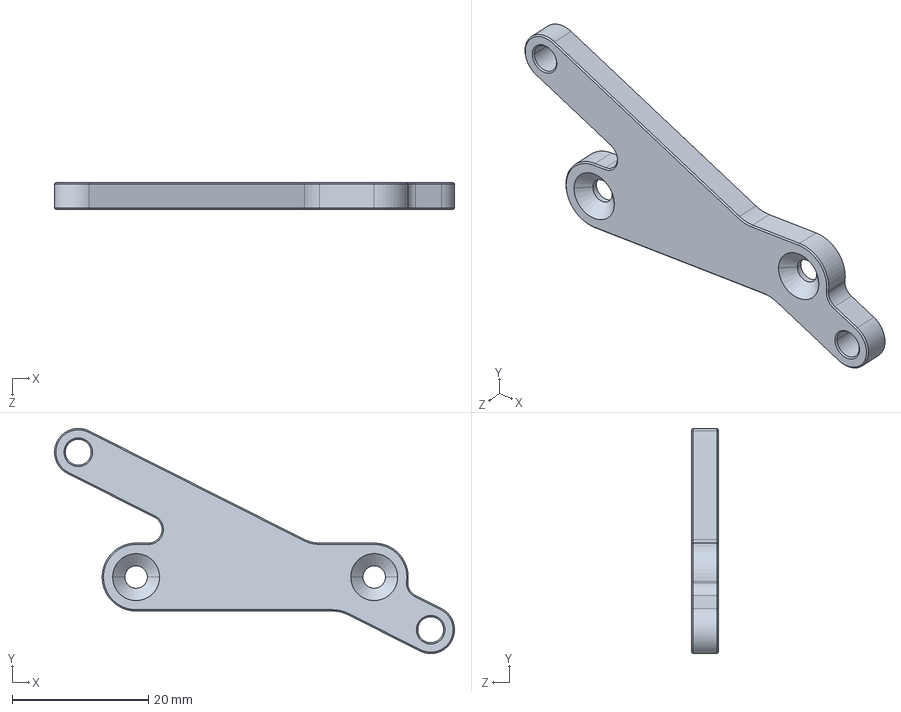
[picture p49: CAD file, 2026-04-05]
source/B站【大鱼DIY】3D打印机Dayu TT V1.21全套资料/通用辅助功能配件_非必须/11_5015风道_带支架/5015支架.STEP
58.8 x 33.1 x 4.00 mm
