arbaleast/dayu-tt-all-in-one/enclosure/dxf_v2/BOTTOM_PANEL_520x530x5.DXF

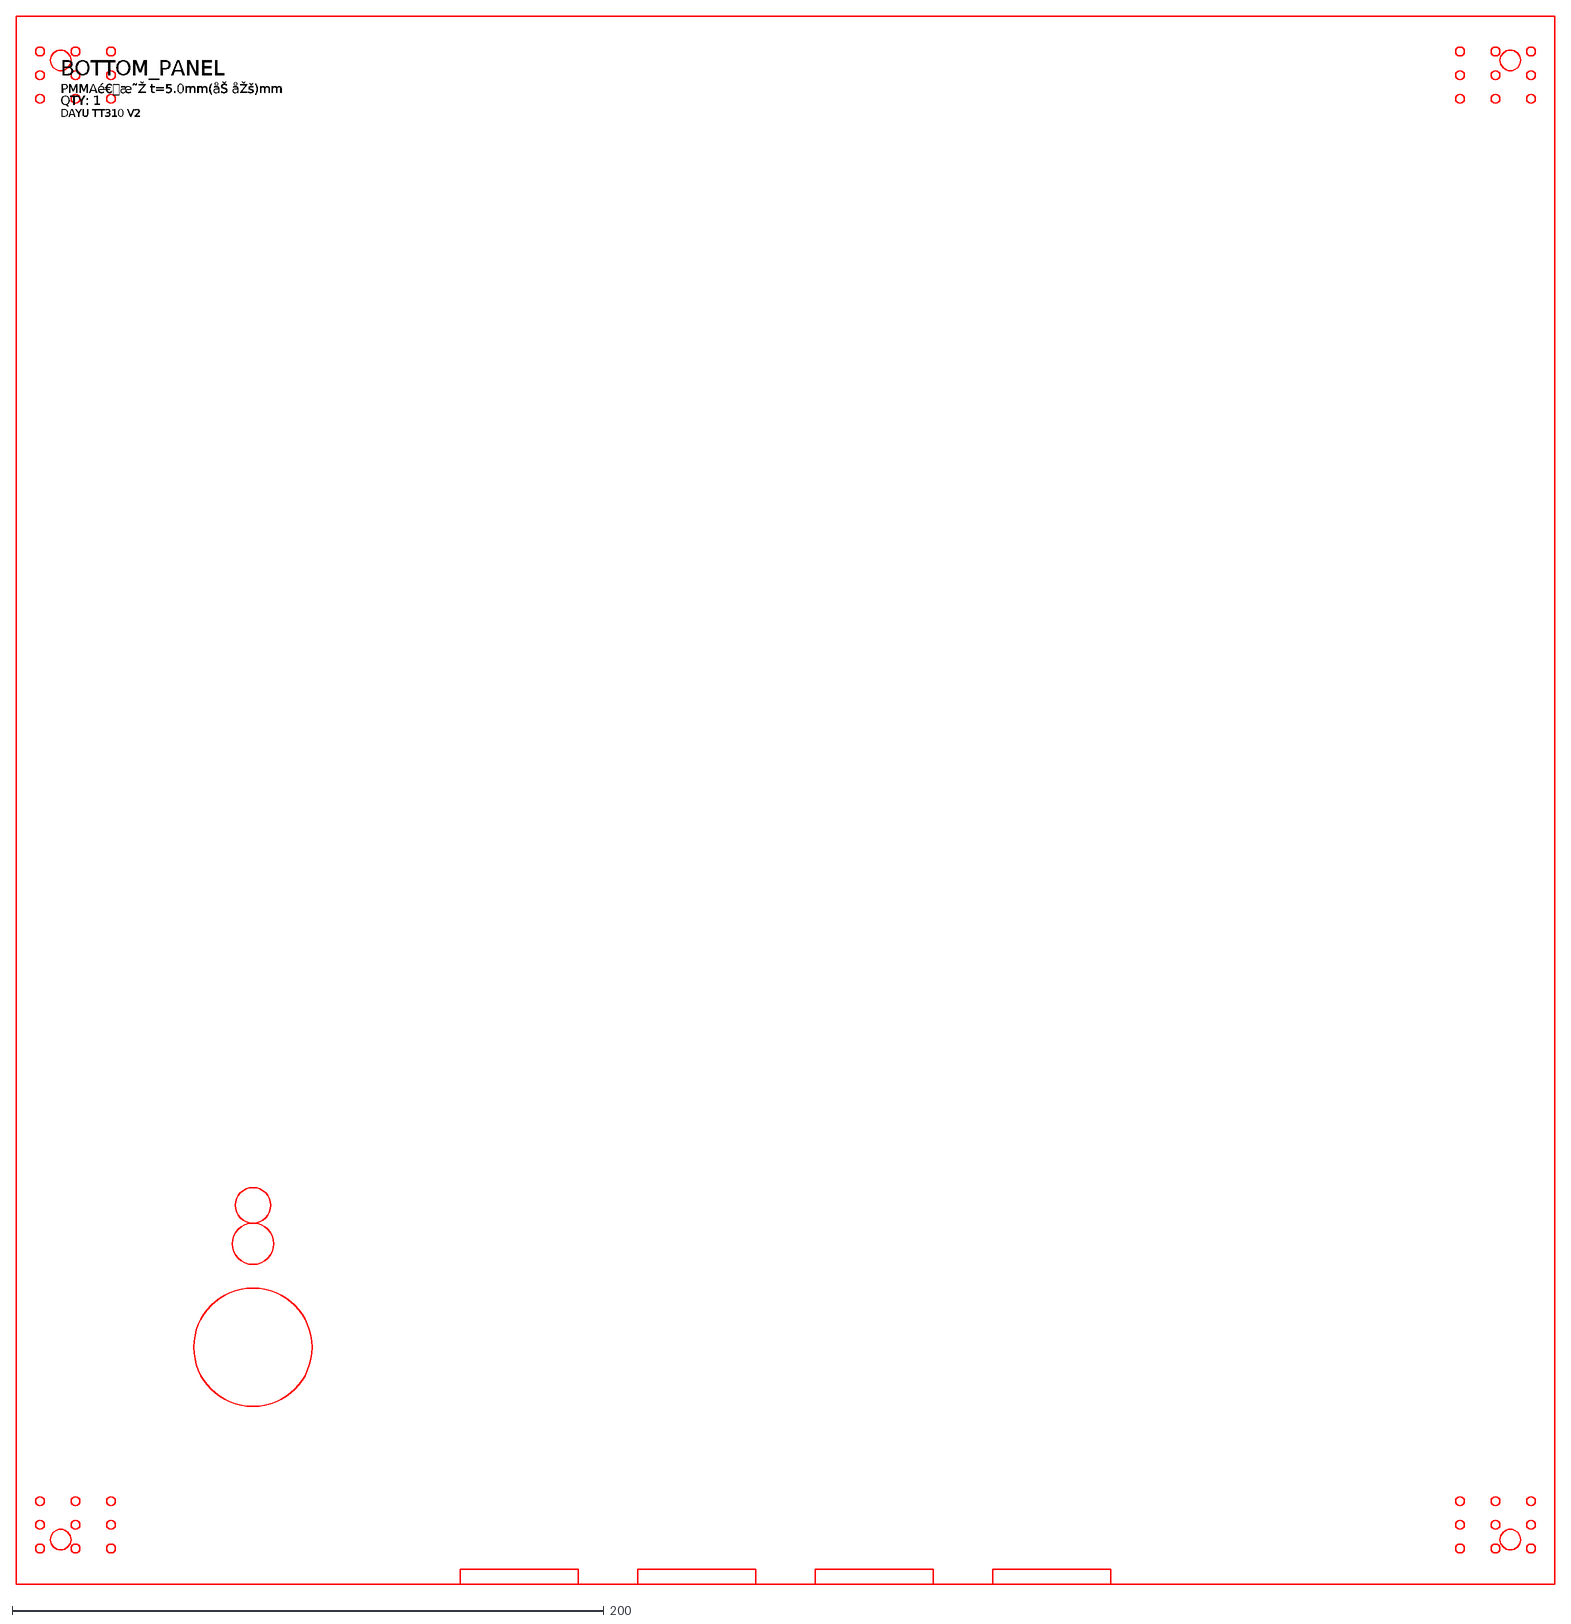
[picture p51: CAD file, 2026-04-05]
enclosure/dxf_v2/BOTTOM_PANEL_520x530x5.DXF
BOTTOM_PANEL
QTY: 1
DAYU TT310 V2
