arbaleast/dayu-tt-all-in-one/source/B站【大鱼DIY】3D打印机Dayu TT V1.21全套资料/TT235资料/TT235_CNC零件图纸/TT_Y/TT_Y_前（2件）.STEP

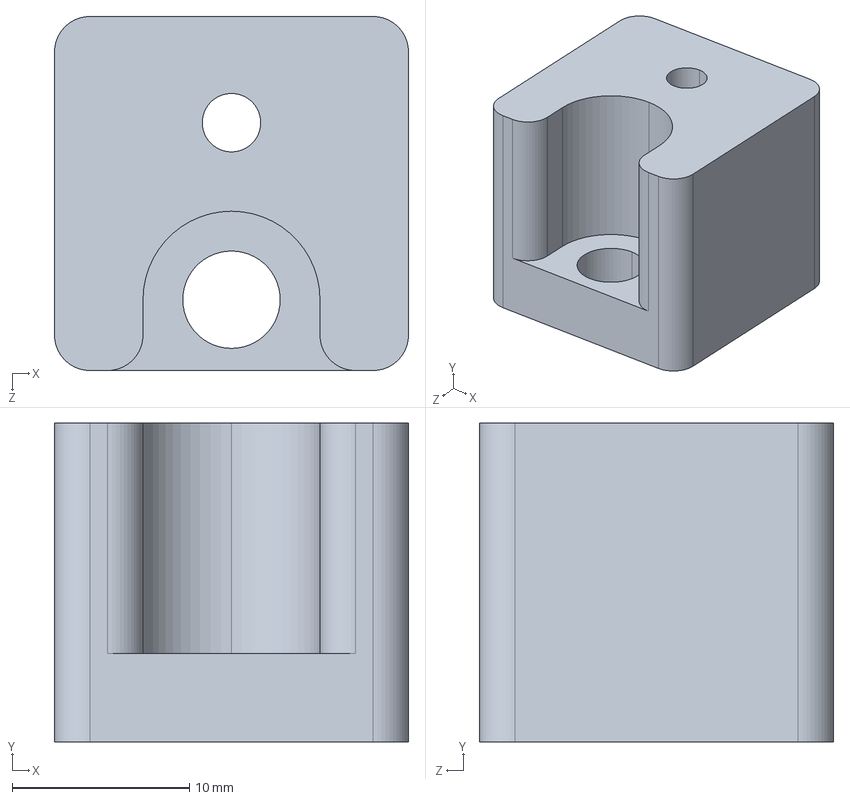
[picture p53: CAD file, 2026-04-05]
source/B站【大鱼DIY】3D打印机Dayu TT V1.21全套资料/TT235资料/TT235_CNC零件图纸/TT_Y/TT_Y_前（2件）.STEP
20.0 x 18.0 x 20.0 mm
