arbaleast/dayu-tt-all-in-one/source/B站【大鱼DIY】3D打印机Dayu TT V1.21全套资料/TT235资料/TT235封箱资料/封箱亚克力板图纸/DXF格式图纸/顶板_厚度3mm_透明.DXF

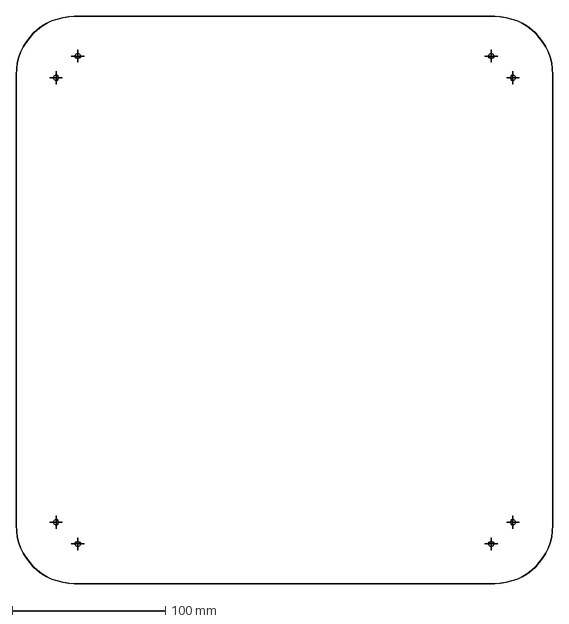
[picture p54: CAD file, 2026-04-05]
source/B站【大鱼DIY】3D打印机Dayu TT V1.21全套资料/TT235资料/TT235封箱资料/封箱亚克力板图纸/DXF格式图纸/顶板_厚度3mm_透明.DXF
350.0 x 370.0 mm
