arbaleast/dayu-tt-all-in-one/source/B站【大鱼DIY】3D打印机Dayu TT V1.21全套资料/TT235资料/TT235封箱资料/封箱打印件图纸/STL格式/各种小附件.stl

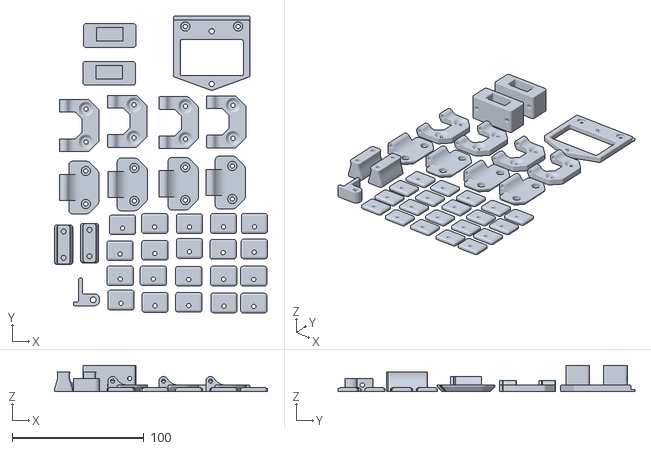
[picture p55: CAD file, 2026-04-05]
source/B站【大鱼DIY】3D打印机Dayu TT V1.21全套资料/TT235资料/TT235封箱资料/封箱打印件图纸/STL格式/各种小附件.stl
161.8 x 225.3 x 20.0
