arbaleast/dayu-tt-all-in-one/source/B站【大鱼DIY】3D打印机Dayu TT V1.21全套资料/TT235资料/TT235封箱资料/封箱打印件图纸/红米手机外壳图纸/STP格式/红米2A锁块.STEP

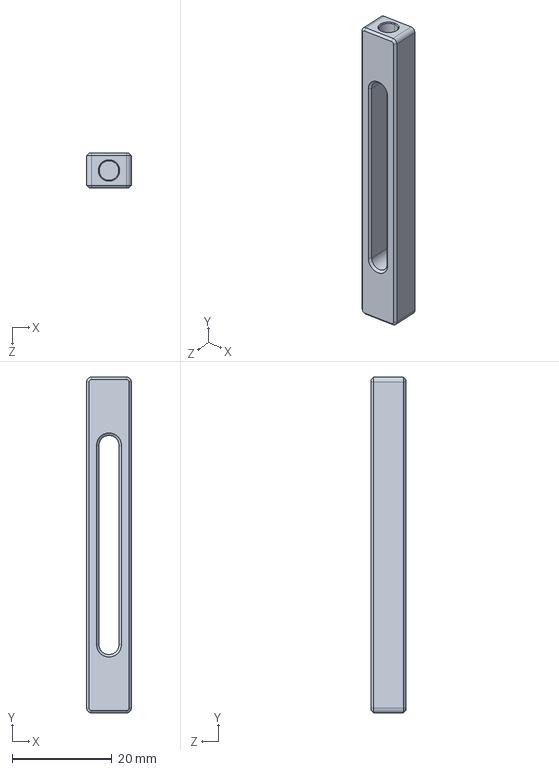
[picture p56: CAD file, 2026-04-05]
source/B站【大鱼DIY】3D打印机Dayu TT V1.21全套资料/TT235资料/TT235封箱资料/封箱打印件图纸/红米手机外壳图纸/STP格式/红米2A锁块.STEP
9.00 x 67.5 x 7.00 mm
