arbaleast/dayu-tt-all-in-one/source/B站【大鱼DIY】3D打印机Dayu TT V1.21全套资料/TT235资料/TT235封箱资料/顶部增高架/顶部增高架_拆分为对象，自动摆放，无需支撑.STEP

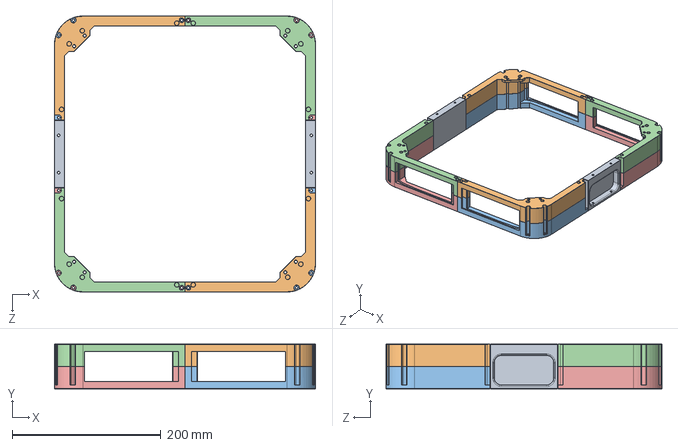
[picture p57: CAD file, 2026-04-05]
source/B站【大鱼DIY】3D打印机Dayu TT V1.21全套资料/TT235资料/TT235封箱资料/顶部增高架/顶部增高架_拆分为对象，自动摆放，无需支撑.STEP
351.0 x 60.0 x 371.0 mm
