arbaleast/dayu-tt-all-in-one/source/B站【大鱼DIY】3D打印机Dayu TT V1.21全套资料/TT235资料/TT235打印件图纸/STP格式/4020风道_TT.STEP

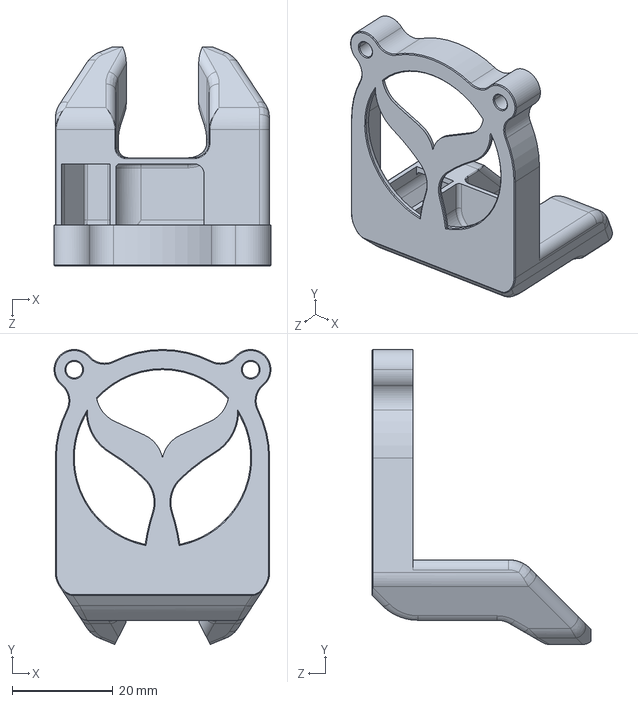
[picture p58: CAD file, 2026-04-05]
source/B站【大鱼DIY】3D打印机Dayu TT V1.21全套资料/TT235资料/TT235打印件图纸/STP格式/4020风道_TT.STEP
43.0 x 58.5 x 43.5 mm
