arbaleast/dayu-tt-all-in-one/source/B站【大鱼DIY】3D打印机Dayu TT V1.21全套资料/TT310资料/TT310_CNC零件图纸/TT_E/TT_E_1_V1.2.STEP

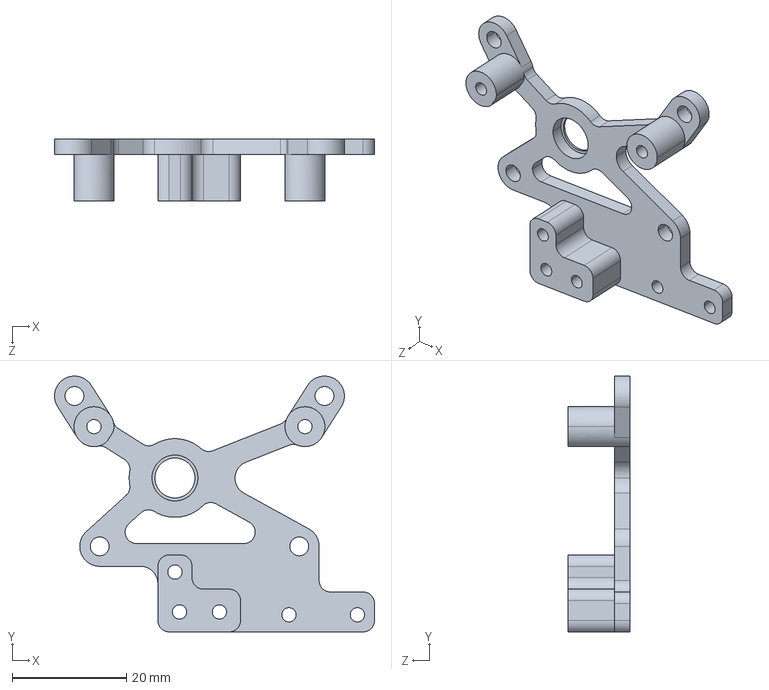
[picture p59: CAD file, 2026-04-05]
source/B站【大鱼DIY】3D打印机Dayu TT V1.21全套资料/TT310资料/TT310_CNC零件图纸/TT_E/TT_E_1_V1.2.STEP
56.1 x 44.9 x 10.9 mm
