arbaleast/dayu-tt-all-in-one/source/B站【大鱼DIY】3D打印机Dayu TT V1.21全套资料/TT310资料/TT310_CNC零件图纸/TT_X/TT_X_中.STEP

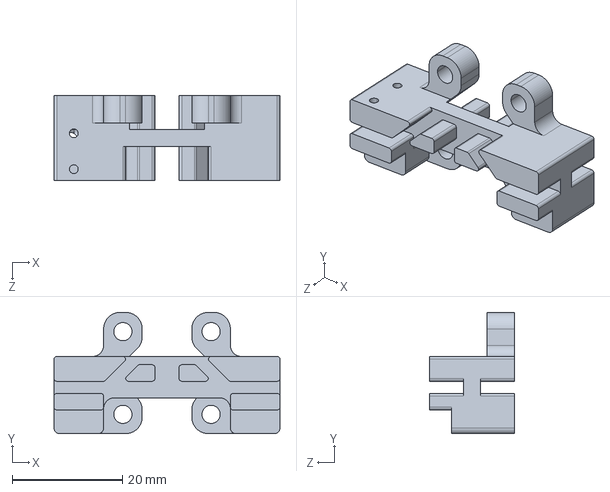
[picture p60: CAD file, 2026-04-05]
source/B站【大鱼DIY】3D打印机Dayu TT V1.21全套资料/TT310资料/TT310_CNC零件图纸/TT_X/TT_X_中.STEP
41.0 x 22.0 x 15.5 mm
