arbaleast/dayu-tt-all-in-one/source/B站【大鱼DIY】3D打印机Dayu TT V1.21全套资料/TT310资料/TT310封箱资料/封箱亚克力板图纸/DXF格式图纸/顶板_厚度3mm_透明.DXF

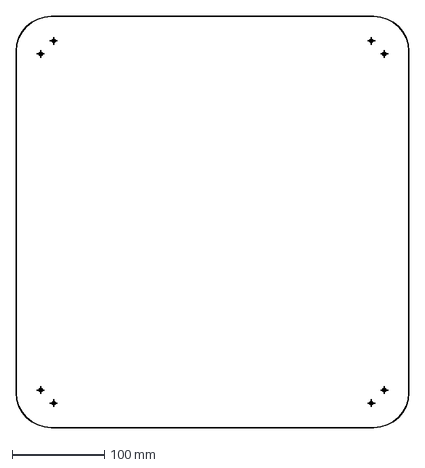
[picture p61: CAD file, 2026-04-05]
source/B站【大鱼DIY】3D打印机Dayu TT V1.21全套资料/TT310资料/TT310封箱资料/封箱亚克力板图纸/DXF格式图纸/顶板_厚度3mm_透明.DXF
426.0 x 446.0 mm
