arbaleast/dayu-tt-all-in-one/source/B站【大鱼DIY】3D打印机Dayu TT V1.21全套资料/TT310资料/TT310封箱资料/封箱亚克力板图纸/STP格式图纸/后底板.STEP

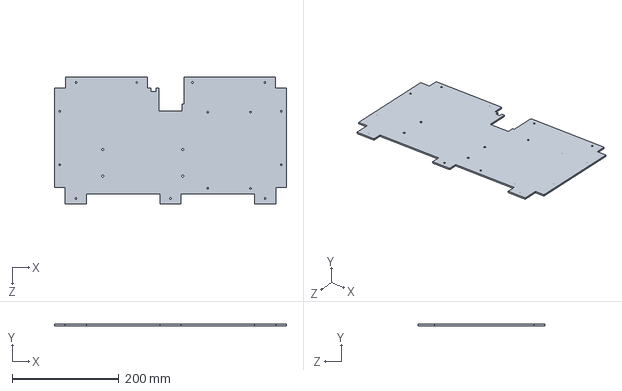
[picture p62: CAD file, 2026-04-05]
source/B站【大鱼DIY】3D打印机Dayu TT V1.21全套资料/TT310资料/TT310封箱资料/封箱亚克力板图纸/STP格式图纸/后底板.STEP
435.0 x 3.00 x 237.5 mm
