arbaleast/dayu-tt-all-in-one/source/B站【大鱼DIY】3D打印机Dayu TT V1.21全套资料/TT310资料/TT310封箱资料/封箱打印件图纸/STL格式/提手及料架.stl

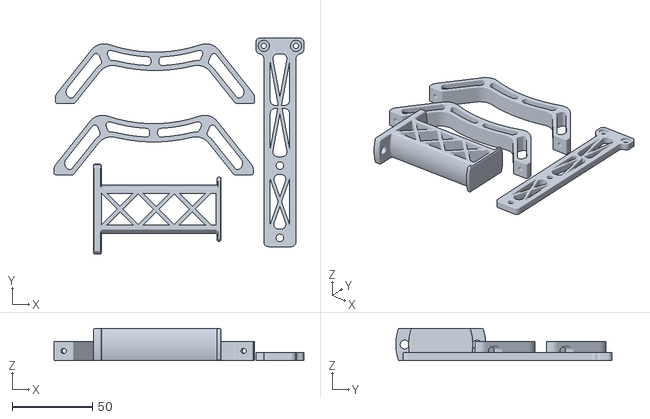
[picture p63: CAD file, 2026-04-05]
source/B站【大鱼DIY】3D打印机Dayu TT V1.21全套资料/TT310资料/TT310封箱资料/封箱打印件图纸/STL格式/提手及料架.stl
155.5 x 134.6 x 20.0
