arbaleast/dayu-tt-all-in-one/source/B站【大鱼DIY】3D打印机Dayu TT V1.21全套资料/TT310资料/TT310封箱资料/封箱打印件图纸/STP格式/1020铝型材支架.STEP

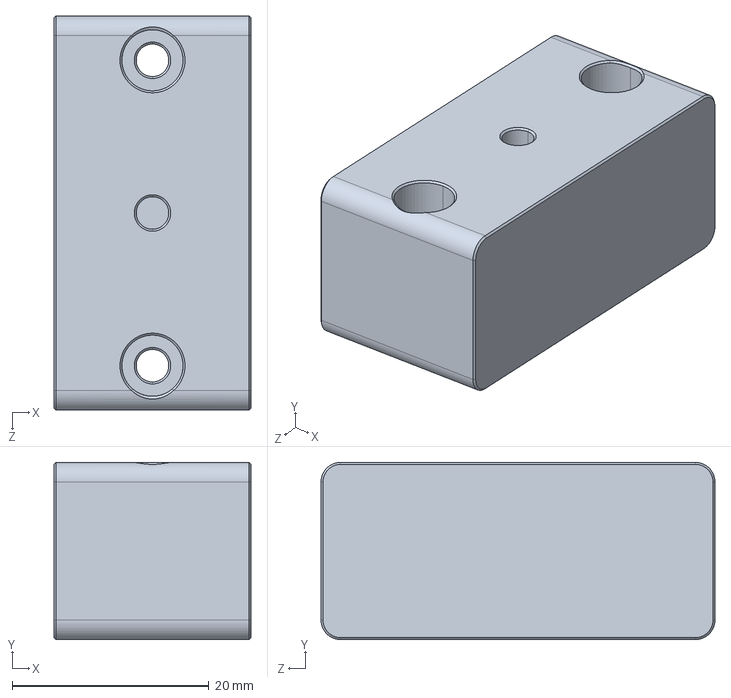
[picture p64: CAD file, 2026-04-05]
source/B站【大鱼DIY】3D打印机Dayu TT V1.21全套资料/TT310资料/TT310封箱资料/封箱打印件图纸/STP格式/1020铝型材支架.STEP
20.0 x 18.0 x 40.0 mm
