arbaleast/dayu-tt-all-in-one/source/B站【大鱼DIY】3D打印机Dayu TT V1.21全套资料/通用辅助功能配件_非必须/04_下位机_小政K6安装盒/STP格式/电源固定支架_小政K6.STEP

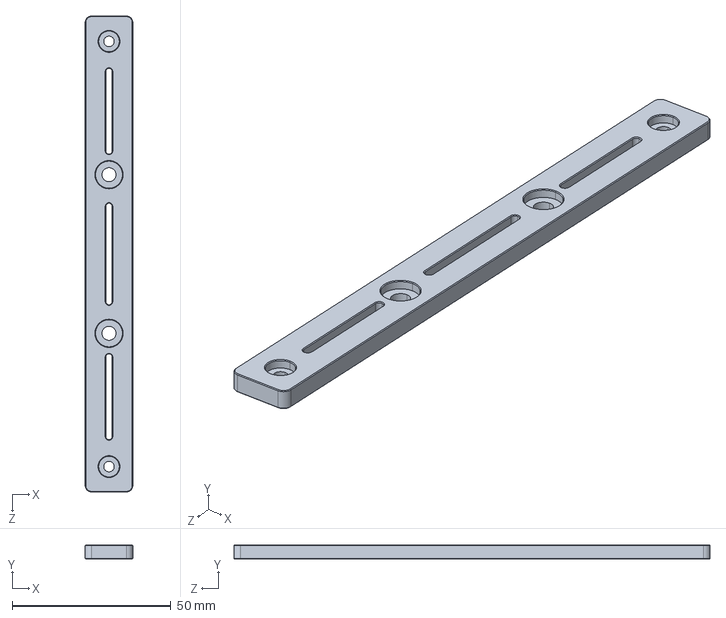
[picture p68: CAD file, 2026-04-05]
source/B站【大鱼DIY】3D打印机Dayu TT V1.21全套资料/通用辅助功能配件_非必须/04_下位机_小政K6安装盒/STP格式/电源固定支架_小政K6.STEP
15.0 x 4.50 x 150.0 mm
