arbaleast/dayu-tt-all-in-one/source/B站【大鱼DIY】3D打印机Dayu TT V1.21全套资料/通用辅助功能配件_非必须/11_5015风道_带支架/5015风道.STEP

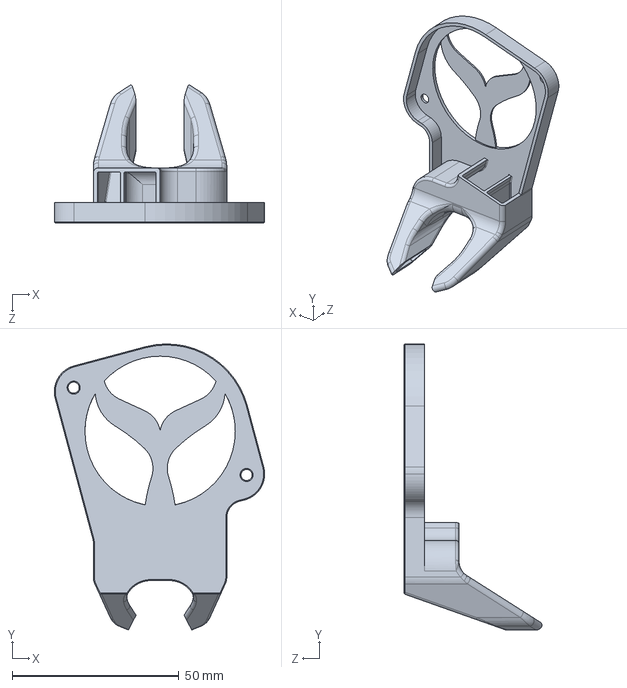
[picture p69: CAD file, 2026-04-05]
source/B站【大鱼DIY】3D打印机Dayu TT V1.21全套资料/通用辅助功能配件_非必须/11_5015风道_带支架/5015风道.STEP
63.0 x 85.6 x 41.3 mm
