arbaleast/dayu-tt-all-in-one/source/B站【大鱼DIY】3D打印机Dayu TT V1.21全套资料/通用辅助功能配件_非必须/12_Klicky调平/klicky停靠坞_TT.STEP

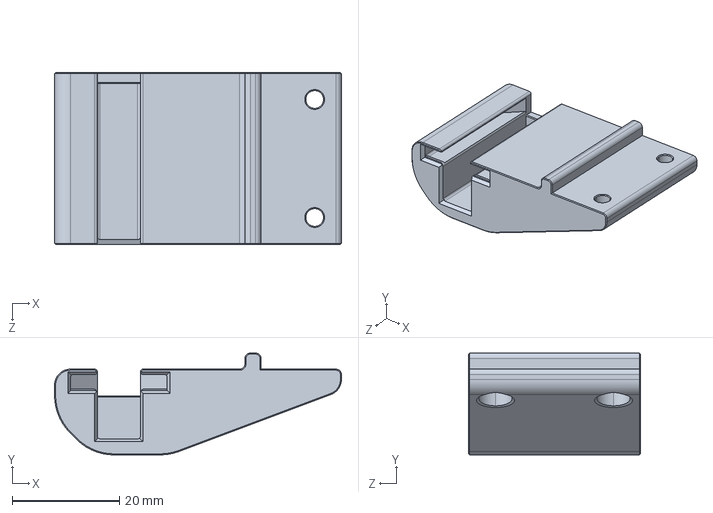
[picture p70: CAD file, 2026-04-05]
source/B站【大鱼DIY】3D打印机Dayu TT V1.21全套资料/通用辅助功能配件_非必须/12_Klicky调平/klicky停靠坞_TT.STEP
53.5 x 19.0 x 32.0 mm
