arbaleast/dayu-tt-all-in-one/enclosure/freecad/BottomBracketWithTabs.FCStd

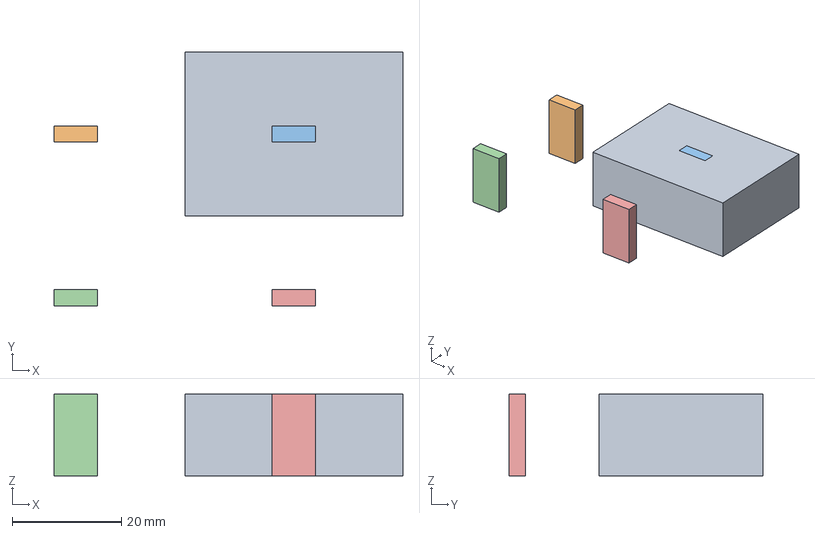
[picture p72: CAD file, 2026-04-05]
enclosure/freecad/BottomBracketWithTabs.FCStd
64.0 x 46.5 x 15.0 mm
Tab_0
Tab_1
Tab_2
Tab_3
