arbaleast/dayu-tt-all-in-one/source/B站【大鱼DIY】3D打印机Dayu TT V1.21全套资料/TT235资料/TT235封箱资料/封箱打印件图纸/红米手机外壳图纸/STP格式/红米底托.STEP

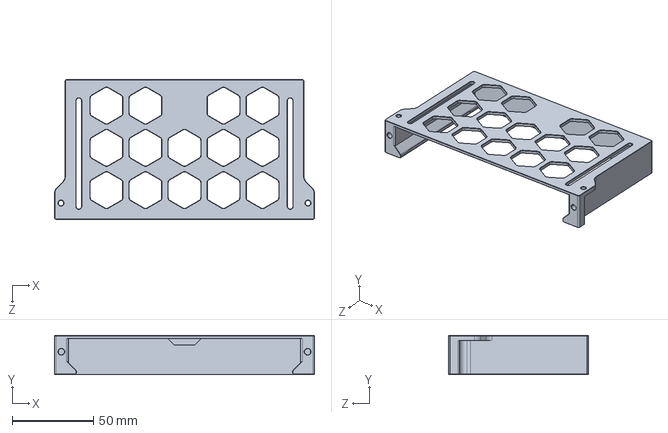
[picture p77: CAD file, 2026-04-05]
source/B站【大鱼DIY】3D打印机Dayu TT V1.21全套资料/TT235资料/TT235封箱资料/封箱打印件图纸/红米手机外壳图纸/STP格式/红米底托.STEP
160.0 x 24.0 x 86.0 mm
