arbaleast/dayu-tt-all-in-one/source/B站【大鱼DIY】3D打印机Dayu TT V1.21全套资料/TT310资料/TT310封箱资料/封箱亚克力板图纸/DXF格式图纸/前底板_厚度3mm_黑色.DXF

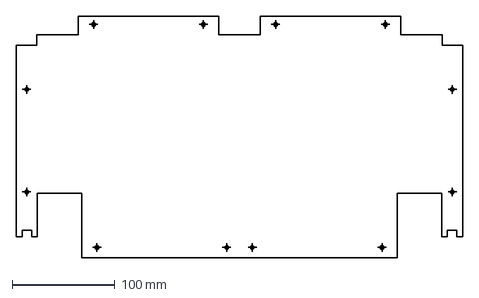
[picture p78: CAD file, 2026-04-05]
source/B站【大鱼DIY】3D打印机Dayu TT V1.21全套资料/TT310资料/TT310封箱资料/封箱亚克力板图纸/DXF格式图纸/前底板_厚度3mm_黑色.DXF
435.0 x 235.5 mm
