arbaleast/dayu-tt-all-in-one/source/B站【大鱼DIY】3D打印机Dayu TT V1.21全套资料/TT310资料/TT310封箱资料/封箱打印件图纸/STL格式/前后横梁及底板支撑.stl

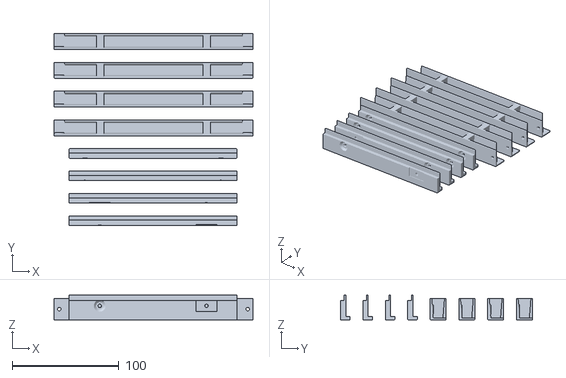
[picture p80: CAD file, 2026-04-05]
source/B站【大鱼DIY】3D打印机Dayu TT V1.21全套资料/TT310资料/TT310封箱资料/封箱打印件图纸/STL格式/前后横梁及底板支撑.stl
186.5 x 180.0 x 23.0
