arbaleast/dayu-tt-all-in-one/enclosure/dxf_v2/DOOR_HANDLE_OUTLINE.DXF

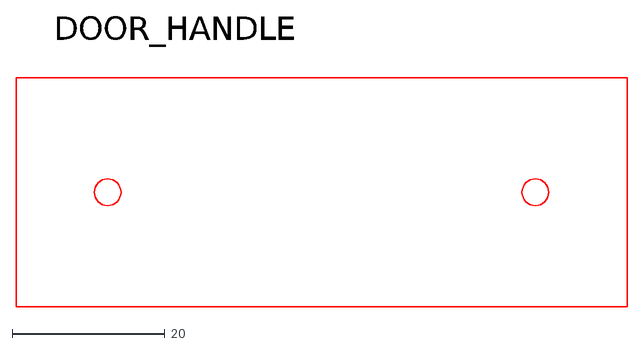
[picture p84: CAD file, 2026-04-05]
enclosure/dxf_v2/DOOR_HANDLE_OUTLINE.DXF
DOOR_HANDLE
