arbaleast/dayu-tt-all-in-one/enclosure/freecad/CornerBracket.FCStd

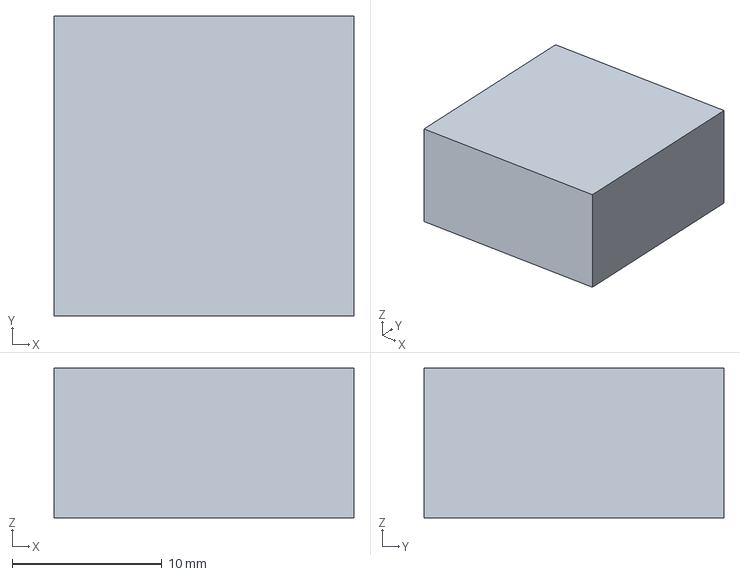
[picture p85: CAD file, 2026-04-05]
enclosure/freecad/CornerBracket.FCStd
20.0 x 20.0 x 10.0 mm
