arbaleast/dayu-tt-all-in-one/source/B站【大鱼DIY】3D打印机Dayu TT V1.21全套资料/通用辅助功能配件_非必须/04_下位机_小政K6安装盒/STP格式/下位机保护壳_小政K6.STEP

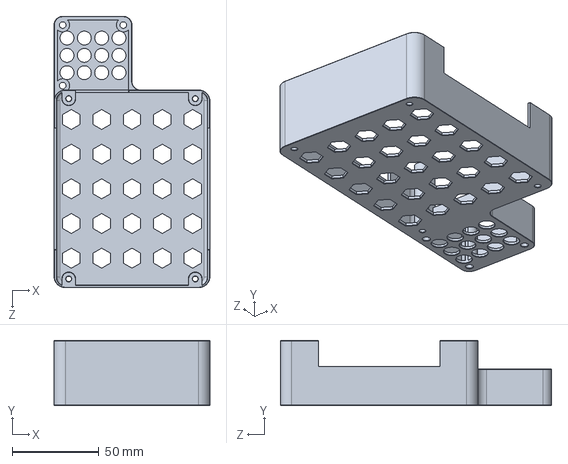
[picture p95: CAD file, 2026-04-05]
source/B站【大鱼DIY】3D打印机Dayu TT V1.21全套资料/通用辅助功能配件_非必须/04_下位机_小政K6安装盒/STP格式/下位机保护壳_小政K6.STEP
90.0 x 37.6 x 156.5 mm
