arbaleast/dayu-tt-all-in-one/enclosure/dxf_v2/BACK_PANEL_530x770x3.DXF

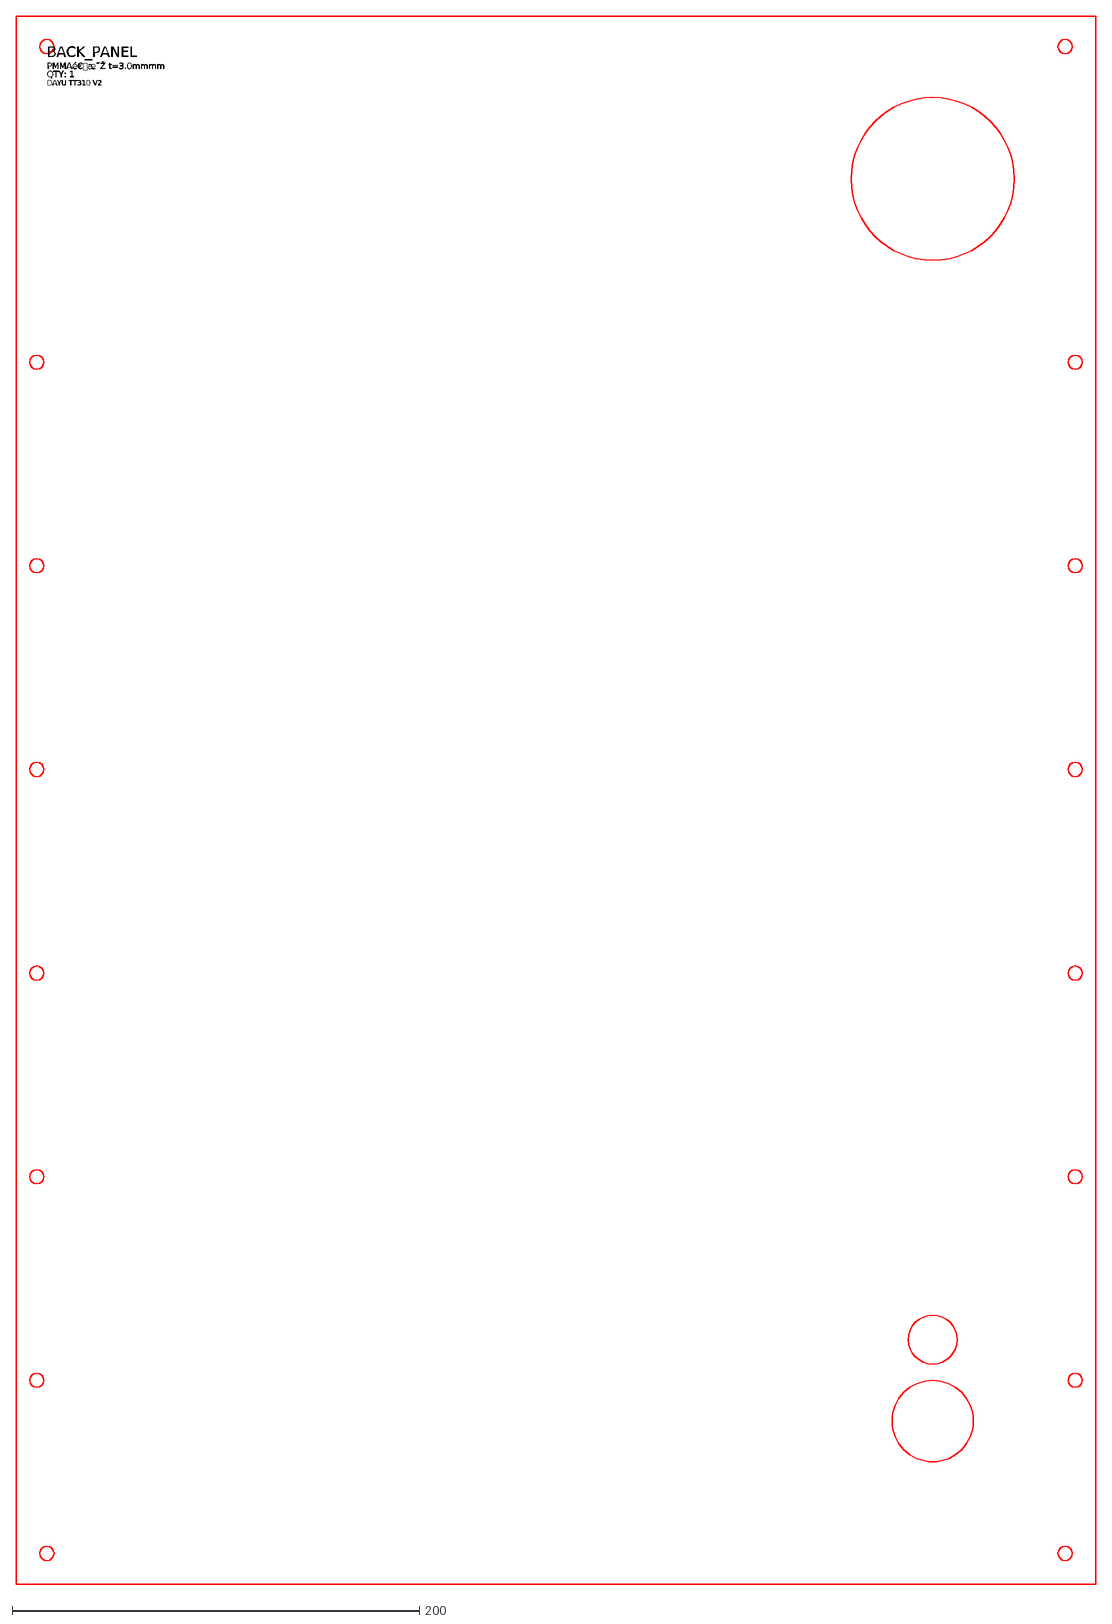
[picture p96: CAD file, 2026-04-05]
enclosure/dxf_v2/BACK_PANEL_530x770x3.DXF
BACK_PANEL
QTY: 1
DAYU TT310 V2
