arbaleast/dayu-tt-all-in-one/source/B站【大鱼DIY】3D打印机Dayu TT V1.21全套资料/TT235资料/TT235封箱资料/封箱亚克力板图纸/DXF格式图纸/背板_厚度3mm_透明或黑色.DXF

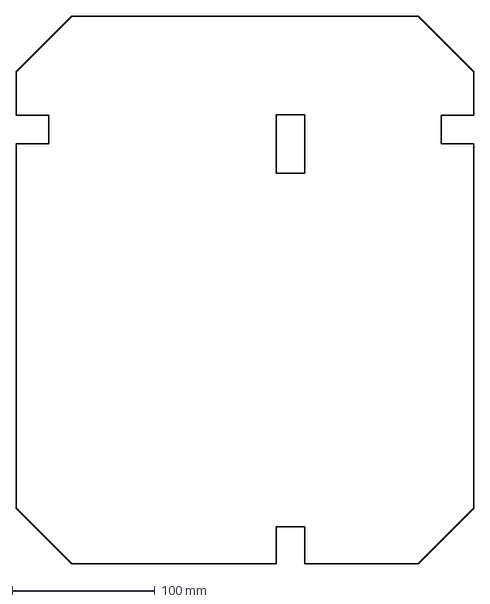
[picture p97: CAD file, 2026-04-05]
source/B站【大鱼DIY】3D打印机Dayu TT V1.21全套资料/TT235资料/TT235封箱资料/封箱亚克力板图纸/DXF格式图纸/背板_厚度3mm_透明或黑色.DXF
321.0 x 384.0 mm
