arbaleast/dayu-tt-all-in-one/enclosure/dxf_v2/SIDE_PANEL_Y2_530x770x4.DXF

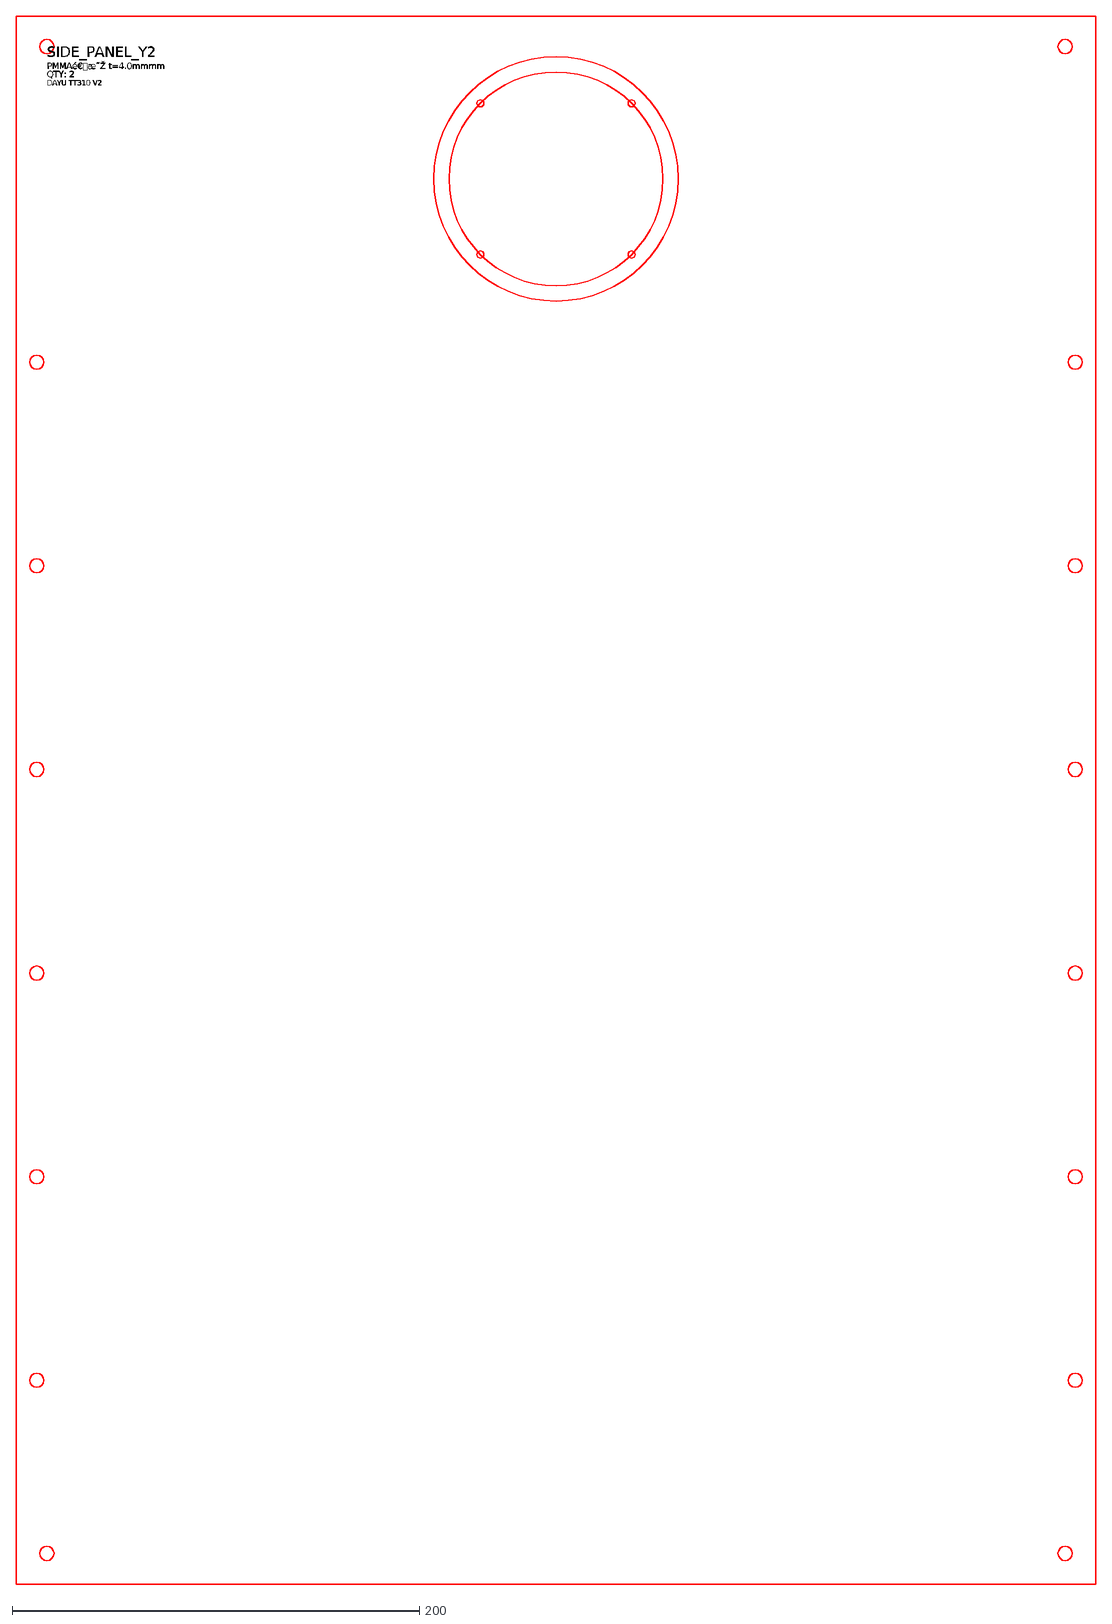
[picture p103: CAD file, 2026-04-05]
enclosure/dxf_v2/SIDE_PANEL_Y2_530x770x4.DXF
SIDE_PANEL_Y2
QTY: 2
DAYU TT310 V2
