arbaleast/dayu-tt-all-in-one/enclosure/freecad/FootPad.FCStd

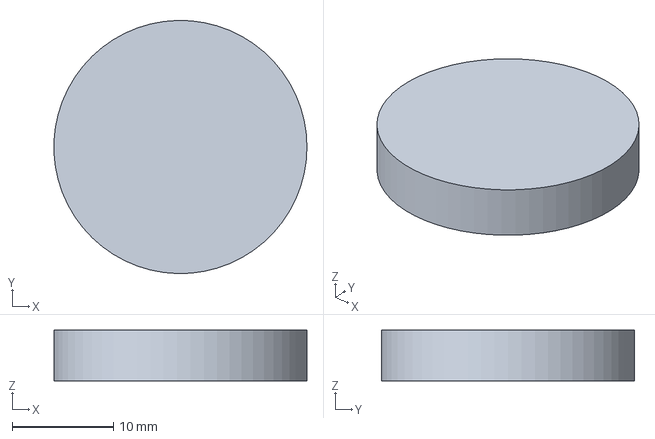
[picture p104: CAD file, 2026-04-05]
enclosure/freecad/FootPad.FCStd
25.0 x 25.0 x 5.00 mm
