arbaleast/dayu-tt-all-in-one/enclosure/dxf_v2/TOP_PANEL_520x530x3.DXF

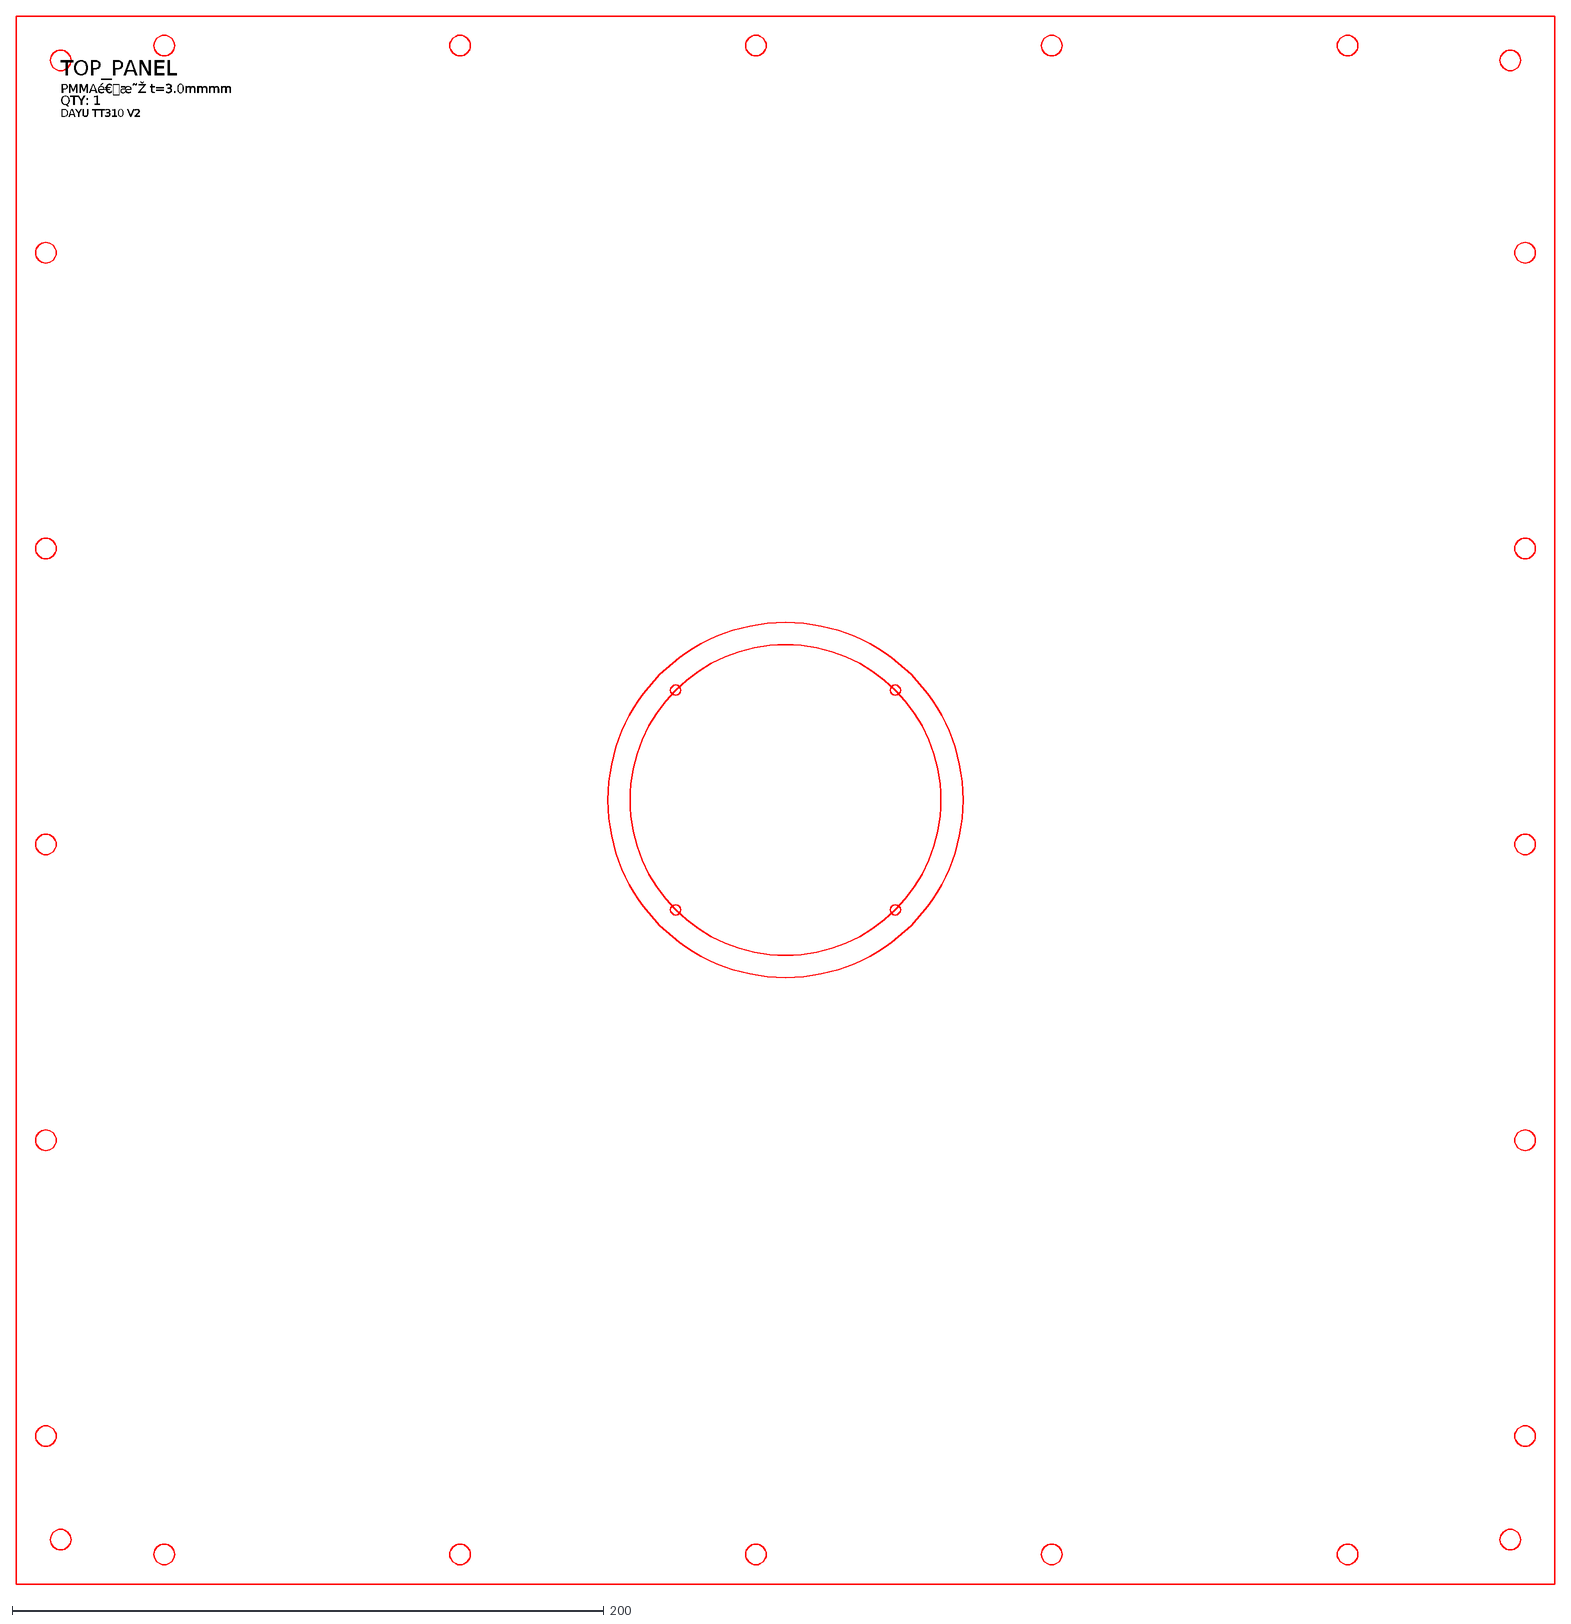
[picture p112: CAD file, 2026-04-05]
enclosure/dxf_v2/TOP_PANEL_520x530x3.DXF
TOP_PANEL
QTY: 1
DAYU TT310 V2
