arbaleast/dayu-tt-all-in-one/enclosure/freecad/TopFanMount.FCStd

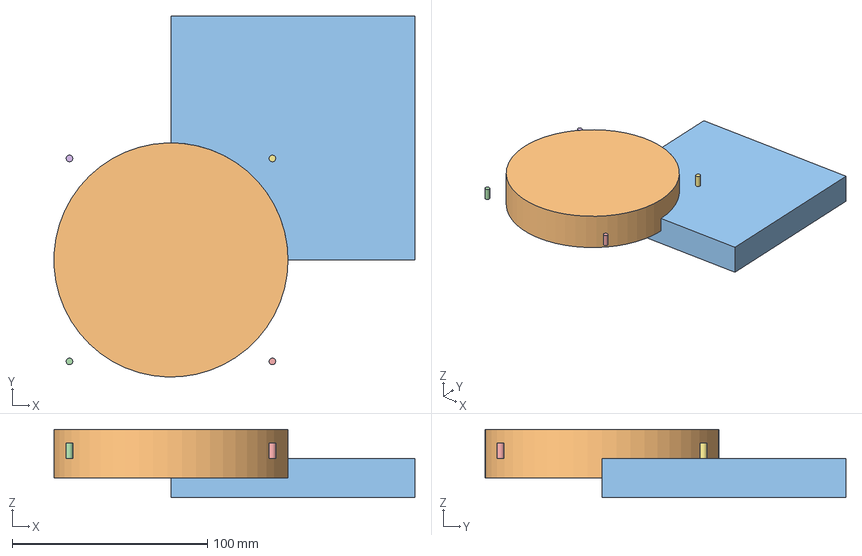
[picture p113: CAD file, 2026-04-05]
enclosure/freecad/TopFanMount.FCStd
184.9 x 185.0 x 35.0 mm
FanHole
TopFanMountWithHole
Hole__52__52
Hole_52__52
Hole__52_52
Hole_52_52
