arbaleast/dayu-tt-all-in-one/(list of files, cad)

Other CAD files:
enclosure/freecad/Assembly.FCStd
enclosure/dxf/SidePanel_Y.dxf
enclosure/stl/BottomBracket.stl
enclosure/dxf/FrontDoor.dxf
enclosure/stl_v2/CableEntryRingV2.stl
source/B站【大鱼DIY】3D打印机Dayu TT V1.21全套资料/TT235资料/TT235_CNC零件图纸/TT_X/TT_X_右.STEP
source/B站【大鱼DIY】3D打印机Dayu TT V1.21全套资料/TT235资料/TT235_CNC零件图纸/TT_Z/TT_Z_后.STEP
source/B站【大鱼DIY】3D打印机Dayu TT V1.21全套资料/TT235资料/TT235封箱资料/封箱亚克力板图纸/STP格式图纸/前底板.STEP
source/B站【大鱼DIY】3D打印机Dayu TT V1.21全套资料/TT235资料/TT235封箱资料/封箱打印件图纸/STP格式/伸缩窗.STEP
source/B站【大鱼DIY】3D打印机Dayu TT V1.21全套资料/TT310资料/TT310_CNC零件图纸/TT_Z/TT_Z_后.STEP
enclosure/dxf/SidePanel_X.dxf
enclosure/stl_v2/TensionerA_Arm.stl
source/B站【大鱼DIY】3D打印机Dayu TT V1.21全套资料/TT235资料/TT235_CNC零件图纸/TT_Z/TT_Z_右.STEP
source/B站【大鱼DIY】3D打印机Dayu TT V1.21全套资料/TT235资料/TT235封箱资料/顶部增高架/顶部增高架.SLDPRT
source/B站【大鱼DIY】3D打印机Dayu TT V1.21全套资料/TT310资料/TT310_CNC零件图纸/TT_X/TT_X_右.STEP
source/B站【大鱼DIY】3D打印机Dayu TT V1.21全套资料/TT310资料/TT310_CNC零件图纸/TT_Z/TT_Z_右.STEP
enclosure/dxf/BottomPanel.dxf
enclosure/stl_v2/TensionerA_Base.stl
source/B站【大鱼DIY】3D打印机Dayu TT V1.21全套资料/TT235资料/TT235封箱资料/顶部增高架/伸缩窗_4件.STEP
enclosure/dxf/TopPanel.dxf
enclosure/stl_v2/BottomBracketV2.stl
enclosure/dxf/BackPanel.dxf
enclosure/stl_v2/TensionerB_SpringRing.stl
source/B站【大鱼DIY】3D打印机Dayu TT V1.21全套资料/TT310资料/TT310封箱资料/封箱亚克力板图纸/STP格式图纸/前底板.STEP
enclosure/stl_v2/TensionerB_Base.stl
source/B站【大鱼DIY】3D打印机Dayu TT V1.21全套资料/TT235资料/TT235封箱资料/封箱打印件图纸/STP格式/顶部增高架.STEP
source/B站【大鱼DIY】3D打印机Dayu TT V1.21全套资料/TT310资料/TT310封箱资料/封箱打印件图纸/STP格式/品字开关安装座.STEP
enclosure/freecad/BottomBracketBody.FCStd
enclosure/freecad/CableEntryRing.FCStd
enclosure/freecad/DoorFrameReinforcement.FCStd
enclosure/freecad/DoorHandle.FCStd
enclosure/freecad/FilterFrame.FCStd
enclosure/freecad/HingeMount.FCStd
enclosure/freecad/MagnetHolder.FCStd
enclosure/freecad/SidePanelClip.FCStd
enclosure/freecad/TopPlateMount.FCStd
enclosure/freecad/VentCover.FCStd
enclosure/stl/CableEntryRing.stl
enclosure/stl/CornerBracket.stl
enclosure/stl/DoorFrameReinforcement.stl
enclosure/stl/DoorHandle.stl
enclosure/stl/FilterFrame.stl
enclosure/stl/FootMount.stl
enclosure/stl/FootPad.stl
enclosure/stl/HingeMount.stl
enclosure/stl/MagnetHolder.stl
enclosure/stl/SidePanelClip.stl
enclosure/stl/TopFanMount.stl
enclosure/stl/TopPlateMount.stl
enclosure/stl/VentCover.stl
enclosure/stl_v2/DoorHingeMountV2.stl
enclosure/stl_v2/FootMountV2.stl
enclosure/stl_v2/FootPadV2.stl
enclosure/stl_v2/MagnetHolderV2.stl
enclosure/stl_v2/SidePanelClipV2.stl
enclosure/stl_v2/TensionerA_EccentricSleeve.stl
enclosure/stl_v2/TensionerA_Idler.stl
enclosure/stl_v2/TensionerA_Spring.stl
enclosure/stl_v2/TensionerA_Stop.stl
enclosure/stl_v2/TensionerB_Idler.stl
enclosure/stl_v2/TensionerB_Slider.stl
enclosure/stl_v2/TopFanMountV2.stl
source/B站【大鱼DIY】3D打印机Dayu TT V1.21全套资料/TT235资料/TT235封箱资料/封箱打印件图纸/STL格式/下位机安装支架_小政K6.stl
source/B站【大鱼DIY】3D打印机Dayu TT V1.21全套资料/TT235资料/TT235封箱资料/封箱打印件图纸/STP格式/下位机安装支架_小政K6.STEP
source/B站【大鱼DIY】3D打印机Dayu TT V1.21全套资料/TT235资料/TT235封箱资料/封箱打印件图纸/STP格式/亚克力板卡扣.STEP
source/B站【大鱼DIY】3D打印机Dayu TT V1.21全套资料/TT235资料/TT235封箱资料/封箱打印件图纸/STP格式/品字开关安装座.STEP
source/B站【大鱼DIY】3D打印机Dayu TT V1.21全套资料/TT235资料/TT235封箱资料/封箱打印件图纸/STP格式/封箱_下四角.STEP
source/B站【大鱼DIY】3D打印机Dayu TT V1.21全套资料/TT235资料/TT235封箱资料/封箱打印件图纸/STP格式/封箱_八立柱.STEP
source/B站【大鱼DIY】3D打印机Dayu TT V1.21全套资料/TT235资料/TT235封箱资料/封箱打印件图纸/STP格式/封箱_后下装饰板.STEP
source/B站【大鱼DIY】3D打印机Dayu TT V1.21全套资料/TT235资料/TT235封箱资料/封箱打印件图纸/STP格式/封箱_背面横梁.STEP
source/B站【大鱼DIY】3D打印机Dayu TT V1.21全套资料/TT235资料/TT235封箱资料/封箱打印件图纸/STP格式/封箱_顶部横梁.STEP
source/B站【大鱼DIY】3D打印机Dayu TT V1.21全套资料/TT235资料/TT235封箱资料/封箱打印件图纸/STP格式/底板支撑块.STEP
source/B站【大鱼DIY】3D打印机Dayu TT V1.21全套资料/TT235资料/TT235封箱资料/封箱打印件图纸/STP格式/提手.STEP
source/B站【大鱼DIY】3D打印机Dayu TT V1.21全套资料/TT235资料/TT235封箱资料/封箱打印件图纸/STP格式/料架延长杆.STEP
source/B站【大鱼DIY】3D打印机Dayu TT V1.21全套资料/TT235资料/TT235封箱资料/封箱打印件图纸/STP格式/磁铁座_下.STEP
source/B站【大鱼DIY】3D打印机Dayu TT V1.21全套资料/TT235资料/TT235封箱资料/封箱打印件图纸/STP格式/顶板磁铁固定座.STEP
source/B站【大鱼DIY】3D打印机Dayu TT V1.21全套资料/TT235资料/TT235封箱资料/封箱打印件图纸/STP格式/顶板磁铁座.STEP
source/B站【大鱼DIY】3D打印机Dayu TT V1.21全套资料/TT235资料/TT235封箱资料/封箱打印件图纸/红米手机外壳图纸/STL格式/红米2A外壳.STL
source/B站【大鱼DIY】3D打印机Dayu TT V1.21全套资料/TT235资料/TT235封箱资料/封箱打印件图纸/红米手机外壳图纸/STL格式/红米2A锁块.STL
source/B站【大鱼DIY】3D打印机Dayu TT V1.21全套资料/TT235资料/TT235封箱资料/封箱打印件图纸/红米手机外壳图纸/STL格式/红米底托.STL
source/B站【大鱼DIY】3D打印机Dayu TT V1.21全套资料/TT235资料/TT235打印件图纸/STL格式/4020风道_TT.STL
source/B站【大鱼DIY】3D打印机Dayu TT V1.21全套资料/TT235资料/TT235打印件图纸/STL格式/X限位触发器.STL
source/B站【大鱼DIY】3D打印机Dayu TT V1.21全套资料/TT235资料/TT235打印件图纸/STL格式/Y轴限位支架.STL
source/B站【大鱼DIY】3D打印机Dayu TT V1.21全套资料/TT310资料/TT310封箱资料/封箱打印件图纸/STL格式/下位机安装支架_小政K6.stl
source/B站【大鱼DIY】3D打印机Dayu TT V1.21全套资料/TT310资料/TT310封箱资料/封箱打印件图纸/STP格式/下位机安装支架_小政K6.STEP
source/B站【大鱼DIY】3D打印机Dayu TT V1.21全套资料/TT310资料/TT310封箱资料/封箱打印件图纸/STP格式/亚克力板卡扣.STEP
source/B站【大鱼DIY】3D打印机Dayu TT V1.21全套资料/TT310资料/TT310封箱资料/封箱打印件图纸/STP格式/封箱_上四角.STEP
source/B站【大鱼DIY】3D打印机Dayu TT V1.21全套资料/TT310资料/TT310封箱资料/封箱打印件图纸/STP格式/封箱_下四角.STEP
source/B站【大鱼DIY】3D打印机Dayu TT V1.21全套资料/TT310资料/TT310封箱资料/封箱打印件图纸/STP格式/封箱_八侧边.STEP
source/B站【大鱼DIY】3D打印机Dayu TT V1.21全套资料/TT310资料/TT310封箱资料/封箱打印件图纸/STP格式/封箱_八立柱.STEP
source/B站【大鱼DIY】3D打印机Dayu TT V1.21全套资料/TT310资料/TT310封箱资料/封箱打印件图纸/STP格式/封箱_前下装饰板.STEP
source/B站【大鱼DIY】3D打印机Dayu TT V1.21全套资料/TT310资料/TT310封箱资料/封箱打印件图纸/STP格式/封箱_背面横梁.STEP
source/B站【大鱼DIY】3D打印机Dayu TT V1.21全套资料/TT310资料/TT310封箱资料/封箱打印件图纸/STP格式/底板支撑块.STEP
source/B站【大鱼DIY】3D打印机Dayu TT V1.21全套资料/TT310资料/TT310封箱资料/封箱打印件图纸/STP格式/提手.STEP
source/B站【大鱼DIY】3D打印机Dayu TT V1.21全套资料/TT310资料/TT310封箱资料/封箱打印件图纸/STP格式/料架延长杆.STEP
source/B站【大鱼DIY】3D打印机Dayu TT V1.21全套资料/TT310资料/TT310封箱资料/封箱打印件图纸/STP格式/磁铁座_下.STEP
source/B站【大鱼DIY】3D打印机Dayu TT V1.21全套资料/TT310资料/TT310封箱资料/封箱打印件图纸/STP格式/顶板磁铁固定座.STEP
source/B站【大鱼DIY】3D打印机Dayu TT V1.21全套资料/TT310资料/TT310封箱资料/封箱打印件图纸/STP格式/顶板磁铁座.STEP
source/B站【大鱼DIY】3D打印机Dayu TT V1.21全套资料/TT310资料/TT310封箱资料/封箱打印件图纸/红米手机外壳图纸/STL格式/红米2A外壳.STL
source/B站【大鱼DIY】3D打印机Dayu TT V1.21全套资料/TT310资料/TT310封箱资料/封箱打印件图纸/红米手机外壳图纸/STL格式/红米2A锁块.STL
source/B站【大鱼DIY】3D打印机Dayu TT V1.21全套资料/TT310资料/TT310封箱资料/封箱打印件图纸/红米手机外壳图纸/STL格式/红米底托.STL
source/B站【大鱼DIY】3D打印机Dayu TT V1.21全套资料/TT310资料/TT310打印件图纸/STL格式/4020风道_TT.STL
source/B站【大鱼DIY】3D打印机Dayu TT V1.21全套资料/TT310资料/TT310打印件图纸/STL格式/X限位触发器.STL
source/B站【大鱼DIY】3D打印机Dayu TT V1.21全套资料/TT310资料/TT310打印件图纸/STL格式/Y轴限位支架.STL
source/B站【大鱼DIY】3D打印机Dayu TT V1.21全套资料/通用辅助功能配件_非必须/01_PEI板定位块/PEI板定位块.STL
source/B站【大鱼DIY】3D打印机Dayu TT V1.21全套资料/通用辅助功能配件_非必须/02_上位机_红米2A安装盒/抽屉版/红米2A前盖板.STL
source/B站【大鱼DIY】3D打印机Dayu TT V1.21全套资料/通用辅助功能配件_非必须/02_上位机_红米2A安装盒/抽屉版/红米2A夹子_右.STL
source/B站【大鱼DIY】3D打印机Dayu TT V1.21全套资料/通用辅助功能配件_非必须/02_上位机_红米2A安装盒/抽屉版/红米2A夹子_左.STL
source/B站【大鱼DIY】3D打印机Dayu TT V1.21全套资料/通用辅助功能配件_非必须/04_下位机_小政K6安装盒/STL格式/1020铝型材支架.STL
source/B站【大鱼DIY】3D打印机Dayu TT V1.21全套资料/通用辅助功能配件_非必须/04_下位机_小政K6安装盒/STL格式/下位机保护壳_小政K6.STL
source/B站【大鱼DIY】3D打印机Dayu TT V1.21全套资料/通用辅助功能配件_非必须/04_下位机_小政K6安装盒/STL格式/下位机安装支架_小政K6.STL
source/B站【大鱼DIY】3D打印机Dayu TT V1.21全套资料/通用辅助功能配件_非必须/04_下位机_小政K6安装盒/STL格式/电源固定支架_小政K6.STL
source/B站【大鱼DIY】3D打印机Dayu TT V1.21全套资料/通用辅助功能配件_非必须/04_下位机_小政K6安装盒/小政K6_电控组件.x_t
source/B站【大鱼DIY】3D打印机Dayu TT V1.21全套资料/通用辅助功能配件_非必须/05_MGN9辅助定位块/装配辅助定位块.STL
source/B站【大鱼DIY】3D打印机Dayu TT V1.21全套资料/通用辅助功能配件_非必须/06_料架/料架NEW.STL
source/B站【大鱼DIY】3D打印机Dayu TT V1.21全套资料/通用辅助功能配件_非必须/07_品字开关安装座/品字开关安装座.STL
source/B站【大鱼DIY】3D打印机Dayu TT V1.21全套资料/通用辅助功能配件_非必须/08_过线套/过线套.STL
source/B站【大鱼DIY】3D打印机Dayu TT V1.21全套资料/通用辅助功能配件_非必须/09_护线套/护线套.STL
source/B站【大鱼DIY】3D打印机Dayu TT V1.21全套资料/通用辅助功能配件_非必须/10_气动接头安装扣/气动接头安装扣.STL
source/B站【大鱼DIY】3D打印机Dayu TT V1.21全套资料/通用辅助功能配件_非必须/11_5015风道_带支架/5015支架.STL
source/B站【大鱼DIY】3D打印机Dayu TT V1.21全套资料/通用辅助功能配件_非必须/11_5015风道_带支架/5015风道.STL
source/B站【大鱼DIY】3D打印机Dayu TT V1.21全套资料/通用辅助功能配件_非必须/13_辅助散热风扇/12032风扇支架.STEP
source/B站【大鱼DIY】3D打印机Dayu TT V1.21全套资料/通用辅助功能配件_非必须/13_辅助散热风扇/12032风道.STEP
