arbaleast/dayu-tt-all-in-one/source/B站【大鱼DIY】3D打印机Dayu TT V1.21全套资料/大鱼TT装配图.md

# 大鱼TT装配图.png 图像描述

**原始文件:** /vol1/1000/projects/3d-printing/dayu-tt-all-in-one/source/B站【大鱼DIY】3D打印机Dayu TT V1.21全套资料/大鱼TT装配图.png

## Moondream 描述

The image shows a 3D rendering of a complex machine, likely a printer or a 3D printer. The machine is housed in a black metal frame and has various components such as a base, a screen, and a control panel. There are also several parts visible on the front side of the machine, including a red button and a small window. The image provides an overview of the different elements that make up this intricate piece of machinery.
