arbaleast/dayu-tt-all-in-one/source/B站【大鱼DIY】3D打印机Dayu TT V1.21全套资料/通用辅助功能配件_非必须/12_Klicky调平/Klicky装配图.md

# Klicky装配图.jpg 图像描述

**原始文件:** /vol1/1000/projects/3d-printing/dayu-tt-all-in-one/source/B站【大鱼DIY】3D打印机Dayu TT V1.21全套资料/通用辅助功能配件_非必须/12_Klicky调平/Klicky装配图.jpg

## 内容说明

Klicky 探针自动调平系统装配图。

主要内容：
- Klicky 探针主体展示
- 磁吸连接设计
- 微动开关位置
- 舵机安装方式
- 安装在打印头侧面的效果
- 与 Voron/大鱼 TT X 轴滑车适配

Klicky 是一种可拆卸的磁性微动开关探针系统，通过磁吸方式装卸，便于维护和更换。

相关文档：docs/00-入门指南/4-安装指南索引.md
