arbaleast/dayu-tt-all-in-one/source/B站【大鱼DIY】3D打印机Dayu TT V1.21全套资料/大鱼TT装配图.png

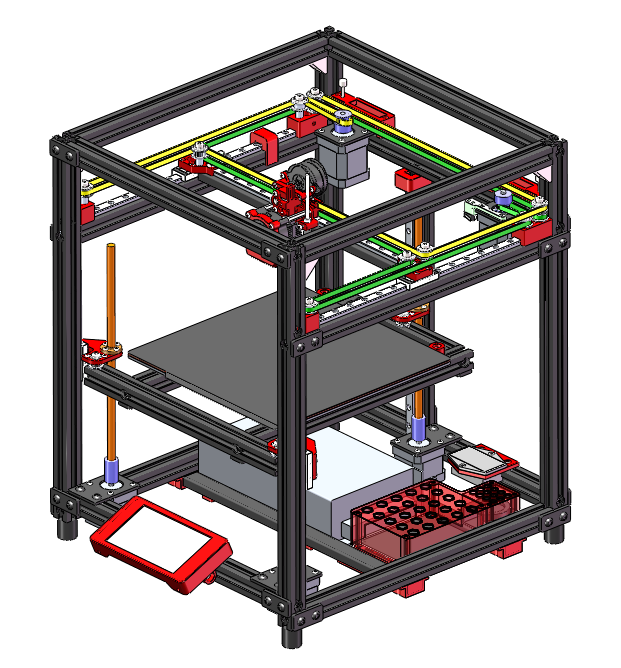
source/B站【大鱼DIY】3D打印机Dayu TT V1.21全套资料/大鱼TT装配图.png
