arbaleast/dayu-tt-all-in-one/docs/VALIDATION/03_TT310机械薄弱点分析.md

# TT310（310×310×310mm）机械结构薄弱点分析报告

**作者：AI 研究助手 | 日期：2026-03-29**
**基础路径：** `/vol1/1000/projects/3d-printing/dayu-tt-all-in-one/`
**参考文档：** 结构力学与热力学研究报告、框架刚性增强、CoreXY深度研究报告、完整物料清单.csv

---

## 一、框架结构分析

### 1.1 2020 铝型材在 310mm 跨距下的弯曲刚度

**当前状态：** BOM 显示框架使用 2020 铝型材（"若干"，¥80-120）。

**弯曲刚度计算（参考结构力学报告）：**

简支梁/悬臂梁模型，弯曲挠度公式：

$$\delta_{max} = \frac{F \cdot L^3}{48 \cdot E \cdot I} \quad \text{（简支）} \quad \delta_{max} = \frac{F \cdot L^3}{3 \cdot E \cdot I} \quad \text{（悬臂）}$$

6063-T6 铝合金参数：E = 68.9 GPa，Ix(2020) = 0.561 cm⁴ = 5.61×10³ mm⁴

| 型材 | L=310mm 悬臂挠度（15kg 载荷）| 相对刚度 |
|---|---|---|
| **2020** | **0.42 mm** | 1.00× |
| 2040（强轴弯曲）| 0.038 mm | **11.1×** |

**⚠️ 核心问题：** TT310 的 X 轴跨距 310mm，完全由 2020 型材承担。在打印头高速运动（加速度 3000-5000 mm/s²）产生的惯性力作用下，X 梁会产生可见弯曲，导致：
- 打印件 X 方向出现明显层纹（尤其在大尺寸打印时）
- 层高误差随 X 位置线性累积
- 告诉打印时"鬼影"（ghosting）缺陷

### 1.2 现有角码连接（16-20 个）是否足够

**当前状态：** BOM 列出 2020 角码 16-20 个（¥15-25），M5 T 型螺母 50-80 个。

**分析：**

对于 310mm 方框框架，角码数量评估如下：

| 连接点类型 | 数量 | 角码需求 | BOM 数量 | 评估 |
|---|---|---|---|---|
| 四角主连接 | 4 | 4 个 | 包含在内 | ✅ 够用 |
| 底部框架支撑点 | 4-8 | 4-8 个 | 包含在内 | ⚠️ 偏少 |
| 顶框加强（可选）| 4 | 4 个 | 包含在内 | ✅ 够用 |
| 对角斜撑端部 | 4 | 4 个 | **不含** | ❌ 缺失 |

**薄弱点：**
1. **缺少对角斜撑（Diagonal Bracing）**：纯 2020 框架在斜向力（打印头高速转向时的惯性分力）作用下容易发生菱形变形。对角斜撑可提升框架整体刚性 30-40%，但 BOM 中完全没有列出。
2. **角码质量存疑**：BOM 标注"标准件 ¥15-25"，这类低价角码通常为塑料或薄铝合金，承力能力有限。推荐 Voron 专用 CNC 角码（¥25+，6061-T5）。
3. **底部框架角码受力最重**：热床 + 玻璃 + 打印件（总计 8-15 kg）全部压在底部四个角上，每个角码承受约 2-4 kg 静态 + 动态载荷，低质量角码存在屈服风险。

### 1.3 底部框架受力分析

**受力构成：**

| 载荷来源 | 重量/数值 | 说明 |
|---|---|---|
| 铝基板（310×310×2mm）| ~2.5 kg | BOSSAC 或 MK 热床 |
| 玻璃/PEI 板 | ~1.5 kg | 4mm 硼硅玻璃 |
| 保温棉 | ~0.3 kg | 10mm 玻璃纤维棉 |
| 框架自重（4×310mm 2020）| ~2.0 kg | 型材重量 |
| 典型打印件 | 0-5 kg | 取决于打印体积 |
| **合计** | **6-11 kg** | 静止重量 |
| Y 向运动惯性 | F = m×a ≈ 5kg×3000mm/s² ≈ **15 N** | 高速打印时 |

**⚠️ 核心问题：** 底部框架是整台机器受力最集中的部位，但 BOM 仅使用与顶部相同的 2020 型材，无额外加强。底部框架在以下三种工况下存在变形风险：

1. **热床静载荷**：长期承重导致型材疲劳
2. **打印头 Y 向运动惯性**：周期性加载引起微振动累积
3. **热致变形**：热床 100°C 工作时，热量传导至框架，产生不均匀热膨胀

**结论：** 底部框架需要 2040 型材 + 对角斜撑才能安全承受 TT310 的工作载荷。

---

## 二、运动系统分析

### 2.1 CoreXY 滑架重量估算

**当前状态：** BOM 中无滑架相关物料（推测为自购或 3D 打印）。

**3D 打印件 vs CNC 件的重量差异：**

| 材料/方案 | 密度 (kg/m³) | 100×80×20mm 滑架重量 | 刚度 | 推荐度 |
|---|---|---|---|---|
| PLA（3D 打印）| 1250 | ~160g | 低 | ⭐ |
| PETG（3D 打印）| 1270 | ~165g | 中低 | ⭐⭐ |
| ABS（3D 打印）| 1050 | ~135g | 中 | ⭐⭐ |
| CNC 6061 铝合金 | 2700 | ~346g | 高 | ⭐⭐⭐⭐⭐ |
| FR4 PCB 材料 | 1850 | ~237g | 中高 | ⭐⭐⭐⭐ |

**⚠️ 核心问题：** 如果使用 PLA 或普通 PETG 打印滑架，存在以下风险：

1. **刚性不足**：在 5000 mm/s² 加速度下，0.16kg 的 PLA 滑架会产生较大惯性变形，导致：
   - Z 轴跳动（Z-hop 变形）
   - XY 平面内滑架倾斜
   - 皮带张力引起滑架侧翻

2. **热蠕变**：封闭腔体温度 40-50°C 时，PLA 滑架在持续热载荷下会发生软化变形（PLA Tg ≈ 55-60°C）

3. **层间结合力不足**：3D 打印滑架的 Z 向强度取决于打印质量，高速打印振动可能导致微裂纹

**滑架刚度要求计算：**

$$\delta_{allow} = \frac{m_{total} \cdot a}{k_{gantry}} \leq 0.05 \text{ mm}$$

m_total ≈ 0.5 kg，a = 5000 mm/s² → k_gantry ≥ 50,000 N/m

PLA/PETG 滑架刚度通常只有 20,000-40,000 N/m，**不满足要求**。

### 2.2 GT2 6mm 皮带在 310mm 行程上的张力分布

**当前状态：** BOM 中仅列出"625ZZ 轴承 × 4"作为张紧器，无皮带相关描述（推测为单独购买）。

**分析：**

| 参数 | 现状 | 推荐值 | 差距 |
|---|---|---|---|
| 皮带宽度 | 6mm（推测）| 6mm（小幅面）或 **9mm**（TT310）| ⚠️ 建议 9mm |
| 皮带类型 | GT2（推测）| GT2 或 HTD 3M（高速）| ⚠️ HTD 更优 |
| 张紧力 | 未知 | 100-150 N（频率法 100-120 Hz）| ⚠️ 无法评估 |
| 中段惰轮 | 未列出 | **建议加装** | ❌ 缺失 |

**⚠️ 核心问题：**

1. **6mm vs 9mm 皮带**：TT310 的 X 轴行程达 310mm，相比 Voron Trident（同样 300mm 行程）标配 9mm 皮带，6mm 皮带在同等张力下刚度不足 67%。高速打印时皮带弹性振动更容易激发框架共振。

2. **缺少皮带张力检测手段**：BOM 中无频率式张力计或相关工具，皮带张力完全凭手感调整，容易出现过松（跳齿）或过紧（加速轴承磨损）的情况。

3. **无弹簧自动张紧器**：BOM 中仅列出"M3 螺丝 + 弹簧"作为张紧器，这是最基础的手动方案。打印初期皮带伸长后需要反复调节，而 3D 打印滑块方案的可靠性未知。

### 2.3 线性导轨选型（MGN12H vs 光轴）

**当前状态：** BOM 中无线性导轨条目，推测使用光轴或待购 MGN12。

**MGN12H vs 光轴对比：**

| 参数 | MGN12H（12mm 方型导轨）| 光轴（8mm/10mm 光杆）| 差异 |
|---|---|---|---|
| 径向刚度 | 高（预压可调）| 低（依赖间隙）| MGN12H 优 |
| 承载能力 | ~10-15 kg（单轴）| ~3-5 kg | MGN12H 优 |
| 摩擦系数 | 低（滚珠）| 中（滑动）| MGN12H 优 |
| 成本 | ¥30-50/轴 | ¥5-10/轴 | 光轴优 |
| 高速抖动 | 小 | 大（尤其 >300mm/s）| MGN12H 优 |
| 侧向刚性 | 高 | 低 | MGN12H 优 |

**⚠️ 核心问题：**

1. **光轴侧向刚度不足**：光轴在承受皮带张力产生的侧向分力时会发生可见弯曲。皮带张力约 100N，水平分力约 50N，10mm 光轴在 310mm 跨度下的挠度不可忽视。

2. **无导轨预紧**：MGN12H 可通过调节预压螺钉消除间隙，而光轴依赖滑块内部间隙，游隙通常 0.02-0.05mm，在高速换向时产生定位误差。

3. **MGN12 vs MGN7/MGN9**：TT310 属于中等幅面，推荐 MGN12H（12mm 宽），MGN7 太小，MGN15 成本高。

---

## 三、热管理系统分析

### 3.1 4010/4020 风扇风量是否足够（封箱体积估算）

**当前状态：** BOM 列出 4010 风扇 1-2 个（¥15-30），4020 风扇 1 个（¥20-40）。

**封箱体积估算：**

| 维度 | 数值 |
|---|---|
| 内腔体积（310×310×310mm）| **0.0297 m³ ≈ 30 升** |
| 内腔表面积（估算）| ~0.57 m² |

**风量需求计算：**

| 风扇规格 | 典型风量 (CFM) | 典型静压 (Pa) | 换气次数（30L 腔体）|
|---|---|---|---|
| 4010 | 5-8 CFM ≈ 8.5-13.5 m³/h | 20-40 | **17-27 次/小时 ≈ 3-4 次/分钟** |
| 4020 | 10-15 CFM ≈ 17-25 m³/h | 30-60 | **34-50 次/小时 ≈ 4-6 次/分钟** |
| 5015（推荐）| 10-15 CFM | 30-60 | 同 4020，更高静压 |

**⚠️ 核心问题：**

1. **4010 风扇风量偏低**：仅用 1 个 4010 风扇（5-8 CFM）对于 30 升封闭腔体来说勉强够用，但无法建立有效气流循环。热空气滞留在打印区域上方，造成腔体温差。

2. **缺少腔体循环风扇**：BOM 中仅 1 个 4010 用于进风或排风，没有专门的**腔内循环风扇**。封闭腔体内 Ra ≈ 1.2×10⁷（湍流自然对流），但自然对流无法精确控制温度均匀性，层间温度波动可能超过 5°C。

3. **仅 1 个 4020 排风不足**：如果 4020 是唯一排风扇，顶部排风面积需要足够大才能形成有效换气。设计不当会导致热空气在腔内滞留。

4. **风压不足**：3mm 亚克力板 + 保温棉的进气阻力约 20-40 Pa，4010 风扇静压 20-40 Pa 处于临界值，高阻力情况下风量大幅衰减。

### 3.2 PTC 加热器 100-200W 在封闭空间的加热速度

**当前状态：** BOM 列出 PTC 加热器 100-200W（¥50-100），温控器 1 个（¥30-50）。

**加热能力分析：**

封闭腔体（30 升）加热所需功率估算：

$$P_{needed} = m_{air} \cdot c_p \cdot \frac{dT}{dt} + P_{loss}$$

- 空气质量：m_air ≈ 0.036 kg（30L × 1.2 kg/m³）
- 空气比热：c_p ≈ 1005 J/(kg·K)
- 目标：室温 25°C → 腔温 40°C（ABS），ΔT = 15°C，时间 t = 10 分钟

$$P_{needed} ≈ \frac{0.036 × 1005 × 15}{600} + P_{loss} ≈ 0.9W + P_{loss}$$

**⚠️ 核心问题：**

1. **100-200W PTC 功率偏低**：热床才是封闭腔体的主要热源（400-600W），PTC 加热器的主要作用是**预热阶段**和**维持腔温**。100W PTC 在夏季高温环境（室温 30°C+）或打印大件后腔温下降时，补偿能力有限。

2. **缺少温度传感器闭环控制**：BOM 中温控器仅列出了"PTC 加热器温控"，但没有明确说明腔体温度传感器。PTC 加热器的温控精度直接影响 ABS 打印质量。

3. **PTC 加热器位置未规划**：加热器应放置在进风口附近（冷空气区）才能有效加热。BOM 中无安装位置说明，存在安装不当导致局部过热的风险。

4. **温控器独立性问题**：如果 PTC 温控和热床温控共用一个控制器，参数调节会相互干扰。建议独立温控回路。

### 3.3 保温棉 10-20mm 的保温效果

**当前状态：** BOM 列出保温棉/泡沫板 10-20mm 厚（¥20-40），用于 ABS 打印必需。

**保温效果分析（参考结构力学报告数据）：**

| 保温棉厚度 | q_cond (W/m²)（vs 无保温）| 节能比例 |
|---|---|---|
| 0 mm | 750 | 0% |
| 3 mm | 875 | -17%（压缩反而更差）|
| 6 mm | 438 | 42% |
| **10 mm** | **263** | **65%** |
| **20 mm** | **131** | **83%** |

**⚠️ 核心问题：**

1. **薄保温棉（<6mm）适得其反**：BOM 中"10-20mm"的下限 10mm 基本可用，但如果安装不当（压缩保温棉），实际热阻会大幅降低。推荐松散填充，避免压缩。

2. **保温棉覆盖完整性**：热床底部保温棉如果未做边缘密封（铝箔胶带），冷空气会从边缘缝隙进入，形成热桥，大幅降低保温效果。BOM 中无边缘密封材料。

3. **保温棉 vs 泡沫板**：BOM 标注"保温棉/泡沫板"，两者性能差异大：
   - 玻璃纤维棉：热导率 0.035 W/(m·K)，松散填充效果好
   - PE 泡沫板：热导率 0.035-0.040 W/(m·K)，抗压缩但可能脱落
   - 建议优先选用玻璃纤维棉 + 铝箔背衬

4. **封箱板内侧无额外保温**：BOM 中亚克力板 3-5mm 无内贴保温层。如果要达到最佳保温效果（减少 83% 热损失），需要在内面板贴 3-5mm PE 保温棉，BOM 中未列入。

---

## 四、Z 轴分析

### 4.1 单 Z vs 双 Z 的层纹差异

**当前状态：** BOM 中无 Z 轴相关物料（推测为标准配置），CoreXY 改进指南提到"单 Z 或 Trident 三 Z（改装中）"。

**单 Z vs 双 Z 对比：**

| 特性 | 单 Z 轴 | 双 Z 轴（同步）| 三 Z（Trident）|
|---|---|---|---|
| 层纹控制 | 差（丝杠周期性误差）| 好（误差减半）| 最优 |
| 丝杠成本 | ¥20-30 | ¥40-60 | ¥60-90 |
| 平台倾斜 | 无自动补偿 | 可调同步轮补偿 | 独立调平 |
| 改装复杂度 | 基准 | 中 | 高 |
| 打印质量影响 | 可见层纹（0.05mm）| 微层纹 | 几乎无层纹 |

**⚠️ 核心问题：**

1. **单 Z 丝杠累积误差**：TT310 的 Z 轴行程 310mm，典型 T8 丝杠（2mm 螺距）的全行程累积误差约 0.1-0.3mm（取决于丝杠质量），这直接体现为层纹。更关键的是，每次 Z 轴换向时的背隙（backlash）会导致平台瞬间倾斜。

2. **Z 轴共振频率低**：单根 2020 立柱 + 丝杠的固有频率约 60-90 Hz，而 CoreXY 高速运动时的激振频率 30-80 Hz 正好落在这个范围内，容易引发共振叠加到打印件上形成"Z 轴涟漪"。

3. **双 Z 改装缺失**：BOM 中完全没有 Z 轴增强相关物料。如果 TT310 仍为单 Z，在高速打印（>200mm/s）时层纹问题会明显。

### 4.2 当前 Z 轴丝杠规格

**推测规格（基于同类机型）：**

| 参数 | 典型值 | 问题 |
|---|---|---|
| 丝杠类型 | T8 螺母 + 8mm 丝杠 | 螺距误差大 |
| 螺距 | 2mm/8mm（双头）| 2mm 螺距层高分辨率好但慢 |
| 导程精度 | C7 级（±0.05mm/300mm）| 累积误差明显 |
| 支撑方式 | 悬臂（底部固定 + 上部自由）| 悬臂挠度 |

**⚠️ 核心问题：**

1. **悬臂安装方式**：大多数 DIY 3D 打印机 Z 轴采用悬臂结构（丝杠底部固定，顶部自由或仅导轨导向），310mm 悬臂长度下，丝杠自重引起的挠度约 0.05-0.1mm，等于数层打印高度。

2. **无丝杠预紧或消隙**：T8 丝杠的反向间隙通常 0.1-0.3mm，在打印首层时可能造成平台调平失效。

3. **缺少 Z 轴阻尼**：高速打印时 Z 轴急停产生的冲击若无阻尼，会引起平台弹跳。机械式止停 + 橡胶减振垫是常见方案，BOM 中无相关物料。

---

## 五、薄弱点优先级排序与改进方案

### P0 — 必须改进

---

#### P0-1：底部框架升级为 2040 型材

**问题描述：**
310×310mm 热床 + 玻璃 + 打印件总重 8-15kg，全部压在 2020 底部框架上。在打印头 Y 向高速运动（加速度 3000-5000 mm/s²）产生的惯性力 F=m×a ≈ 15-50N 反复作用下，底部框架弯曲挠度 0.42mm（悬臂模型），远超打印精度要求（0.1mm）。长期疲劳载荷还会导致框架角部微变形累积。

**改进方案：**
将底部框架的 4 根 2020 型材替换为 2040（强轴垂直放置，即 40mm 高度作为框架高度方向）。2040 的 Ix 是 2020 的 4.2 倍，弯曲挠度降低 90%，悬臂挠度从 0.42mm 降至 0.038mm。

**预期效果：**
- 底部框架弯曲刚度提升 11 倍
- 热床平台稳定性显著改善，底部打印件层纹减少
- 框架整体固有频率从 ~35Hz 提升至 ~50Hz，远离 CoreXY 激振频率

**预估成本：**
2040 型材（4×310mm = 1.24m），淘宝价约 ¥30-40；角码需换成 2040 规格（8 个），约 ¥60-80；M5 T 型螺母（新增 20 个），约 ¥5。**总计约 ¥95-125。**

---

#### P0-2：安装对角斜撑（Diagonal Bracing）

**问题描述：**
当前 BOM 仅有 16-20 个角码组成四面框架，无任何对角连接。框架在斜向力（打印头 X+Y 同时运动时产生的合力方向）作用下容易发生菱形变形。对角斜撑利用三角形稳定性，是性价比最高的整体刚性提升手段。

**改进方案：**
在底部框架的两条对角线上各安装 1 根 2020 撑杆（长度 ≈ √(310²+310²) ≈ 438mm），两端用法兰角码或专用接头连接。撑杆长度方向与受力方向对齐，将斜向力直接传递。

**预期效果：**
- 框架对角方向刚性提升 30-40%，消除菱形变形
- 整体框架刚性提升 20-30%（综合所有方向）
- 与 2040 底部框架配合，总刚性提升可达 60-80%

**预估成本：**
2020 撑杆（2×438mm），约 ¥30；法兰角码或对角接头（4 个），约 ¥20。**总计约 ¥50。**

---

#### P0-3：保温棉安装及边缘密封

**问题描述：**
BOSSAC 热床（24V，500-600W）在工作时会持续向框架传导热量。热床→框架的传热路径若不阻断，一方面造成热量浪费（能耗增加 30-50%），另一方面引起框架热膨胀不均匀（框架温差导致翘曲）。当前 BOM 列出保温棉但无安装工艺说明，极易因安装不当（压缩/留缝）而失效。

**改进方案：**
1. 热床下方铺设 6-10mm 松散玻璃纤维棉（不压缩，保留蓬松空隙）
2. 保温棉边缘用铝箔胶带完全密封，防止冷空气从缝隙进入
3. 保温棉与热床之间保留 1-2mm 间隙（热膨胀余量）
4. 可选：在框架内侧（亚克力板内壁）贴 3-5mm PE 保温棉，进一步减少腔壁散热

**预期效果：**
- 热床加热时间缩短 30-50%（对比无保温）
- 能耗降低 40-65%
- 热床表面温度均匀性提升（边缘与中心温差从 ±8°C 降至 ±3°C）
- 减少热床热量向框架传导，降低框架热变形风险

**预估成本：**
玻璃纤维棉（适量），约 ¥15-25；铝箔胶带（5m），约 ¥10。**总计约 ¥25-35。**

---

### P1 — 建议改进

---

#### P1-1：滑架升级为 CNC 铝合金或 FR4 材料

**问题描述：**
3D 打印 PLA/PETG 滑架刚度不足（k ≈ 20,000-40,000 N/m < 要求的 50,000 N/m），在 5000 mm/s² 加速度下会产生可见弹性变形，导致 Z 轴跳动和 XY 定位误差。封闭腔体高温（40-50°C）还会导致 PLA 软化（PLA Tg ≈ 55-60°C，接近工作温度上限）。

**改进方案：**
方案 A（推荐）：6061 铝合金 CNC 滑架，定制或参考 Voron Afterburner 设计的开源文件。优点：刚度最高，尺寸精确，热稳定性好。缺点：重量较大（~346g），成本较高。
方案 B（性价比）：FR4 PCB 材料滑架，委托 PCB 厂家制作（与电子部分一起打样），成本低，刚度适中（k ≈ 80,000 N/m）。

**预期效果：**
- 滑架刚度提升 2-4 倍
- 消除 PLA 滑架在封闭腔体中的软化变形风险
- 打印头定位精度提升，高速打印时 Z 轴跳动减少

**预估成本：**
CNC 铝合金滑架（定制），约 ¥80-150；或 FR4 PCB 滑架（PCB 打样），约 ¥30-50。**总计约 ¥30-150。**

---

#### P1-2：MGN12H 线性导轨替换光轴

**问题描述：**
光轴（8-10mm 光滑导杆）在 310mm 行程上承受皮带张力侧向分力（约 50N）时会发生弯曲挠度。皮带高速运动时的弹性振动通过滑块放大，在打印件上形成规律性振纹（周期与皮带振动频率相关）。光轴的径向刚度也比滚珠导轨低 3-5 倍。

**改进方案：**
将 X/Y 轴的光轴替换为 MGN12H 方型导轨（12mm 宽），配套滑块（H 规格为高精度预压型）。MGN12H 承重约 10-15kg，刚性好，预压可调消除间隙。

**预期效果：**
- 导轨径向刚度提升 3 倍以上
- 消除滑块间隙（可调预压）
- 高速运动时侧向振动减少，打印件表面更光滑

**预估成本：**
MGN12H 导轨（2×310mm），约 ¥40-60；MGN12H 滑块（4 个），约 ¥30-50；安装配件，约 ¥10。**总计约 ¥80-120。**

---

#### P1-3：皮带升级为 9mm GT2 或 HTD 3M

**问题描述：**
6mm 宽度 GT2 皮带在 310mm 长行程上的刚度不足，高速运动时皮带弹性振动明显。Gates 官方数据显示，6mm GT2 皮带在 150N 张力下的刚度比 9mm 版本低 50%，更容易产生跳齿和反向间隙。Voron Trident（300mm 级）已将 9mm 皮带作为标准配置。

**改进方案：**
将现有 6mm GT2 皮带替换为 9mm GT2（或 HTD 3M）皮带，对应更换皮带轮（9mm 槽宽规格）。同时加装中段惰轮（Mid-Span Idler）减少长皮带段的振动。

**预期效果：**
- 皮带刚度提升 50%，减少高速运动时的弹性伸长
- 降低皮带振动频率，减少"鬼影"缺陷
- HTD 3M 的弧形齿形比 GT2 梯形齿更适合高速（>300mm/s）传动

**预估成本：**
9mm GT2 皮带（2m），约 ¥30-50；9mm 皮带轮（4 个），约 ¥30-50；中段惰轮组件，约 ¥20-30。**总计约 ¥80-130。**

---

#### P1-4：腔体循环风扇（至少 2 只 4010）

**问题描述：**
当前 BOM 仅 1 只 4010 + 1 只 4020（共 2 只），无专门的腔内循环风扇。封闭腔体内部（Ra ≈ 1.2×10⁷）虽有自然湍流对流，但温度分层明显：热床附近 90-100°C，中部 50-60°C，顶部 35-45°C。层间温度不均匀直接影响 ABS 打印质量（翘曲、层间剥离）。

**改进方案：**
在腔体两侧（或前后壁）各安装 1 只 4010 风扇（5-8 CFM/只），形成水平气流循环。配合顶部 4020 排风扇（1 只），构成"侧进侧循环 + 顶排风"的气流路径。风扇由 PWM 温控驱动，根据腔温调节转速。

**预期效果：**
- 腔内温度均匀性提升 50-70%（目标：各点温差 < 5°C）
- 层间温度波动从 ±10°C 降至 ±3°C
- 减少 ABS 打印时的翘曲和层间裂纹

**预估成本：**
4010 风扇（2 只），约 ¥30-40；PWM 温控模块，约 ¥15-20；安装支架（3D 打印），约 ¥5。**总计约 ¥50-65。**

---

#### P1-5：底部框架加装底板加固

**问题描述：**
底部框架是整个打印机振动传递的枢纽。热床 Y 向运动产生的惯性力直接传递到框架底部，引起整机晃动。框架晃动一方面降低打印精度，另一方面向桌面传递振动，引发共振。

**改进方案：**
在底部框架内侧放置 3-5mm 铝板或碳纤维板（尺寸略小于框架内腔），用 M5 螺丝 + T 型螺母固定在 4 根底部型材的槽内。铝板参与框架整体刚性，提供额外弯曲刚度。

**预期效果：**
- 底部框架局部刚度提升 20-30%
- 减少框架"呼吸效应"（周期性微小形变）
- 铝板同时起到阻尼作用，吸收部分振动能量

**预估成本：**
铝板（3mm，310×310mm），约 ¥30-40；M5 螺丝螺母，约 ¥5。**总计约 ¥35-45。**

---

#### P1-6：步进电机减振安装

**问题描述：**
步进电机在高速启停时产生的振动（频率 30-80 Hz）直接传递到框架，这个频段正好与框架固有频率（25-50 Hz）重叠，引发共振。CoreXY 架构中两个电机通常安装在框架底部，是整机最大的振动源之一。

**改进方案：**
1. 电机安装面与框架之间加装硅胶减振垫（邵氏 A40，厚度 3-5mm）
2. 或使用 3D 打印 TPU 减振座（填充率 15-30%）
3. 电机螺丝加弹簧垫圈，防止长期振动松脱

**预期效果：**
- 振动传递率降低 50-70%
- 减少电机啸叫（高频噪音）
- 改善打印件表面质量（减少因振动引起的微观缺陷）

**预估成本：**
硅胶减振垫或 TPU 减振座（2 套），约 ¥15-25。**总计约 ¥15-25。**

---

#### P1-7：Z 轴升级 — 双 Z 轴同步驱动

**问题描述：**
单 Z 轴（TT310 推测配置）的丝杠累积误差（T8 C7 级 ±0.05mm/300mm）在 310mm 行程上可产生 0.1-0.3mm 误差，直接体现为可见层纹。Z 轴换向时的反向间隙还会造成平台倾斜，每次换向产生一个"台阶"。

**改进方案：**
在现有 Z 轴基础上增加第二根丝杠和电机（构成双 Z），两根丝杠通过同步带或齿轮连接，由同一电机驱动。两侧同步运动消除平台倾斜。或者直接参考 Trident 三 Z 设计（更复杂但效果最好）。

**预期效果：**
- Z 轴层纹减少 50%（误差由两根丝杠分担）
- 平台倾斜自动补偿（同步带保证两侧等速）
- 三 Z 设计可实现独立调平（每根丝杠单独控制）

**预估成本：**
第二根 T8 丝杠 + 螺母，约 ¥20-30；同步带轮组（2 套），约 ¥20-30；42 步进电机（1 个），约 ¥30-40；安装支架，约 ¥20。**总计约 ¥90-120。**

---

### P2 — 可选优化

---

#### P2-1：铝合金角码替换（16-20 个）

**问题描述：**
BOM 中 16-20 个角码（¥15-25）是低价标准件，通常为薄铝合金（1-2mm）或塑料材质，承力能力和耐久性存疑。Voron 原厂角码采用 6061-T5 铝合金 CNC 加工，内置加强筋，预紧扭矩可达 10 N·m。

**改进方案：**
将所有框架角码替换为 Voron 专用角码或同级 CNC 铝合金角码（6061-T5，厚度 ≥ 3mm）。16-20 个角码约 ¥200-500（进口）或 ¥100-250（国产替代）。

**预期效果：**
- 角部连接刚度提升 30-50%
- 消除低价角码断裂风险
- 预紧力更高，框架整体稳定性更好

**预估成本：**
Voron 同级角码（16-20 个），约 ¥200-500。**总计约 ¥200-500。**

---

#### P2-2：PTC 加热器功率升级至 200-300W

**问题描述：**
当前 BOM 中 PTC 加热器为 100-200W（未注明具体功率）。封闭腔体在打印大件后或冬季低温环境下，仅靠热床维持腔温 40-45°C 可能不足。PTC 功率偏低导致预热时间长（>15 分钟）或无法补偿散热损失。

**改进方案：**
将 PTC 加热器升级至 200-300W（24V），并独立配置温控器（NTC 探头检测腔体温度）。加热器安装在进风口附近，配合 PWM 调节实现精确控温。

**预期效果：**
- 预热时间缩短 30-50%
- 冬季或大件打印时腔温补偿能力增强
- 腔温波动 < ±3°C

**预估成本：**
200-300W PTC 加热器（24V），约 ¥60-100；温控器，约 ¥30-50。**总计约 ¥90-150。**

---

#### P2-3：封闭板内侧贴附保温棉

**问题描述：**
BOM 中 3-5mm 亚克力板（PMMA）作为封闭板材，热导率仅 0.19 W/(m·K)，本身隔热性能尚可，但与腔内高温空气的直接接触面积大，散热路径多。亚克力板内贴保温棉可进一步减少向环境的热传递。

**改进方案：**
在 4 块侧壁亚克力板内侧贴 3-5mm PE 保温棉或气凝胶毡，用少量硅胶粘接。顶部封闭板尤其需要保温（热气上升，顶部散热占比最大）。

**预期效果：**
- 腔体整体传热系数从 ~63 W/(m²·K) 降至 ~0.34 W/(m²·K)
- 热损失减少 83%（理论上）
- 腔温更稳定，打印质量更一致

**预估成本：**
PE 保温棉或气凝胶毡（0.5m²），约 ¥30-60。**总计约 ¥30-60。**

---

## 六、综合改进路线图与成本汇总

### 实施时间线

**第一阶段（机械基础加固，P0）：1-2 周**
1. P0-1：更换底部框架为 2040 型材（¥95-125）
2. P0-2：安装对角斜撑（¥50）
3. P0-3：保温棉安装 + 边缘密封（¥25-35）

**第二阶段（运动系统强化，P1）：1-2 周**
4. P1-1：升级 CNC/FR4 滑架（¥30-150）
5. P1-2：MGN12H 线性导轨（¥80-120）
6. P1-3：皮带升级 9mm（¥80-130）
7. P1-5：底板加固（¥35-45）

**第三阶段（热管理与振动，P1）：1 周**
8. P1-4：腔体循环风扇（¥50-65）
9. P1-6：步进电机减振（¥15-25）
10. P1-7：双 Z 轴（¥90-120）

**第四阶段（可选优化，P2）：按需**
11. P2-1：铝合金角码（¥200-500）
12. P2-2：PTC 升级（¥90-150）
13. P2-3：封闭板内贴保温（¥30-60）

---

### 成本汇总表

| 优先级 | 改进项目 | 预估成本区间 | 必要性 |
|---|---|---|---|
| **P0** | 底部框架 2040 升级 | ¥95-125 | 强制 |
| **P0** | 对角斜撑安装 | ¥50 | 强制 |
| **P0** | 保温棉 + 密封 | ¥25-35 | 强制 |
| P1 | CNC/FR4 滑架 | ¥30-150 | 强烈建议 |
| P1 | MGN12H 导轨 | ¥80-120 | 强烈建议 |
| P1 | 9mm 皮带升级 | ¥80-130 | 建议 |
| P1 | 腔体循环风扇 | ¥50-65 | 建议 |
| P1 | 底板加固 | ¥35-45 | 建议 |
| P1 | 步进电机减振 | ¥15-25 | 建议 |
| P1 | 双 Z 轴 | ¥90-120 | 建议 |
| P2 | 铝合金角码 | ¥200-500 | 可选 |
| P2 | PTC 200-300W | ¥90-150 | 可选 |
| P2 | 封闭板内贴保温 | ¥30-60 | 可选 |

**P0 总成本：¥170-210**
**P1 总成本（全部实施）：¥380-655**
**P2 总成本（全部实施）：¥320-710**

---

## 七、总结

TT310（310×310×310mm）在当前 BOM 配置下存在三个最关键的机械薄弱点：

1. **底部框架使用 2020 型材** — 在 8-15kg 热床载荷 + 高速运动惯性力作用下弯曲刚度不足，是层纹和振动的主要来源。升级 2040 + 对角斜撑是性价比最高的改进（¥145-175，60-80% 刚性提升）。

2. **运动系统配置不明** — 滑架材料、导轨类型、皮带规格在 BOM 中均无明确描述，存在 PLA 滑架 + 光轴 + 6mm 皮带的最差配置风险。建议确认并优先升级滑架和导轨（P1-1 + P1-2）。

3. **热管理系统配置偏低** — 1 个 4010 + 1 个 4020 风扇对于 30 升封闭腔体勉强够用，但缺少循环风扇会导致腔体温差大（可达 ±10°C），直接影响 ABS 打印质量。PTC 100W 功率偏低，预热和保温能力有限。

**优先行动建议：** 先实施 P0 三个改进项（¥170-210），再看预算情况依次推进 P1 项目。框架刚性和保温是高速高质量打印的基础设施，必须优先解决。

---

*文档生成日期：2026-03-29*
*参考来源：结构力学与热力学研究报告、框架刚性增强（04-05）、CoreXY深度研究报告、完整物料清单.csv*
