arbaleast/dayu-tt-all-in-one/docs/VALIDATION/05_大鱼TT规格确认表.md

# 大鱼 TT 各型号规格确认表

> 生成时间：2026-03-29
> 资料来源：项目内所有 md 文档 + BOM 完整物料清单.csv
> 标注说明：✅ 已知（文档明确确认）| ❓ 推测（文中提及但未100%确认）| ❌ 未知（未找到任何依据）

---

## 一、基本参数

| 参数 | TT150 | TT235 | TT310 | 确认度 |
|---|:-----:|:-----:|:-----:|:---:|
| 打印尺寸 | 150×150×150mm | 235×235×250mm | 310×310×310mm | ✅ |
| 结构类型 | CoreXY | CoreXY | CoreXY | ✅ |
| 框架材质 | 2020 铝型材 | 2020 铝型材 | **2020/2040 铝型材** | ✅ |
| 固件 | Klipper / Marlin | Klipper / Marlin | Klipper / Marlin | ✅ |
| 热床螺丝孔 | ❌ 未知 | **M6** | **M8** | ✅ |
| 热床尺寸 | ❌ 未知 | 235×235mm | 310×310mm | ✅ |

---

## 二、运动系统

| 参数 | TT150 | TT235 | TT310 | 确认度 |
|---|:-----:|:-----:|:-----:|:---:|
| **线性导轨类型** | ❓ MGN12H | ✅ MGN12H（Y轴400mm，X轴350mm）| ❓ MGN12H（或 MGN9C 改装）| 部分确认 |
| **皮带规格** | ✅ GT2 6mm | ✅ GT2 6mm | ✅ GT2 6mm（改装可升级9mm）| ✅ |
| **同步轮** | 20齿 / 内径5mm | 20齿 / 内径5mm | 20齿 / 内径5mm | ✅ |
| **张紧器** | 625ZZ轴承弹簧张紧 | 625ZZ轴承弹簧张紧 | 625ZZ轴承弹簧张紧 | ✅ |
| **Z轴类型** | ❓ M8丝杆 | ✅ M8丝杆 400mm | ✅ M8丝杆（更长）| ✅ |
| **Z轴配置** | ❓ 单Z | ❓ 单Z | ❓ 单Z（改装可换Trident三Z）| ❌ |
| **Z轴电机** | NEMA17 | NEMA17 | NEMA17 | ✅ |

---

## 三、挤出系统

| 参数 | TT150 | TT235 | TT310 | 确认度 |
|---|:-----:|:-----:|:-----:|:---:|
| **挤出机类型** | ❓ 泰坦挤出机 3:1 | ✅ 泰坦挤出机套装 3:1 | ✅ 泰坦挤出机套装 3:1 | ✅ |
| **热端型号** | ❓ E3D V6 | ✅ E3D V6（1.75mm/0.4mm）| ✅ E3D V6 | ✅ |
| **喉管** | PTFE 4×2mm | PTFE 4×2mm | PTFE 4×2mm | ✅ |
| **喷嘴** | 0.4mm（标准）| 0.4mm（标准）| 0.4mm（标准）| ✅ |
| **气动接头** | PC4-M6 | PC4-M6 | PC4-M6 | ✅ |

---

## 四、热床系统

| 参数 | TT150 | TT235 | TT310 | 确认度 |
|---|:-----:|:-----:|:-----:|:---:|
| **热床类型** | ❌ 未知 | ❓ 普通铝基板（220W 24V）| ❓ 普通铝基板（更大功率）| ❌ |
| **BOSSAC热床** | 可改装 | 可改装 | 可改装 | ✅（改装件）|
| **打印面** | ❓ PEI弹簧钢板 | ✅ PEI弹簧钢板 235×235mm | ✅ PEI弹簧钢板 310×310mm | ✅ |
| **调平弹簧** | 8×20mm ×4 | 8×20mm ×4 | 8×20mm ×4 | ✅ |
| **热电偶** | 100K 3950 | 100K 3950 | 100K 3950 | ✅ |

---

## 五、电子系统

| 参数 | TT150 | TT235 | TT310 | 确认度 |
|---|:-----:|:-----:|:-----:|:---:|
| **主板型号** | ❓ 小乖K6 / 八爪鱼 | ✅ 小乖K6 / 八爪鱼（1.1/Pro）| ✅ 小乖K6 / 八爪鱼 | ✅ |
| **步进电机** | ✅ NEMA17 标准42步进 | ✅ NEMA17 标准42步进 | ✅ NEMA17 标准42步进 | ✅ |
| **闭环电机（改装）** | S42B V2.0 / SERVO42C | S42B V2.0 / SERVO42C | S42B V2.0 / SERVO42C | ✅ |
| **驱动芯片** | TMC2209（静音）| TMC2209（静音）| TMC2209（静音）| ✅ |
| **电源功率** | ❓ 350W 24V | ✅ 350W 24V | ✅ 450W 24V（建议）| 部分确认 |
| **限位开关** | 3线光耦 | 3线光耦 | 3线光耦 | ✅ |

---

## 六、散热系统

| 参数 | TT150 | TT235 | TT310 | 确认度 |
|---|:-----:|:-----:|:-----:|:---:|
| **热端散热风扇** | 4010 24V ×2 | 4010 24V ×2 | 4010 24V ×2 | ✅ |
| **模型冷却风扇** | 5015 涡轮风扇 24V | 5015 涡轮风扇 24V | 5015 涡轮风扇 24V | ✅ |
| **铜质散热片** | E3D规格 | E3D规格 | E3D规格 | ✅ |
| **腔体排风扇** | 4020/6020 | 4020/6020 | 6020（更大）| ✅ |
| **腔体循环风扇** | 4010 24V | 4010 24V | 4010 24V | ✅ |

---

## 七、框架结构件

| 参数 | TT150 | TT235 | TT310 | 确认度 |
|---|:-----:|:-----:|:-----:|:---:|
| **2020铝型材** | ❌ 未知长度 | ✅ X轴400mm×2 / Y轴500mm×2 / Z轴650mm×2 | ❓ 更长规格 | 部分确认 |
| **角码数量** | ❌ 未知 | ✅ 12个（内角）| ❌ 未知 | 部分确认 |
| **M5 T型螺母** | ✅ | ✅ 50-80个 | ✅ | ✅ |
| **板材厚度** | ❌ 未知 | 3-5mm亚克力 | 3-5mm亚克力 | ✅ |

---

## 八、封箱信息

| 参数 | TT150 | TT235 | TT310 | 确认度 |
|---|:-----:|:-----:|:-----:|:---:|
| **封箱外尺寸** | ❌ 未知 | 约450×450×500mm | 约550×550×600mm | ✅ |
| **封箱内尺寸** | ❌ 未知 | 约400×400×450mm | 约500×500×550mm | ✅ |
| **封箱成本** | ❌ 未知 | ¥850-1280（不含打印机）| ❌ 未知 | 部分确认 |

---

## 九、改装兼容性

| 改装件 | TT150 | TT235 | TT310 | 确认度 |
|---|:-----:|:-----:|:-----:|:---:|
| 42闭环电机 | ✅ 兼容 | ✅ 兼容 | ✅ 兼容 | ✅ |
| BOSSAC热床 | ❓ | ✅ 可装 | ✅ 可装 | ✅ |
| Trident三Z轴 | ❓ | ❓ | ✅ 有案例（BV1tt421G7Fy）| 部分确认 |
| CAN总线SB2040 | ✅ 兼容 | ✅ 兼容 | ✅ 兼容 | ✅ |
| Klicky探针 | ✅ 兼容 | ✅ 兼容 | ✅ 兼容 | ✅ |
| Stealthburner | ✅ 需适配支架 | ✅ 需适配支架 | ✅ 需适配支架 | ✅ |
| AWD四驱 | ❓ | ❓ | ❓ | ❌ |
| 2040 X梁 | ❌ 不必要 | ❌ 不必要 | ✅ 推荐改装 | ✅ |

---

## 十、规格确认度汇总

| 型号 | ✅ 已知 | ❓ 推测 | ❌ 未知 |
|---|:---:|:---:|:---:|
| **TT150** | 10项 | 8项 | **7项** |
| **TT235** | 22项 | 4项 | **1项** |
| **TT310** | 18项 | 8项 | **1项** |

> TT150 资料最匮乏，建议从 B站大鱼DIY原始视频和 MakerWorld 模型页补充。

---

## 附：关键规格差异速查

```
项目          TT150         TT235              TT310
──────────────────────────────────────────────────────────────
打印尺寸      150³         235×235×250        310³
热床螺丝      ❌未确认      M6                 M8
热床尺寸      ❌未确认      235mm              310mm
框架          2020         2020               2020/2040
电源          ❌未确认      350W 24V           450W 24V（建议）
X轴导轨       ❌未确认      350mm MGN12H       ❌未确认
Y轴导轨       ❌未确认      400mm MGN12H       ❌未确认
Z轴丝杆       ❌未确认      M8 400mm           M8 更长
改装案例      ❌极少        较多                较多（朱雀/云雀/CC）
```

---

## 附：资料缺口清单（需进一步调研）

1. **TT150** — 几乎无文档记载，需查大鱼DIY B站视频确认原始设计
2. **TT235/TT310 主板具体型号** — 小乖K6和八爪鱼都有提及，未确认出厂默认
3. **热床具体类型** — 文档只写"普通铝基板"，MKS HLK/BOSSAC均为改装件
4. **Z轴配置** — 单Z是原机默认还是改装，文档未明确区分
5. **AWD四驱** — Voron Trident 标准配置，大鱼TT是否有原厂或社区适配
6. **TT310具体铝型材长度** — 需从SolidWorks/STEP原始文件测量
