arbaleast/dayu-tt-all-in-one/docs/VALIDATION/VALIDATION.md

# VALIDATION — 测试验证

## 索引

| 序号 | 文档 | 说明 |
|---|---|---|
| 01 | 量化指标总表 | SPEC.md 指标追踪 |

## 领域负责人
测试工程师
