arbaleast/dayu-tt-all-in-one/docs/VALIDATION/09_文档优化报告.md

# 大鱼 TT 项目文档优化报告

> 日期：2026-03-29
> 检查范围：`/vol1/1000/projects/3d-printing/dayu-tt-all-in-one/docs/`
> 执行：自动化文档审查

---

## 一、目录结构审查

### 1.1 现有结构

```
docs/
├── 00-入门指南/
│   ├── README.md              # 子目录入口
│   ├── 1-硬件升级方案.md
│   ├── 2-软件固件配置.md
│   ├── 3-配件清单与预算.md
│   ├── 4-安装指南索引.md
│   ├── 5-参考资料.md
│   └── 大鱼TT从零DIY完全指南.md
├── 01-封箱方案/
│   ├── README.md (无)
│   ├── 42闭环电机/             # 子子目录，未提供入口
│   │   ├── 42闭环步进电机改装指南.md
│   │   ├── S42B-V2.0详细资料.md
│   │   ├── 产品对比.md
│   │   └── 大鱼TT改装实战.md
│   ├── ABS打印指南.md
│   ├── 官方方案.md
│   ├── 开源文件资源.md
│   ├── 方案对比可视化.md
│   ├── 李炫键降噪方案.md
│   ├── 汪汪队射手方案.md
│   ├── 皮带张紧器设计.md
│   ├── 获取文件操作指南.md
│   └── 装配指南.md
├── 02-硬件改进/
│   ├── README.md (无)
│   ├── 42闭环电机改装实战采购指南.md  ← 内容与 01-封箱方案/42闭环电机/ 部分重叠
│   ├── AI校准进化实战指南.md
│   ├── CAN总线改装指南.md
│   ├── CoreXY改进大鱼TT实战指南.md
│   ├── Klipper固件配置完全指南.md
│   ├── 三叉戟Trident改装指南.md
│   ├── 切片机配置完全指南.md
│   ├── 多色打印改装完全指南.md
│   ├── 封箱散热BOSSAC热床改装指南.md
│   ├── 摄像头加装指南.md
│   ├── 罗技C270-大鱼TT摄像头完整配置.md
│   ├── 皮带张紧器STL模型合集.md
│   └── 硬件改进资料汇总.md
└── plans/
    ├── 2026-03-27-self-evolving-design.md
    └── 2026-03-29-ai-research-report.md
```

### 1.2 发现的问题

#### 问题 1：内容重复 — 42 闭环电机

| 位置 | 文件 |
|---|---|
| `docs/01-封箱方案/42闭环电机/` | 改装指南、S42B资料、产品对比、改装实战（4个文件） |
| `docs/02-硬件改进/42闭环电机改装实战采购指南.md` | 实战采购指南 |

**分析**：`01-封箱方案/42闭环电机/` 是改装方案子目录，`02-硬件改进/` 中的采购指南是独立文件，两者有内容重叠但定位不同。**建议保留，但需加导航**。

#### 问题 2：子目录无入口索引

- `01-封箱方案/42闭环电机/` 无 `README.md` 入口
- `01-封箱方案/` 无目录级 `README.md`
- `02-硬件改进/` 无目录级 `README.md`
- `plans/` 无目录级 `README.md`

#### 问题 3：目录编号风格不统一

`00-入门指南`、`01-封箱方案`、`02-硬件改进` 以数字排序合理，但 `plans` 没有对应编号。

#### 问题 4：文档数量分布不均

| 目录 | 文件数 |
|---|---|
| `00-入门指南/` | 7（含 README）|
| `01-封箱方案/` | 12（含子目录）|
| `02-硬件改进/` | 14 |
| `plans/` | 2 |

---

## 二、README.md 审查

### 2.1 发现的引用错误

#### ❌ 严重：损坏的链接

| 行 | 引用文本 | 目标文件 | 状态 |
|----|---|---|---|
| 43 | `[腔体温控与封箱散热指南](docs/02-硬件改进/腔体温控与封箱散热指南.md)` | `腔体温控与封箱散热指南.md` | **文件不存在** |
| 43 | 应指向 | `封箱散热BOSSAC热床改装指南.md` | ← 实际存在 |

**原因**：`封箱散热BOSSAC热床改装指南.md` 已存在并包含腔体温控内容，但 README 引用了旧文件名。

#### ⚠️ 次要：缺失的外部文件引用

| 行 | 引用 | 目标 | 状态 |
|----|---|---|---|
| 35 | `[BOM 物料清单](bom/完整物料清单.csv)` | `bom/完整物料清单.csv` | ✅ 存在 |
| 37 | `enclosure/freecad/` | `enclosure/freecad/` | ⚠️ 目录存在但只有一个 FreeCAD 文件 |
| - | `models/` | `models/` | ⚠️ 目录为空 |
| - | `stls/` | `stls/` | ⚠️ 目录为空 |

### 2.2 README.md 内容完整性

| 区域 | 状态 |
|---|---|
| 项目简介 | ✅ 有 |
| 表格结构 | ✅ 有 |
| 快速导航 | ✅ 有 |
| AI 进化系统 | ✅ 有（但 plan 文件引用可补充）|
| TT310 热力数据 | ✅ 有 |
| 基本规格表 | ✅ 有 |
| 目录状态说明 | ✅ 有 |

**改进建议**：
1. 修复第 43 行链接：`腔体温控与封箱散热指南.md` → `封箱散热BOSSAC热床改装指南.md`
2. 补充 `plans/` 目录的快速导航（目前仅有自我进化系统入口）
3. AI 进化系统的 Phase 0-5 表格中增加文档直接跳转链接

---

## 三、文档交叉引用审查

### 3.1 损坏的交叉引用汇总

| 来源文件 | 损坏引用 | 问题类型 |
|---|---|---|
| `docs/00-入门指南/README.md` | `[3-配件清单与预算.md](./3-配件清单与预算.md)` | 相对路径无法从根目录解析 |
| `docs/00-入门指南/README.md` | `[5-参考资料.md](./5-参考资料.md)` | 相对路径无法从根目录解析 |
| `docs/00-入门指南/README.md` | `[Klipper固件](./2-软件固件配置.md)` | 同上 |
| `docs/00-入门指南/README.md` | `[更多细节优化](./1-硬件升级方案.md)` | 同上 |
| `README.md` | `腔体温控与封箱散热指南.md` | 文件不存在 |
| `docs/01-封箱方案/开源文件资源.md` | `[开源文件资源.md](开源文件资源.md)` | 相对路径自引用 |
| `docs/plans/2026-03-27-self-evolving-design.md` | 无直接 md 引用 | ✅ 无问题 |

### 3.2 引用格式不一致

| 文件 | 引用格式 |
|---|---|
| `docs/00-入门指南/大鱼TT从零DIY完全指南.md` | `docs/02-硬件改进/...`（根路径） |
| `docs/02-硬件改进/硬件改进资料汇总.md` | `docs/01-封箱方案/`（根路径） |
| `docs/00-入门指南/README.md` | `./1-硬件升级方案.md`（相对路径） |

**建议**：统一使用**项目根路径格式** `docs/.../xxx.md`，便于从任意位置访问。

---

## 四、优化建议

### 4.1 高优先级（立即修复）

#### ① 修复 README.md 第 43 行损坏链接

```
# 错误（当前）
[腔体温控与封箱散热指南](docs/02-硬件改进/腔体温控与封箱散热指南.md)

# 正确（应改为）
[封箱散热与BOSSAC热床改装指南](docs/02-硬件改进/封箱散热BOSSAC热床改装指南.md)
```

#### ② 统一引用格式

所有文档内引用统一改为项目根路径格式：

```markdown
<!-- 统一风格 -->
[某文档](../02-硬件改进/某文档.md)   ← 仅限子目录内跳转
[某文档](docs/02-硬件改进/某文档.md) ← 统一使用根路径
```

#### ③ 为 `01-封箱方案/42闭环电机/` 添加入口 README

```markdown
# 42 闭环步进电机改装方案

本目录包含大鱼 TT 42 闭环电机改装的完整资料。

## 目录

| 文件 | 内容 |
|------|------|
| [42闭环步进电机改装指南](./42闭环步进电机改装指南.md) | 完整改装流程 |
| [S42B-V2.0详细资料](./S42B-V2.0详细资料.md) | 电机规格参数 |
| [产品对比](./产品对比.md) | 品牌/型号对比 |
| [大鱼TT改装实战](./大鱼TT改装实战.md) | 真实改装记录 |

> 采购指南另见：[42闭环电机改装实战采购指南](../02-硬件改进/42闭环电机改装实战采购指南.md)
```

### 4.2 中优先级（建议改进）

#### ④ 创建 `docs/01-封箱方案/README.md`（目录入口）

```markdown
# 01-封箱方案

> 大鱼 TT 各种封箱方案的完整资料

## 方案对比

| 方案 | 来源 | 特点 |
|------|------|------|
| [李炫键降噪方案](./李炫键降噪方案.md) | B站李炫键 | 降噪优化 |
| [汪汪队射手方案](./汪汪队射手方案.md) | B站汪汪队射手 | 结构完整 |
| [官方方案](./官方方案.md) | 大鱼DIY官方 | 基础参考 |

## 改装组件

| 组件 | 文档 |
|------|------|
| 42闭环电机 | [42闭环电机改装指南](./42闭环电机/) |
| 皮带张紧器 | [皮带张紧器设计](./皮带张紧器设计.md) |
| ABS打印 | [ABS打印指南](./ABS打印指南.md) |

## 装配

- [装配指南](./装配指南.md)
- [开源文件获取](./获取文件操作指南.md)
- [开源文件资源汇总](./开源文件资源.md)
```

#### ⑤ 创建 `docs/02-硬件改进/README.md`（目录入口）

```markdown
# 02-硬件改进

> 大鱼 TT 硬件改装与固件配置的完整资料

## 改装指南

| 类别 | 文档 |
|------|------|
| 电机 | [42闭环电机改装实战采购指南](./42闭环电机改装实战采购指南.md) |
| 总线 | [CAN总线改装指南](./CAN总线改装指南.md) |
| 结构 | [CoreXY改进大鱼TT实战指南](./CoreXY改进大鱼TT实战指南.md) |
| 热端 | [三叉戟Trident改装指南](./三叉戟Trident改装指南.md) |
| 多色 | [多色打印改装完全指南](./多色打印改装完全指南.md) |
| 散热 | [封箱散热BOSSAC热床改装指南](./封箱散热BOSSAC热床改装指南.md) |

## 固件与软件

| 类别 | 文档 |
|------|------|
| Klipper | [Klipper固件配置完全指南](./Klipper固件配置完全指南.md) |
| 切片 | [切片机配置完全指南](./切片机配置完全指南.md) |
| 校准 | [AI校准进化实战指南](./AI校准进化实战指南.md) |

## 监控与配件

| 类别 | 文档 |
|------|------|
| 摄像头 | [摄像头加装指南](./摄像头加装指南.md) / [罗技C270配置](./罗技C270-大鱼TT摄像头完整配置.md) |
| 张紧器 | [皮带张紧器STL模型合集](./皮带张紧器STL模型合集.md) |

## 资料汇总

- [硬件改进资料汇总](./硬件改进资料汇总.md)
```

#### ⑥ 创建 `docs/plans/README.md`（目录入口）

```markdown
# plans — 项目计划与设计文档

## 文档列表

| 文档 | 日期 | 内容 |
|------|------|------|
| [自我进化系统完整设计](./2026-03-27-self-evolving-design.md) | 2026-03-27 | AI自我进化 Phase 0-5 混合架构 |
| [AI调研报告](./2026-03-29-ai-research-report.md) | 2026-03-29 | AI在3D打印领域的应用调研 |

## 相关文档

- [AI校准进化实战指南](../02-硬件改进/AI校准进化实战指南.md) — 实际落地实施
```

### 4.3 低优先级（长期改进）

#### ⑦ 消除内容重复

`01-封箱方案/42闭环电机/` 和 `02-硬件改进/42闭环电机改装实战采购指南.md` 内容有重叠。建议：
- `01-封箱方案/42闭环电机/` 保留技术改装文档（what & how）
- `02-硬件改进/42闭环电机改装实战采购指南.md` 保留采购指南（buy & cost）
- 两者互相引用，消除读者困惑

#### ⑧ `docs/00-入门指南/README.md` 引用格式修正

当前使用相对路径 `./xxx.md`，建议改为根路径格式：

```markdown
# 错误（当前）
[硬件升级方案](./1-硬件升级方案.md)

# 正确（建议）
[硬件升级方案](1-硬件升级方案.md)  ← 同目录下可省略 ./
# 或
[硬件升级方案](./1-硬件升级方案.md)  ← 在 docs/00-入门指南/ 内浏览时正确
```

> 注：子目录内相对路径在子目录内浏览时有效，但从根目录点击链接时会失效。统一加目录名前缀是更稳健的做法。

#### ⑨ 补充缺失内容标记

在 `docs/00-入门指南/` 中：
- `1-硬件升级方案.md`、`2-软件固件配置.md` 等文件存在，但建议在 `README.md` 快速开始部分中明确说明这些文件的当前状态（草稿/完整）

---

## 五、优化行动清单

| 优先级 | 操作 | 影响文件 |
|---|---|---|
| 🔴 高 | 修复 README.md 第43行损坏链接 | `README.md` |
| 🔴 高 | 统一所有 md 引用为根路径格式 | 所有 md 文件 |
| 🟡 中 | 创建 `01-封箱方案/README.md` | `docs/01-封箱方案/README.md`（新建）|
| 🟡 中 | 创建 `02-硬件改进/README.md` | `docs/02-硬件改进/README.md`（新建）|
| 🟡 中 | 创建 `plans/README.md` | `docs/plans/README.md`（新建）|
| 🟡 中 | 创建 `01-封箱方案/42闭环电机/README.md` | `docs/01-封箱方案/42闭环电机/README.md`（新建）|
| 🟢 低 | 消除 42闭环电机内容重复 | `42闭环电机/` + `42闭环电机改装实战采购指南.md` |
| 🟢 低 | 修正 `00-入门指南/README.md` 相对路径引用 | `docs/00-入门指南/README.md` |
| 🟢 低 | plans/ 目录加文档导航表格 | `docs/plans/README.md` |

---

## 六、总结

| 维度 | 发现 |
|---|---|
| 目录结构 | 基本合理，缺少子目录入口索引 |
| 损坏链接 | 1个严重（`腔体温控与封箱散热指南.md`）|
| 损坏引用 | 4处相对路径引用（`./` 格式）|
| 内容重复 | 1处（42闭环电机散落在两个目录）|
| 导航优化 | 缺少 4 个子目录入口 README |

**预计修复时间：1-2 小时（主要是创建 4 个入口 README + 修复链接）**
