arbaleast/dayu-tt-all-in-one/CHANGELOG.enclosure.md

# 项目更新记录

> 备注：本文件是封箱子项目的历史记录，主要内容已整合到 `dayu-tt-all-in-one` 主项目。
> 主项目 README：`/README.md`

## 2026-03-22 项目初始化

### 创建内容
- [x] 项目主 README
- [x] 汪汪队射手方案文档
- [x] 官方方案文档
- [x] 李炫键降噪方案文档
- [x] 皮带张紧器设计文档
- [x] 装配指南
- [x] ABS 打印指南
- [x] 完整物料清单（CSV）

### 项目结构（当时）
```
dayu-tt-enclosure/  ← 已废弃，请参考 dayu-tt-all-in-one
├── docs/01-封箱方案/
│   ├── 官方方案.md
│   ├── 汪汪队射手方案.md
│   ├── 李炫键降噪方案.md
│   ├── 皮带张紧器设计.md
│   ├── 装配指南.md
│   └── ABS打印指南.md
├── stls/           # 待补充
├── models/         # 待补充
├── bom/
│   └── 完整物料清单.csv
└── images/         # 待补充
```

---

## 后续整合记录

### 2026-03-27 整合到主项目
- 主项目地址：`https://github.com/arbaleast/dayu-tt-all-in-one`
- 封箱文档已移至 `docs/01-封箱方案/`
- 封箱 BOM 已移至 `bom/完整物料清单.csv`
- 新增：Trident 三叉戟改装指南
- 新增：42 闭环电机改装指南
- 新增：CAN 总线改装指南

### 2026-03-28 自我进化 + CoreXY 改装
- 新增：AI 校准进化实战指南（v2.0 混合方案）
- 新增：CoreXY 改进大鱼 TT 实战指南（参考 Voron Design）
- 新增：完整自我进化系统设计文档 `docs/plans/2026-03-27-self-evolving-design.md`

---

*项目持续更新中，欢迎补充资料*
