arbaleast/dayu-tt-all-in-one/source/B站【大鱼DIY】3D打印机Dayu TT V1.21全套资料/TT235资料/B站【大鱼DIY】3D打印机 Dayu TT235 V1.02装机教程.pdf

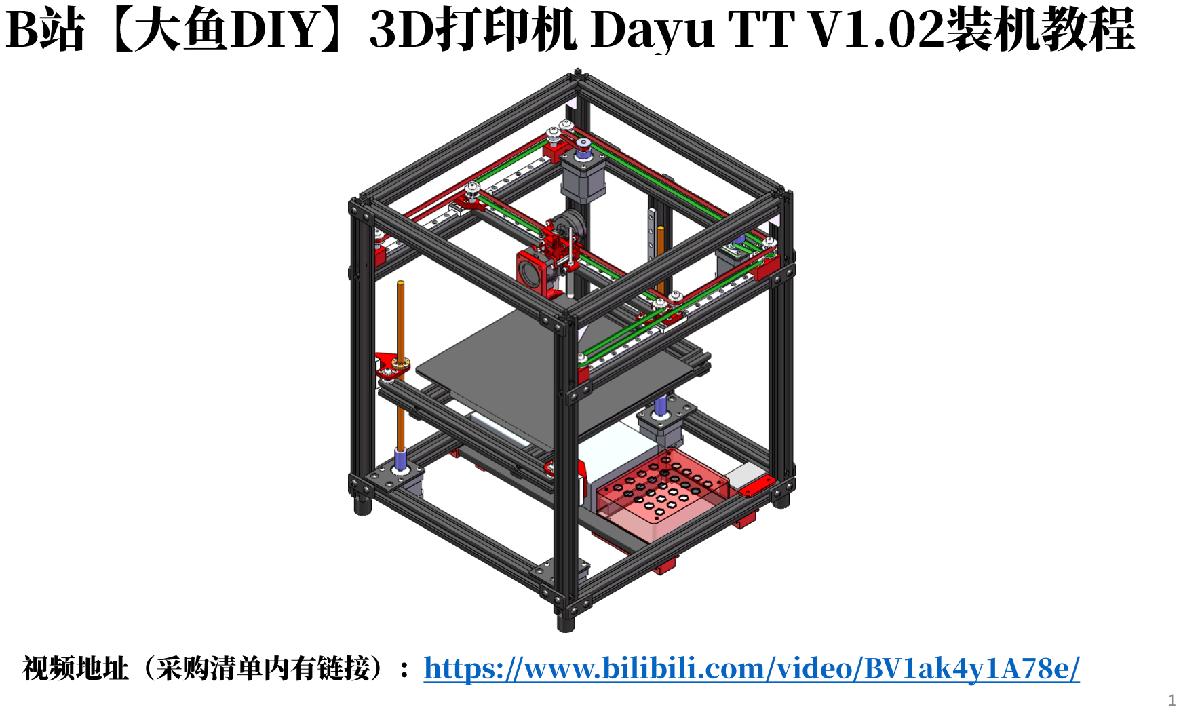
[picture p117: page 1]
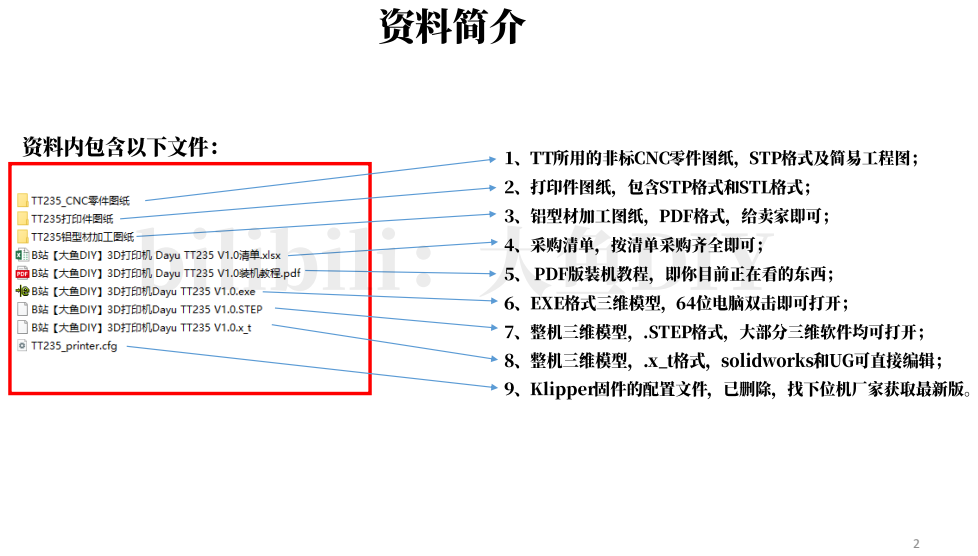
[picture p118: page 2]

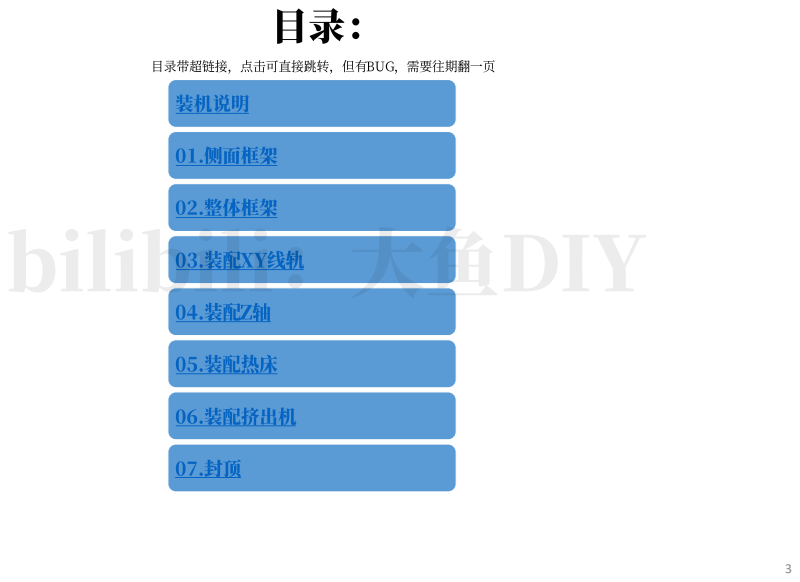
[picture p119: page 3]

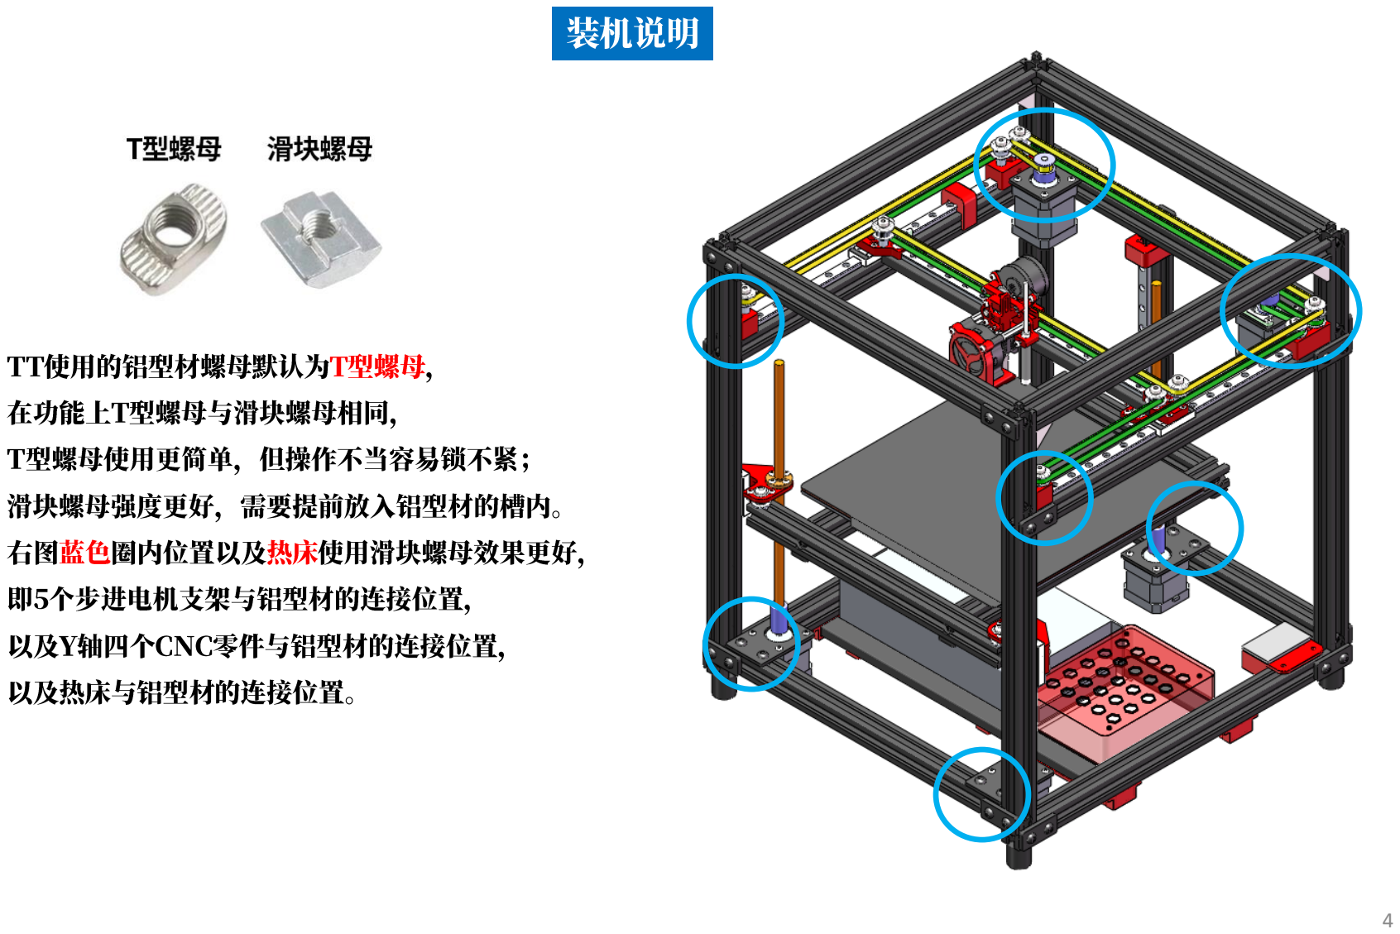
[picture p120: page 4]
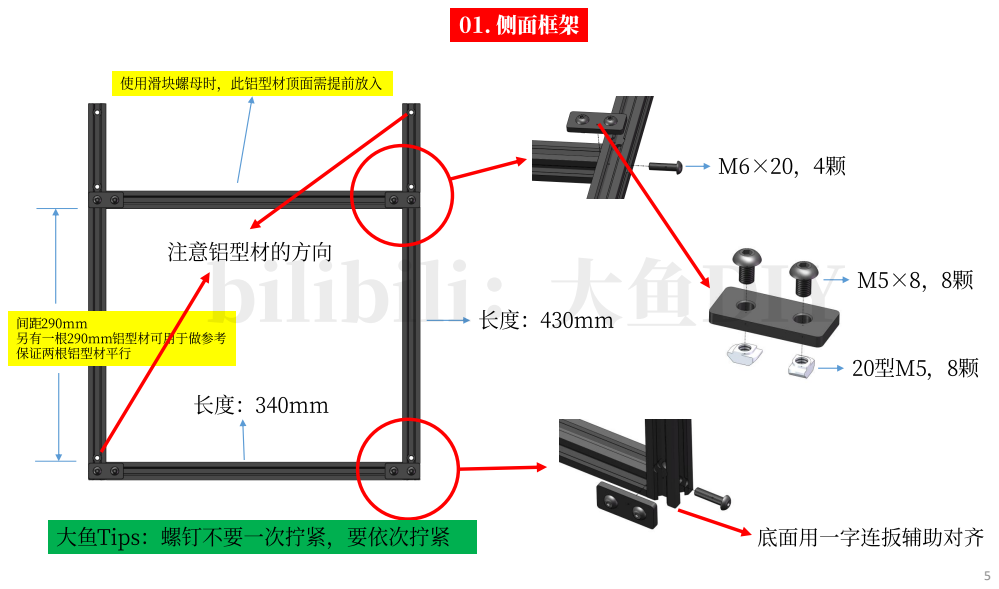
[picture p121: page 5]

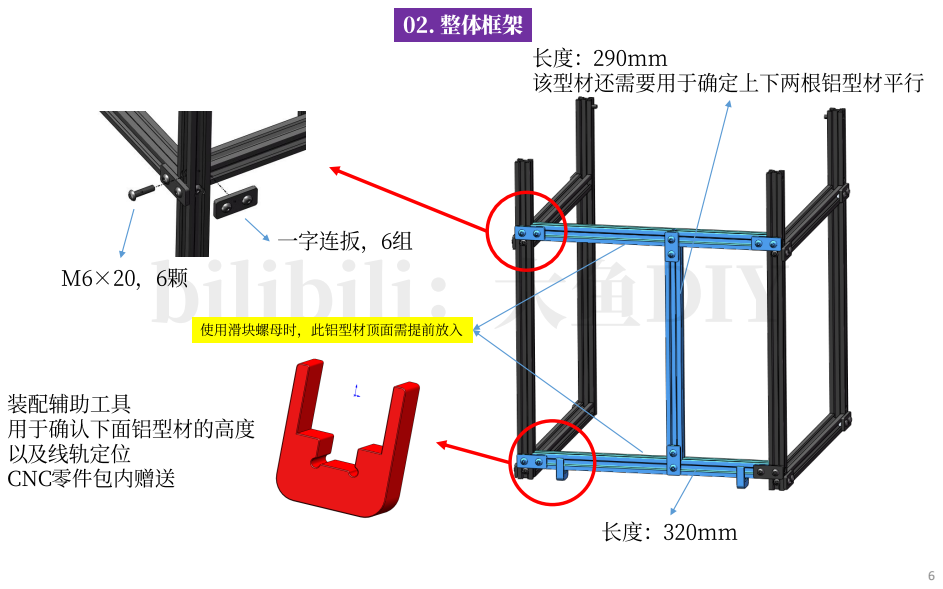
[picture p122: page 6]

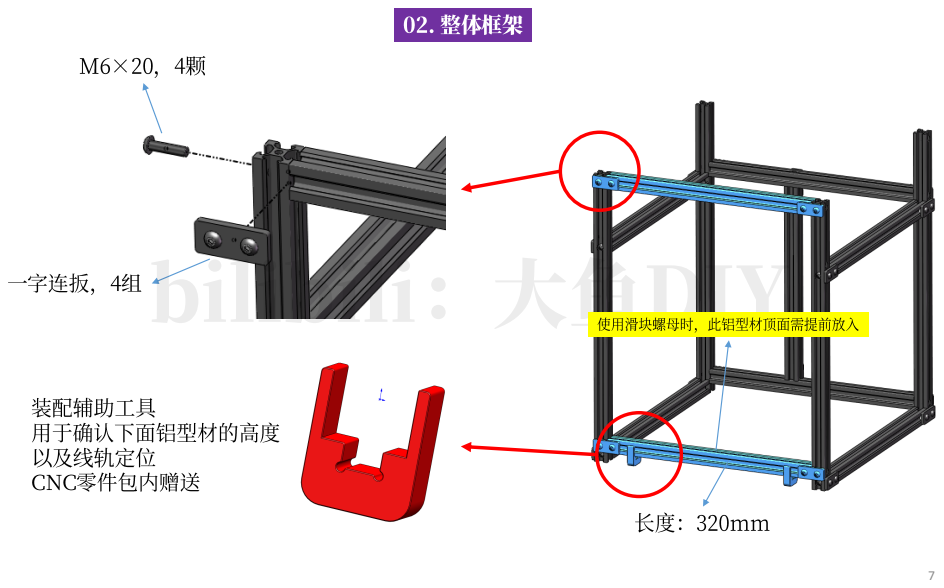
[picture p123: page 7]

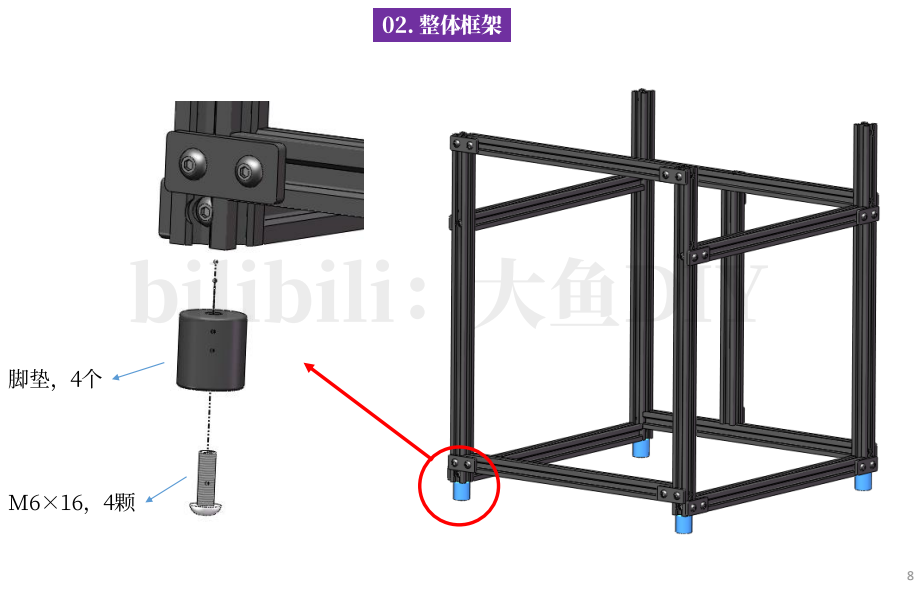
[picture p124: page 8]

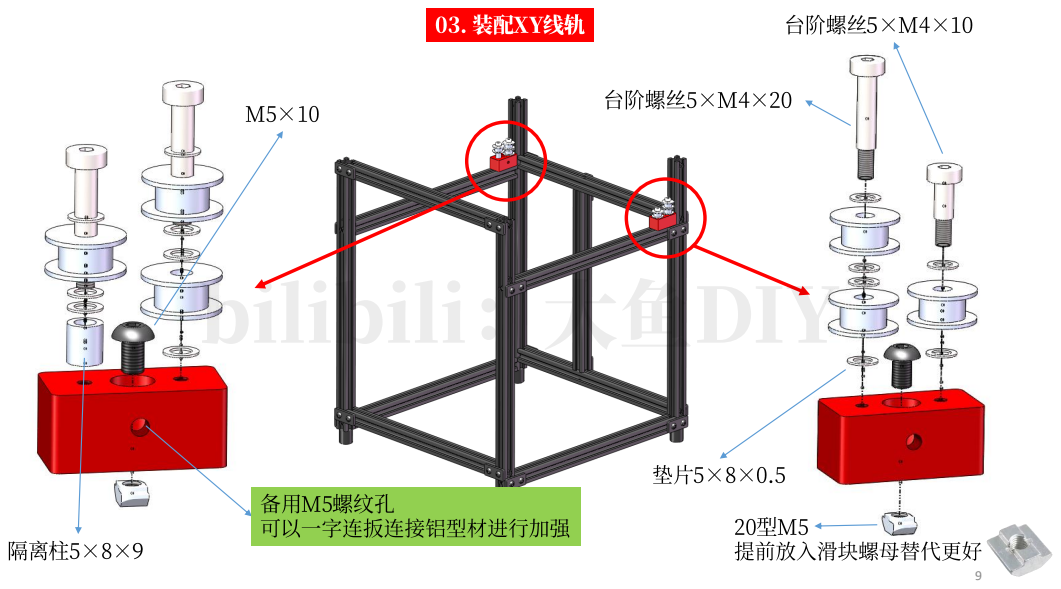
[picture p125: page 9]

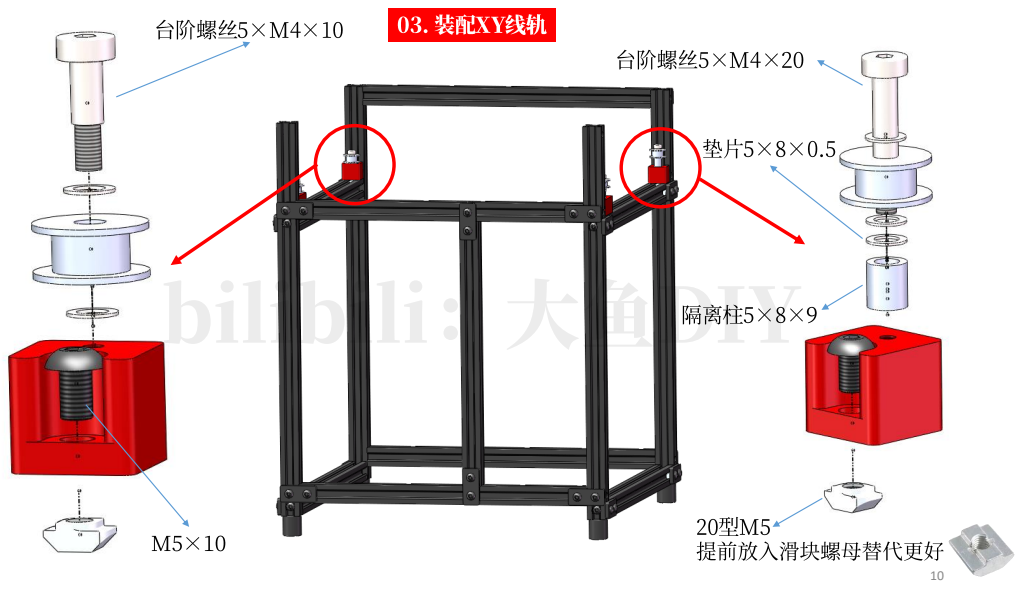
[picture p126: page 10]

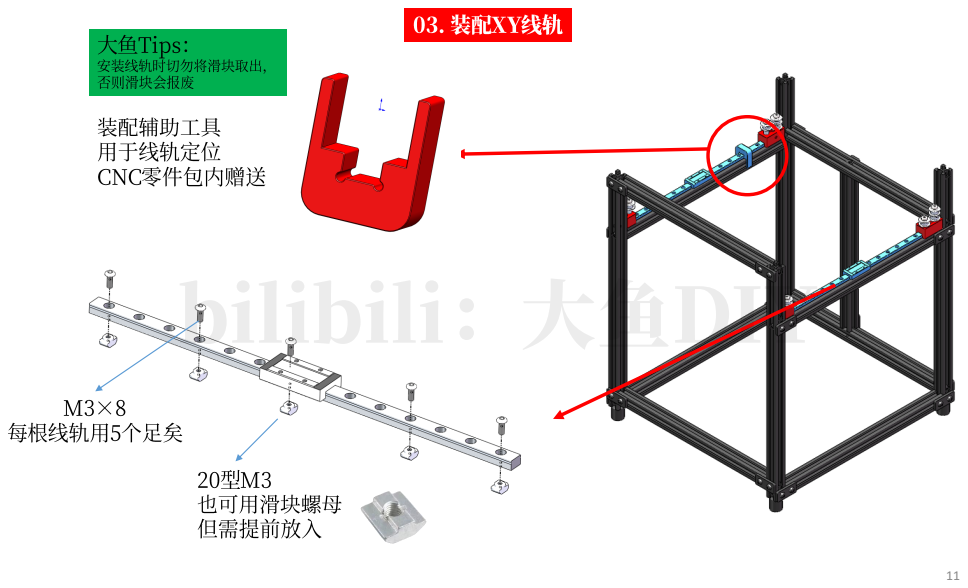
[picture p127: page 11]

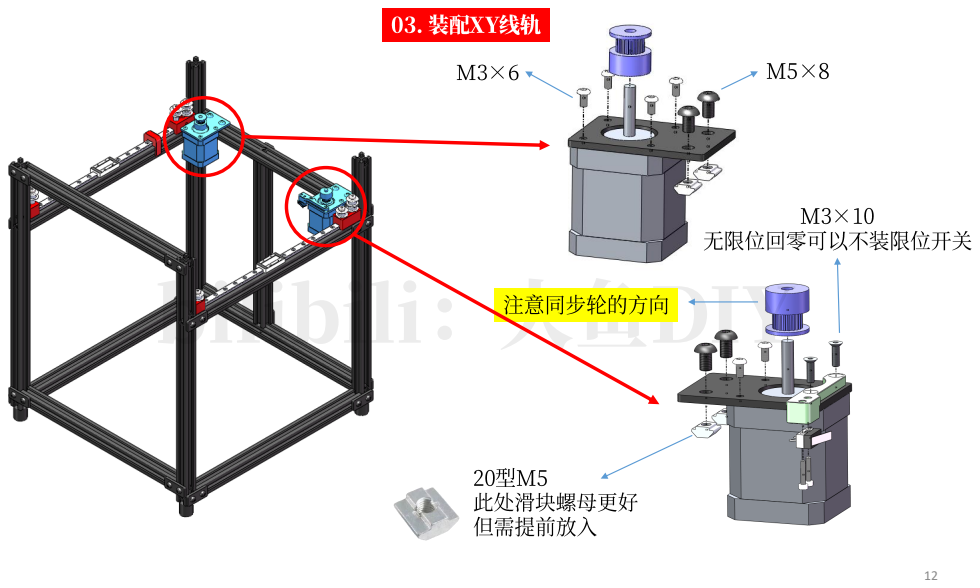
[picture p128: page 12]

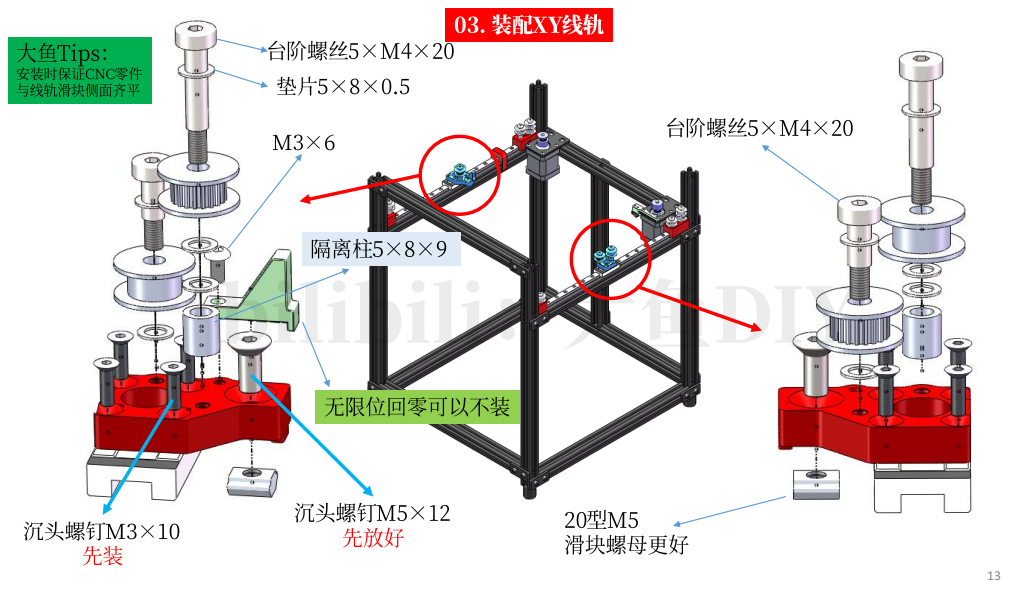
[picture p129: page 13]

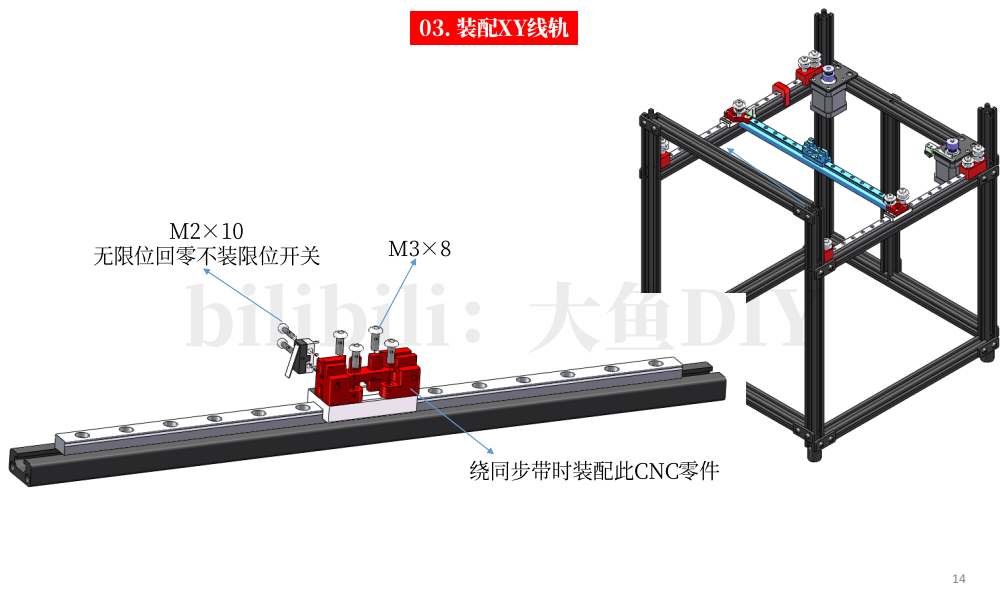
[picture p130: page 14]

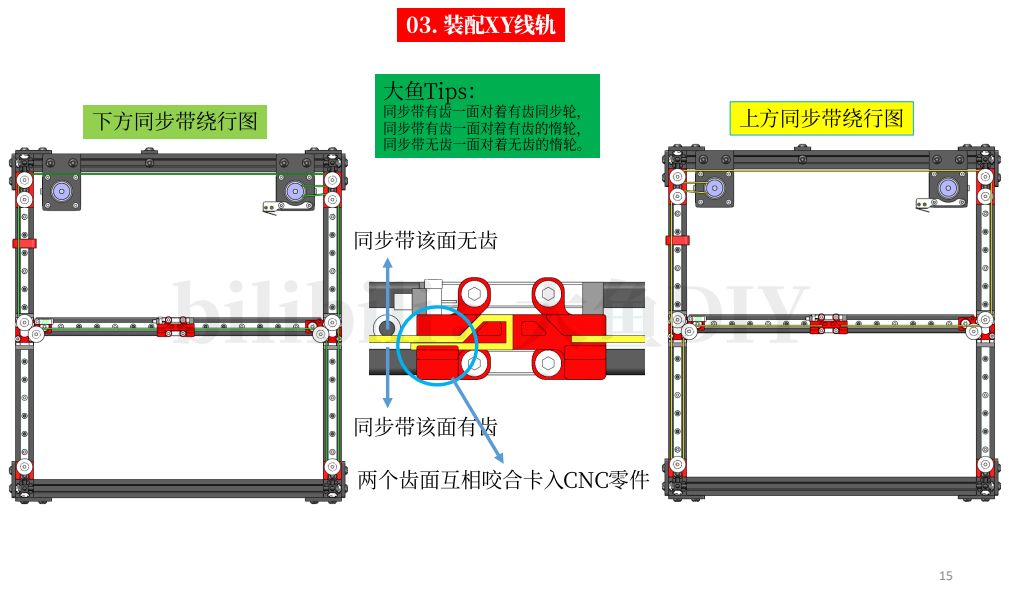
[picture p131: page 15]

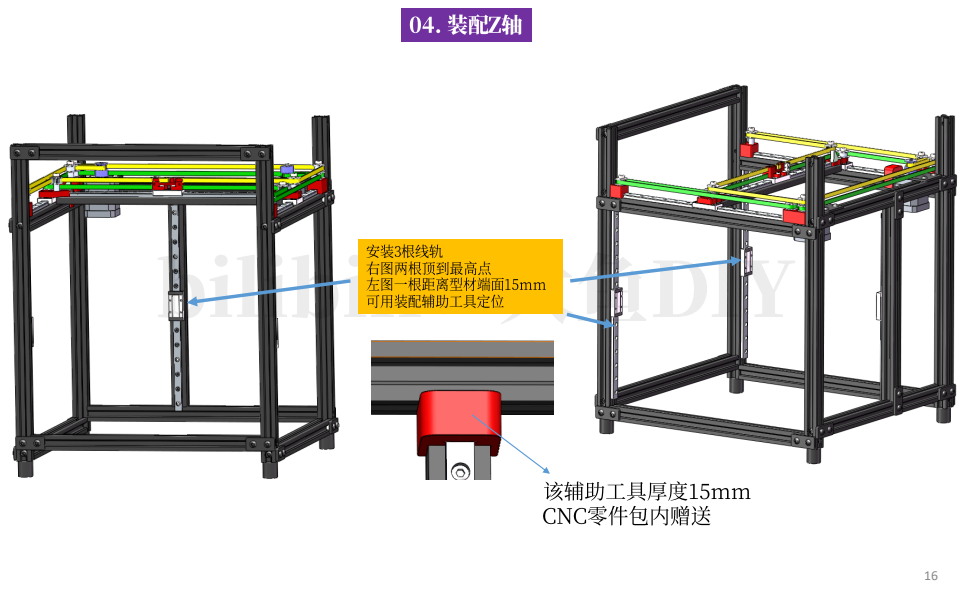
[picture p132: page 16]

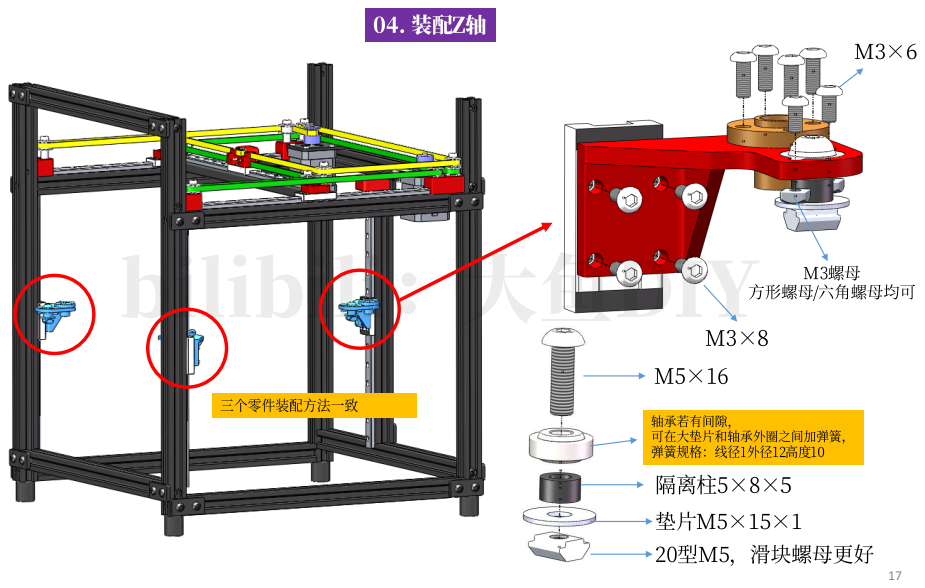
[picture p133: page 17]

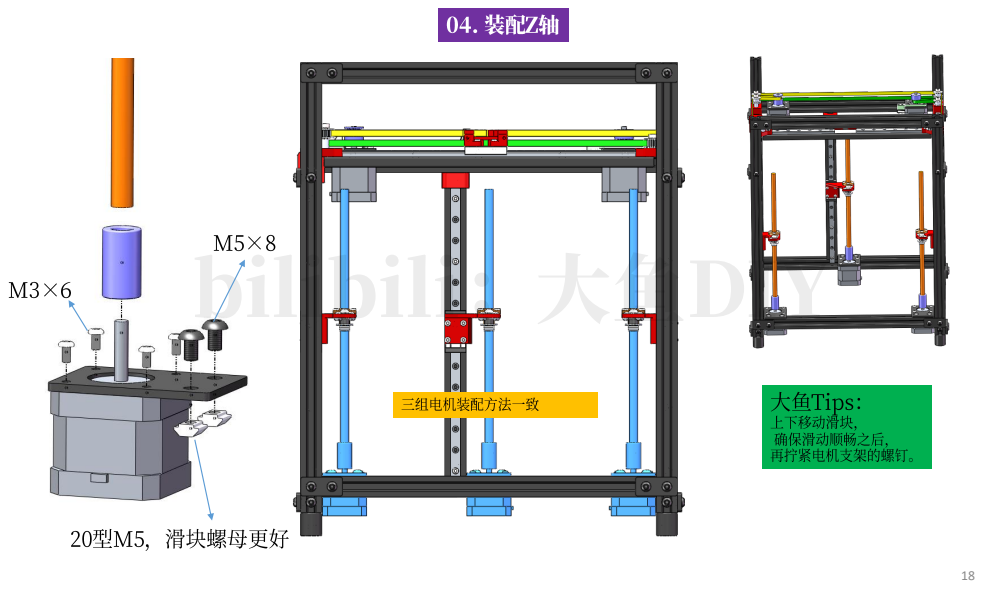
[picture p134: page 18]

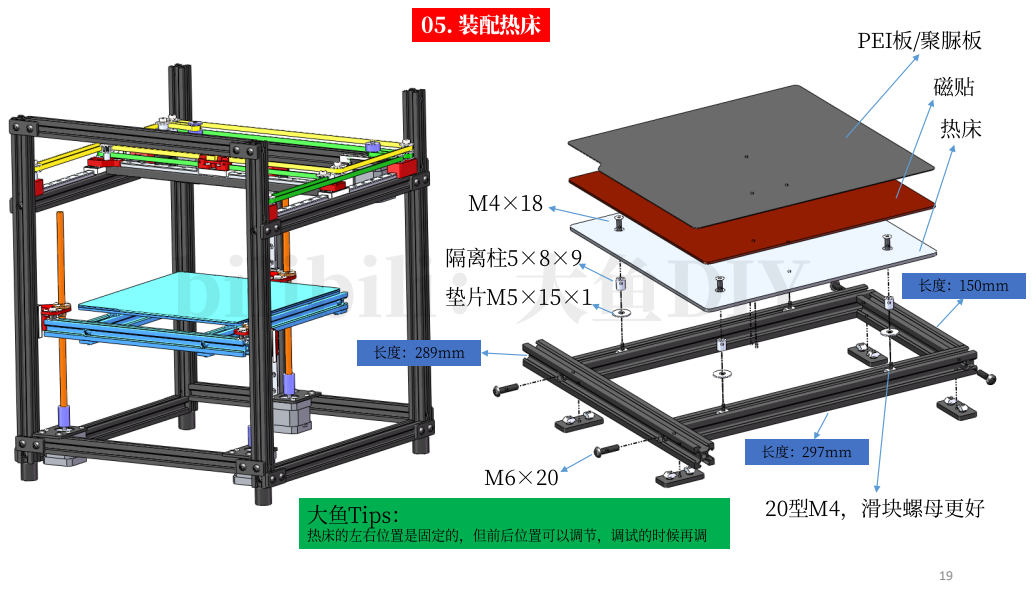
[picture p135: page 19]

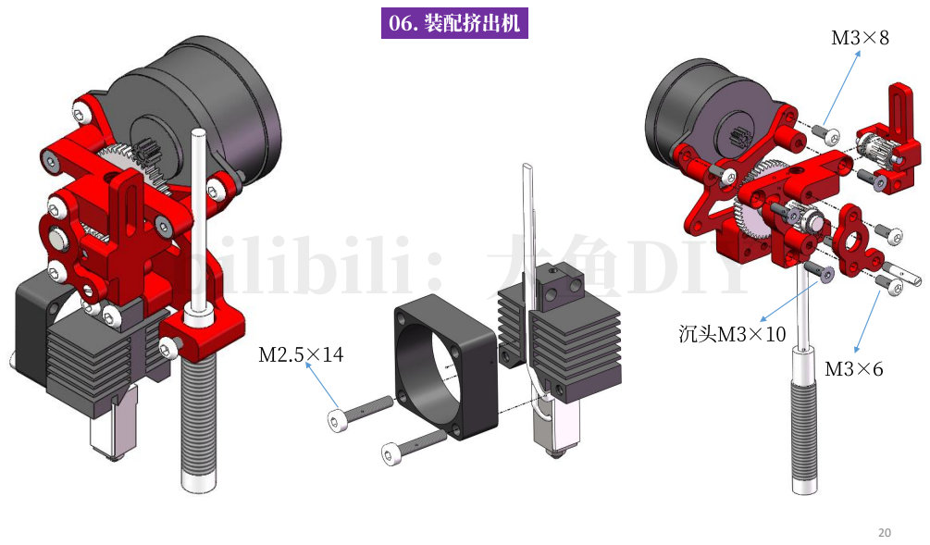
[picture p136: page 20]

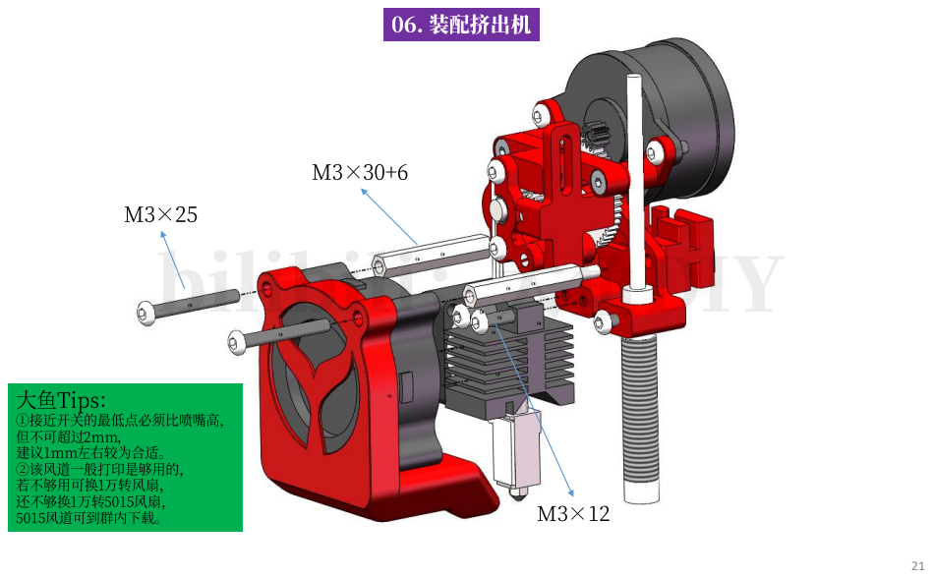
[picture p137: page 21]

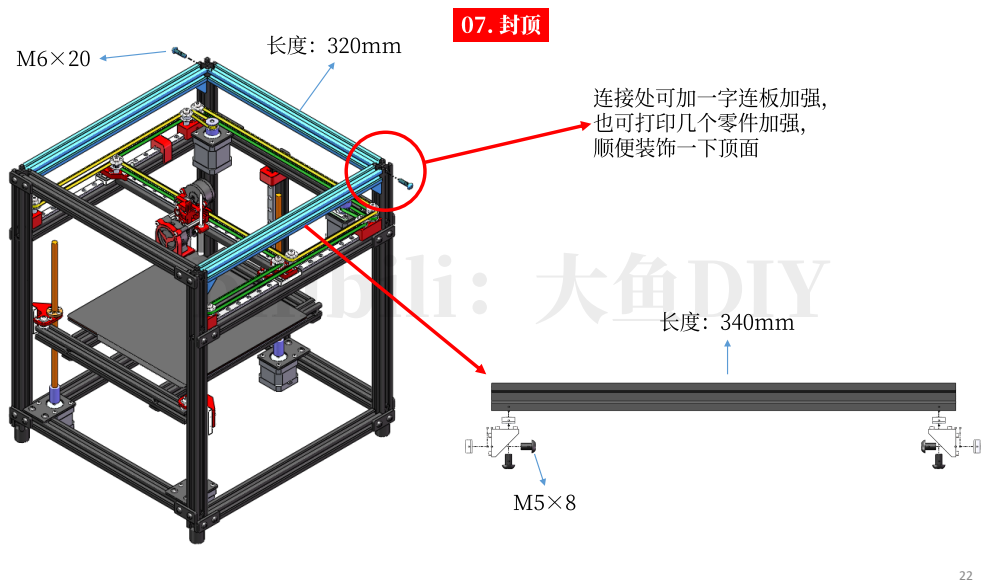
[picture p138: page 22]

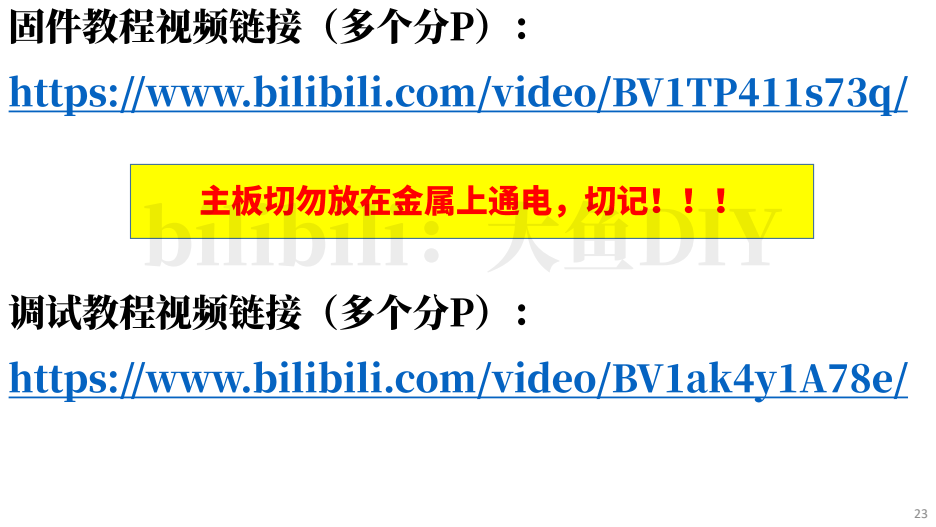
[picture p139: page 23]
