arbaleast/dayu-tt-all-in-one/source/B站【大鱼DIY】3D打印机Dayu TT V1.21全套资料/TT310资料/B站【大鱼DIY】3D打印机 Dayu TT310 V1.02装机教程.pdf

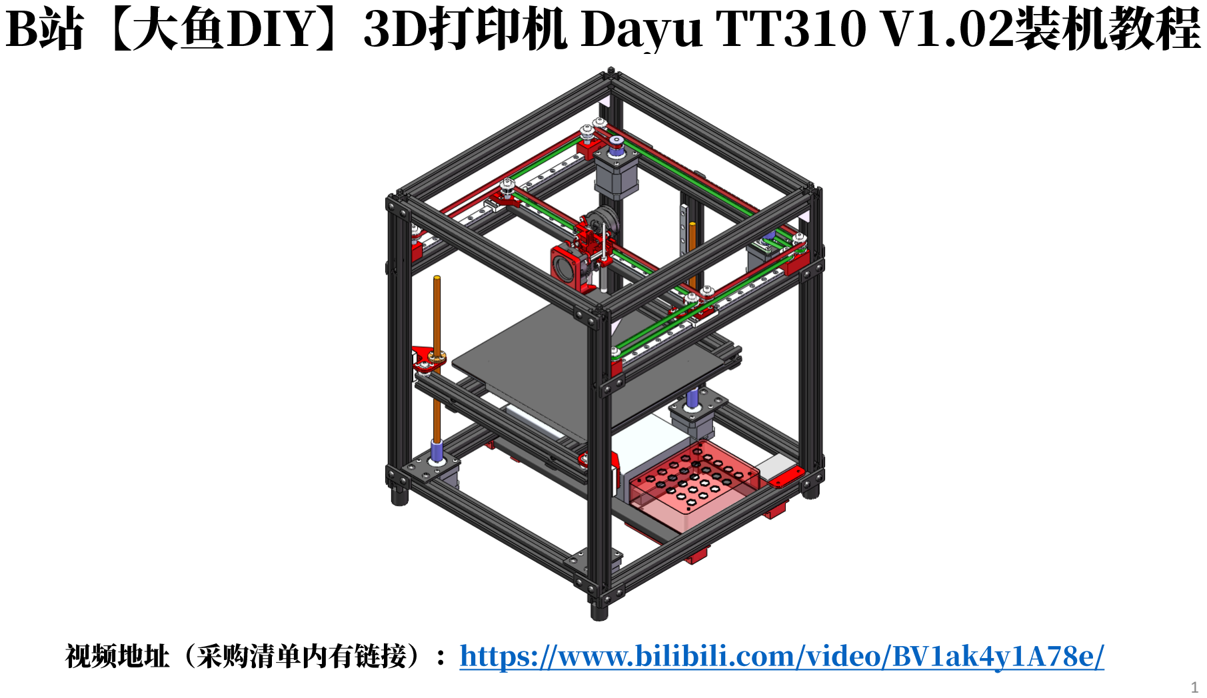
[picture p140: page 1]
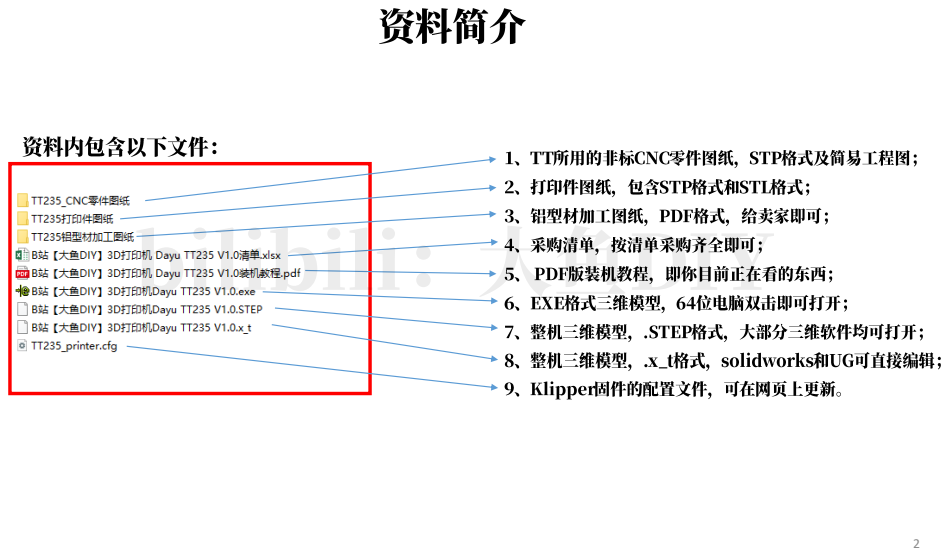
[picture p141: page 2]


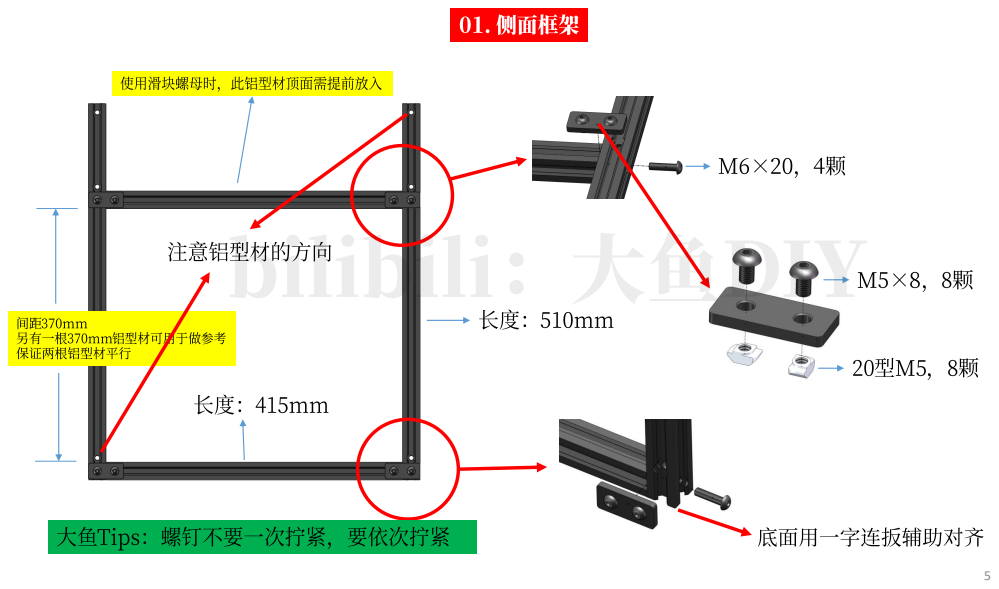
[picture p142: page 5]

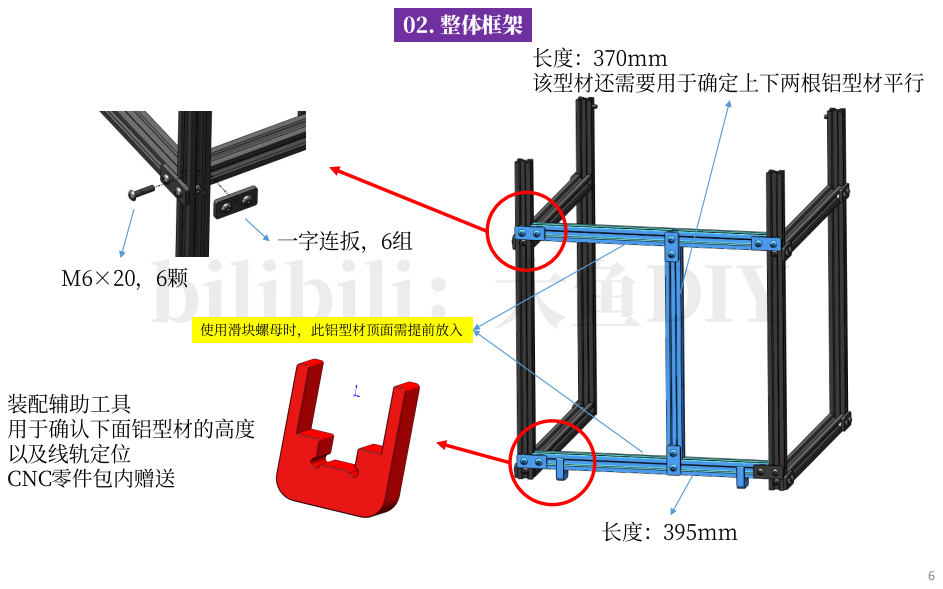
[picture p143: page 6]

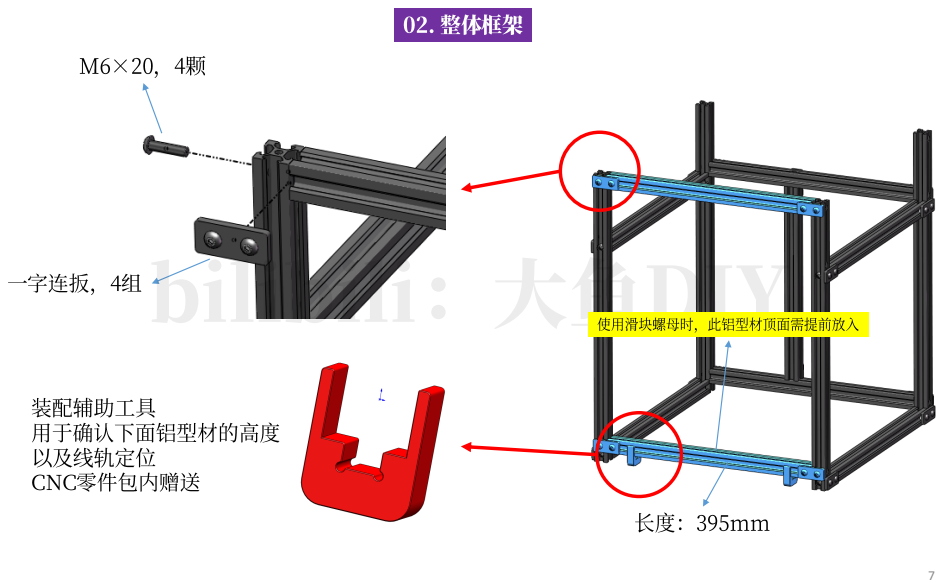
[picture p144: page 7]












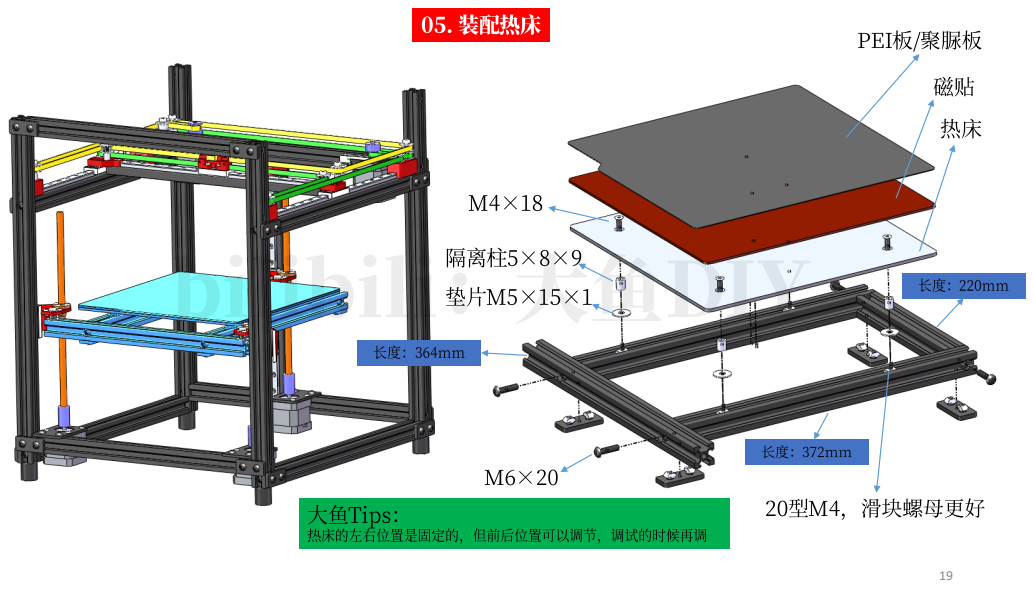
[picture p145: page 19]



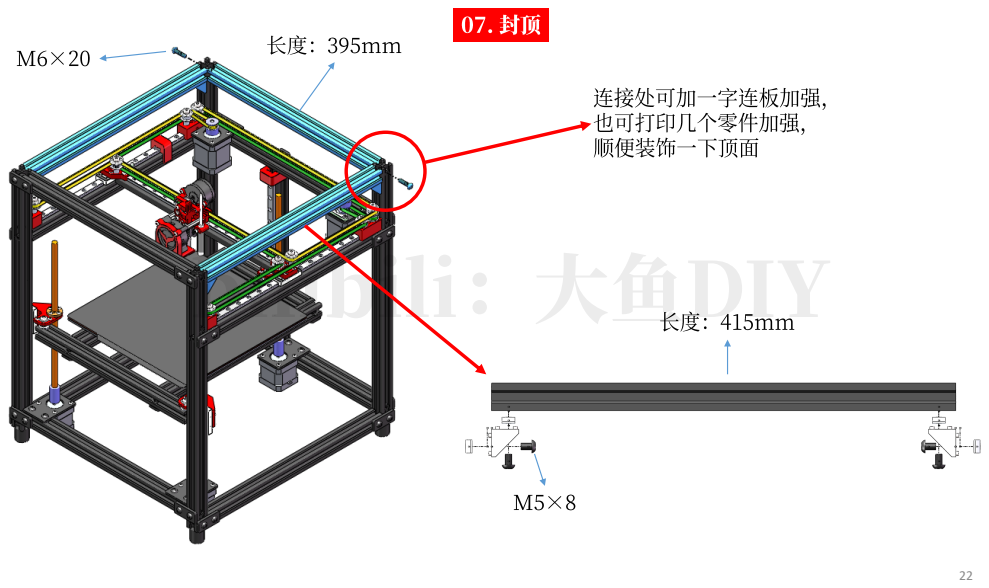
[picture p146: page 22]

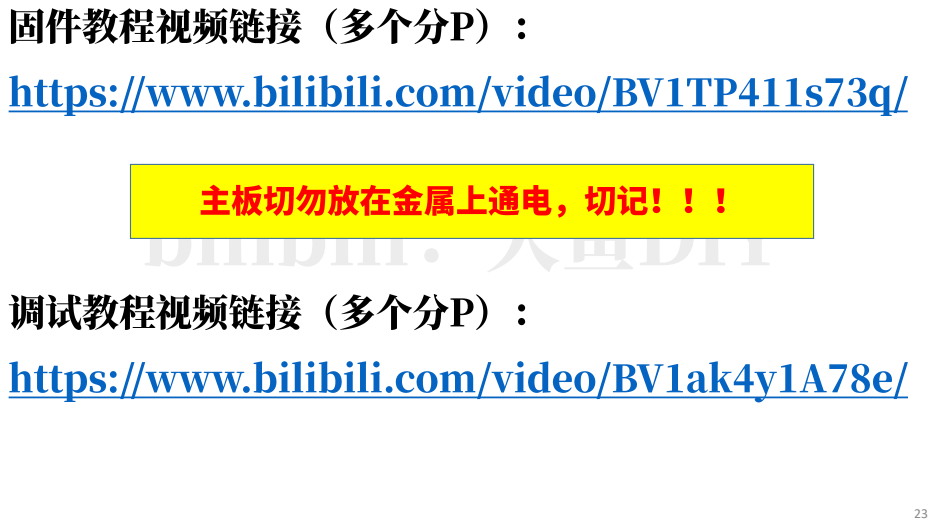
[picture p147: page 23]
