arbaleast/dayu-tt-all-in-one/source/B站【大鱼DIY】3D打印机Dayu TT V1.21全套资料/TT150资料/TT150铝型材加工图纸/TT150欧标铝型材加工图纸.PDF

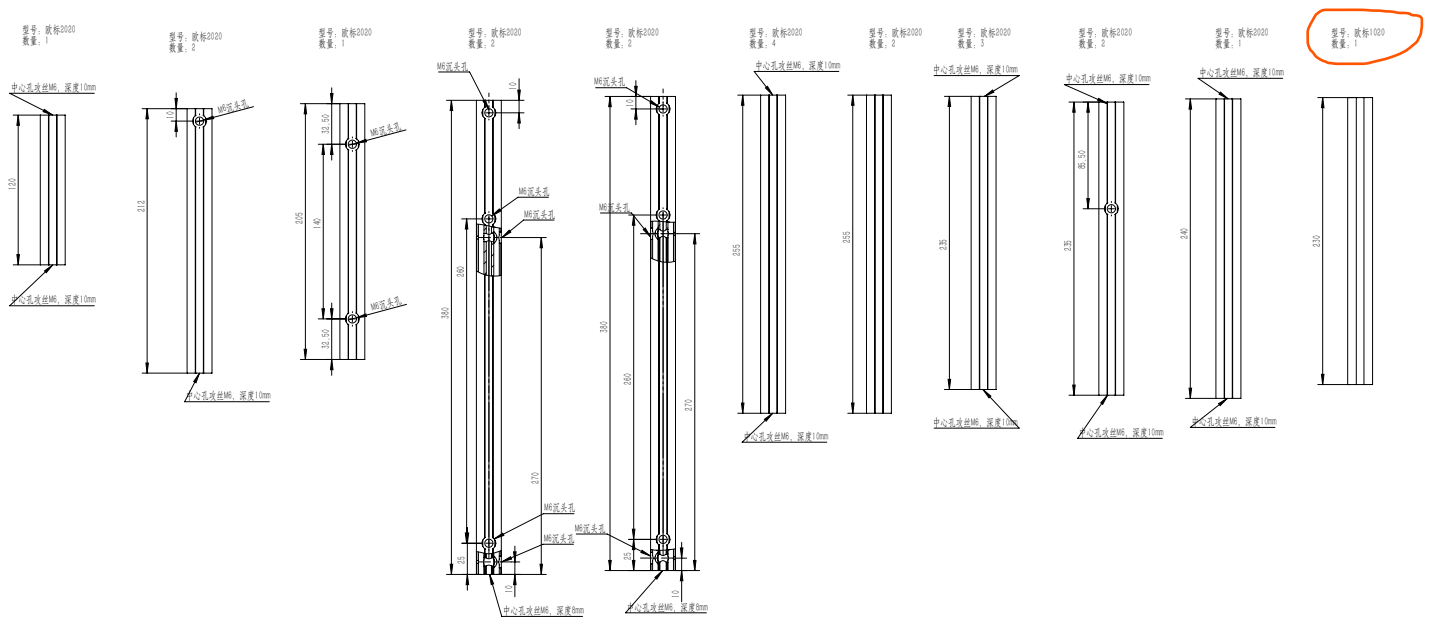
[picture p148: page 1]
