arbaleast/dayu-tt-all-in-one/source/B站【大鱼DIY】3D打印机Dayu TT V1.21全套资料/TT235资料/TT235铝型材加工图纸/TT235欧标铝型材加工图纸20230812.PDF

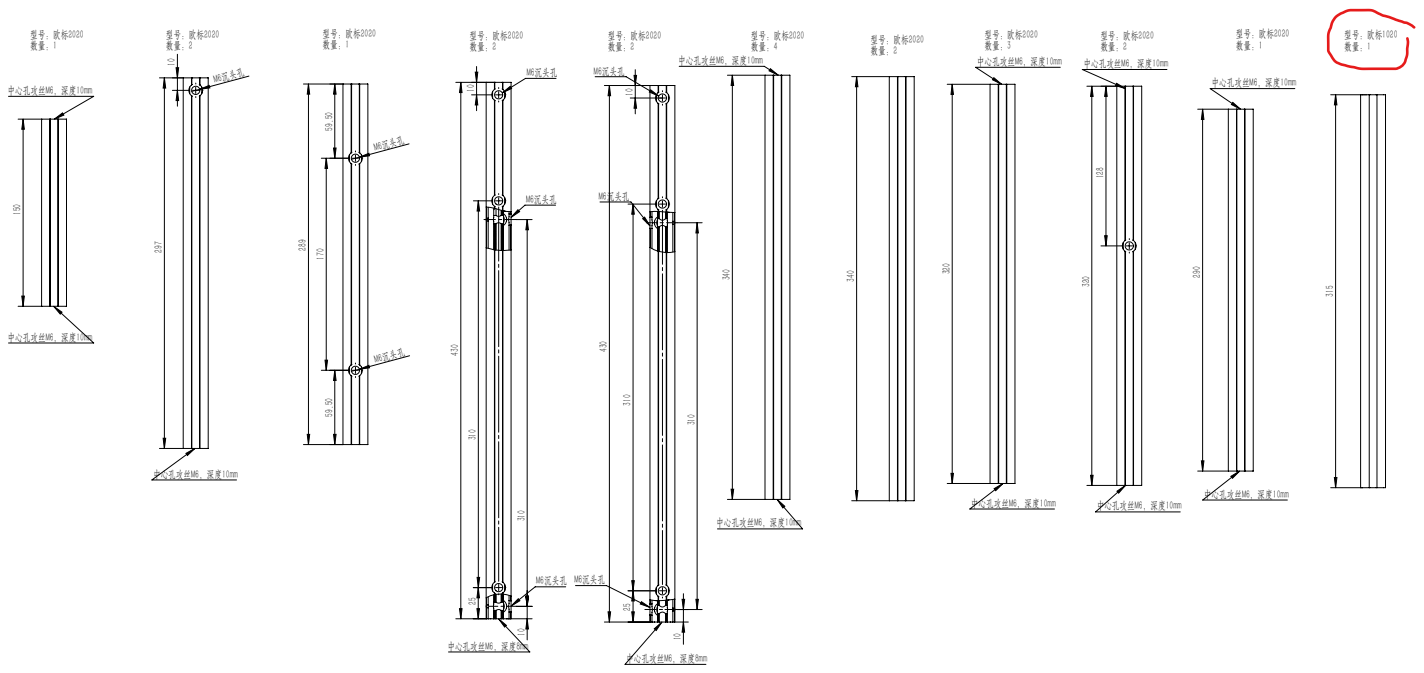
[picture p149: page 1]
