arbaleast/dayu-tt-all-in-one/source/B站【大鱼DIY】3D打印机Dayu TT V1.21全套资料/TT310资料/TT310铝型材图纸/TT310欧标铝型材加工图纸20230812.PDF

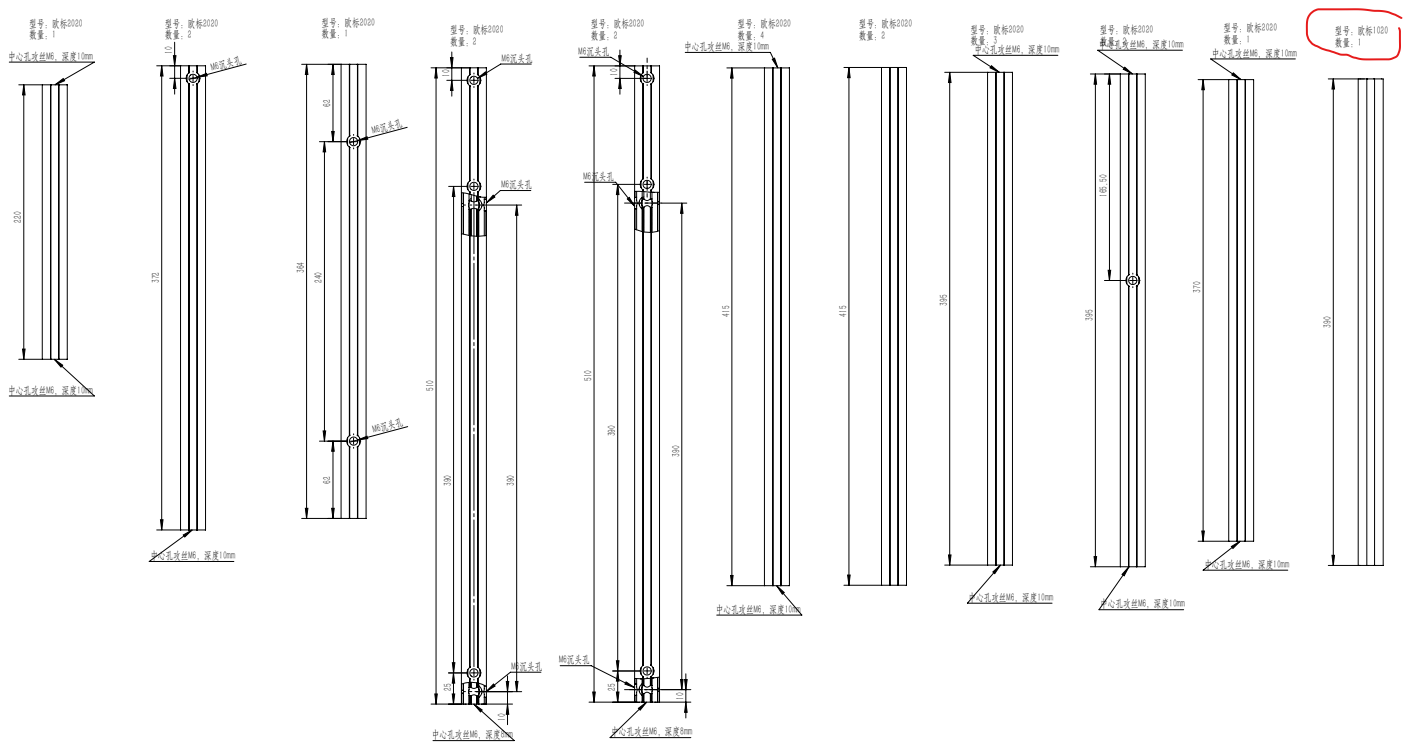
[picture p150: page 1]
