arbaleast/dayu-tt-all-in-one/source/B站【大鱼DIY】3D打印机Dayu TT V1.21全套资料/TT235资料/TT235_CNC零件图纸/TT_E/TT_E_1_V1.2_7个M3螺纹.pdf

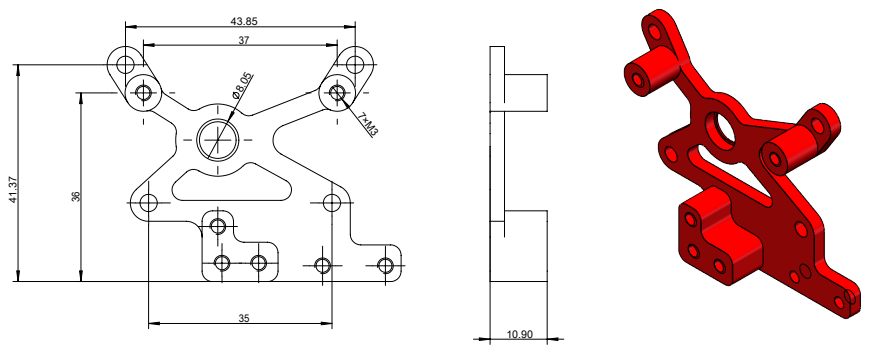
[picture p151: page 1]
