arbaleast/dayu-tt-all-in-one/source/B站【大鱼DIY】3D打印机Dayu TT V1.21全套资料/TT235资料/TT235_CNC零件图纸/TT_X/TT_X_中_2个M2螺纹，2个M3螺纹.PDF

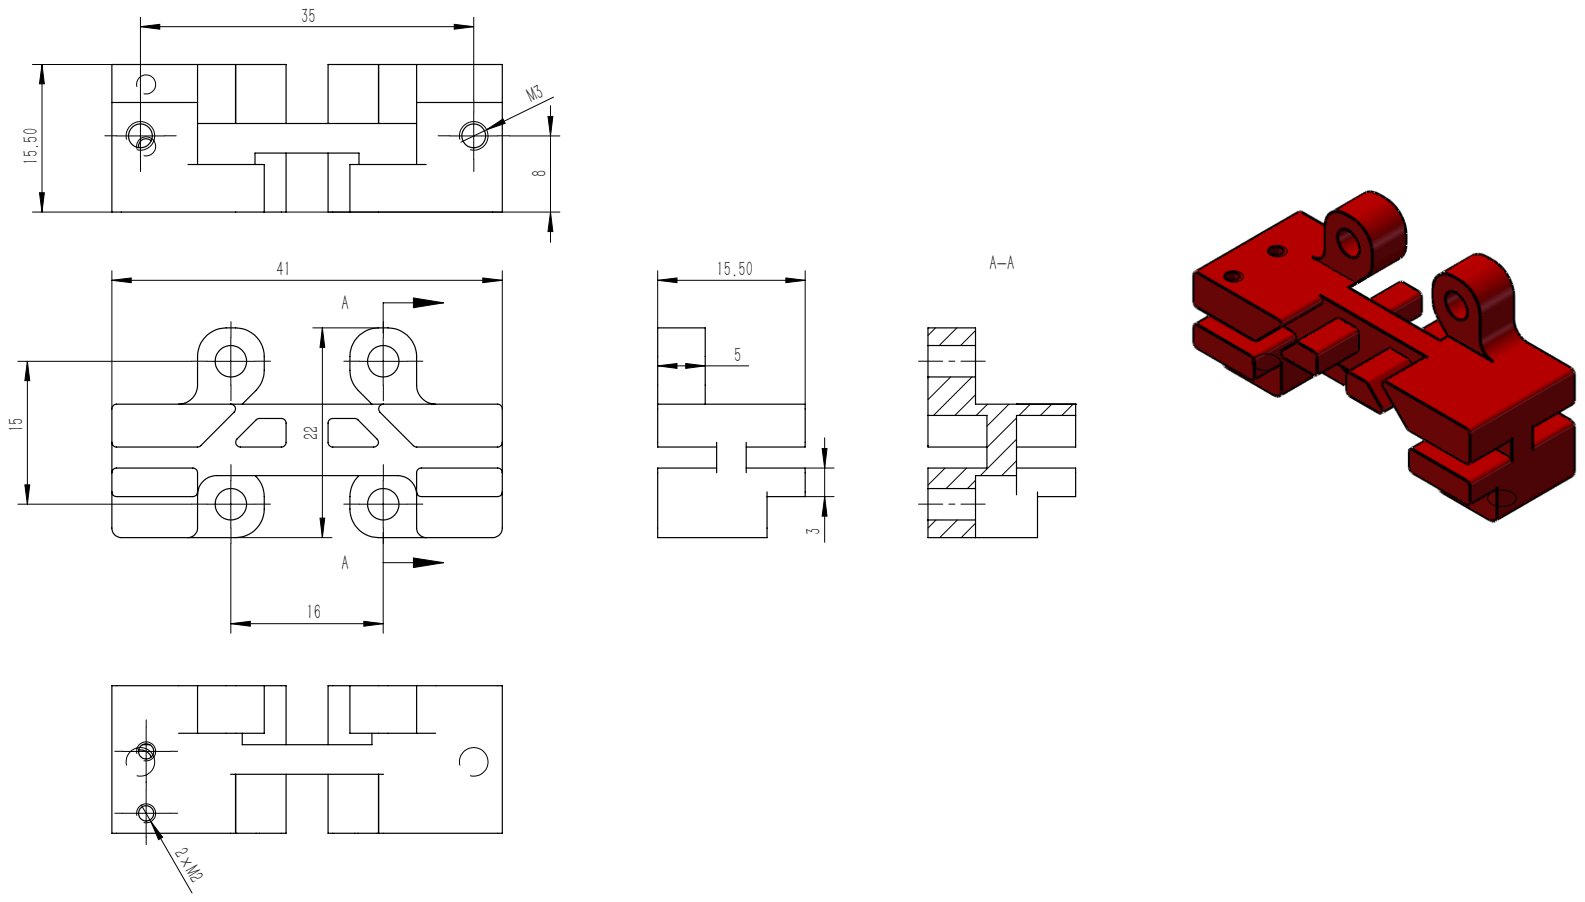
[picture p155: page 1]
