arbaleast/dayu-tt-all-in-one/source/B站【大鱼DIY】3D打印机Dayu TT V1.21全套资料/TT235资料/TT235_CNC零件图纸/TT_X/TT_X_左_2个M4螺纹，1个M3螺纹，沉孔需沉到位.PDF

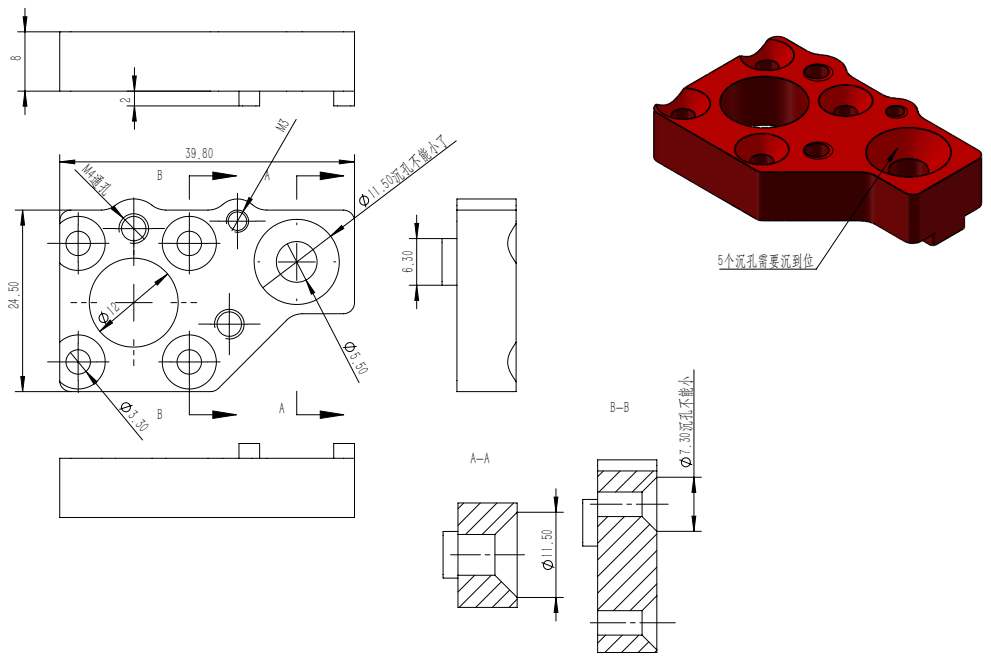
[picture p156: page 1]
