arbaleast/dayu-tt-all-in-one/source/B站【大鱼DIY】3D打印机Dayu TT V1.21全套资料/TT310资料/TT310_CNC零件图纸/TT_Z/TT_Z_左.PDF

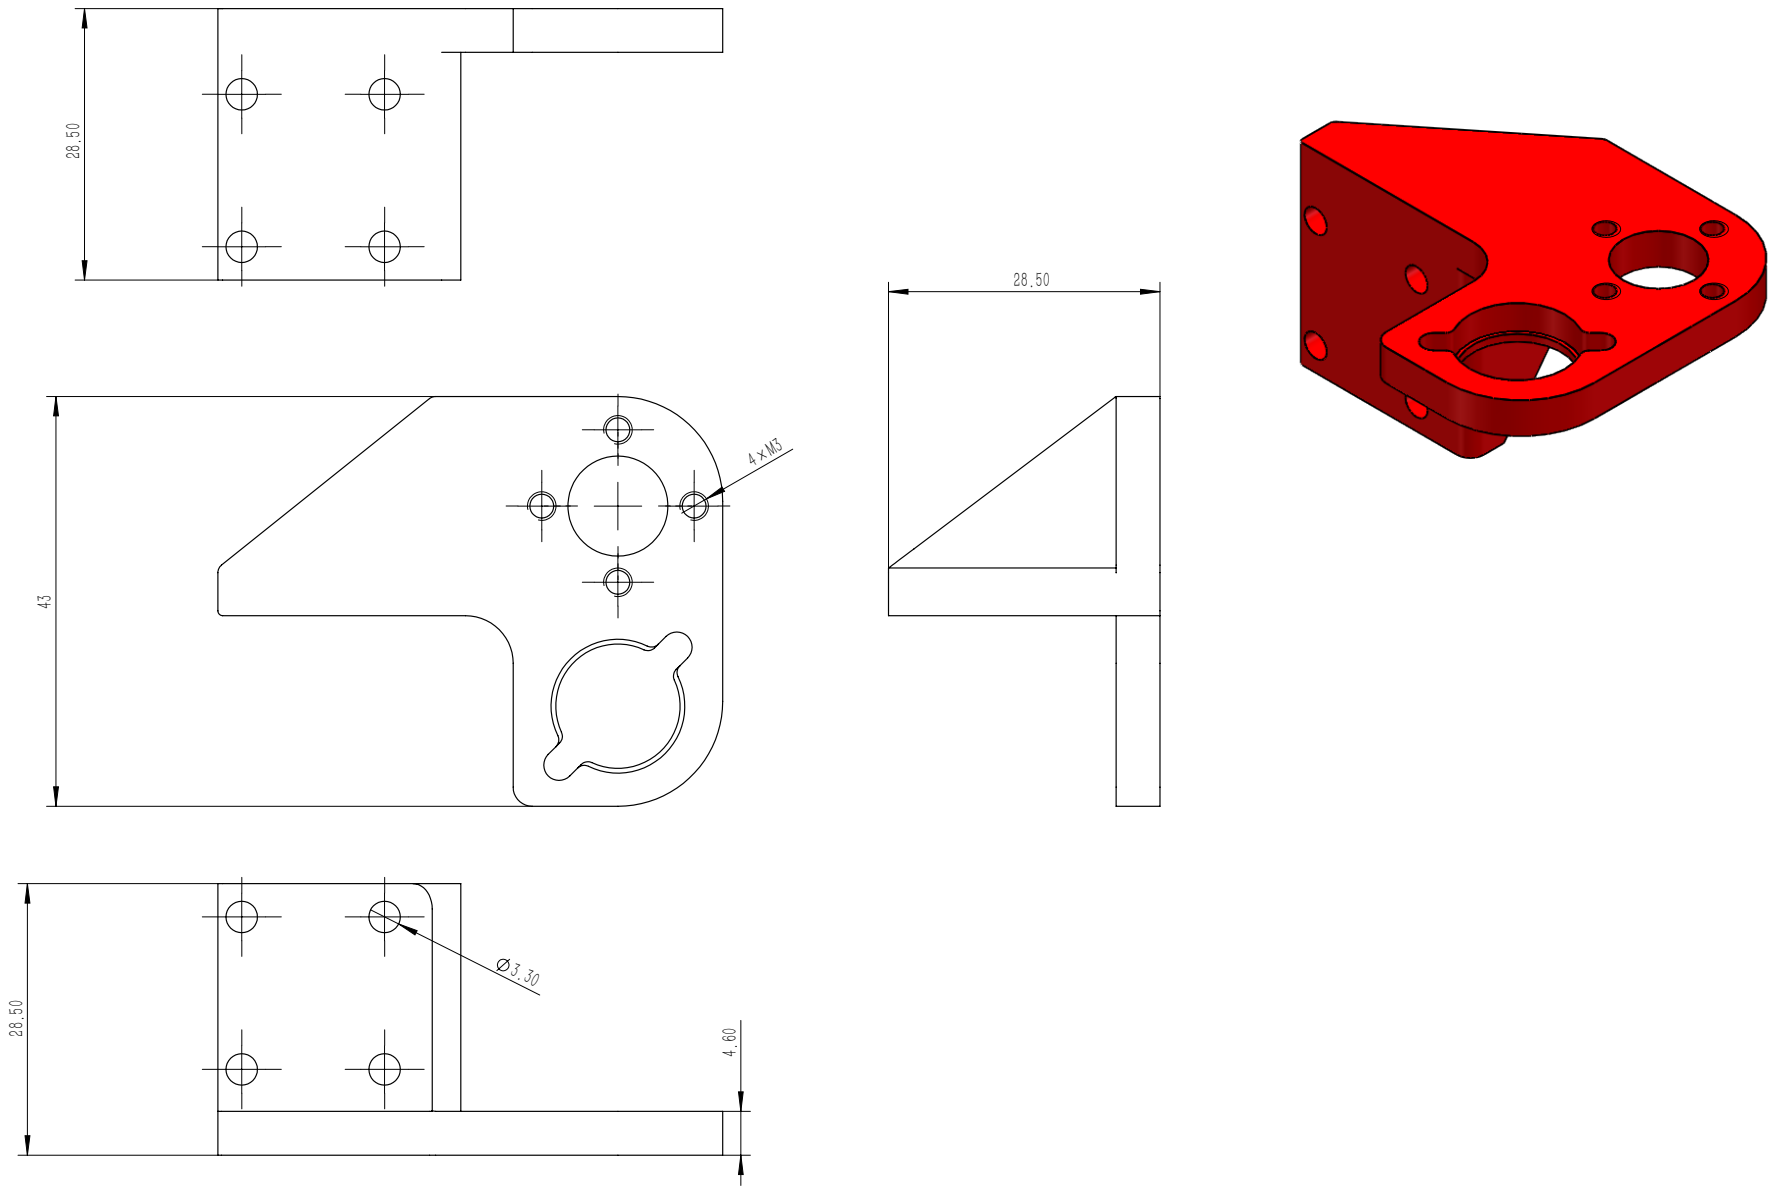
[picture p160: page 1]
