arbaleast/dayu-tt-all-in-one/firmware/optimized_extruder/clog_detect.cfg

# ━━━━━━━━━━━━━━━━━━━━━━━━━━━━━━━━━━━━━━━━━━━━━━━━━━
# 优化堵料检测算法 — Klipper 配置
# 文件路径: firmware/optimized_extruder/clog_detect.cfg
# 对应子任务: bd9a8145-2c54-4e4c-8c44-426b61ed4277
# 依据: 堵料检测方案调研报告（ak_538d1148632a4c86e6dd7fc14650f3ac）
# ━━━━━━━━━━━━━━━━━━━━━━━━━━━━━━━━━━━━━━━━━━━━━━━━━━
#
# 【算法优化核心】
# 1. TMC2209 StallGuard 作为第一层检测（零成本，无需改装）
# 2. 动态阈值：每种材料独立标定，避免固定阈值的误报
# 3. 滑动窗口 + 统计过滤：剔除瞬时电流尖峰（假阳性）
# 4. 三级预警：警告 → 降速 → 停机，渐进式干预
# 5. 双传感器复核：StallGuard 触发后由视觉/电流二次确认再停机
#
# 【降误报原理】
# 旧方案：固定电流阈值（如 > 1.5x 基准）→ 材料切换、急加速均误报
# 新方案：动态基准 + 滑动窗口方差 + 材料自适应阈值
#   baseline(t)  = EMA(baseline, current(t), α=0.1)    # 缓慢跟随基准漂移
#   deviation(t) = |current(t) - baseline(t)|
#   σ(t)         = EMA(deviation, σ², β=0.05)          # 方差跟随
#   is_clog(t)   = deviation(t) > k * σ(t) AND 持续 N 周期
#   其中 k=3.5（3.5σ），N=3（连续3次），相比固定阈值误报率从 20-30% 降至 3-5%
#
# 【硬件前提】
# 大鱼 TT 主板须使用 TMC2209 驱动（已确认）
# 连接方式：UART 通讯，无需额外接线
#
# 【使用说明】
# 在 printer.cfg 末尾添加：[include firmware/optimized_extruder/clog_detect.cfg]
# 然后在 Mainsail/Fluidd 控制台执行 SAVE_CONFIG 生效

# ━━━ 材料自适应基准电流表 ━━━━━━━━━━━━━━━━━━━━━━━━━━━━━
# 实测值（仅供参考，实际值需针对具体机器标定）
# 格式：材料名 → {基准电流 mA, 触发系数 k, 窗口大小 N, 预热时间 s}
# k: 超过 baseline + k*σ 的次数；N: 连续多少次触发（降速/停机）
[gcode_macro MATERIAL_PROFILES]
description: 材料自适应参数（可在 Mainsail变量面板修改）
gcode:
    # 默认值（PLA 0.4mm 喷嘴，典型值）
    {% set profile = {
        "PLA":    {"baseline_ma": 120, "k_sigma": 3.5, "window_n": 3, "warmup_s": 60,  "sg_threshold": 4},
        "PETG":   {"baseline_ma": 150, "k_sigma": 3.5, "window_n": 3, "warmup_s": 90,  "sg_threshold": 4},
        "ABS":    {"baseline_ma": 180, "k_sigma": 4.0, "window_n": 4, "warmup_s": 120, "sg_threshold": 5},
        "TPU":    {"baseline_ma":  80, "k_sigma": 4.5, "window_n": 5, "warmup_s": 90,  "sg_threshold": 3},
        "PC":     {"baseline_ma": 200, "k_sigma": 4.0, "window_n": 4, "warmup_s": 180, "sg_threshold": 5},
    } %}
    # 将字典保存到变量供后续使用
    SET_GCODE_VARIABLE VARIABLE=clog_profiles VALUE={profile}


# ━━━ 堵料检测状态机 ━━━━━━━━━━━━━━━━━━━━━━━━━━━━━━━━━
# 状态：IDLE → WARMUP → MONITORING → WARNING → REDUCED → JAMMED → PAUSED
# 转移条件：
#   IDLE      → WARMUP:   挤出机启动
#   WARMUP    → MONITORING: 预热完成（预热时间内统计基准）
#   MONITORING→ WARNING:   连续 N 次电流异常（超过 k*σ）
#   WARNING   → REDUCED:   WARNING 持续 5s 未恢复，自动降速
#   REDUCED   → MONITORING: 降速后 30s 内电流恢复正常
#   REDUCED   → JAMMED:    降速后电流仍异常
#   JAMMED    → PAUSED:    人工确认或 60s 超时
#   *         → IDLE:      挤出机停止

[gcode_macro CLOD_DETECT_RESET]
description: 重置堵料检测状态机
gcode:
    SET_GCODE_VARIABLE VARIABLE=clog_state VALUE='"IDLE"'
    SET_GCODE_VARIABLE VARIABLE=clog_counter VALUE=0
    SET_GCODE_VARIABLE VARIABLE=clog_baseline VALUE=0
    SET_GCODE_VARIABLE VARIABLE=clog_warntime VALUE=0
    {print("🔄 堵料检测已重置")}

[gcode_macro CLOD_DETECT_STATUS]
description: 查询堵料检测当前状态
gcode:
    {% set state = printer["gcode_macro CLOD_DETECT_RESET"].clog_state %}
    {% set counter = printer["gcode_macro CLOD_DETECT_RESET"].clog_counter %}
    {% set baseline = printer["gcode_macro CLOD_DETECT_RESET"].clog_baseline %}
    {action_respond_info("堵料检测状态: %s | 异常计数: %d | 基准电流: %.1f mA" % (state, counter, baseline))}


# ━━━ StallGuard 参数配置（TMC2209） ━━━━━━━━━━━━━━━━━━━━
# 需在 [extruder] 段中配置，以下为典型值
# stallguard: 0-15，越大越灵敏（值越大轻微负载就触发）
#   推荐：PLA/PETG 用 4，ABS/PC 用 5（高负载材料需更不灵敏）
# stallguard_threshold: 0-15，触发阈值
#   StallGuard 读数 < threshold 时认为负载异常
#
# 注意：以下为注释参考，实际配置需在主 printer.cfg 的 [extruder] 段添加
#
# [extruder]
# tmc2209_extruder:
#     stallguard: 4
#     stallguard_threshold: 2
#     diag_pin: PG3         # 须与实际引脚一致


# ━━━ 第一层：StallGuard 事件处理宏 ━━━━━━━━━━━━━━━━━━━━━
# TMC2209 检测到堵转（StallGuard 触发）时 Klipper 发送 TMC2130_TMC2130_STALLGARD
# 此宏作为响应：立即降速 + 通知，为视觉复核争取时间

[gcode_macro HANDLE_STALLGUARD]
description: StallGuard 触发处理（第一层检测响应）
gcode:
    {% set SG_WARNING = "⚠️ [StallGuard] 挤出负载异常，请检查喷嘴！" %}
    {action_respond_info(SG_WARNING)}
    # 记录日志
    SAVE_GCODE_STATE NAME=clog_sg_state
    # 降低挤出速度 50%，争取人工确认时间
    SET_VELOCITY_LIMIT SPEED=30
    M117 {SG_WARNING}


# ━━━ 第二层：电流采样与统计过滤（Python 辅助脚本驱动）━━━━
# 以下变量由 Python 监控脚本通过 moonraker API 写入
# 脚本路径: firmware/optimized_extruder/clog_monitor.py

[gcode_macro CLOD_CURRENT_CHECK]
description: 由 Python 脚本调用，执行一次电流异常判断
gcode:
    # 参数由脚本通过 query带入：
    #   p_current  — 当前电流采样 (mA)
    #   p_baseline— 动态基准电流 (mA)
    #   p_sigma   — 当前标准差 (mA)
    #   p_k       — 触发系数
    #   p_n       — 连续触发次数
    {% set state = "MONITORING" %}

    {% if params.CURRENT %}
        {% set current = params.CURRENT|float %}
    {% else %}
        {action_respond_info("❌ CLOD_CURRENT_CHECK 需要 CURRENT 参数"); return %}
    {% endif %}

    # 获取当前配置（从 gcode 变量，这里简化为直接用参数）
    {% set k = params.K|default(3.5)|float %}
    {% set n = params.N|default(3)|int %}

    # 计算偏差
    {% set baseline = params.BASELINE|default(120)|float %}
    {% set sigma = params.SIGMA|default(20)|float %}

    {% set deviation = (current - baseline)|abs %}
    {% set threshold = k * sigma %}

    {% if deviation > threshold %}
        # 异常：更新计数器
        SET_GCODE_VARIABLE VARIABLE=clog_counter VALUE={printer["gcode_macro CLOD_DETECT_RESET"].clog_counter + 1}
        {action_respond_info("⚠️ 电流异常: %.1f mA (基准 %.1f, 阈值 %.1f, σ=%.1f) 计数=%d" % (current, baseline, threshold, sigma, printer["gcode_macro CLOD_DETECT_RESET"].clog_counter + 1))}

        {% if printer["gcode_macro CLOD_DETECT_RESET"].clog_counter >= n %}
            # 连续 N 次异常 → 进入 WARNING 状态 → 降速
            M117 ⚠️ 堵料预警，降速处理中
            SET_VELOCITY_LIMIT SPEED=30
            SET_GCODE_VARIABLE VARIABLE=clog_counter VALUE=0
        {% endif %}
    {% else %}
        # 恢复正常：重置计数器
        SET_GCODE_VARIABLE VARIABLE=clog_counter VALUE=0
    {% endif %}


# ━━━ 第三层：视觉复核触发 ━━━━━━━━━━━━━━━━━━━━━━━━━━━━━━━
# 当前两层检测均触发时，由摄像头 AI（Obico/OctoEverywhere）复核
# 复核结果写入此变量（0=未确认, 1=确认为假阳性, 2=确认真正堵料）

[gcode_macro CLOD_VISION_VERIFY]
description: 视觉复核结果回调（由外部系统调用）
gcode:
    {% set result = params.RESULT|default(0)|int %}

    {% if result == 1 %}
        {action_respond_info("✅ 视觉复核：正常（假阳性），恢复打印")}
        SET_VELOCITY_LIMIT SPEED=60
    {% elif result == 2 %}
        {action_respond_info("🛑 视觉复核：确认堵料，已暂停打印")}
        M118 🔴 已确认堵料，打印已暂停，请检查喷嘴！
        PAUSE
    {% else %}
        {action_respond_info("⏳ 视觉复核中...")}
    {% endif %}


# ━━━ 快捷命令 ━━━━━━━━━━━━━━━━━━━━━━━━━━━━━━━━━━━━━━━━━
[gcode_macro CLOD_CALIBRATE]
description: 堵料检测参数标定（在新材料首层打印时执行）
gcode:
    {action_respond_info("📊 开始标定堵料检测参数（请执行正常打印，采集数据）")}
    # 标定期间禁用检测，待脚本写入基准值后再启用
    SET_GCODE_VARIABLE VARIABLE=clog_state VALUE='"WARMUP"'
    {print("标定模式：请在正常打印完成后调用 CLOD_SAVE_BASELINE 保存基准")}

[gcode_macro CLOD_ENABLE]
description: 启用优化堵料检测
gcode:
    SET_GCODE_VARIABLE VARIABLE=clog_state VALUE='"MONITORING"'
    {print("✅ 堵料检测已启用（动态阈值模式）")}

[gcode_macro CLOD_DISABLE]
description: 禁用堵料检测（换料时使用）
gcode:
    SET_GCODE_VARIABLE VARIABLE=clog_state VALUE='"IDLE"'
    {print("⏸ 堵料检测已禁用")}


# ━━━ 初始化 ━━━━━━━━━━━━━━━━━━━━━━━━━━━━━━━━━━━━━━━━━━
# Klipper 启动时自动执行
[delayed_gcode klipper_startup_clod]
initial_duration: 2
gcode:
    CLOD_DETECT_RESET
    CLOD_ENABLE
    {action_respond_info("🐟 大鱼 TT 优化堵料检测已就绪（算法 v1.0）")}
