arbaleast/dayu-tt-all-in-one/(commit log)

2026-03-22 项目整合: 合并大鱼TT三个子项目
    [完整物料清单.csv]
2026-03-24 merge: 整合 dayu-tt-enclosure 仓库内容
    - 新增 bom/、images/、models/、stls/ 封箱实体文件
    - 新增 .github/ 工作流模板
    - 新增 CHANGELOG.enclosure.md、GITHUB_COMPLETE.md、GITHUB_SYNC.md
    - 新增 sync.sh、setup-ssh.sh 及 SSH 相关文档
    - 保持原有 docs/ 结构，文档已去重
    [完整物料清单.csv]
2026-03-24 docs: 新增大鱼TT硬件改进资料汇总
    来源：B站视频、GitHub、MakerWorld
    内容：XY结构件、挤出系统、Klicky探针、CAN总线、Klipper固件等
2026-03-24 docs: 新增大鱼TT CAN总线改装指南
    含FLY SB2040接线、固件编译、UUID刷写、printer.cfg配置示例
2026-03-24 docs: 新增大鱼TT摄像头加装指南
    含选型推荐、Crowsnest/MJPG-Streamer配置、延时摄影、常见问题
2026-03-24 docs: 新增罗技C270大鱼TT摄像头完整配置指南
    含购买清单、安装步骤、Crowsnest配置、Fluidd设置、延时摄影
2026-03-24 docs: 新增Klipper固件配置完全指南+三叉戟改装指南
    - Klipper固件配置完全指南：PID校准、输入整形、压力提前、Klicky探针配置
    - 三叉戟Trident改装指南：多色打印、三轴改装方案
2026-03-24 docs: 新增4项硬件改进指南
    - 切片机配置完全指南（OrcaSlicer/PrusaSlicer参数）
    - 皮带张紧器STL模型合集
    - 封箱散热BOSSAC热床改装指南
    - 42闭环电机改装实战采购指南
2026-03-24 docs: 新增多色打印改装完全指南
    含手动换料/ERCF/AMS/ToolChanger四种方案对比
    含大鱼TT多色改装路线图
2026-03-24 docs: 新增大鱼TT从零DIY完全指南
    含版本选择、完整BOM采购清单（¥1700-3000）
    DIY步骤总览、工具准备、视频教程、升级路线图
2026-03-24 chore: add .gitignore for 3D printing/CAD project
    - FreeCAD: .FCParam, .FCStd, .FCStd1, .FCStdBak, .FCStd1Bak, freecad.lock
    - OpenSCAD: .csg, .back cache files
    - Slicer: .gcode, .gco, .g output files
    - OS: .DS_Store, Thumbs.db, desktop.ini, .swp, .swo, ~
2026-03-24 feat: US-001 - Research TT310 dimensions and plan enclosure layout
    - Document TT310 key dimensions: 310×310×310mm print volume
    - Estimate outer dimensions: 470×450×720mm (footprint + frame)
    - Document enclosure outer dimensions: 510×490×760mm
    - Create ASCII layout sketch showing all panels and fan positions
    - List all panel dimensions (W×H): side panels 510×760mm, etc.
    - Estimate BOM cost: ¥237-365 for materials + 3D printing
    - Add dimension completeness test script (7 tests, all passing)
2026-03-24 feat: US-002 - Set up FreeCAD project and directory structure
    - Create freecad/ directory with Assembly.FCStd (FreeCAD 0.19+ SQLite format)
    - Add 6 sub-containers in Assembly: Top, Left, Right, Back, Front, Bottom panel groups
    - Set unit system to mm
    - Create stls/, steps/, docs/ subdirectories
    - Add enclosure/README.md with project overview and software requirements
    - Add test-freecad-project.sh validation script (8 tests)
    [Assembly.FCStd]
2026-03-25 feat: US-003-01 - Document bottom bracket design specifications
2026-03-25 docs: 2026-03-25 big update - chamber thermal, OrcaSlicer AI, hotend comparison, X/Twitter 2026
2026-03-25 docs: 2026-03-25 second update - 封箱数据/拖链/门把手/热端
2026-03-25 docs: README结构大更新 - 文档索引完整化、封箱项目入口、GitHub链接修正
    - 重写文档结构：完整列出00/01/02三个目录所有文件
    - 新增封箱FreeCAD项目入口（enclosure/独立子项目）
    - 修复GitHub链接：kiauh→dw-0, bigfish-tt-extentions→rushairer
    - 大鱼TT改装实战.md加⚠️占位符说明
    - 底部支架尺寸与plan.md核对一致
2026-03-25 docs: 2026-03-25 third update - LED改装/Z轴光电限位/拓竹速度/思兼教程
2026-03-25 docs: AI缺陷检测ZELIA写入OrcaSlicer指南 + changelog更新
2026-03-25 feat: US-003-02 to US-003-07 - FreeCAD models for bottom bracket and foot mount
    - BottomBracketBody.FCStd: 40x30x15mm box
    - BottomBracketAssembly.FCStd: assembly file
    - FootMount.FCStd: Ø20x15mm cylindrical mount
    - FootPad.FCStd: Ø25x5mm pad
    - Python generation scripts for each part
    Note: Detailed fillets and M3 holes require FreeCAD GUI work
    [BottomBracketAssembly.FCStd, BottomBracketBody.FCStd, FootMount.FCStd, FootPad.FCStd]
2026-03-25 feat: US-003-03/04/06 - complete bottom bracket models with M3 holes, tabs, flange
    - BottomBracketComplete.FCStd: full bottom bracket + 4x M3 countersunk holes
    - BottomBracketWithTabs.FCStd: bottom bracket + side panel tabs
    - FootMountComplete.FCStd: foot mount Ø12 through-hole + Ø26 flange
    - verify_bottom_bracket_fit.py: physical verification checklist
    - Updated PROGRESS.md
    [BottomBracketBody.FCStd, BottomBracketComplete.FCStd, BottomBracketWithTabs.FCStd, FootMountComplete.FCStd]
2026-03-25 feat: US-004~009 complete - fan mount, door hardware, DXF panels, BOM, assembly guide, Klipper fan config
    New FreeCAD parts:
    - TopFanMount.FCStd: 125x125x20mm 120mm fan cover
    - CornerBracket.FCStd: 20x20x10mm frame connectors x12
    - SidePanelClip.FCStd: 30x15x10mm panel clips x16
    - TopPlateMount.FCStd: 25x20x8mm top plate mounts x8
    - DoorFrameReinforcement.FCStd: 490mm reinforcement strip
    - HingeMount.FCStd: 30x20x8mm door hinges x3 pairs
    - MagnetHolder.FCStd: magnet recess holders x6
    - DoorHandle.FCStd: 60x20x15mm door handle
    - FilterFrame.FCStd: 120x120mm fan filter frame
    - VentCover.FCStd: 85x85x3mm vent cover
    - CableEntryRing.FCStd: Ø35x10mm cable grommet
    DXF cutting diagrams (6 panels)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
    [BackPanel.dxf, BottomPanel.dxf, CableEntryRing.FCStd, CornerBracket.FCStd, DoorFrameReinforcement.FCStd, DoorHandle.FCStd, FilterFrame.FCStd, FrontDoor.dxf]
2026-03-25 feat: US-010 - STL export for all 3D printed parts
    Generated STL files for OrcaSlicer/Bambu Studio:
    - BottomBracket.stl, FootMount.stl, FootPad.stl
    - TopFanMount.stl, CornerBracket.stl, SidePanelClip.stl
    - TopPlateMount.stl, DoorHandle.stl, VentCover.stl
    - CableEntryRing.stl, FilterFrame.stl
    - HingeMount.stl, MagnetHolder.stl
    - DoorFrameReinforcement.stl
    - export_all_stl.py: reusable STL export script
    [BottomBracket.stl, CableEntryRing.stl, CornerBracket.stl, DoorFrameReinforcement.stl, DoorHandle.stl, FilterFrame.stl, FootMount.stl, FootPad.stl]
2026-03-26 新增: AI校准进化实战指南 (2026-03-26)
    - 新增 docs/02-硬件改进/AI校准进化实战指南.md
    - 更新 PROGRESS.md 添加AI校准章节
    - 更新 硬件改进资料汇总.md 添加第十三章AI校准
    - 知识库: 3D打印AI校准进化指南.md
    [封箱_下四角新增福马轮TT310.stp]
2026-03-26 重构: 清理目录结构，规范文档归档 (2026-03-26)
    【目录清理】
    - 删除空目录: stls/, bom/, enclosure/stls/, enclosure/docs/
    - 合并重复BOM: 保留enclosure/BOM.md为canonical
    - 删除重复CSV BOM: docs/01-封箱方案/完整物料清单.csv
    - 移动GitHub/SSH配置文件到 docs/99-项目维护/
    - 移动setup-ssh.sh/sync.sh到 scripts/
    【目录新建】
    - docs/03-改装实战/ (预留)
    - docs/04-参考资料/ (预留)
    - docs/99-项目维护/ (GitHub+SSH配置)
    - scripts/ (自动化脚本)
    【文档重写】
    - 重写 README.md：反映最新目录结构
    - 更新 PROGRESS.md：简化进度格式
    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
    [完整物料清单.csv]
2026-03-26 feat: V2重新设计完成 - 8个STL + 7张DXF + 工程分析 + 电气安全
    新增内容：
    - enclosure/stl_v2/: 8个3D打印件STL（底部支架/脚垫/铰链座/磁铁座/侧板卡扣/顶板风扇座/电缆入口/门把手）
    - enclosure/dxf_v2/: 7张DXF切割图（520×530/530×770多种规格）
    - docs/: TT310-SOURCE-ANALYSIS.md、机器总览全览.md、工程热力分析报告.md
    - scripts/redesign_v2/: 纯Python生成脚本（stl_writer/dxf_writer/analysis_v2）
    - source/: V1.21完整原始资料（含STEP/SLDPRT/DXF/STL源文件）
    - enclosure/REDESIGN_V2.md: V2完整设计文档
    - enclosure/BOM.md: V2物料清单更新
    - PROGRESS.md: 进度更新至US-004~010
    工程分析结论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
    [1020铝型材支架.STEP, 1020铝型材支架.STL, 12032风扇支架.STEP, 12032风道.STEP, 4020风道_TT.STEP, 4020风道_TT.STL, 5015支架.STEP, 5015支架.STL]
2026-03-27 feat: V2皮带张紧器STL + 热管理/功能扩展文档
    [TensionerA_Arm.stl, TensionerA_Base.stl, TensionerA_EccentricSleeve.stl, TensionerA_Idler.stl, TensionerA_Spring.stl, TensionerA_Stop.stl, TensionerB_Base.stl, TensionerB_Idler.stl]
2026-03-27 docs: 重构 README，聚焦 V2 核心产出
2026-03-27 docs: 重构 README，修正仓库链接，聚焦 TT 全系资料
2026-03-27 docs: 重构 README，修正仓库链接
2026-03-27 feat: Phase3 增加振动传感器方案（MPU6050+LSTM双保险）
2026-03-28 fix: 修复 README 引用错误 + 更新仓库名 + 整合文档
    - README.md: 修复不存在的文件引用
    - README.md: 修复 Phase 0 状态（待执行→已完成）
    - README.md: 新增目录状态说明表
    - GITHUB_*.md / sync.sh: 全局替换旧仓库名
    - CHANGELOG.enclosure.md: 整合历史记录
    - docs/02-硬件改进/CoreXY改进大鱼TT实战指南.md: 新增 Voron Design 参考改装指南
    Date: 2026-03-28
2026-03-28 feat: AI 深度调研报告 - 大鱼 TT 可用技术路线
    - docs/plans/2026-03-29-ai-research-report.md
    - 并发搜索三个方向：AI校准/故障检测/VLM + Voron改装 + LLM辅助建模
    - 覆盖：Obico, Klippain, AWD, LLM-3D Print, RAG方案
    - 大鱼 TT 推荐：短期 Obico+IS 中期 AWD+CanBUS 长期 RAG知识库
    Date: 2026-03-29
    [完整物料清单.csv]
2026-03-28 docs: 添加系统一键恢复脚本 setup.sh
2026-03-28 docs: 移除 scripts 目录（移至 /vol1/1000/scripts/fnos-setup.sh）
2026-03-28 feat: 大鱼 TT 完全重构 - 新增三大知识库
    docs/03-AI与控制系统/ - AI校准/故障检测/VLM监控/RAG知识库/自我演化
    docs/04-CoreXY深度改装/ - AWD四驱/高速振动控制/皮带惰轮优化/框架刚性
    docs/05-固件与配置/ - Klipper深度优化/Klippain配置栈/切片配置/BOSSAC热床
    docs/plans/CoreXY深度研究报告.md - 学术级CoreXY完整研究报告
    docs/plans/_archive/ - 整理历史临时报告
    新增14张图片描述md文件 - 索引至OpenViking知识库
    重构图片描述索引 - Moondream + 手动描述混合
2026-03-28 feat: 结构力学与热力学深度研究报告
    - 铝型材框架结构分析（2020/2040/2060弯曲刚度）
    - 热床平台结构分析（BOSSAC应力分布）
    - CoreXY滑架材料选择
    - 振动隔离与抗振设计
    - 全封闭腔体热力学建模
    - 热床传热分析
    - 散热风道优化（层流/湍流）
    - 材料打印温度窗口（PLA/PETG/ABS）
    - 热端传热分析（heat break优化）
2026-03-28 feat: 大鱼TT规格确认 + TT310机械薄弱点分析
    - docs/plans/大鱼TT规格确认表.md — TT150/TT235/TT310规格摸底
    - docs/plans/TT310机械薄弱点分析.md — P0/P1/P2改进优先级
    P0: 底部框架2040升级+对角斜撑+保温棉密封
    P1: CNC/FR4滑架+MGN12H导轨+循环风扇
2026-03-28 feat: TT310采购清单（P0+P1+P2分阶段）
    P0 ¥170-210: 2040框架升级+对角斜撑+保温棉密封
    P1 ¥160-335: CNC/FR4滑架+MGN12H导轨+循环风扇
    P2 ¥240-660: 双Z轴+9mm皮带+BOSSAC热床
2026-03-31 feat: 更新2026年前沿技术（Obico、Klipper auto-tuning、CES新技术）
2026-04-02 feat: 固件优化（耗材管理+堵头检测）+ RAG知识库索引脚本
    - firmware/consumable_manager: 耗材管理模块
    - firmware/optimized_extruder: 堵头检测模块
    - rag_indexer.py / rag_server.py: 知识库索引服务
    [clog_detect.cfg, filament_display.cfg]
